kingofamani/CoinSorting/README.md

# 智能自動分幣機（教師研習創客專案）

雷切機構分幣機：TT 馬達帶轉盤，把 1、5、10、50 元硬幣送上斜坡，依直徑落進 4 個抽屜。
目標是加上感測器自動計算總金額，用七段顯示器顯示。

**開新對話先看：** [`分幣機_交接_2026-10-08.md`](分幣機_交接_2026-10-08.md) 和 [`分幣機_專案完整紀錄v2.txt`](分幣機_專案完整紀錄v2.txt)（第五節最新）。

## 資料夾

| 資料夾 | 是什麼 | 狀態 |
|---|---|---|
| [`01_原始機構/`](01_原始機構/) | 原本的純機構分幣機：雷切原始檔、零件編號圖、組裝完成照片 | 基準，**不可修改** |
| [`02_v1_紅外線版/`](02_v1_紅外線版/) | 第一代：4 路反射式紅外線感測。Nano 版與 ESP32 版程式、接線圖、講師前置測試步驟、v1 紀錄 | **已停用**（反射式紅外線不準） |
| [`03_v2_光耦版/`](03_v2_光耦版/) | 第二代：槽型光耦（遮斷式）。v2 雷切產生器 `laser_v2/`、草稿與試切小樣、設計規格、報告；ESP32 正式程式 `coin_sorter_opto_esp32/`、接線圖 `接線圖/`、組裝教學網頁 `組裝教學/index.html` | **目前主線** |
| [`04_光耦測試原型/`](04_光耦測試原型/) | 一段簡單滑坡＋裝一個光耦的位置，驗證「光耦跨裝在滑坡上是否可行」；附 ESP32 測試程式、接線圖 `接線圖/`、講師組裝教學網頁 `組裝教學/index.html` | 等模組買到、實量後再切 |

## 現在要切哪個檔

- **v2 整台**：`03_v2_光耦版/laser_v2/out/sheet_合板_1～3.svg`、`sheet_壓克力_1.svg`（上機用，不含註記）。
- **v2 試切小樣**：`03_v2_光耦版/laser_v2/out/trial_合板_1.svg`。
- **光耦測試原型**：`04_光耦測試原型/光耦測試原型_雷切.svg`。

雷切設定：黑 0.2 mm 線＝切割；紅 0.2 mm 線＝雕刻（紅色圖層設「線／向量雕刻」，不要用填色／掃描）。
`03_v2_光耦版/` 裡的 `分幣機雷切_光耦版_v2_草稿.svg`、`_試切小樣.svg` 含隱藏註記層，是給人看的，不要直接上機。

## 怎麼重新產生

Python 環境在根目錄的 `.venv`（不在 git 裡；已裝 shapely、numpy、scipy、matplotlib、fonttools、svgpathtools）。

```
cd 03_v2_光耦版
../.venv/Scripts/python.exe -B -m laser_v2.build_v2
```

```
.venv/Scripts/python.exe -B 04_光耦測試原型/make_proto.py
```

- v2：光耦模組、TM1637、擴展板實量後只改 `03_v2_光耦版/laser_v2/params.py`，量什麼、改哪個鍵見 `laser_v2/out/report.md` 第四節。
- 測試原型：模組實量後改 `make_proto.py` 開頭的 `MODULE`，見 `04_光耦測試原型/組裝與測試說明.md` 第 2 節。
- 字型：雕刻文字與預覽圖用微軟正黑體（`C:\Windows\Fonts\msjh.ttc`）。
- 各檔用途、結束碼、自我測試：見 `03_v2_光耦版/laser_v2/INTERFACE.md` 與專案紀錄第五節。

## 硬體（v2）

- 主控：ESP32-WROOM-32＋38P 擴展板（黃色跳帽設 3.3V）；顯示：TM1637 四位數七段。
- 感測：槽型 LM393 光耦模組（槽寬 10 mm）×4：S1 在 1 元滑道內，S5／S10／S50 跨在斜坡間隔條。
- 電源：9V 方形電池供電子部分；1 顆 18650 獨立驅動 TT 馬達。
- 計數公式：N1＝C1、N5＝C5−C10、N10＝C10−C50、N50＝C50。
- 程式：`03_v2_光耦版/coin_sorter_opto_esp32/`（接線、燒錄、研習前檢查見同資料夾 README.md；還沒在實機編譯、執行過）。
- 接線圖：`03_v2_光耦版/接線圖/分幣機_v2光耦版_ESP32_接線圖.png`（.svg 由同資料夾 make_wiring.py 產生）。
