kingofamani/CoinSorting/03_v2_光耦版/laser_v2/design/analysis_round1.md

# 分析：chute
## findings
- 【審查結論摘要】我重新跑了 parts.pkl 的零件座標，也重看了正面照和俯視照。座標對位、整機姿態、硬幣流向、隔板身分、#12/#13 的用途這幾條都驗證成立。需要修正的有 7 處：(1) 使用者對「1 元滑道右牆」那題其實已經回答「空間夠，可以放 S1」，原分析誤當成待量測；(2) U69.2–72.1 那片牆是 TT 馬達盒的右壁，不是電池盒；(3) 原文寫「隔板從 #26 頂 V14.1」不對，#26 頂在 V4，V14.1 是隔板頂；(4) 軌道坡度 20° 是在面板平面內量的，換算成實際對水平約 17.2°；(5) #13 上緣的幾何改用實際頂邊重新描述；(6) S1 用槽型模組伸進 1 元滑道的卡幣風險從「可能」升級為「很可能」，並補上兩個替代方案；(7) 『切割補償會讓開口變小』的方向寫反了。另外新增兩項遺漏：#24 斜槽內有一條多餘的切割線；跨軌光束離前一個開口只有約 3mm，違反紀錄 3-2 自己訂的 ≥10mm 原則。
- 【座標系（後面所有數字都用這套，已驗證）】以 #24 的零件局部座標為主。U＝#24 局部 y（0＝右端轉盤側，246＝左端）；V＝#24 局部 x（0＝面板頂，114＝底，沿傾斜面板量）；W'＝深度（#26 背面＝0，#37 內面≈28.8）。換算方式：#26 局部 (x,y)＝(V−4, U−40)；#37 局部 (x,y)＝(114−V, U)，在 SVG 裡是鏡像；隔板 #5/#6/#7 局部 x＝6+W'、y＝V−14.1。隔板頂在 V14.1；#26 頂在 V4（U≤105.7 處），往左逐漸降到 V14（U≥133）。驗證：#26 圓孔中心 (V≈50,U58) 和 #24 軸孔 Ø20 中心 (V50,U58) 重合；三片隔板的小榫與長榫（V84.5–92.5）逐一對上 #26/#24 的槽；後凸榫（V40.1–56.1）對上 #37 的槽（V40.3–56.2）。
- 【整機姿態（已驗證）】#31/#36（92.9×155.3）是左右端板兼腳架，不是斜坡。上段寬 42，有 2 排×5 個槽，接 #24 與 #37；兩排槽中心距 34.7，等於 #26 的 3mm 加滑道深 28.8。兩個腳勾槽的連線和端板軸線夾 29.9°，代表機身上段往後仰 30°，面板與水平夾 60°。
- 【硬幣流向（已驗證）】轉盤把硬幣送進 #24 的長斜槽。槽寬 30.0（垂直量 30.0），在面板內的坡度 20.0°，因機身後仰，實際對水平約 17.2°。斜槽下緣就是軌道，從 (V37.5,U75.7) 到 (V95.1,U234)。硬幣立在 3mm 厚的斜槽裡、靠著 #26 滾。#26 四個開口的下緣都比軌道高 1.31mm；開口頂端（中段）離軌道 20.4／22.3／26.0–26.1／30.0mm，依序是 1／5／10／50 元，對應硬幣直徑 20／22／26／28，餘量 +0.4／+0.3／0／+2.0（開口兩端是圓角，會再小一點）。開口夠高時，硬幣往後翻過 #26，掉進深約 29mm 的滑道，再直接落進下方抽屜。開口 U 範圍：1 元 114.1–134.6、5 元 140.55–164.15、10 元 170.19–196.64、50 元 203.05–234.0。開口左右邊是沿 V 方向，不是垂直軌道。
- 【滑道間隔條＝#5/#6/#7（已驗證）】三片外形 38×84，實體 29（W'）×84（V14.1→V98.1）。#7 是 1|5 間隔條，在 U135.9–138.8；#6 是 5|10，在 U165.7–168.6；#5 是 10|50，在 U198.4–201.3。三片只差在前緣小榫的位置；前長榫 6×8 三片都一樣，都插在 V84.5–92.5。斜底邊 (6,84)→(35,68) 換算到實際空間幾乎水平（33.1mm 只降 0.6mm），也就是滑道出口平面：貼 #26 處 V98.1，貼 #37 處 V82。
- 【滑道寬（U 方向淨寬，已驗證）】1 元 107.8→135.9＝28.1；5 元 138.8→165.7＝26.9；10 元 168.6→198.4＝29.8；50 元 201.3→236.2＝34.9。上段沒有櫃側板，最寬可到 #36 內面 U243（41.7）。
- 【#13/#21 是抽屜櫃左右側板（已驗證）】#21 就是 #13 轉 180°，兩片完全同形，換算 (x,y)→(84.3−x, 52.2−y) 外形與孔都吻合。#13 的 3 個槽（5.9/9.9/9.9，起點間距 15、20）對到 #12 短邊的榫（6/10/10，間距 15、20）。#12（134×61）是抽屜櫃後板，內淨寬 128 剛好等於 107.8→236.2。#12 的 4 個 4.5×14 槽要從 U239 端往右算，中心在 U≈122.7/152.2/183.4/218.0，正好各在一條滑道的中央（滑道中心 121.9/152.3/183.5/218.8）。#13 的鋸齒邊沿 #26 從 V75 一路到 V114，兩個齒在沿邊 9–13 與 16.5–20.5mm 處，對到 #24/#26 的 4mm 小孔（V84–89、V91.5–95.5）。
- 【1 元滑道右牆（修正）】#13 的頂邊從 (V75,W'0) 幾乎垂直面板往後延伸到 W'≈28.3，整條頂邊都在 V≈75。所以 #13 高出出口平面的部分是梯形：貼 #26 處 V75→98（實際高約 20mm），貼 #37 處 V75→82（約 6mm），面積約 400mm²。原分析寫「三角形 350mm²」偏小；拿面積和 552mm² 比也不是正確的判斷方式，真正的限制是在 #13 的 U 位置（104.9–107.8），模組 PCB 擺在 V≥75 會和 #13 本體重疊。V<75 沒有牆。右邊是 U72.1→104.9 的空腔（寬約 32.8、深 28.8、底部是空的），它的左邊界是 TT 馬達盒右壁：馬達盒在 U43.8–72.1，兩片壁以 3 個 9.75×2.9 的榫插進 #26 的 V47–96，裡面是 #26 的馬達方孔。原文寫「電池/開關盒」是錯的。使用者已回答「空間夠，可以放 S1」，和這個空腔寬度吻合，所以不必再請使用者量空腔；要處理的是「沒有牆可以掛」。俯視照是沿滑道方向往下看，#13 看起來像一面整片的牆，其實只是它橫跨整個 W' 深度，和上面的判斷不矛盾。照片也能從空腔看穿到桌面。
- 【10|50 間隔條（#5）可用空間（已驗證）】50 元開口下緣在 V82.4–93.7，開口中點到出口平面的實際落差只有約 8.7mm。#5 在 50 元下緣以下只剩約 228mm² 的三角形。
- 【懸吊直接計數（模組伸進滑道、N=C）不可靠（結論維持）】(1) U 方向：光束只要落在「保證覆蓋區」內就一定擋得到：1 元 [115.9,127.8]、5 元 [143.7,160.8]、10 元 [172.4,194.6]、50 元 [208.2,229.3]。(2) 10mm 槽寬讓光束只能沿 W 方向橫跨 10mm，可是滑道深 29mm，硬幣落下時的 W' 位置不固定。從下緣自由落體粗估，到出口時 W' 約為 1 元 19、5 元 15、10 元 10、50 元 4，但翻轉時的後衝和反彈會讓它散開。(3) 翻倒的硬幣會掃過下緣後方半徑等於 D 的整個區域，翻平後的硬幣在 W' 方向約佔 0–D，比 10mm 槽寬大，所以叉臂只要在硬幣落下的範圍裡就會被砸到。(4) 下緣以下的空間：10 元約 20mm、50 元約 9mm，放不下 PCB。結論：S50、S10 在幾何上不可行，S5 邊緣，S1 見下面另一條。
- 【建議做法＝懸吊分級跨軌（符合使用者「S50 放 10|50 間隔條」）】模組跨在 #24＋#26 上（兩片共 6mm，槽寬 10mm），光束在軌道上方約 3mm，穿過斜槽與 #26 上的小光孔，沿用紀錄第一節的分級相減。S50 在 10|50 立柱：#26 在 U196.64–203.05（寬 6.41），後臂要從 #5 前下角開缺口。S10 在 5|10 立柱（U164.15–170.19，寬 6.04，對應 #6）；S5 在 1|5 立柱（U134.6–140.55，寬 5.95，對應 #7）。立柱處軌道高度：1|5 為 V60.0（隔板 y45.9）、5|10 為 V70.8（y56.7）、10|50 為 V82.6（y68.5）；#24 在軌道下方的餘肉 38／27／15mm，S50 最緊。#24/#26 在 V84.5–92.4 本來就有三片隔板長榫的孔（U135.9/165.7/198.4）。S50 的模組窗一定會壓到這組孔，所以 #5 必改；S5/S10 會不會壓到，要等模組槽深量出來才知道。跨軌時模組本體會切斷軌道，要照紀錄 3-2 做可拆的「軌道鍵」。
- 【跨軌光束和前一個開口的距離（新增）】立柱只有約 6mm 寬，光束中心離前一個開口的終點只有約 3mm，違反紀錄 3-2 的『≥10mm』原則。前一種幣如果在開口尾端才翻、或滾過頭（例如 1 元的開口長 20.5、硬幣 20，幾乎沒有餘量），可能會擋到光束一下，或者誤入下一格，導致 C 值不單調。程式的 C1≥C5≥C10≥C50 檢查要保留，試切時要特別測這一點。
- 【S1 只能放在 1 元滑道（結論維持，數字修正）】轉盤圍邊的卡榫孔都在以 (V50,U58) 為圓心、半徑 51.5 的圓上，最右點在 U109.5，加上板厚約到 U111–112.5；軌道就在圍邊最右點出圍邊（U≈109.5、V≈49.8）。所以到 1 元開口起點 114.1 只剩約 1.6–4.6mm，放不下前臂；轉盤本身（Ø98）也蓋住 U<107 的軌道前方。S1 只能在 1 元滑道內直接偵測 1 元，公式改成：N1=C1、N5=C5−C10、N10=C10−C50、N50=C50，總枚數＝C1+C5。這要改寫紀錄第一節和程式。
- 【S1 用槽型模組的方式與風險（修正，風險升級）】原方案：新增 v2「S1 掛板」，放在 U101.9–104.9，用榫插進 #26 新槽（局部 y61.9–64.9、x58–66，即 V62–70）和 #37 新槽（局部 y101.9–104.9、x44–52）。換算檢查無誤，也避開 #37 在 y104.5、x<32 的缺口、馬達盒（U≤72.1）和馬達方孔。PCB 貼在掛板 +U 面，兩臂朝 +U 伸進滑道，光束目標 U≈116–120、V≈76。#13 在 V≥75 的部分和 PCB 位在同一個 U 範圍，所以 #13 頂部要削低或開缺口。但 1 元硬幣翻倒時佔 U114.1–134.6，兩臂（含臂尖）至少伸到 U≈119–122，會和硬幣的右側 5–8mm 重疊；硬幣翻平後在 W' 方向約佔 0–20，大於 10mm 槽寬，所以很可能先落在臂上再滑下，造成卡幣或重複計數。原分析說「勉強可行」太樂觀，必須先試切。
- 【S1 的較佳替代方案（新增）】(A) v2 不另做掛板，改把右邊那片 #13 往上加高成真正的「1 元滑道右牆」，在 U104.9–107.8 從 V75 往上延伸到約 V45，在 #26/#37 加新槽固定。這樣同時擋住 1 元硬幣反彈飛進右側空腔（空腔底部是空的，硬幣飛進去會掉到桌上）；模組從這面牆開窗伸臂，PCB 掛在空腔側。卡幣風險和原方案一樣，但結構比較簡單，也只多切一片零件。(B) S1 改用分離式紅外對射，發射和接收各一片，平貼裝在 #26 與 #37 的孔裡，光束沿 W' 橫跨整個 29mm，滑道裡沒有任何凸出物。光束放在 U≈121、V≈80 可以保證遮斷：出口平面在 V98.1−0.56·W' ≥ 82，任何從下緣（V≤58）到出口的路徑都一定會穿過 V=80 的整個深度。這需要買不同的模組；如果買有預焊線、附杜邦頭的款式，講師也不必焊接。
- 【干涉檢查（維持）】#37 在 U105–239 只到 V82，下方是 #12（櫃後板）與抽屜。滑道裡的東西只要不低於出口平面（貼 #26 處 V98.1、貼 #37 處 V82）就不會碰到 #12 或抽屜；抽屜往前抽，出口平面以下不能有凸出物。#37 背後是空的，後臂和排線可以從 #37 開孔往後拉。S1 所在的空腔底部是空的。
- 【雷切檔清理（新增）】#24 的斜槽內有一條多餘的切割線，從 (V59.7,U136.6) 到 (V40.6,U172.1)，把廢料切成兩塊，對成品沒影響，但會多花切割時間。v2 可以刪掉，或保留並在註記說明。
- 【研習實務（維持）】感測器、接線、程式都由講師先做好，建議把「模組＋掛板或改過的隔板＋排線」做成講師預組的子組件，老師只要插進槽就好。模組如果有 M3 孔，就用 M3 尼龍螺絲固定。一場 10 套，總共要預組 40 組感測子組件，要把時間算進講師的前置作業。
- 中間檔在 /tmp/claude-0/-home-user-CoinSorting/e4dcfae7-64f2-510b-91ab-d1c0e7dcce93/scratchpad/wf/slide/：parse.py、poly2.py（產生 parts.pkl）、dump.py（列出各零件局部座標）、geo.py（滑道與落幣計算）、p24/p26/p37/p12/p5/p13a/p31a.png（附 mm 格線的零件圖），以及審查時新增的 rev_top_zoom.png（俯視照放大，用來確認右側空腔可以看穿到桌面）。
## measurements
- #24 前面板: 114.0×246.0；斜槽寬 30.0（垂直量）；軌道在面板內坡度 20.0°，實際對水平約 17.2°；軌道 V=(9.35+0.342U)/0.94，從 U75.7 到 U234；軸孔 Ø20 中心 (V50,U58)；斜槽內有一條多餘切線 (V59.7,U136.6)→(V40.6,U172.1)（方法：重跑 parts.pkl 取外框與孔頂點；平行線距離；sin20·sin60 換算實際坡度）
- #26 內牆與對位: 107.0×203.0；#24 座標＝#26 座標+(4,40)；4 個開口 U 114.1–134.6 / 140.55–164.15 / 170.19–196.64 / 203.05–234.0（方法：圓孔與軸孔重合；隔板三種榫與槽逐一對上）
- #26 開口頂端離軌道（垂直軌道量）: 中段 20.4 / 22.3 / 26.0–26.1 / 30.0 mm；下緣都在軌道上方 1.31mm；兩端圓角處較小（方法：開口各頂點代入軌道法向 (0.940,−0.342)，審查時重算）
- #37 後面板: 114.0×246.0；U105–239 只到 V82（局部 x=32）；隔板凸榫槽 15.9×2.9（V40.3–56.2）在 U135.9/165.7/198.4（方法：局部座標換算 (114−V,U)）
- #5/#6/#7 間隔條: 外形 38×84、實體 29×84（V14.1–98.1）；前長榫 6×8 都在 V84.5–92.5；#7＝1|5 U135.9–138.8、#6＝5|10 U165.7–168.6、#5＝10|50 U198.4–201.3（方法：前緣小榫型樣比對 #26 三排槽）
- 滑道淨寬（U）: 1 元 28.1、5 元 26.9、10 元 29.8、50 元 34.9（上段最寬 41.7）（方法：相鄰隔板／櫃側板面距）
- 滑道深（W'）: 28.8–29.0 mm（方法：隔板實體寬，和 #31 兩排槽中心距 34.7 減 #24、#26 互相核對）
- 機身後仰角: 29.9°≈30°（面板與水平夾 60°）（方法：#31 兩個腳勾槽連線 (31.7,147.9)→(86.3,116.5) 和端板軸線的夾角）
- #13/#21 抽屜櫃側板: 84.3×52.2，兩片同形（轉 180°）；右邊那片在 U104.9–107.8、左邊在 U236.2–239.1；鋸齒邊沿 #26 從 V75 到 V114；頂邊在 V≈75，橫跨 W'0–28.3（方法：沿邊投影齒位，對 #24/#26 的 4mm 孔（V84–89、91.5–95.5））
- #12 抽屜櫃後板: 134.0×61.0；4 個槽中心 U≈122.7/152.2/183.4/218.0（從 U239 端往右算），各在一條滑道中央（方法：兩短邊榫對 #13 槽；槽中心和滑道中心比對）
- #13 高出出口平面的部分: 梯形約 400mm²；貼 #26 處實際高約 20mm，貼 #37 處約 6mm；模組 PCB 擺在 V≥75 會和 #13 重疊（方法：頂邊 V75 和出口平面 V98.1−0.56W' 之間的面積）
- 1 元滑道右側空腔: U72.1→104.9（約 32.8）×W' 0→28.8×V 4→底部（底部是空的）；左邊界是 TT 馬達盒右壁（盒在 U43.8–72.1）；使用者已確認「空間夠放 S1」（方法：#26 馬達盒壁槽（U43.8–46.7、69.2–72.1，V47–96）；俯視照透視比例（盒寬 28.3mm 約 144px，空腔約 163px，約 32mm））
- 開口下緣到出口平面的實際落差（W'=0 處）: 1 元 38.4、5 元 29.5、10 元 19.7、50 元 8.7 mm（方法：(98.1−下緣中點 V)×cos30）
- 自由落體到出口時的 W' 粗估: 1 元 19、5 元 15、10 元 10、50 元 4 mm（沒算翻轉後衝與反彈，只能當參考）（方法：從下緣沿實際垂直方向落到出口平面）
- 光束保證被遮的 U 區間（在滑道內偵測時）: 1 元 115.9–127.8、5 元 143.7–160.8、10 元 172.4–194.6、50 元 208.2–229.3（方法：[滑道左牆−D, 右牆+D]）
- 間隔條立柱寬與該處軌道高度: 1|5：5.95mm、V60.0；5|10：6.04mm、V70.8；10|50：6.41mm、V82.6；#24 軌道下方餘肉 38/27/15mm；光束離前一個開口終點約 3mm（方法：開口端點差加軌道方程式）
- 轉盤圍邊和軌道: 圍邊卡榫孔都在以 (V50,U58) 為圓心、半徑 51.5 的圓上，最右點 U109.5（含板厚約 111–112.5）；軌道在 U≈109.5、V≈49.8 出圍邊；到 1 元開口 114.1 只剩約 1.6–4.6mm（方法：#24 七個菱形卡榫孔中心距；軌道方程式）
## risks
- （修正）S1 用 10mm 槽型模組伸進 1 元滑道時，兩臂和翻倒中的 1 元硬幣右側會重疊 5–8mm，而且硬幣翻平後的寬度大於 10mm 槽寬，很可能卡幣或重複計數。原分析說「勉強可行」已改成「高風險，必須試切」，並建議改用『加高 #13 右牆』或『分離式對射平貼裝』。
- （新增）跨軌光束離前一個開口終點只有約 3mm，不符合紀錄 3-2 的 ≥10mm 原則。在開口尾端才翻、或滾過頭的硬幣可能多計或誤入下一格，造成 C 值不單調，試切時要專門測。
- S50 的模組窗一定會壓到 #5 長榫在 #24/#26 的孔（V84.5–92.4），所以 #5 必改。S50 處 #24 在軌道下方只剩約 15mm，模組的排針不能朝下，否則會撞到 50 元抽屜，#24 底緣的餘肉也會變很細。S5/S10 會不會壓到長榫孔，要等模組槽深量出來才知道。
- （修正）原文說『切割補償讓 10 元開口變小』，方向寫反了：雷射的切縫會讓孔略為變大，只有在套用內縮補償、或硬幣靠板角度改變時，10 元的 0 餘量才會出問題。#26 的 4 個開口在 v2 不要動。
- #13 和 #21 是同一個形狀；如果 S1 要改右邊那片（削頂或加高），v2 要拆成兩個不同零件並雕刻標示，否則老師可能裝反。
- 右側空腔底部是空的：1 元硬幣在 V<75 的高度沒有右牆，反彈時可能飛進空腔、掉到桌上。原機也有這個風險，v2 加高 #13 右牆可以順便解決。
- 模組實際尺寸還不知道：哪一邊是 27.6、光束離 PCB 多高、臂寬與臂厚、槽深、固定孔位置，這些都會讓所有開窗座標偏移數 mm。v2 檔必須在量完實品後才定稿。
- 照片是透視拍攝，空腔寬約 32mm 只是估計（±5mm）；不過使用者已確認空間夠，這不是阻斷問題。
## open_questions
- 請確認「懸吊分級」的意思是 (b) 模組掛在立柱／間隔條處跨軌、分級相減（N50=C50、N10=C10−C50、N5=C5−C10），只有 S1 掛在 1 元滑道內直接計數（N1=C1）？從使用者說的『S50 放 10|50 間隔條』看是 (b)；(a) 每格都在滑道內直接計數，S50/S10 在幾何上不可行。
- S1 要選哪一種：(1) 新增掛板＋削低 #13；(2) 把右邊 #13 加高成真正的 1 元右牆，模組掛在牆上；(3) S1 改買分離式紅外對射（最好是有預焊線、附杜邦頭的款），平貼裝在 #26/#37 上，不會卡幣，而且保證遮斷。
- 使用者說『空間夠可以放 S1』，是指 #26 後方、1 元滑道右側那個空腔（約 32mm 寬，底部是空的）嗎？如果方便，拍一張從背面看的 1 元滑道照片，確認 V<75 真的沒有右牆。
- 請量實購模組：槽寬、槽深、光束離槽底與 PCB 的高度、兩臂沿光束方向的厚度、兩臂沿槽長方向的寬（要小於約 6mm 才塞得進立柱）、PCB 長寬與 M3 孔位、排針方向，以及 27.6/20/17 分別對應哪個方向。
- 遮擋時模組輸出 HIGH 還是 LOW（程式的 BLOCKED_LEVEL）。
- 公式改成 N1=C1、N5=C5−C10、N10=C10−C50、N50=C50、總枚數＝C1+C5，防錯檢查改成 C5≥C10≥C50。這要寫回紀錄第一節和程式嗎？
- #13 與 #21 在 v2 可以拆成兩個不同零件嗎（右邊那片改形並雕刻標示）？
# 分析：ramp
## findings
- 已輸出標註尺寸圖：/tmp/claude-0/-home-user-CoinSorting/e4dcfae7-64f2-510b-91ab-d1c0e7dcce93/scratchpad/wf/ramp/ramp_dimensions.png。這是從前方看的組裝正視圖，附量測表。繪圖腳本是 draw.py，幾何計算在 geom.py、geom2.py，都在同一個資料夾。我重跑過腳本，數字一致。圖上數值都正確，但圖說沒有提到開口上方兩角有圓角，而 S1 的距離是後來在審查時才修正的（見下面 S1 那條）。
- 零件對應：SVG 第 1 頁 #24 是 path id rect2（114×246），斜槽是它的第 1 段子路徑；#26 是 path131（107×203），四個開口是第 4、8、10、13 段子路徑。#24（rect2 第 25～27 段）和 #26（path131 第 20～22 段）都有 3 個 7.9×2.9 的插槽，間距都是 29.75 和 32.75。這組間距前後不對稱，所以用它對位時可以排除前後翻面（鏡像）。算出 #26 疊到 #24 上的位移是 (113.21, 4.52)。驗證：50 元孔底端和斜槽平頭的 y 座標都是 380.16。另外，兩片板上兩根外牆的插槽（3.95×2.9）也對得上，誤差 0～1 mm。【修正】原稿說「#26 外框四邊都比 #24 內縮 3 mm」是錯的。實際上 #26 在組裝座標佔 X 3～206、Y 3～110，#24 佔 X 0～246、Y 0～114：左邊和下邊各內縮 3、上邊內縮 4，右邊短了 40 mm（#26 只有 203 長）。
- #24 和 #26 前後是貼在一起的：落幣隔板和兩根外牆的插舌會同時穿過兩片板，正面照片也看得到斜坡下方露出 4 組插舌。所以硬幣是在 #24 斜槽的 3 mm 板厚裡滾，背後靠著 #26。這點原本列在待確認，現在已大致確認。
- 方向：板材圖上的 x 方向就是組裝後的鉛直方向（只轉 90°，沒有鏡像）。組裝座標的換算是 X＝392.16−y、Y＝116.64−x，以 #24 左下角為原點。硬幣從右上方的轉盤落到斜槽右上端，往左下滾。開口由右到左依序是 1、5、10、50 元，和正面照片一致。
- 斜坡：#24 斜槽的下緣就是軌道，傾角 20.00°。斜槽寬度垂直於斜坡量是 30.00 mm（鉛直方向量 31.92）。直線段軌道長 153.0 mm，從 (170.26, 76.50) 到 (19.24, 21.53)。斜槽整體的水平範圍是 X 12.0～180.1，右上端是圓弧，左下端是平頭。
- 四個開口的形狀：左右兩邊鉛直，上下兩邊和斜坡平行；上方兩角是圓角，半徑約 2～3 mm，下方兩角幾乎是直角。下表格式為「水平寬／沿坡長／垂直於坡的高度／鉛直高」，單位 mm：1 元＝20.50／21.82／19.12／20.34；5 元＝23.60／25.12／20.95／22.30；10 元＝26.45／28.15／24.81／26.40；50 元＝30.96／32.94／28.66／30.49。【修正說明】舊紀錄的「垂直邊長 17.6／20.0／23.7／27.5」是鉛直邊去掉圓角後的直線段長度（實測 17.35／20.1／23.75／27.56），不是從外框推算的；要表示開口的完整高度，請用上面的數字。
- 每個開口的上下緣離軌道多高（垂直於斜坡量）：四個開口的底緣都在軌道上方 1.31～1.33 mm。頂緣（平直段）分別是 1 元 20.43、5 元 22.28、10 元 26.14、50 元 29.98，其中 50 元孔的頂緣大致和斜槽上緣（30.00）一樣高。頂緣扣掉兩端圓角後的平直段，沿坡長度大約是 1 元 15.7 mm。20 mm 硬幣在離軌 17.6 mm 以上的部分寬約 13 mm，放得進這段平直段，所以圓角不影響分級。
- 間隔條寬度（水平寬／沿坡寬，單位 mm）：1|5＝5.95／6.33，5|10＝6.03／6.42，10|50＝6.41／6.82。每條間隔條正後方都有一片 3 mm 落幣隔板，插槽的水平座標分別是：1|5 在 X 107.18～110.08（間隔條在 105.45～111.40），5|10 在 77.43～80.33（間隔條在 75.81～81.84），10|50 在 44.68～47.58（間隔條在 42.95～49.36）。插槽中心和間隔條中心相差不到 0.2 mm。隔板的插舌是從軌道下方（Y 約 21.6～29.5）穿過 #24 和 #26，不會穿過間隔條本身。
- 分級原理（從幾何反推）：每個開口的頂緣只比該幣直徑高一點（1 元 +0.43、5 元 +0.28、10 元 +0.14、50 元 +1.98 mm）。所以硬幣滾到自己的開口時，頂端失去靠背，就以 1.3 mm 高的下緣為支點往後倒進去。比較大的下一枚硬幣會被開口上方的橫條擋住，繼續往下滾，擋住的量是：5 元在 1 元孔 +1.57、10 元在 5 元孔 +3.72、50 元在 10 元孔 +1.86 mm。硬幣靠在 #26 上的傾角大約只有 2°，對接觸高度的影響小於 0.02 mm，可以忽略。
- 每個開口在斜坡上的位置（從斜槽最右端 X＝180.1 起算，水平距離除以 cos20° 換算成沿坡距離，單位 mm）：1 元 51.3～73.1、5 元 79.5～104.6、10 元 111.0～139.2、50 元 146.0～178.9。50 元孔的左邊緣就是斜槽的左端（X＝12.0）。注意斜槽右端是圓弧，這只是近似值。
- S1（1 元滑道右牆）的設計檔推估【已修正】：#24 的 rect2 第 13、15 段和 #26 的 path131 第 19、26 段，是兩個 3.95×2.9 的插槽，換算到組裝座標在 X 138.15～141.10、Y 18.5～30.0。正面照片中 1 元孔右方也看得到這兩個插舌，所以判斷它是 1 元滑道右牆，左邊 X 6.9～9.9 對應的就是 50 元滑道左牆。依此推算：1 元孔右緣在 X 131.9，右牆內面約在 X 138.1，水平距離約 6.2 mm。原稿寫的「右牆在 X 141.1～144.0、距離 9.2 mm」是換算方向弄反了。1 元滑道寬約 28.1 mm（X 110.1～138.15）。右牆外側（X 141 往右）從俯視照估計，到馬達／開關小盒大約還有 14～19 mm 的空間，這是照片透視下的估計，要實量。Ø98 轉盤的軸孔中心在 (188.0, 64.0)，轉盤左緣約在 X 139，剛好在右牆附近，所以右牆正前方上半部會被轉盤蓋住。
## measurements
- 斜坡角度（#24 斜槽下緣）: 20.00°（方法：用 svgpathtools 解析 rect2 第 1 段子路徑，取直線段 (40.14,221.9)→(92.47,365.67) 算 atan，我已重跑確認）
- 斜槽寬度: 垂直於斜坡 30.00 mm、鉛直 31.92 mm；直線段軌道長 153.0 mm（方法：斜槽上下兩緣是平行線，計算兩線之間的距離）
- 1 元孔: 水平寬 20.50、沿坡長 21.82、垂直於坡的高度 19.12、鉛直高 20.34、底緣離軌 1.31、頂緣離軌 20.43（比幣徑多 +0.43）；上方兩角為圓角，半徑約 2.8 mm（方法：#26 開口依插槽對位到 #24 座標後，把每段的端點投影到軌道的法線方向和切線方向）
- 5 元孔: 水平寬 23.60、沿坡長 25.12、垂直於坡的高度 20.95、鉛直高 22.30、底緣離軌 1.33、頂緣離軌 22.28（比幣徑多 +0.28）（方法：同上）
- 10 元孔: 水平寬 26.45、沿坡長 28.15、垂直於坡的高度 24.81、鉛直高 26.40、底緣離軌 1.33、頂緣離軌 26.14（比幣徑多 +0.14）（方法：同上）
- 50 元孔: 水平寬 30.96、沿坡長 32.94、垂直於坡的高度 28.66、鉛直高 30.49、底緣離軌 1.33、頂緣離軌 29.98（比幣徑多 +1.98）（方法：同上）
- 間隔條 1|5: 水平 5.95 mm／沿坡 6.33 mm；背後隔板插槽在 X 107.18～110.08（方法：相鄰兩開口鉛直邊的 X 座標差，除以 cos20° 得沿坡寬；插槽座標取自 rect2 第 27 段）
- 間隔條 5|10: 水平 6.03 mm／沿坡 6.42 mm；背後隔板插槽在 X 77.43～80.33（方法：同上，插槽座標取自 rect2 第 26 段）
- 間隔條 10|50（S50 要放的位置）: 水平 6.41 mm／沿坡 6.82 mm；背後隔板插槽在 X 44.68～47.58（隔板中心和間隔條中心相差小於 0.05 mm）（方法：同上，插槽座標取自 rect2 第 25 段）
- 較大硬幣被上一個孔的橫條擋住的量: 5 元在 1 元孔 +1.57、10 元在 5 元孔 +3.72、50 元在 10 元孔 +1.86 mm（方法：幣徑減去開口頂緣離軌高度）
- 1 元孔右緣到 1 元滑道右牆內面: 約 6.2 mm（水平，X 131.9 → 138.15）；右牆插槽在 X 138.15～141.10、Y 18.5～30.0【已更正原稿的 9.2 mm】（方法：rect2 第 13、15 段和 path131 第 19、26 段兩片板上對得上的 3.95×2.9 插槽，換算成組裝座標；正面照片看得到 1 元孔右方的插舌，判斷是右牆。屬推估，要請使用者實量）
- 右牆外側到馬達／開關小盒的空間: 約 14～19 mm（照片估計）（方法：俯視照用 #24 全長 246 mm 當比例尺（約 5.2 px/mm），有透視誤差）
- #26 與 #24 對位: 位移 (113.21, 4.52) mm；#26 在組裝座標佔 X 3～206、Y 3～110（#24 佔 X 0～246、Y 0～114）（方法：兩片板上 3 個 7.9×2.9 插槽的間距 29.75／32.75 前後不對稱，可排除鏡像；50 元孔底端和斜槽平頭的 y 都是 380.16；外牆插槽也對得上（誤差 ≤1 mm））
## risks
- 【審查修正】原稿有三處錯誤，已改：(1)「#26 外框四邊都比 #24 內縮 3 mm」是錯的，實際只有左邊和下邊各內縮 3 mm，上邊 4 mm，右邊短 40 mm；位移本身靠插槽間距和 380.16 對齊仍可成立。(2) S1 右牆位置算錯，應在 X 138.15～141.10，1 元孔右緣到右牆是約 6.2 mm，不是 9.2 mm。(3) 舊紀錄的鉛直邊長數字是去掉圓角後的直線段長度，原稿說成「從外框推算」也不對。
- 1、5、10 元孔的落入餘量只有 +0.43、+0.28、+0.14 mm。這跟雷切 kerf（約 0.1～0.2 mm，會讓開口變大、軌道邊被吃掉）、合板實際厚度、整機後傾角度都是同一量級。重切 v2 時，開口、軌道和斜槽的位置和大小都不要動，也不要改切割補償。換雷切機或換板材時，10 元孔最容易出問題：10 元掉不下去，就會跟著跑到 50 元格。
- S50 要放的 10|50 間隔條只有 6.41 mm 寬（沿坡 6.82），正後方緊貼著一片 3 mm 落幣隔板（中心對齊）。現成模組本體約 27.6×20 mm，不可能放進間隔條，只能讓光束或槽口對準間隔條附近，模組本體放在斜槽下方或前方。開窗或開槽不能切斷間隔條或隔板插槽（隔板插舌在 Y 21.6～29.5、軌道下方），也不能和隔板本身互相干涉，不然 10/50 分級和落幣通道都會被破壞。
- 如果在 #26 開口附近或軌道上挖感測器窗，會改變頂緣離軌的有效高度，或打斷軌道（#24 斜槽下緣）的連續性，可能讓分級失效。開孔請避開開口的頂緣橫條和軌道下緣。
- S1：1 元孔右緣到右牆內面只有約 6.2 mm。右牆正前方的上半部被 Ø98 轉盤（左緣約 X 139）蓋住，右牆外側到小盒也只有大約 14～19 mm（照片估計）。在右牆上放 S1 空間很緊，要請使用者實量。
- 硬幣直徑用現行流通硬幣的 20、22、26、28 mm 計算，沒有實際量過硬幣。磨損或舊版硬幣差個 0.1～0.2 mm，就可能影響 10 元能不能掉下去。
- 組裝座標是靠插槽對位推算的，前提是 #24 和 #26 前後貼緊、插槽同高（插舌同時穿過兩片板，可以支持這個前提）。如果實機組裝有間隙，或插槽餘隙造成高低差，軌道到開口頂緣的距離會改變。
## open_questions
- 請實量 1 元滑道右牆：1 元孔右緣到右牆內面的水平距離（設計檔推估約 6.2 mm）、右牆的高度和板厚、右牆外側到馬達／開關小盒的距離（照片估計約 14～19 mm），以及轉盤圍邊下方還剩多少淨空。這些用來判斷 S1 放不放得下。
- 買到的 LM393 槽型模組請量：實際槽寬、槽深、光束離槽底多高、本體沿軌道方向的寬度、固定孔的位置和孔徑。這些決定 S50 在 6.41 mm 寬的間隔條（背後還有隔板）旁邊要怎麼固定。
- 實機目前 4 種硬幣分級正不正常？特別是 10 元（餘量只有 0.14 mm），有沒有偶爾掉不下去、跑到 50 元格？
- 整機實際往後傾多少度？硬幣有沒有確實靠在 #26 上滾？（傾角影響很小，但如果硬幣不靠牆，分級原理就不成立。）
- 「懸吊分級」方案裡，S1 和 S50 要偵測的是硬幣在軌道上滾過去，還是落入滑道的過程？這會影響光束應該在軌道附近，還是在滑道內的哪個高度。
# 分析：sheet
## findings
- 結論維持：原始檔第 1、2 頁（合板）都裝不進建議的 255×355。我重新量過：第 1 頁零件實際範圍 x 2.6～291.4、y 3.8～393.7，也就是 288.8×389.9 mm；第 2 頁 x 3.1～294.8、y 2.6～392.2，也就是 291.7×389.6 mm。長、寬兩個方向都超出。（修正一）原本用「外接框面積和大於 90,525」來證明放不下，這個推論不成立，因為零件本來就會互相嵌套。正確的說法是：第 1 頁零件淨面積 77,213 mm²，第 2 頁 74,709 mm²，各占一張 255×355 的 85% 和 83%。不規則零件很難排到這麼滿，所以實務上每頁都需要重排、拆開來放。
- 沒有任何單一零件超過 255×355，不轉向也放得下。最大的幾件：#24 前面板 114.0×246.0；#37 後面板 114.0×246.0（#40、#44 放在它外接框左下的凹處，合起來約 114.2×246）；#26 內牆 107.0×203.0；#27 彎曲條 18.0×186.8；#12 134×61；#13、#21 各 84.3×52.2；#5～#7 各 38×84。（修正二）#31 和 #36 是同一個外形，都是 92.9×155.3、淨面積 7,326 mm²。原本寫的「#31 約 97.6×155.3（內嵌 #32）」把 #32 也算進外接框了。#32 是獨立零件（36×42），它不在 #31 的輪廓裡，只是和 #31 的外接框重疊。#38（38×62）位在 #36 的外接框內，同樣是獨立零件。#31、#36、#32、#38 四件照原樣咬合排列時，整組外框是 149×201.5。
- 原有合板零件（不含 v2 新增）重排到 255×355，要 3 張。我自己重新跑了 MaxRects 矩形排版（可轉 90°）：零件間距 2.5 mm、四周留 5 mm 邊時，三張用量約 98%／95%／36%；間距 2 mm、不留邊時約 97%／90%／25%；#31、#36 分開排時約 97%／93%／43%。都是 3 張。只用 2 張不實際：淨面積合計 151,922 mm²，相當於兩張整板（181,050 mm²）的 84%，若四周留 5 mm 邊更是 90%。
- 壓克力要另外切，不能和合板混排。第 3 頁只有 #62 轉盤（97.9×97.9）和 #63 前蓋半環（107.9×68.2），整組範圍約 220.4×98.0 mm。一張 255×355 壓克力用矩形排法可以排 3 套：#62 直排 3 片，旁邊 #63 直排 3 到 4 片，總寬約 208.5 mm。10 套需要 4 張。如果依外形嵌套（半環和十字轉盤的凹口），可能排得下 4 套，要在 Inkscape 實際排排看。
- v2 新增零件的估算還沒經過驗證，而且可能沿用了舊方案。「軌道鍵」（3-2a）是舊方案的零件：感測器裝在 #24 斜槽、軌道要做成可拆。使用者已改用「懸吊分級」：S50 放在 10 元和 50 元之間的間隔條，S1 放在 1 元滑道右牆。新方案很可能不需要軌道鍵，但需要新的吊架或夾片，數量和外形都還沒設計。「8 片 30×25 夾片＋4 個 25×12 軌道鍵，約 7,500 mm²」只能當成占位用的面積。
- 電子盒的估算（內尺寸約 100×85×40、3 mm 合板 6 片、外接框約 37,400 mm²，上蓋改壓克力時合板約 27,800 mm²）在算術上沒問題，但只是假設。擴展板 53.5×78 平放；9V 電池（48.5×26.5×17.5）必須「側躺」，也就是高 26.5、占地 48.5×17.5，才放得進 40 mm 高。電池如果直立（高 48.5 mm）就超過盒高。此外電池扣會再多出約 10 mm 長度。
- 原有零件加上 v2 新增（感測器夾片、軌道鍵、整個合板電子盒）一起排版，還是 3 張 255×355。我重算的用量是 98%／97%／90%，上蓋改壓克力時是 98%／97%／78%，和原分析的 98／96／92、98／96／80 差不多。第 3 張已經接近滿版。只要零件加大（例如 #24、#26 開窗或加長、吊架增加、電子盒加大），就可能要第 4 張。
- 建議頁數維持：合板 3 張 255×355，另外預留第 4 張當試切小樣和備案；壓克力每 3 套用 1 張（10 套 4 張），或一套一張（10 張）。
- 合板第 1 張（大面板）手排可行：#24 和 #37 直立並排，佔 114＋2.5＋114.3＝230.8 mm 寬、246 mm 高。（修正三）右側剩下的窄條算法：可用寬 245 − 230.8 − 間距 2.5 ≈ 11.7 mm，不是原本寫的 10 mm。這寬度剛好放得下 #9～#11、#15、#19、#25 這 6 片 11×19.8 卡扣，和 #16、#17、#20、#23 這 4 片 7×9 小鍵，但只剩約 0.7 mm 餘裕。下方剩約 245×96.5，可放電子盒上蓋和底板（106×91 兩片並排，寬 214.5）。
- （修正四）原本列的合板第 2 張清單太滿，要調整。清單是：#31／#36／#32／#38 整組 149×201.5、#26 107×203、#12 134×61、#27 18×187、#5～#7 三片 38×84、#33～#35。我跑矩形排版，一張只放得下其中 9 件，用量約 92%，#35（29.1×42）排不進去，差約 1 mm。建議把 #33～#35 移到第 3 張，或改間距 2 mm 後在 Inkscape 手排確認。
- 合板第 3 張（抽屜、小盒、v2 新增）：抽屜零件 #39、#41～#43、#45～#51、#60、#61（62×29.1～38）；#40、#44 如果不放在 #37 旁邊的凹處，也放這張。另外還有小盒 #1～#4、#8；#13、#21（84.3×52.2）；Ø19 軸套圓片 #14、#18、#22、#58、#59；12.5×12.5 卡扣 #52～#57；電子盒前、後、側板；v2 的感測器吊架或夾片；以及從第 2 張移過來的 #33～#35。用量約 90%。
- 壓克力 1 張：#62＋#63。若電子盒上蓋改壓克力（106×91），單套排法放得下，但 3 套一張的排法就放不下上蓋，上蓋要另外排。
- （修正五）註記文字的樣式要改正。「300X400」共 4 個（text173、176、178、180），外層 text 的樣式是 stroke:#ff0000（紅色，等同雕刻色）、fill:none，不是原本寫的 #000000。只有「壓克力」（text4-3）的外層是 stroke:#000000（黑色，等同切割色）。兩者的 tspan 都把樣式改寫成 fill:#008000、stroke:none，所以 Inkscape 顯示為綠色、不切。但如果雷切軟體不認 tspan 的覆寫樣式，可能會把「300X400」雕刻上去、把「壓克力」切下去。v2 新檔應刪除這些註記，或移到不輸出的註記圖層。
- （新增）原始檔有看不見的雜線：path9（第 1 頁約 x 133.6～165.6、y 3.4～41.4）和 path174（第 2 頁約 3×2 mm），樣式都是 stroke:none、fill:none。原分析量第 1 頁 y 起點是 3.8，代表有排除 path9，但沒有點出來。重排前應刪掉這兩條線，以免排版或雷切軟體誤判範圍。
- 原始檔第 4 頁除了「300X400」註記外是空的；第 3 頁只有 #62、#63 兩個壓克力零件和「壓克力」字樣。合板頁共 58 件外輪廓（第 1 頁 27 件、第 2 頁 31 件），加上壓克力 2 件共 60 件，和紀錄寫的「約 60 個零件」一致。零件編號跳過 #28～#30。
## measurements
- 第1頁（合板）實際外接範圍: x 2.6～291.4、y 3.8～393.7 → 288.8×389.9 mm（超出 255×355）（方法：自寫解析：svgpathtools 取樣並套用完整 transform 鏈，依 inkscape:page 的 x 位移（0／336.45／670.53／1003.45）分頁；只取黑色切割線的最外輪廓，排除 text 與 stroke:none 的雜線）
- 第2頁（合板）實際外接範圍: x 3.1～294.8、y 2.6～392.2 → 291.7×389.6 mm（超出 255×355）（方法：同上）
- 第3頁（壓克力）實際外接範圍: x 11.8～232.3、y 22.0～120.0 → 220.4×98.0 mm（方法：同上；#62 path257 97.9×97.9，#63 path2 107.9×68.2）
- 第1頁外接框面積和／淨面積: 27 件；91,930 mm²／77,213 mm²（淨面積為一張 255×355 的 85%）（方法：shapely：用輪廓包含關係找出最外輪廓，計算外接框與輪廓面積）
- 第2頁外接框面積和／淨面積（修正）: 31 件；98,480 mm²（含 #32、#38、#40、#44）／74,709 mm²（83%）（方法：同上；原分析的 91,750 是把重疊零件併掉後的數字）
- 255×355 單張面積: 90,525 mm²；四周留 5 mm 邊時可用 245×345＝84,525 mm²（方法：計算）
- #24 前面板／#37 後面板: 114.0×246.0（淨 24,466）／114.0×246.0（淨 22,034；連同 #40、#44 約 114.2×246）（方法：最外輪廓外接框）
- #26 內牆: 107.0×203.0 mm，淨面積 18,618 mm²（方法：最外輪廓外接框）
- #31、#36 斜坡側板（修正）: 兩片相同，各 92.9×155.3 mm、淨面積 7,326 mm²；#31／#36／#32／#38 咬合整組外框 149×201.5 mm（方法：最外輪廓外接框（path106、path44））
- #32～#35 抽屜面板: 36.0／32.4／29.6／29.1 × 42.0 mm（方法：最外輪廓外接框）
  - （2026-10-12 更正）#32～#35 是抽屜**底板**（前端雕幣值的小牌穿出前板），不是面板；寬度依編號是 #32 36.0、#33 32.4、#34 29.1（1 元）、#35 29.6（5 元）。
- #27 彎曲條、#12 抽屜櫃面板: 18.0×186.8 mm；134.0×61.0 mm（方法：最外輪廓外接框）
- 原有合板零件重排 255×355 所需張數: 3 張（間距 2.5、邊距 5：98%／95%／36%；間距 2、邊距 0：97%／90%／25%）（方法：MaxRects BSSF，可轉 90°，以 #31～#38 咬合整組、#37 含 #40／#44 為單位重跑）
- 原有＋v2（夾片＋軌道鍵＋合板電子盒）: 3 張：98%／97%／90%；上蓋改壓克力時 98%／97%／78%（方法：同上，間距 2.5 mm、邊距 5 mm）
- 第 1 張手排（#24＋#37 並排）的右側窄條: 約 11.7 mm 寬（原寫 10 mm）（方法：245 − (114 + 2.5 + 114.3) − 2.5）
- 第 2 張原清單試排: 只放得下 9 件，用量約 92%；#35 排不進（差約 1 mm）（方法：MaxRects，間距 2.5 mm、可用 245×345）
- 壓克力每張可排套數: 矩形排法 3 套／張（10 套需 4 張）（方法：#62 直排 3 片＋#63 直排，總寬 208.5 ≤ 245）
## risks
- 修正紀錄（1）：「外接框面積和大於單張，所以放不下」的推論刪除，改用實際範圍超出和淨面積比例（85%、83%）說明。
- 修正紀錄（2）：#31 改成 92.9×155.3（和 #36 同形）；#32 不在 #31 的輪廓內，只是外接框重疊。
- 修正紀錄（3）：第 2 頁外接框面積和改成 98,480 mm²，淨面積 74,709 mm²。
- 修正紀錄（4）：第 1 張右側窄條寬度改成約 11.7 mm；第 2 張清單排不滿，#33～#35 改放第 3 張。
- 修正紀錄（5）：「300X400」外層樣式是紅色 #ff0000，不是黑色；只有「壓克力」外層是黑色。
- 修正紀錄（6）：補上原檔有 stroke:none 的雜線 path9、path174。
- 「懸吊分級」改變了感測器安裝方式。原分析的 v2 零件（4 個軌道鍵、8 片夾片）是照舊的 #24 斜槽方案估的，可能多算了軌道鍵，也漏算了吊架。第 3 張只剩約 10% 空間，吊架如果較大就需要第 4 張。
- 排版都是用外接矩形算的，原檔利用凹處嵌套的效果只保留了一部分。第 1、2 張用量 95～98%，手排時邊距或間距可能被壓到小於 5 mm 或 2.5 mm，需要在 Inkscape 實際排排看。
- 電子盒尺寸是假設值：9V 電池必須側躺（高 26.5 mm），盒內高 40 mm 才放得下；擴展板的固定孔、插上杜邦頭後的總高度、開關和 TM1637 的開孔都還沒量，盒子面積可能有 ±30% 誤差。
- 光耦模組的外形只參考同類規格（27.6×20×17 mm、10 mm 槽）；實際的槽寬、孔位、遮擋時輸出高或低，都要等買到後實測。
- 研習 10 套需要合板 30 張 255×355（含試切和備品，建議 32～34 張）、壓克力 4～10 張。每套 NT$500～1000 的預算要另外核算板材和雷切時間。照片看起來材料可能是 MDF，紀錄則寫椴木合板，彎曲條 #27 的彎曲效果會因材料不同而不同。
- 改用 255×355 重排，等於要改掉紀錄 3-5「頁面維持 300×400」的規範，紀錄要同步更新。
- 雷切軟體如果不認 tspan 的覆寫樣式，註記文字可能被誤雕或誤切。v2 要刪除註記，或把文字轉成路徑後放到不輸出的圖層。
## open_questions
- 懸吊分級的吊架或夾片外形和數量要確認：S50 在 10 元和 50 元之間的間隔條上，要改哪一片零件（#5～#7 其中之一，還是要新增）？是否還需要舊方案的軌道鍵？
- S1 能否放在 1 元滑道右牆，要等使用者量出空間；如果改放別處，可能多出支架零件。
- 電子盒要做成完整的六面盒，還是開放式托盤（掛在 #37 後面）？上蓋要不要用壓克力？這會直接影響第 3 張是否放得下。
- 擴展板裝上 ESP32 和杜邦頭後總高多少、固定孔在哪？開關型號和開孔尺寸？TM1637 模組的實際外形和孔位？
- 壓克力要每套一張（共 10 張），還是 3 套共用一張（共 4 張）？研習時零件要怎麼分包？
- 雷切機的 255×355 是否已經扣掉邊界？我估算時四周又各留了 5 mm（可用 245×345）；如果不必再留邊，第 2 張比較好排。
- 研習用的 3 mm 板是椴木合板還是 MDF？會影響彎曲條 #27 和卡榫的公差。
# 分析：bom
## findings
- 【範圍提醒】使用者這一輪只要「v2 雷切檔」。下面的 BOM、估價、電氣對策、程式修改清單和研習流程都只是採購與規劃參考，不在這一輪的交付範圍內；尤其程式修改清單現在不要動手（規則也禁止改 repo）。
- 【結論】每套估價約 NT$770～1,460，常見組合（雜牌 18650、合板 3 片）約 NT$950～1,000，剛好壓在預算上限。紀錄沒有 ESP32、擴展板、TT 馬達、板材的價格，數字都是估計，要等學校報價。要穩穩低於 NT$1,000 有兩個做法：(a) 馬達改用紀錄的 M2：3 顆三號電池，紀錄估每套約 NT$45～60，電池盒最好附開關。這樣省掉 18650、電池盒、開關和共用充電器，每套約省 NT$60～230，也不必讓老師處理鋰電池；代價是轉速略快、電池要換。(b) 板材買大張自己裁成 30×40，但要有裁板工具，對講師不一定實際。
- 【每套 BOM 與估價】標示：[紀錄]＝紀錄內有店家價格；[紀錄估]＝紀錄內原本就標為估計；[估]＝本次估計。
1. ESP32-WROOM-32 38P 開發板（CP2102）[估] 150～250。38P 開發板有寬版和窄版，排針列距不同，要確認能插進 53.5×78 擴展板。
2. ESP32 38P 擴展板（DC 座，53.5×78）[估] 60～100
3. 槽型 LM393 光耦模組 ×4 [紀錄] 台灣物聯 NT$40/個＝160（紀錄寫的是 10 mm 槽寬 H2010；使用者給的商品連結還沒確認是不是同一款、槽寬是不是 10 mm；未寫是否含稅，未稅的話含稅約 168）。10 套建議多買 4～8 個備品。
4. TM1637 四位數顯示器 [紀錄估] 約 65（市價可能 40～70）
5. 9V 鹼性電池 [紀錄估] 30～60
6. 9V 電池扣轉 DC 插頭 [紀錄估] 15～30
7. 母對母杜邦線約 16 條（4 個模組×3＋TM1637×4），再加備用約 20 條。長度看電子盒位置，暫定 20～30 cm [估] 30～50
8. 馬達開關 [紀錄估] 約 15（買附開關的電池盒就可以省掉；原機照片左側的黑色電池盒已附開關）
9. 1 節 18650 電池盒 [紀錄] 台灣物聯 20 未稅，含稅約 21（是否附開關、導線待確認）
10. 18650 電池 ×1：[紀錄] Panasonic NCR18650GA 200 未稅；[紀錄估] 雜牌每顆 60～120
11. TT 減速馬達（一定要買已焊好導線的款）[估] 30～60
12. 3 mm 椴木合板 300×400 ×3 片 [估] 每片 35～60，合計 105～180。原始檔第 1、2 頁零件的排版範圍各約 289×390、292×390，都超過 255×355，所以 v2 必須重新排版。合板零件淨面積約 15.2 萬 mm²，外接矩形合計約 19 萬 mm²；每片 255×355 的可切面積是 90,525 mm²，理論下限 2 片，實際排版要 3 片，加上電子盒等 v2 新增零件可能要 4 片。
13. 3 mm 透明壓克力：只有 #62 Ø98 和 #63 108×68 兩件。在 255×355 內用 2×2 圓盤加 2×2 前蓋排，一片約可排 4 套（範圍約 216×341），10 套要 3 片 [估] 每套 30～60
14. 光耦固定件：懸吊分級改成把模組固定在間隔條或滑道牆上，螺絲數要看實品孔位（紀錄寫孔距 15、孔徑 3，未實測）；擴展板 4 組銅柱 [估] 20～40
15. 馬達免焊接頭（2P 快速接頭或接線端子）[估] 5～15
共用分攤：18650 充電器 [紀錄估] 每台 100～250，約 5～6 套共用 1 台，每套約 20～50；白膠或熱熔膠 [估] 每套 10～20；USB 傳輸線講師自備，不列入。
合計：最低約 770（不含共用）；中間約 980（含共用）；最高約 1,460（全用 Panasonic 18650、合板 4 片、零件取高價）。
- 【電氣：OUT 腳的 5V 風險】這類模組的典型電路：LM393 開集極輸出，上拉約 10 kΩ 到模組自己的 VCC，再並一顆指示 LED。實品電路還沒驗證。VCC 接 5V 排針時，未觸發那一態 OUT 約 5V，超過 ESP32 GPIO 上限（VDD＋0.3 ≈ 3.6V）。電流會經內部保護二極體灌進 3.3V，約 0.1 mA 等級，短期看起來能用，但已超出規格，長期可能壞腳或讀值異常。ESP32 內建上拉約 45 kΩ 到 3.3V，擋不住模組的 5V 上拉，所以 INPUT_PULLUP 解決不了。
- 【免焊對策，依優先順序】
A（先試）：模組 VCC 插擴展板的 V 排針。黃色跳帽規定設 3.3V，OUT 最高只有 3.3V，完全安全，接法也和 TM1637 一致。代價是低於標稱的 3.6V 下限：LM393 本身 2V 就能動作，但紅外 LED 電流大約只剩 5V 時的一半，10 mm 槽寬下光量夠不夠要實測。
B（A 不穩時）：VCC 改接 5V 排針，OUT 和 GPIO 之間加 4 路 BSS138 電平轉換模組，必須買排針已焊好的款，約 NT$20～40，全部用杜邦線接。
C（備案）：迷你麵包板上，每路在 GPIO 對地加 15 kΩ，和模組上拉分壓，理論約 3.0V；指示 LED 也會並聯上拉，實際可能約 3.1～3.2V，一定要先量。程式改成 INPUT。缺點是接點多、容易鬆脫。
D：如果實測 OUT 沒有上拉（純開集極），就可以 5V 供電，再用 INPUT_PULLUP 拉到 3.3V，這樣是安全的。
不建議：只串一顆電阻，或直接接 5V 不處理。
- 【供電與續航，皆為估計】A 方案：ESP32 約 60～80 mA，TM1637 約 20～40 mA，4 個模組約 40～80 mA，合計約 0.15～0.2 A，經線性穩壓後 9V 端電流也差不多。鹼性 9V 約可撐 1.5～2 小時（紀錄估 1～2 小時）。改 5V 供電時每個模組約 33 mA，時間會更短。8 小時研習要規定不測試就拔 DC 插頭，每套備 1 顆 9V。馬達獨立供電、不共地，維持紀錄原設計。
- 【講師前置要測的項目】
1. 量實品尺寸（給 v2 SVG 用）：槽寬、槽深、光束離槽底高度、臂高、本體長、電路板長寬、固定孔距與孔徑、排針方向；另外量 1 元滑道右牆的可用空間，確認 S1 放得下。
2. 不通電時，用三用電表量 OUT 到 VCC 的電阻：約 10 kΩ 表示有上拉，接近無限大表示開集極。
3. 接 3.3V（V 排針）：量未遮、遮擋時 OUT 的電壓和指示燈；用最薄的 5 元（約 1.49 mm）和最小的 1 元慢推過光束，要穩定觸發不閃爍；空槽靜置 10 分鐘不可誤觸發；窗邊陽光和日光燈下各測一次。全部 40 個（含備品）都要測。
4. 9V 供電時量 5V 排針和 V 排針的電壓，確認 V 排針是 3.3V。
5. 改走 5V 方案時：先確認 OUT 的高電位經對策後 ≤3.3V，才能接 GPIO。
6. 確認 BLOCKED_LEVEL（遮擋時 HIGH 或 LOW），以實測為準。
7. 用 tuner 量脈衝寬度和最短間隔，決定 DEBOUNCE。
8. 三用電表串在 9V 上量總電流，推算續航。
9. 每套整機燒機：每種硬幣各 20 枚，再混合 50 枚；要符合 C1≥C5≥C10≥C50，且總金額正確。
10. 杜邦接頭點熱熔膠或貼標籤，排線依 S1/S5/S10/S50 貼色標。
- 【程式現況的 bug，已驗證】esp32/coin_sorter_esp32/coin_sorter_esp32.ino 第 134 行是 `lastPrint = millis();m`，多了一個 m，會編譯失敗。工作區和 HEAD 都一樣；紀錄 v2.txt 第 907 行的版本沒有這個 m。
- 【光耦版程式要改的地方（參考，不在本輪範圍）】紀錄 3-4 寫明另開 esp32/coin_sorter_opto_esp32/。
(1) 第 2～13 行說明改成光耦接線 S1→G27、S5→G26、S10→G25、S50→G33，VCC 接 V 排針。
(2) 第 16 行註解改成 S1～S50。
(3) 第 22 行 BLOCKED_LEVEL 依實測設定。
(4) 第 23 行 DEBOUNCE_MS 50 是從前緣開始計時。兩枚硬幣緊貼著滾時，前緣間隔＝直徑÷速度；1 元在假設速度 0.5 m/s 下是 40 ms，會漏算。建議改成「先連續未遮 3～5 ms 才重新上膛」，或降到紀錄預設的 30 ms，由 tuner 實測決定。
(5) 第 90～94 行 getTotal() 改成 C1＋4×C5＋5×C10＋40×C50，並算出 N1～N50。懸吊分級把 S50 放在 10|50 間隔條、S1 放在 1 元滑道右牆，也就是每個感測器都在自己的孔之前，串接公式仍成立。
(6) 第 97～111 行序列埠改印 C 和 N；違反 C1≥C5≥C10≥C50 時提示錯誤。
(7) showNumber() 每次約 20.7 ms（207 次 bitDelay×100 µs），這段時間輪詢停住。緊貼硬幣之間約 12 ms 的空檔可能被吃掉，兩枚被當成一枚。建議改用 attachInterruptArg（ir_tuner 第 559 行已有寫法），或降低 bitDelay。
(8) 第 115 行：A 方案維持 INPUT_PULLUP；C 方案改成 INPUT。
(9) 第 131～140 行 TEST_MODE：修掉 m，順便印出 C 和 N。
- 【其他檔案（參考）】
• coin_sorter_esp32_test.ino：第 1～15 行說明；第 20～21 行 BLOCKED_LEVEL、DEBOUNCE_MS；約第 129～144 行、第 175～184 行的「主控板 OUT/IN、調可變電阻」等文字改成光耦用語（光耦靈敏度不能調）；第 81 行跳帽提示保留。
• ir_tuner_esp32.ino：第 288、290、437、439、448、451、459、481、525 行等「調可變電阻」的提示，改成檢查安裝、遮光和接線；第 40 行 BLOCKED_LEVEL；第 174 行 liveTotal 改用串接公式；第 409 行的 target 改成依幣別指定，因為一枚硬幣會觸發它上游的所有感測器。
• ir_read_esp32 可以沿用；ir_analog_esp32 光耦模組沒有 AO 類比輸出，不適用。
• 接線圖 svg/png 和講師前置測試步驟.txt 也要同步更新。
- 【8 小時研習流程草案】假設 08:30～17:30、午休 1 小時。講師事前完成：雷切 10 套（合板 3～4 片、壓克力約 1/4 片，雷切機約需 5～13 小時，為估計）；光耦已依懸吊分級固定在間隔條和 1 元滑道右牆上（實際零件依 v2 檔）；ESP32、擴展板、TM1637 已裝進電子盒；程式已燒錄；排線已接好並貼標籤；每套都通過燒機。
08:30 開場：示範，說明懸吊分級和 4 個感測器相減的算法。
09:00 清點零件、撕保護膜、安全須知。
09:20 組裝 1：4 個抽屜（#32～#35、#38～#51、#60、#61）。
10:20 休息。
10:30 組裝 2：主體——#26、#5～#7、斜坡相關零件（#31/#36/#13/#21，用途是推測★）、裝了感測器的間隔條、#12。
12:00 午餐。
13:00 組裝 3：TT 馬達、軸套、#62、#27、#63；電池盒和開關用免焊接頭接上；馬達試轉。
14:00 組裝 4：前面板 #24、電子盒，依色標接排線（預接的部分只檢查不拆）。
14:50 休息。
15:00 測試：顯示 1234 後變 0；逐一遮 S1～S50；每種硬幣各 5 枚；混合驗證；故障排除。
16:00 程式體驗（選做）。
17:00 收尾。
建議留 30 分鐘緩衝。
- 【2026-10-12 更正：上面組裝 2～4 的順序做不到】原機的內牆 #26 自己沒有榫，是靠間隔條、櫃側板、馬達盒底板的榫「穿過 #26 再插進 #24」固定的；圍邊 #27 和轉盤軸套也裝在 #24 上；兩片端板 #31／#36 裝上後整台鎖住，#24 就塞不進去。所以 **#24 要最先放**，不能留到組裝 4。正確順序（平放疊裝）：#24 正面朝下平放 → 疊 #26 → 插間隔條 → 插抽屜櫃（#12＋#13R＋#21 先組成ㄇ形）→ 馬達盒（整盒先組好再插）→ 蓋 #37 → 裝端板 → 立起來裝腳座 → 轉盤、#27、#63 → 試轉 → 感測器、排線、抽屜、S1 卡匣、掛電子盒 → 測試。v2 的 #24 已先裝好 TM1637 並連著電子盒。詳見 `03_v2_光耦版/組裝教學/index.html`（B 段）。
- 【2026-10-12 新版 8 小時研習時間表（照上面的正確順序）】B／C 編號對應組裝教學網頁。各段時間是估計，要等講師試做一台實測後再調。講師事前完成（網頁 A 段）：雷切 10 套；每套 3 組 S5／S10／S50 模組（含線、標籤）與 3 個鎖塊、S1 卡匣、#24 已鎖好 TM1637 並用 30 cm 線連著電子盒、電子盒程式已燒錄、#37 已黏 M3 螺帽；每套另備 1 組模組與鎖塊。
08:30 開場：示範整台運作，說明懸吊分級和 4 個感測器相減的算法。
09:00 清點零件、撕保護膜、小零件分袋、安全須知（B1）。
09:20 組裝 1：4 個抽屜（B2；先依雕刻數字分堆，5 元和 1 元只差 0.4 mm）。組好先放旁邊。
10:20 休息。
10:30 組裝 2：抽屜櫃先組成ㄇ形（B3）→ #24 正面朝下平放、墊軟布、疊 #26（B4；電子盒放在 #24 頂邊外側）→ 插 v2 間隔條（B5）→ 插抽屜櫃（B6）→ 馬達盒整盒組好再插（B7）。
12:00 午餐。機身停在平放狀態不要移動（#5 只有一支小榫插 #26，容易倒）。
13:00 組裝 3：馬達電源接線（B8）→ 顯示器線放進 #37 頂邊 U 形缺口、蓋 #37（B9）→ 端板（B10，那一端移出桌邊）→ 立起來裝 4 個腳座（B11）。
14:00 組裝 4：轉盤軸套（B12）→ 預彎並裝圍邊 #27（B13）→ 前蓋 #63（B14）→ 試轉，不放硬幣（B15）。
14:40 休息。
14:50 組裝 5：S5→S10→S50 感測器（B16）→ 整理排線（B17）→ 放抽屜（B18）→ 插 S1 卡匣（B19）→ 顯示器線、插四條感測器線、掛電子盒、選用防拔鍵（B20～B23）。
15:30 測試：開機前檢查、1234→0、每種硬幣各 5 枚、倒已知金額、故障排除（C1～C6）。講師巡場時用序列埠幫有問題的組檢查（C4）。
16:30 程式體驗（選做）：例如改 BRIGHTNESS 重新燒錄。
17:00 收尾：歸零、關馬達與電源；測試都沒問題的組，在會鬆的地方點白膠（抽屜四角、端板接合處、#26 四角；轉盤組不上膠）。
建議留 30 分鐘緩衝；最可能超時的是組裝 2（平放疊裝第一次做）和組裝 4（#27 預彎）。
## measurements
- 原始檔合板零件淨面積（第1+2頁）: 約 77,190＋74,435 ≈ 151,600 mm²（外接矩形合計約 19 萬 mm²）（方法：svgelements＋shapely 解析黑色切割路徑最外層輪廓，px÷3.7795 換成 mm，依 inkscape:page 的 x 分頁）
- 原始檔各頁排版範圍: 第1頁約 288.8×389.9 mm、第2頁約 291.6×389.7 mm，都超過 255×355；第3頁壓克力只有 2 件（方法：同上，各頁外層輪廓聯集的 bounds）
- 原始檔壓克力零件（第3頁）: #63 108.0×68.2、#62 Ø98.0；在 255×355 內約可排 4 套（約 216×341）（方法：同上加手算排版；靠近第2頁邊界的 2 件 12.5×12.5 依頁面座標屬第 2 頁合板）
- 每片可切面積（255×355）: 90,525 mm²；合板理論下限 2 片、實際排版 3 片，加 v2 新增零件可能 4 片（方法：淨面積 151.6k 與外接矩形 190k 各除以 90,525（1.68 與 2.1））
- 每套估價: 最低約 NT$770、中間約 NT$980、最高約 NT$1,460（方法：BOM 逐項加總（紀錄價＋估計價），已重新加總）
- TM1637 一次 showNumber 耗時: 約 20.7 ms（方法：程式碼計算：7 位元組×27 次加 start/stop 共 18 次，合計 207 次 bitDelay(100 µs)）
- 緊貼兩枚 1 元在光束高 3 mm 處的空檔: 約 5.8 mm（假設 0.5 m/s 時約 11.6 ms）；前緣間隔約 40 ms，小於 DEBOUNCE 50 ms（方法：幾何計算；速度為假設值，待 tuner 實測）
- 10 mm 槽型模組規格: 3.6～5 V、約 33 mA、27.6×20×17 mm（網路同類品）；紀錄寫 H2010 孔距 15、孔徑 3（方法：網路搜尋摘要與紀錄第 936 行，都還沒有實品量測）
- 電子部分總電流（A 方案）: 約 0.15～0.2 A；9V 鹼性約 1.5～2 小時（方法：元件典型值估計，待實測）
## risks
- 【修正】原版最低價 786 是加總誤差，重算約 770；M2 節省額改為 NT$60～230，依紀錄 M2 每套約 45～60。
- 【修正】合板片數原本只用外接矩形推算。已實測原始第 1、2 頁排版範圍約 289～292×390，都超過 255×355，v2 一定要重新排版；淨面積推算的理論下限是 2 片，實際 3 片。
- 【修正】研習流程原寫「光耦預裝在 #24 和軌道鍵」，已改成依懸吊分級固定在間隔條和 1 元滑道右牆；固定件數量要等實品孔位。
- 【修正】杜邦線長度原本依 183 mm 斜槽推 30 cm，改成看電子盒位置，暫定 20～30 cm。
- 【補充】使用者給的商品連結還沒確認是不是紀錄裡的 10 mm 槽寬 H2010（NT$40）；如果是 5 mm 槽寬，v2 開孔方式會不同。
- 【補充】38P ESP32 開發板有寬窄兩種，必須確認能插進 53.5×78 擴展板。
- 【補充】C 方案分壓時，指示 LED 會並聯上拉，OUT 實際可能比 3.0V 高，要先實測。
- 模組接 5V、OUT 直接進 GPIO：約 5V，超過 ESP32 上限約 3.6V。
- 模組接 3.3V 低於標稱 3.6V：光量約減半，可能觸發不穩，40 個都要測。
- DEBOUNCE 以前緣計時，加上 TM1637 更新約 20 ms 會阻塞輪詢，緊貼滾動的硬幣可能漏算；串接相減公式會把一次漏算放大到兩個幣別。
- coin_sorter_esp32.ino 第 134 行多一個 m，目前無法編譯。
- 估價高端超過 NT$1,000，主要品項都還沒有實價。
- 免焊限制：馬達、電池盒、開關必須買已附導線的款。
- 雷切工時估 5～13 小時，前置時間要預留。
- 9V 續航短，研習時要管理通電時間。
- 杜邦線容易鬆脫，要點膠或貼標籤。
- 範圍：BOM 和程式清單只是參考，本輪只交付 v2 雷切檔。
## open_questions
- 使用者連結的模組實際槽寬、槽深、光束高度、孔位？OUT 有沒有上拉？3.3V 下能否穩定觸發？遮擋時是 HIGH 還是 LOW？
- 1 元滑道右牆的實際可用空間（寬、深、高）夠不夠放 S1 模組（約 27.6×20×17 mm 加排針）？
- ESP32 開發板要買哪一款（寬版或窄版）、店家報價，學校是否已有庫存？
- 馬達電源要不要改用 M2（3 顆三號電池）取代 18650？
- 研習時段，以及要不要讓老師自己燒錄程式？
- 電子盒放在哪裡？這會決定杜邦線長度和 v2 新增零件的數量。
- 模組 NT$40 是否含稅？是否有學校報價或量購折扣（含備品約 44～48 個）？
