kingofamani/CoinSorting/03_v2_光耦版/laser_v2/out/report.md

# 分幣機 v2 雷切草稿：產生報告

由 `python -m laser_v2.build_v2` 產生（完整流程）。模組實量後改 `laser_v2/params.py` 重跑即可更新（量什麼、改哪個鍵、重跑指令見第四節；採購與備品見第三節）。

> **上雷切機用 `laser_v2/out/sheet_*.svg`**（每張板一個檔：`sheet_合板_1.svg`、`sheet_合板_2.svg`、`sheet_合板_3.svg`、`sheet_壓克力_1.svg`；不含註記）。黑＝切割、紅＝雕刻（全部是 0.2 mm 線，和原始檔一樣）：紅色圖層在雷切軟體設「線／向量雕刻（低功率切割）」，**不要用填色／掃描**。多頁草稿 SVG 含隱藏的註記層，是給人看的，不要直接上機。

## 一、輸出檔與上雷切機設定

- **上雷切機**：`laser_v2/out/sheet_<材質>_<n>.svg`，每檔一張 255×355 板（`sheet_合板_1.svg`、`sheet_合板_2.svg`、`sheet_合板_3.svg`、`sheet_壓克力_1.svg`）。只有 3 個圖層「原始零件」「v2 修改」「v2 新增」，沒有註記層。
- 草稿（多頁，Inkscape 1.x 開，給人看）：`分幣機雷切_光耦版_v2_草稿.svg`，4 頁橫向排列、頁距 30 mm；圖層多一個「註記（不切割）」（預設隱藏：零件代號、修改說明、每張板標題），不要直接上機。
- 預覽 PNG：`laser_v2/out/sheet_<材質>_<n>.png`；零件清單 `parts.csv`（含「備品」「備品所在板」欄）。

| 顏色 | 是什麼 | 雷切軟體設定 |
|---|---|---|
| 黑 #000000，0.2 mm 線 | 切割（外框、孔、彎曲條鋸縫） | 切割（cut） |
| 紅 #ff0000，0.2 mm 線 | 雕刻：原始檔的字與圖案、v2 新增的代號字（外框線字）、定位框線、▲ 記號 | **線／向量雕刻（低功率切割，line）**；不要用填色／掃描（fill／scan）：開放的定位框線、▲ 是線，用填色會漏掉或亂填 |
| 綠 #008000 | 註記（只在草稿的隱藏圖層） | 分頁檔沒有；草稿不要上機 |

- 零件內的順序：每個零件先寫雕刻，再寫孔與內部線（含彎曲條鋸縫），外框寫在最後。雷切軟體照檔案順序切時，零件要到最後才和板分開，不會切到一半掉下去；軟體會自己排序的話，開「先切內部（inner first）」。
- 雷切軟體多半照圖層（顏色）順序跑、不照檔案順序：圖層清單裡把紅色（雕刻）排在黑色（切割）前面，黑色圖層再開「先切內部（inner first）」；不然整張先切穿，小零件來不及雕刻就掉了或移位。
- 全部文字都已轉成路徑（外框線字），檔案裡沒有文字元素。
- 小字（em 2～3 的代號字、#37「感測器線」、EB-WL「左牆」等）用 0.2 mm 線雕刻，筆畫間隙比線寬還窄的地方會燒糊：先切試切小樣，調紅色圖層的功率／速度，確認 C1-S10 的「S10」（em 2.1）和 TB-#37 的「感測器線」刻得清楚再切整台。
- 重跑時，`laser_v2/out` 裡**產生器命名**的分頁檔（`sheet_<材質>_<n>.svg`／`.png`）會被覆寫，這次沒有的那幾張會被移除（SVG 還要檔頭有產生器註解才刪）；自己手改的檔請改名（例如加「_手改」）或存到別處。

**組裝提醒**

- 每條感測器排線兩端貼標籤：模組端寫站名（S5／S10／S50／S1），盒端寫要插的欄位（S1→G27、S5→G26、S10→G25、S50→G33）；老師依標籤裝站、插線（#24 正面不刻站名）。採購數量見第三節。
- 認站：沿滑道從轉盤那端（上游）往下游數，第 1 個感測窗（旁邊刻「1」）裝 S5；第 2 個感測窗裝 S10；最下游、開到 #24 下緣的缺口（兩側各有 1 個方孔，只有 S50 的鎖塊塞得進）裝 S50。窗旁刻的數字是開口／抽屜的幣值，不是站名。S5、S10 的窗、模組、鎖塊形狀都一樣，裝反了要到 a-3 第 5 步丟硬幣才會發現（計數對調，程式的 C5≥C10≥C50 檢查會報錯）：把兩站的模組連同鎖塊對調即可。
- 極小零件每套多排一份備品（見第三節「備品已排進切割檔」），切完和正式件分開收。

## 二、張數與利用率

板 255×355 mm，零件離板邊 ≥ 2 mm、零件之間 ≥ 2 mm（真實外形距離）。利用率＝零件淨面積（外框減孔）÷ 板面積（含備品）。

| 板 | 件數 | 其中備品 | 利用率 | 外框面積比 | 排到（x, y） | 排法／備註 |
|---|---:|---:|---:|---:|---|---|
| 合板 第 1 張 | 47 | 8 | 69.4% | 79.7% | 252, 353 | 排序 area、靠齊 left、不放進其他零件的孔；含備品 8 件 |
| 合板 第 2 張 | 26 | 0 | 66.2% | 74.4% | 253, 353 | 排序 area、靠齊 left、不放進其他零件的孔 |
| 合板 第 3 張 | 17 | 0 | 31.9% | 33.2% | 135, 352 | 排序 area、靠齊 left、不放進其他零件的孔 |
| 壓克力 第 1 張 | 2 | 0 | 10.4% | 10.6% | 100, 205 | 排序 area、靠齊 left、不放進其他零件的孔 |

合計：合板 3 張、壓克力 1 張（目標合板 3 張、壓克力 1 張；備品只塞進已經開的板，不另開板）。
彎曲條（開放鋸縫很多的零件，例如 #27）只轉 0／180 度，保持原始檔的木紋方向。

## 三、材料與採購（每套／10 套）

板材張數依這份草稿的排版；五金、電子、耗材由各子系統 build() 的 bom 彙整（依目前 params）。「誰用」：講師預組＝研習前講師做好；老師現場＝研習時老師自己裝。價格不在雷切檔範圍。

**板材（雷切，255×355 可切範圍）**

| 材料 | 每套 | 10 套 | 說明 |
|---|---|---|---|
| 合板 | 3 張 | 30 張 | 厚 3 mm；利用率 第 1 張 69%、第 2 張 66%、第 3 張 32% |
| 壓克力 | 1 張 | 10 張（10 套合排約 4 張，粗估：每套零件 98×203 一塊，一張放 3 塊） | 厚 3 mm；利用率 第 1 張 10% |
| 試切小樣 | — | — | 另計，見 trial_report.md（spec 建議 MDF、合板各切一次） |

**電子、五金、耗材**

| 類別 | 品項 | 每套 | 10 套 | 誰用 | 說明 | 出處 |
|---|---|---|---|---|---|---|
| 電子 | 槽型光耦模組（LM393，10 mm 槽寬） | 3 個 | 30 個 | 講師預組 | S5／S10／S50 各 1；先照 spec d-1 量（Go／No-Go），3.3 V 測試、插 3P 線、排針根部點熱熔膠 | crosstrack a-2 |
| 電子 | 槽型光耦模組（同 S5～S50 型號） | 1 個 | 10 個 | 講師預組 | S1 卡匣用；貼在 S1-B 上 | s1 a-2 |
| 電子 | TM1637 四位數七段顯示器（0.36 吋） | 1 個 | 10 個 | 講師預組 | 暫定 PCB 42×24、固定孔距（全距）38×20，待實量 | ebox a-1 |
| 電子 | ESP32 擴展板（GVS 排針） | 1 塊 | 10 塊 | 講師預組 | 暫定 78×53.5；鎖在 EB-B | ebox a-2 |
| 電子 | ESP32 DevKit 38P 開發板 | 1 塊 | 10 塊 | 講師預組 | 插在擴展板上；燒錄程式 | ebox a-2 |
| 電子 | 9V 電池 | 1 顆 | 10 顆 | 講師預組 | 放進電池帶；換電池見 spec a-4 | ebox a-2 |
| 電子 | 9V 電池扣＋線上開關＋DC 5.5×2.1 插頭（免焊線組） | 1 組 | 10 組 | 講師預組 | 開關照預設是 13.5×9 面板式，卡進 EB-T（型式待決）；線長 ≥160 mm | ebox c-4 |
| 電子 | 4P 母對母杜邦連排線 30 cm | 1 條 | 10 條 | 講師預組 | 顯示器↔擴展板（路徑約 194 mm） | ebox c-4 |
| 電子 | 3P 母對母杜邦線 20 cm（盒端 1×3 G-V-S） | 1 條 | 10 條 | 講師預組 | S1（路徑約 151 mm）；盒端貼標籤「S1→G27」 | ebox c-4、a-2 第 5 步 |
| 電子 | 3P 母對母杜邦線 40 cm（盒端 1×3 G-V-S） | 3 條 | 30 條 | 講師預組 | S5／S10／S50（路徑約 315／331／350 mm；S50 太緊改 50 cm）；盒端貼標籤「S5→G26」「S10→G25」「S50→G33」 | ebox c-4、a-2 第 5 步 |
| 五金 | M3×10 尼龍螺絲 | 2 支 | 20 支 | 老師現場 | 卡匣背蓋鎖 #37（手擰） | s1 (c)、a-3 |
| 五金 | M3 螺帽 | 2 顆 | 20 顆 | 講師預組 | 熱熔膠預黏在 #37 空腔側兩個 Ø3.4 孔上 | s1 a-2 第 8 步 |
| 五金 | M2×8 尼龍螺絲＋M2 尼龍螺帽 | 4 組 | 40 組 | 講師預組 | TM1637 鎖 #24（螺絲頭在正面） | ebox c-4 |
| 五金 | M3×12 尼龍螺絲 | 4 支 | 40 支 | 講師預組 | 擴展板鎖 EB-B | ebox c-4 |
| 五金 | M3 尼龍螺帽 | 12 顆 | 120 顆 | 講師預組 | 每孔 3 顆：2 顆墊高 4.8＋EB-B 前面 1 顆 | ebox c-4 |
| 耗材 | PI 膠帶或電工膠帶（厚 ≤0.15） | 少量 | 少量 | 講師預組 | 包 PCB 翼的零件面，讓落下的硬幣碰到平滑面；不可用 0.5 mm PET 片（會吃掉 0.3 的零件餘隙） | crosstrack a-2 第 4 步 |
| 耗材 | 排線標籤貼紙 S5／S10／S50（模組端） | 3 張 | 30 張 | 講師預組 | 每條感測器排線靠模組端貼一張（寫 S5、S10、S50）；老師依排線標籤把模組裝到對應的站（#24 正面不刻站名；認站方法見六、crosstrack「老師組裝」）。盒端標籤（例如 S5→G26）另列在電子盒 | 使用者 2026-10-08 決定 4 |
| 耗材 | 雙面泡棉膠 1 mm 厚 | 3 cm² | 30 cm² | 講師預組 | 模組 PCB 貼 S1-B（s_pcb 墊高，調光束 U） | s1 (c) |
| 耗材 | 瞬間膠 | 少量 | 少量 | 講師預組 | 3 片 S1-H 導流帽疊齊後黏到前臂頂面（spec R1：用瞬間膠，掉了會卡幣） | s1 a-2、R1 |
| 耗材 | S1 排線標籤（模組端） | 1 張 | 10 張 | 講師預組 | 貼在 S1 模組排線靠模組端（寫 S1）；老師依排線標籤裝卡匣、接線不會和 S5～S50 弄混。盒端標籤（S1→G27）另列在電子盒 | 使用者 2026-10-08 決定 4 |
| 耗材 | 感測器線盒端標籤（S1→G27、S5→G26、S10→G25、S50→G33） | 4 張 | 40 張 | 講師預組 | 每條感測器線的盒端 1×3 杜邦頭旁貼一張（寫要插的欄位）；模組端另貼站名標籤（S5／S10／S50、S1，見上）。老師在盒內插線時照盒端標籤對欄位 | ebox a-2 第 5 步 |
| 耗材 | 緞帶 5×80 mm | 1 條 | 10 條 | 講師預組 | 墊在電池下當拉環 | ebox c-4 |
| 耗材 | 白膠、熱熔膠 | 少量 | 少量 | 講師預組 | 盒體、鎖塊、卡匣用白膠；杜邦頭、線、開關、螺帽用熱熔膠 | ebox c-4 |

槽型光耦模組合計每套 4 個、10 套 40 個（另見下表備用）。

**備品已排進切割檔（使用者 2026-10-08：外包兩邊都 <10 mm 的極小零件，每套多切一整份；不增加張數）**

| 代號 | 名稱 | 每套正式 | 每套備品（排進切割檔） | 備品所在板 |
|---|---|---:|---:|---|
| EB-K | 電子盒防拔鍵（選用） | 2 | 2 | 合板1×2 |
| PIN-S50 | S50 插銷（黏在 C1 雕刻方塊上） | 2 | 2 | 合板1×2 |
| S1-H | S1 導流帽（三角片 ×3，疊黏在前臂頂面；不雕刻） | 3 | 3 | 合板1×3 |
| S1-P | S1 帽通道填塊（黏在背蓋前面；雕刻面朝背蓋） | 1 | 1 | 合板1 |

備品和正式件形狀完全相同，在 SVG 裡的群組標 `data-spare="1"`、代號標籤寫「（備品）」；切完和正式件分開收，講師預組時掉了或壞了直接換。

**其他備品（spec 建議；不在切割檔，要不要另外準備請使用者決定）**

| 品項 | 每套 | 10 套 | 說明 | 出處 |
|---|---|---|---|---|
| 光耦模組（備用） | 1 個 | 10 個 | spec a-2 第 6 步「另備 1 組模組與鎖塊」 | crosstrack a-2 |
| 鎖塊組（P1＋C1：S5／S10／S50 各 1） | 1 組 | 10 組 | spec (c)「另建議每套多附 1 組」；目前切割檔沒有排，要的話把同一份切割檔的新零件多切一份（插銷 PIN 的備品 ×2 已排進切割檔，見「備品已排進切割檔」） | crosstrack (c) |
| #24、#26（v2，開窗後較弱） | — | 各 2 片 | spec R4：每 10 套多切 2 片；發料時 #24 平放、拿取時避免扳 | crosstrack R4 |
| S1 卡匣（S1-B、S1-C、S1-F、S1-P、S1-H×3）＋模組 | — | 2 個（建議） | 待決（s1 spec (i) 8）：每場幾個備品卡匣，建議 10 套配 2 個；整個卡匣目前切割檔沒有排（極小零件 S1-H×3、S1-P×1 的備品已排進切割檔，見「備品已排進切割檔」） | s1 a-2、(i) 8 |

**切割注意：極小零件**

- v2 新零件裡外包兩邊都小於 10 mm 的：PIN-S50 3.0×3.0（9 mm²，×2＋備品 2）、S1-H 7.0×4.5（16 mm²，×3＋備品 3）、S1-P 9.9×4.4（44 mm²，×1＋備品 1）、EB-K 6.5×8.3（48 mm²，×2＋備品 2）。原始檔最小的切割件是 #20、#23、#16、#17 7×9（52 mm²），以前也沒加連接橋；一般雷切蜂巢台格子 6～10 mm。
- PIN-S50、S1-H 小於 20 mm²，切完幾乎一定會掉進蜂巢或集塵盤（3 mm 厚的零件卡在自己的切口裡最多只翹約 3°，不會撞噴嘴，主要是會掉、會丟）。
- 切合板第 1 張（極小零件和備品都在這張）前，在板底貼一層紙膠帶，或墊一張犧牲板；切完先清點這幾種的數量（正式件＋備品），再檢查蜂巢底下與集塵盤。
- 這些都是講師預組時才用（插銷黏 C1、導流帽黏前臂、填塊黏背蓋、防拔鍵選用），掉了可以撿回或重切，不影響老師現場組裝。每套已經多排一整份備品進切割檔（見上面「備品已排進切割檔」），掉了一片直接用備品；不建議自己加微連接：插銷是 3.0 方塊要壓進 2.9 孔，連接點留下的凸點會影響配合。要不要做小件框或微連接，請依雷切機台面（蜂巢台或刀條台、格子大小）決定。
- 試切小樣也有同樣的小件（PIN、S1-H、S1-P、EB-K，也一樣多排一份備品），處理方式相同。

## 四、實量後改哪裡、怎麼重跑

全部只改 `laser_v2/params.py`（各字典的鍵都已列在檔裡，註解寫了意義），不必改各子系統檔。

| 量什麼 | 改 params.py 的哪裡 | 單位與注意 | 會變的切割 | 重切哪一塊試切小樣 |
|---|---|---|---|---|
| 合板實際厚度（游標卡尺量幾處取平均） | `T_PLY`（目前 3） | mm；所有榫槽、掛勾槽、支架槽跟著變 | 全部新切割 | TA、TB 全部 |
| 槽型光耦模組（crosstrack spec d-1、s1 spec d-4 的 Go／No-Go 清單） | `MODULE`：slot_w、slot_d、beam_sb、arm_t、arm_w、arm_top、pcb_L、pcb_W、pcb_t、body_e、wing、comp_h、back_h、hdr_up、hdr_len、pcb_ovf、aperture | mm；wing 填 'up'／'down'／'center'（排針朝自己、兩臂朝上時 PCB 長邊在右＝'up'）；comp_h（翼上最高零件）>2.3 時窄段定位壁會太矮（crosstrack 檢查會不過） | #24／#26 窗與光孔、隔板缺口、P1／C1、#13R 牆槽、#37 卡匣窗、S1 卡匣 | TA-#24、TA-#26、TA-#5、TA-#6、P1／C1、TB 全部 |
| TM1637 顯示器 | `TM1637`：pcb_w、pcb_h、pcb_t、hole_d、body_w、body_h、body_H、body_dx、body_dy、back_h、hole_dx、hole_dy、use_screws、hdr_mode、dup_len、dup_gap、wire_bend | mm；**hole_dx／hole_dy 是半距**（孔中心離 PCB 中心）：量到孔距 38×20 要填 19、10；沒有固定孔就 use_screws=False（#24 不切 M2 孔，改熱熔膠）；只改 pcb_w／pcb_h 不改孔距時，ebox 檢查「M2 孔在 TM1637 PCB 上」會不過 | #24 顯示窗與 M2 孔、#26 L 形缺口、#5 前上角 | TA-#24、TA-#26、TA-#5 |
| ESP32 擴展板＋開發板 | `ESP32_BOARD`：L、W、t、standoff、hole_inset、hole_d、hdr_h、dev_len、dev_w、usb_inset、usb_V_off、btn_dv、dc_V_off | mm；4 個 M3 孔離板邊要相等（hole_inset）；USB／DC 在 +U 端（右牆那側）是寫死的，實品相反要先問 | EB-B 孔、EB-WR 服務窗、盒底 | 電子盒 EB-* |
| 9V 電池 | `BATTERY_9V`：L、W、T | mm；口袋取 max(實測, 標準 48.5×26.5×17.5)，實品較小不縮 | 電子盒電池帶 | 電子盒 EB-* |
| S1 模組前臂（靠 #26 那臂）PCB 背面焊腳的**位置**與高度（S1 卡匣用的那個模組；組裝座標 V、W'） | 高度：`MODULE['back_h']`（目前 2.0）；**位置不是 params**，量完先回報 | mm；PCB 用 1 mm 泡棉膠墊高，所以凸出 >1.0 mm 的焊點只能落在 S1-B 讓位孔內（V≤74.7）或 W'>29，否則會頂到 S1-B 下料條或 #13R 牆、把 PCB 頂高（光束跟著偏），要改 S1-B 讓位孔／牆槽（mods_s1，改前先問）；見 laser_v2/驗證筆記/S1規格核對_2026-10-07.md 觀察 1、整機組裝核對_2026-10-07.txt | S1-B 讓位孔、S1-F、#37 卡匣窗焊點段 | TB-#37、S1-*（TB 全部） |

重跑（先進到 03_v2_光耦版 資料夾）：`../.venv/Scripts/python.exe -B -m laser_v2.build_v2`（約 95 秒；草稿、分頁 SVG、本報告、試切小樣一起更新；只要草稿加 `--no-trial`）。改完先看「六、各子系統」的警告與「七、跨子系統檢查」，全部通過再切；先切試切小樣照 trial_report.md 驗收，再切整台。

**本次使用的參數（laser_v2/params.py，產生這份檔案時的值）**

| 鍵 | 值 |
|---|---|
| `MODULE` | slot_w=10、slot_d=9、beam_sb=5、arm_t=7、arm_w=6.4、arm_top=12、pcb_L=27.6、pcb_W=20、pcb_t=1.6、body_e=0.5、wing='up'、comp_h=2、back_h=2、hdr_up=14、hdr_len=8、pcb_ovf=0、aperture=1 |
| `TM1637` | pcb_w=42、pcb_h=24、pcb_t=1.6、hole_d=2.2、body_w=30、body_h=14、body_H=7.2、body_dx=0、body_dy=0、back_h=2.6、hole_dx=19、hole_dy=10、use_screws=True、hdr_mode='RA'、dup_len=14、dup_gap=1、wire_bend=5.5 |
| `ESP32_BOARD` | L=78、W=53.5、t=1.6、standoff=4.8、hole_inset=3、hole_d=3.4、hdr_h=8.5、dev_len=55、dev_w=28、usb_inset=2、usb_V_off=26.75、btn_dv=8.5、dc_V_off=6.5 |
| `BATTERY_9V` | L=48.5、W=26.5、T=17.5 |
| `BEAM_H` | 2.5 |
| `LOGO_PLAN` | 'L2' |
| `S1_WALL_TOP_V` | 30 |
| `T_PLY` | 3 |
| `C_TAB` | 0.1 |
| `C_SENSOR` | 0.4 |
| `C_HOOK` | 0.2 |

## 五、零件

共 80 種、84 件：原始零件 52 件、v2 修改 8 件、v2 新增 24 件；另備品 8 件（第三節）。

| 代號 | 名稱 | 圖層 | 數量（＋備品） | 尺寸 | tags |
|---|---|---|---:|---|---|
| #5 | 10\|50 間隔條 | v2 修改 | 1 | 35.0×78.5 | S50 隔板缺口（擋面＋導角＋深段），直通斜底邊；#5 雕刻「S50 v2」；TM1637 背面零件讓位（前上角，連帶刪上小榫） |
| #6 | 5\|10 間隔條 | v2 修改 | 1 | 35.0×84.0 | S10 隔板缺口（擋面＋導角＋深段）；#6 v2 上方小榫（取代長榫，插 #26 新槽）；#6 雕刻「S10 v2」 |
| #7 | 1\|5 間隔條 | v2 修改 | 1 | 38.0×84.0 | S5 隔板缺口（擋面＋導角＋深段）；#7 雕刻「S5 v2」 |
| #13R | 抽屜櫃側板（右，1 元滑道右牆位置） | v2 修改 | 1 | 123.2×69.9 | S1 #13R 加高成 1 元滑道右牆（W'0～29 × V30～76.2）＋前榫 F1（插 #26；W'-2.6～0 × V50.5～56）、前榫 F2（插 #26；W'-2.6～0 × V68～74.5）、後榫 B1（插 #37；W'29～32 × V36～48）；S1 #13R 牆槽（開向 #37，S1-B 由背面插入；W'11.8～30 × V57.5～76.9）；S1 #13R 角落讓位（修 #37 開口 R2 內角干涉；W'29～32.2 × V77～84）；S1 #13R 雕刻「13R 右」（上面，朝空腔）；S1 #13R 雕刻「S1 卡匣」（上面，朝空腔） |
| #21 | 抽屜櫃側板（左） | v2 修改 | 1 | 84.3×52.2 | S1 #21 雕刻「21 左」（防裝反；上面，朝 50 元滑道） |
| #24 | 前面板 | v2 修改 | 1 | 114.0×246.0 | S5 階梯窗；S10 階梯窗；S50 開底缺口（階梯形）；S50 插銷孔（上游）；S50 插銷孔（下游）；感測器排線孔（右下）；刪孔：#6 長榫已刪；刪孔：#5 長榫已刪（S50 缺口直通下緣）；雕刻「5」搬移 ΔU+0 ΔV-52.5；雕刻「1」搬移 ΔU+0 ΔV+19；TM1637 顯示窗（LED 塊每邊 +0.3）；TM1637 M2 固定孔 1；TM1637 M2 固定孔 2；TM1637 M2 固定孔 3；TM1637 M2 固定孔 4；Logo 移位（L2）：菱形孔；Logo 移位（L2）：雕刻 |
| #26 | 內牆（分幣開口） | v2 修改 | 1 | 107.0×203.0 | 修正 #26 右側第 1 個齒孔（原始檔偏 ΔV+1.000、ΔU+0.134；frames.fix_26_tooth_hole）；S5 階梯窗；S5 光孔（平行四邊形）；S10 階梯窗；S10 光孔（平行四邊形）；S50 開底缺口（階梯形）；S50 光孔（平行四邊形）；#6 新小榫槽；感測器排線孔（右下）；刪孔：#7 中段小榫已刪（落在 S5 窗與隔板缺口內）；刪孔：#6 長榫已刪；刪孔：#5 長榫已刪（S50 缺口直通下緣）；S1 #26 槽 F1（#13R 前榫 F1；U104.725～108.025 × V50.35～56.15）；S1 #26 槽 F2（#13R 前榫 F2；U104.725～108.025 × V67.85～74.65）；S1 #26 槽 C（S1-C 前榫；U101.725～105.025 × V58.85～65.15）；TM1637 頂邊 L 形缺口（PCB、M2 螺帽、彎針、杜邦頭、上升線） |
| #37 | 後面板 | v2 修改 | 1 | 114.0×246.0 | S1 #37 卡匣窗（U101.575～122.875 × V54.2～78.8，371.5 mm²）；S1 #37 槽 B1（#13R 後榫；U104.725～108.025 × V35.85～48.15）；S1 #37 M3 孔 Ø3.4（中心 U96.575 V56.2；空腔側預黏螺帽）；S1 #37 M3 孔 Ø3.4（中心 U96.575 V73.5；空腔側預黏螺帽）；S1 #37 雕刻「S1 卡匣」（外面，背蓋上緣之上）；電子盒掛勾槽 1（左牆上層）；電子盒掛勾槽 2（左牆下層）；電子盒掛勾槽 3（右牆上層）；電子盒掛勾槽 4（右牆下層）；顯示器線頂邊 U 形缺口；感測器線孔（S5/S10/S50 線由右側空腔穿到背面）；電子盒掛勾槽旁箭頭（左牆；盒子推到底後往下滑，選用雕刻）；電子盒掛勾槽旁箭頭（右牆；盒子推到底後往下滑，選用雕刻）；感測器線孔標示（選用雕刻；從機身背面看是正的） |
| C1-S5 | S5 蓋板 C1（雕刻面＝貼 #24 的背面） | v2 新增 | 1 | 26.8×12.9 |  |
| C1-S10 | S10 蓋板 C1（雕刻面＝貼 #24 的背面） | v2 新增 | 1 | 26.8×12.9 |  |
| C1-S50 | S50 蓋板 C1（雕刻面＝貼 #24 的背面） | v2 新增 | 1 | 34.8×23.7 |  |
| EB-B | 電子盒主板底板 | v2 新增 | 1 | 94.0×55.5 |  |
| EB-E | 電子盒電池端擋 | v2 新增 | 1 | 35.8×16.8 |  |
| EB-F | 電子盒電池架 | v2 新增 | 1 | 64.2×32.8 |  |
| EB-K | 電子盒防拔鍵（選用） | v2 新增 | 2＋2 | 6.5×8.3 |  |
| EB-S | 電子盒電池後擋 | v2 新增 | 1 | 67.2×13.8 |  |
| EB-T | 電子盒頂板（電源開關） | v2 新增 | 1 | 94.0×20.0 |  |
| EB-WL | 電子盒左牆（兩層掛勾、排線口） | v2 新增 | 1 | 45.0×72.2 |  |
| EB-WR | 電子盒右牆（兩層掛勾、服務窗、DC 線口） | v2 新增 | 1 | 45.0×72.2 |  |
| P1-S5 | S5 鎖塊 P1（黏在 C1 雕刻外框內，頂住凸塊在上緣、對齊 C1 下緣 ▲ 記號那一端） | v2 新增 | 1 | 20.6×12.2 |  |
| P1-S10 | S10 鎖塊 P1（黏在 C1 雕刻外框內，頂住凸塊在上緣、對齊 C1 下緣 ▲ 記號那一端） | v2 新增 | 1 | 20.6×12.2 |  |
| P1-S50 | S50 鎖塊 P1（黏在 C1 雕刻外框內，頂住凸塊在上緣） | v2 新增 | 1 | 20.6×15.0 |  |
| PIN-S50 | S50 插銷（黏在 C1 雕刻方塊上） | v2 新增 | 2＋2 | 3.0×3.0 |  |
| S1-B | S1 座塊（嵌 #13R 牆槽；雕刻面朝 S1-C，和 #13R 同板） | v2 新增 | 1 | 22.7×19.0 |  |
| S1-C | S1 座板（空腔側貼牆；雕刻面朝牆／S1-B，紅框是 S1-B 黏貼位置） | v2 新增 | 1 | 37.0×24.0 |  |
| S1-F | S1 背蓋（貼 #37 外面，2 支 M3 尼龍螺絲；雕刻面朝外） | v2 新增 | 1 | 35.3×27.3 |  |
| S1-H | S1 導流帽（三角片 ×3，疊黏在前臂頂面；不雕刻） | v2 新增 | 3＋3 | 7.0×4.5 |  |
| S1-P | S1 帽通道填塊（黏在背蓋前面；雕刻面朝背蓋） | v2 新增 | 1＋1 | 9.9×4.4 |  |

## 六、各子系統

### S5／S10／S50 滑升式感測座（mods_crosstrack）

edits 28 項、新零件 7 種。

**說明**

- S5／S10／S50 滑升式感測座（spec：laser_v2/design/crosstrack_final/spec.md）。光束高 h=2.5（params.BEAM_H），翼方向 wing='up'；#24 保留條 2.3／肩部 3.2，上滑行程 9.8。
- 模組尺寸是 params.MODULE 的暫定值；拿到實品先照 spec d-1 量（槽寬、槽深、光束離槽底、臂寬厚、臂頂離 PCB、PCB 長寬厚、本體位置與左右手性、排針位置方向、零件高、焊點高、固定耳），改 params.py 再重跑。
- Go/No-Go：排針＋杜邦頭要在 PCB 沿光束方向離前緣 11.5 mm 以內（才在 #24 前面）；S50 的排針不可朝下；光耦本體不可有固定耳（有就要量並加寬窄段）。
- 老師組裝（spec a-3）：換 v2 的 #7／#6／#5 → 依排線標籤把模組裝到對應的站（排線上貼 S5／S10／S50 標籤；#24 正面不刻站名，使用者 2026-10-08 決定。認站：沿滑道從轉盤那端（上游）往下游數，第 1 個感測窗（旁邊刻「1」）裝 S5；第 2 個感測窗裝 S10；最下游、開到 #24 下緣的缺口（兩側各有 1 個方孔，只有 S50 的鎖塊塞得進）裝 S50。窗旁刻的數字是開口／抽屜的幣值，不是站名。S5、S10 的窗、模組、鎖塊形狀都一樣，裝反了要到 a-3 第 5 步丟硬幣才會發現（計數對調，程式的 C5≥C10≥C50 檢查會報錯）：把兩站的模組連同鎖塊對調即可）→ 每站模組兩臂朝上、排針朝自己，對準窗下半部水平推入 → 往上推約 10 mm，一手頂住 → 塞鎖塊：C1 拿在手上、P1 那面朝機身，先把 P1 背面貼住 #24 正面（窗的下方），沿 #24 正面往上推到 P1 頂住凸塊碰到 PCB 下面（S50 同時讓兩支插銷對準 #24 的方孔），再往後推 3 mm，讓 P1 進窗、C1 貼平 #24 → 放手，靠重力定位。不要從模組前方把鎖塊直接水平伸進去：P1 頂住凸塊在光耦正下方，水平推入時會撞到前臂底下的光耦焊腳（n 方向重疊 1.8，模組頂到最高也一樣）。spec a-3 第 3.3 步「從前方塞進窗的下半部」照此更正。拆換（spec a-4）：先把鎖塊往前拉 3 mm 讓 P1 出窗（S50 連插銷一起），再往下拿開，模組自己落回低位。
- 新零件的區域座標：x＝沿軌往下游、y＝往下（垂直軌道）。從雕刻面看＝從 #24 往前看，所以 C1 的雕刻面（P1 外框、插銷方塊、站名）是貼 #24 的背面；P1 照外框黏在 C1 上，頂住凸塊在上緣。S5／S10 的 P1 外框左右對稱（P1 翻面也套得進），所以 C1 下緣另刻一個 ▲，對齊頂住凸塊的位置（站名在另一端）：黏 P1 時凸塊要在 ▲ 那一端，翻面黏的話凸塊會跑到 PCB 翼和焊點底下。S50 的外框兩側不等長，不會黏反。P1 和 C1 齊平的邊（S5/S10 的上緣、S50 的上下緣）不刻線，只刻其餘邊（雕刻離切割邊 ≥0.3）。
- 講師預組：C1-S50 的 2 支插銷黏在 C1 雕刻方塊上（先插進試切小樣的 #24 孔再壓 C1，最準）；建議每套多切 1 組 P1／C1（另備）。講師接感測器線時，在每條排線靠模組端貼站名標籤（S5／S10／S50）；盒端另貼插座標籤（例如 S5→G26，見電子盒 a-2 第 5 步）。
- 極小零件：插銷 PIN（3×3）每套多切 2 個備品，排在同一份切割檔（parts.csv「備品」欄；使用者 2026-10-08 決定 3），掉進蜂巢台或弄丟時用。
- C1 站名：S5 em 2.1（直排）、字墨離切割 1.03、S10 em 2.1（直排）、字墨離切割 1.02、S50 em 3、字墨離切割 1.42（要求 ≥1；離 P1 框、▲、插銷方塊 ≥0.4）。所有 v2 雕刻（框線、▲、字）都是紅色 0.2 mm 線。
- #24 雕刻「1」「5」被窗／蓋板蓋到，用 move_engrave 移開：「5」 ΔU+0 ΔV-52.5（新位置 U150.15～158.77×V21.31～31.06）；「1」 ΔU+0 ΔV+19（新位置 U123.83～130.58×V82.81～92.56），新位置離所有切割 ≥1.5。這是用「原始切割＋本模組的切割」算的，整合時要用最終切割（含電子盒的顯示窗、M2 孔、Logo 新位置）重算。
- #5：本模組刪長榫並開缺口（直通斜底邊）；電子盒還會再減前上角（電子盒規格 b-3：W'≤2.0、V≤30.31，連上小榫一起刪），合併後只剩第二小榫＋後榫。「S50 v2」雕字中心在 W'16.0、V21.5（字高 3.0），避開 W'≤4、V≤33 那一角。
- #26：本模組改窗 ×3、光孔 ×3、#6 新小榫槽、排線孔、刪 3 個孔；S1（#13R 新槽）與電子盒（L 形缺口）也會改 #26，另外 fix_26_tooth_hole() 修齒孔（compose 套用，本模組不做；該孔離本模組新切割約 15）。
- 窄段定位壁：光束沿軌靠光耦本體貼窄段下游壁定位（spec a-1、b-1），本體貼得到的壁高＝n_sb−n_shoulder＝0.7（檢查要求 ≥0.4；名目模組時等於 comp_h ≤2.3，與 spec d-1 Go／No-Go 相同）。spec d-2 的「comp_h ≤2.9 時仍可行」指肩部降到和保留條同高，但那時這面壁已經消失（目前參數下 comp_h ≥2.7、slot_d ≥9.7 或 arm_top ≤11.3 就會），本體改靠 PCB 邊定位，光束沿 s 可偏 ±0.4；實量值落在這個範圍要先問。
- #6：長榫一律刪除，補一支上方小榫（W'−3～0×V31～38，平面矩形），插 #26 新槽（U165.68～168.58×V31.05～37.95）。
- #37：本模組不改。三條感測器線走右下排線孔（#24/#26 U91.5～101.5×V103.5～108）→ 右側空腔 → #37 感測器線孔（由電子盒開；需在 U72.1～104.9 內 ≥10×5，電子盒規格是 U88～100×V40～46；S1 背蓋與 B1 槽不可和它重疊）。
- S5 的 PCB 翼伸進上游滑道：U118.3～135.88、V57.41～69.07、W'0.0～9.6（給 S1：導流件、模組、光束不可進入）
- S10 的 PCB 翼伸進上游滑道：U147.89～165.63、V68.19～79.9、W'0.0～9.6
- S50 的 PCB 翼伸進上游滑道：U180.56～198.38、V80.08～91.83、W'0.0～9.6
- 修改範圍 #24（組裝座標）：S5 階梯窗 U114.4～139.5×V57.0～79.2；S10 階梯窗 U144.0～169.1×V67.8～90.0；S50 開底缺口（階梯形） U175.5～201.7×V79.7～98.0；S50 插銷孔（上游） U174.0～177.8×V84.9～88.6；S50 插銷孔（下游） U202.0～205.7×V89.4～93.2；感測器排線孔（右下） U91.5～101.5×V103.5～108.0；刪孔：#6 長榫已刪 U165.7～168.6×V84.5～92.4；刪孔：#5 長榫已刪（S50 缺口直通下緣） U198.4～201.3×V84.5～92.4；雕刻「5」搬移 ΔU+0 ΔV-52.5 →U150.2～158.8×V21.3～31.1；雕刻「1」搬移 ΔU+0 ΔV+19 →U123.8～130.6×V82.8～92.6
- 修改範圍 #26（組裝座標）：S5 階梯窗 U114.4～139.5×V57.0～79.2；S5 光孔（平行四邊形） U136.7～138.5×V55.1～59.6；S10 階梯窗 U144.0～169.1×V67.8～90.0；S10 光孔（平行四邊形） U166.3～168.1×V65.9～70.4；S50 開底缺口（階梯形） U175.5～201.7×V79.7～98.0；S50 光孔（平行四邊形） U198.9～200.7×V77.8～82.3；#6 新小榫槽 U165.7～168.6×V31.1～38.0；感測器排線孔（右下） U91.5～101.5×V103.5～108.0；刪孔：#7 中段小榫已刪（落在 S5 窗與隔板缺口內） U135.9～138.8×V64.5～74.4；刪孔：#6 長榫已刪 U165.7～168.6×V84.5～92.4；刪孔：#5 長榫已刪（S50 缺口直通下緣） U198.4～201.3×V84.5～92.4
- 修改範圍 #7（組裝座標）：S5 隔板缺口（擋面＋導角＋深段） W'-3.0～10.0×V51.5～74.5；#7 雕刻「S5 v2」 中心 W'16.0 V21.5
- 修改範圍 #6（組裝座標）：S10 隔板缺口（擋面＋導角＋深段） W'-6.0～10.0×V62.3～92.4；#6 v2 上方小榫（取代長榫，插 #26 新槽） W'-3.0～0.5×V31.0～38.0；#6 雕刻「S10 v2」 中心 W'16.0 V21.5
- 修改範圍 #5（組裝座標）：S50 隔板缺口（擋面＋導角＋深段），直通斜底邊 W'-6.0～10.1×V74.2～98.0；#5 雕刻「S50 v2」 中心 W'16.0 V21.5
- 低位（安裝時）會伸到出口平面以下的站：S50（-8.69；計算上伸進 10 元抽屜區）。spec a-3 的說明是「裝／拆 S50 前先抽出 10、50 元抽屜」（保守，兩格都抽）。
- 未移植的檢查（需要模擬或外部資料）：硬幣翻倒＋落下掃掠（tip_fall_sweep）、相貼兩枚在光束高的空隙與光孔處弦長、前臂到硬幣前面（硬幣厚是估計）、排線長度估計、實品偏差敏感度（sens.py）。數字見 spec (e)、d-2。
- 待決：光耦模組全部尺寸（照 params.MODULE 暫定值）
- 待決：模組左右手性／翼方向（照預設 wing='up'；若是 'down'，S50 會低於出口平面，要量抽屜側牆到滑道出口間隙或換鏡像模組）
- 待決：試切卡幣時是否改用分離式紅外線對射（照預設：槽型模組）
- 待決：排線走法（照預設：右下排線孔→右側空腔→#37 感測器線孔）
- 待決：刪除 #5、#6 長榫與 #7 中段小榫、#6 補上方小榫（照預設：刪除並補）
- 待決：裝／拆 S50 前先抽出 10、50 元抽屜（照預設：寫進老師組裝說明）
- 待決：#5 合併後只剩 2 支榫（照預設：接受，試切 T5 確認不晃）

**檢查**：109/109 通過。

<details><summary>全部 109 項檢查</summary>

| 項目 | 結果 | 值 | 期望 | 說明 |
|---|---|---|---|---|
| S5 光束離上游開口終點（U） | OK | 2.98 | &gt;0 |  |
| S5 光束離下游開口起點（U） | OK | 2.98 | &gt;0 |  |
| S5 窗到最近分幣開口 | OK | 3.62 | ≥2.0 | 開口零改動 |
| S5 窗到斜槽（軌道） | OK | 2.3 | ≥2.0 | 軌道零改動 |
| S5 光孔到上游／下游開口 | OK | [2.08, 2.08] | ≥2.0 |  |
| S5 光孔到窗 | OK | 3 | ≥2.0 |  |
| S5 #24 保留條厚（光耦段／肩部） | OK | [2.3, 3.2] | ≥2.0 | 估 31～60 N（spec d-4） |
| S5 #26 窗頂到開口唇（光耦段／肩部） | OK | [3.62, 4.52] | ≥2.0 |  |
| S5 窗底到 #24 下緣 | OK | 18.76 | ≥2.0（否則改開底） |  |
| S5 窗到其他保留孔（#24／#26） | OK | [5.61, 5.61] | ≥2.0 |  |
| S5 C1 到轉盤圍邊 | OK | 3.09 | ≥1.0 |  |
| S5 前臂內面到 #24 前面（靜止／推到最前） | OK | [3.2, 3.7] | &gt;0 |  |
| S5 後臂內面到 #26 背面（靜止／推到最前） | OK | [0.8, 0.3] | ≥0 |  |
| S5 模組最深 W' 到 #37 內面 | OK | 19.4 | &gt;0 |  |
| S5 低位臂頂到保留條底（推入時） | OK | 1 | &gt;0 |  |
| S5 窄段下游壁（光束定位面）本體貼得到的高度 | OK | 0.7 | ≥0.4 | ＝槽底 n_sb − 肩部 n_shoulder（comp_h、slot_d、arm_top 決定）。不足時本體貼不到窄段壁，改靠 PCB 邊定位，光束沿 s 可偏 ±0.4，#26 光孔餘量（扣光窗半寬 0.5）從 0.46 降到 0.06；補救：確認實量值、改用矮零件的模組，或重新設計窗（寬段只在高零件那側開到肩部，要問使用者） |
| S5 鎖塊塞法（P1 貼 #24 正面往上抬、再往後推 3）：縫寬 − P1 厚／C1 頂到焊點底 | OK | [0.2, 0.3] | ≥0.1 | 縫＝前臂內面到 #24 前面 3.2（模組被導角帶前時更寬） |
| S5 從前方直接水平推入時，P1 凸塊和前臂底下焊腳在 n 的重疊（資訊） | OK | 1.8 | 資訊（&gt;0＝會撞，不可這樣塞） | 已把組裝說明改成「貼 #24 正面往上抬、再往後推」；焊點高 back_h ≤ g_strip 時才能直接推 |
| S5 後臂伸出立柱陰影 mm²（上游／下游，資訊） | OK | [0.29, 3.05] | 資訊 | spec d-5、R3：下游幣翻倒時可能擦到後臂頂角 |
| S5 翼侵入落幣區 mm³（資訊） | OK | {1元: 916, 5元: 0} | 資訊 | R1：試切 T3 驗收（每格 100 枚 0 卡幣） |
| S5 最終位置離滑道出口平面 | OK | 23.19 | ≥0 |  |
| S5 低位（安裝時）離出口平面（資訊） | OK | 13.98 | 資訊 |  |
| S5 #24 前方零件最大 V | OK | 83.08 | ≤97.5 |  |
| S5 模組最右 U 到 #13（S1 牆） | OK | 10.42 | &gt;0 |  |
| S5 排針＋杜邦頭在 #24 前方 | OK | True | True | 排針＋杜邦頭要在 PCB 前緣 11.5 mm 以內（Go/No-Go） |
| S5 排針到轉盤圍邊 | OK | 7.72 | &gt;0 |  |
| S5 #7 v2 切後件數 | OK | 1 | 1 |  |
| S5 #7 擋面接觸長（V） | OK | [51.5, 60.71] | &gt;2 |  |
| S5 P1 在窗內（兩側繪製間隙） | OK | True | True |  |
| S10 光束離上游開口終點（U） | OK | 3.02 | &gt;0 |  |
| S10 光束離下游開口起點（U） | OK | 3.02 | &gt;0 |  |
| S10 窗到最近分幣開口 | OK | 3.63 | ≥2.0 | 開口零改動 |
| S10 窗到斜槽（軌道） | OK | 2.3 | ≥2.0 | 軌道零改動 |
| S10 光孔到上游／下游開口 | OK | [2.12, 2.12] | ≥2.0 |  |
| S10 光孔到窗 | OK | 3 | ≥2.0 |  |
| S10 #24 保留條厚（光耦段／肩部） | OK | [2.3, 3.2] | ≥2.0 | 估 31～60 N（spec d-4） |
| S10 #26 窗頂到開口唇（光耦段／肩部） | OK | [3.63, 4.53] | ≥2.0 |  |
| S10 窗底到 #24 下緣 | OK | 7.99 | ≥2.0（否則改開底） |  |
| S10 窗到其他保留孔（#24／#26） | OK | [5.44, 5.44] | ≥2.0 |  |
| S10 C1 到轉盤圍邊 | OK | 34.59 | ≥1.0 |  |
| S10 前臂內面到 #24 前面（靜止／推到最前） | OK | [3.2, 3.7] | &gt;0 |  |
| S10 後臂內面到 #26 背面（靜止／推到最前） | OK | [0.8, 0.3] | ≥0 |  |
| S10 模組最深 W' 到 #37 內面 | OK | 19.4 | &gt;0 |  |
| S10 低位臂頂到保留條底（推入時） | OK | 1 | &gt;0 |  |
| S10 窄段下游壁（光束定位面）本體貼得到的高度 | OK | 0.7 | ≥0.4 | ＝槽底 n_sb − 肩部 n_shoulder（comp_h、slot_d、arm_top 決定）。不足時本體貼不到窄段壁，改靠 PCB 邊定位，光束沿 s 可偏 ±0.4，#26 光孔餘量（扣光窗半寬 0.5）從 0.46 降到 0.06；補救：確認實量值、改用矮零件的模組，或重新設計窗（寬段只在高零件那側開到肩部，要問使用者） |
| S10 鎖塊塞法（P1 貼 #24 正面往上抬、再往後推 3）：縫寬 − P1 厚／C1 頂到焊點底 | OK | [0.2, 0.3] | ≥0.1 | 縫＝前臂內面到 #24 前面 3.2（模組被導角帶前時更寬） |
| S10 從前方直接水平推入時，P1 凸塊和前臂底下焊腳在 n 的重疊（資訊） | OK | 1.8 | 資訊（&gt;0＝會撞，不可這樣塞） | 已把組裝說明改成「貼 #24 正面往上抬、再往後推」；焊點高 back_h ≤ g_strip 時才能直接推 |
| S10 後臂伸出立柱陰影 mm²（上游／下游，資訊） | OK | [0.24, 2.87] | 資訊 | spec d-5、R3：下游幣翻倒時可能擦到後臂頂角 |
| S10 翼侵入落幣區 mm³（資訊） | OK | {5元: 912, 10元: 0} | 資訊 | R1：試切 T3 驗收（每格 100 枚 0 卡幣） |
| S10 最終位置離滑道出口平面 | OK | 12.42 | ≥0 |  |
| S10 低位（安裝時）離出口平面（資訊） | OK | 3.21 | 資訊 |  |
| S10 #24 前方零件最大 V | OK | 93.86 | ≤97.5 |  |
| S10 模組最右 U 到 #13（S1 牆） | OK | 40.02 | &gt;0 |  |
| S10 排針＋杜邦頭在 #24 前方 | OK | True | True | 排針＋杜邦頭要在 PCB 前緣 11.5 mm 以內（Go/No-Go） |
| S10 排針到轉盤圍邊 | OK | 38.81 | &gt;0 |  |
| S10 #6 v2 切後件數 | OK | 1 | 1 |  |
| S10 #6 擋面接觸長（V） | OK | [62.3, 71.54] | &gt;2 |  |
| S10 P1 在窗內（兩側繪製間隙） | OK | True | True |  |
| S50 光束離上游開口終點（U） | OK | 3.2 | &gt;0 |  |
| S50 光束離下游開口起點（U） | OK | 3.2 | &gt;0 |  |
| S50 窗到最近分幣開口 | OK | 3.64 | ≥2.0 | 開口零改動 |
| S50 窗到斜槽（軌道） | OK | 2.3 | ≥2.0 | 軌道零改動 |
| S50 光孔到上游／下游開口 | OK | [2.3, 2.3] | ≥2.0 |  |
| S50 光孔到窗 | OK | 3 | ≥2.0 |  |
| S50 #24 保留條厚（光耦段／肩部） | OK | [2.3, 3.2] | ≥2.0 | 估 31～60 N（spec d-4） |
| S50 #26 窗頂到開口唇（光耦段／肩部） | OK | [3.63, 4.53] | ≥2.0 |  |
| S50 窗破出 #24 下緣 → 開底缺口 | OK | 開底 | 不留楔形碎片 | #24、#26 新外形＝外形.difference(窗) |
| S50 窗到其他保留孔（#24／#26） | OK | [34.43, 34.4] | ≥2.0 |  |
| S50 C1 到轉盤圍邊 | OK | 65.36 | ≥1.0 |  |
| S50 前臂內面到 #24 前面（靜止／推到最前） | OK | [3.2, 3.7] | &gt;0 |  |
| S50 後臂內面到 #26 背面（靜止／推到最前） | OK | [0.8, 0.3] | ≥0 |  |
| S50 模組最深 W' 到 #37 內面 | OK | 19.4 | &gt;0 |  |
| S50 低位臂頂到保留條底（推入時） | OK | 1 | &gt;0 |  |
| S50 窄段下游壁（光束定位面）本體貼得到的高度 | OK | 0.7 | ≥0.4 | ＝槽底 n_sb − 肩部 n_shoulder（comp_h、slot_d、arm_top 決定）。不足時本體貼不到窄段壁，改靠 PCB 邊定位，光束沿 s 可偏 ±0.4，#26 光孔餘量（扣光窗半寬 0.5）從 0.46 降到 0.06；補救：確認實量值、改用矮零件的模組，或重新設計窗（寬段只在高零件那側開到肩部，要問使用者） |
| S50 鎖塊塞法（P1 貼 #24 正面往上抬、再往後推 3）：縫寬 − P1 厚／C1 頂到焊點底 | OK | [0.2, 0.3] | ≥0.1 | 縫＝前臂內面到 #24 前面 3.2（模組被導角帶前時更寬） |
| S50 從前方直接水平推入時，P1 凸塊和前臂底下焊腳在 n 的重疊（資訊） | OK | 1.8 | 資訊（&gt;0＝會撞，不可這樣塞） | 已把組裝說明改成「貼 #24 正面往上抬、再往後推」；焊點高 back_h ≤ g_strip 時才能直接推 |
| S50 後臂伸出立柱陰影 mm²（上游／下游，資訊） | OK | [0.06, 2.14] | 資訊 | spec d-5、R3：下游幣翻倒時可能擦到後臂頂角 |
| S50 翼侵入落幣區 mm³（資訊） | OK | {10元: 895, 50元: 0} | 資訊 | R1：試切 T3 驗收（每格 100 枚 0 卡幣） |
| S50 最終位置離滑道出口平面 | OK | 0.52 | ≥0 |  |
| S50 低位（安裝時）離出口平面（資訊） | OK | -8.69 | 資訊 | &lt;0：安裝／拆換前要先抽出 10 元抽屜 |
| S50 #24 前方零件最大 V | OK | 97.5 | ≤97.5 |  |
| S50 模組最右 U 到 #13（S1 牆） | OK | 72.69 | &gt;0 |  |
| S50 排針＋杜邦頭在 #24 前方 | OK | True | True | 排針＋杜邦頭要在 PCB 前緣 11.5 mm 以內（Go/No-Go） |
| S50 排針到轉盤圍邊 | OK | 73.35 | &gt;0 |  |
| S50 #5 v2 切後件數 | OK | 1 | 1 |  |
| S50 #5 擋面接觸長（V） | OK | [74.22, 83.47] | &gt;2 |  |
| S50 P1 在窗內（兩側繪製間隙） | OK | True | True |  |
| S50 插銷孔（上游）到斜槽／外緣／窗 | OK | [10.55, 9.41, 2.05] | ≥2.0 |  |
| S50 插銷孔（下游）到斜槽／外緣／窗 | OK | [5.3, 4.83, 2.05] | ≥2.0 |  |
| S50 開底站兩側插銷孔都找到 | OK | True | True |  |
| #6 新小榫槽：到開口／其他孔、在 #26 內縮 2 內 | OK | [7.71, 4.1, True] | ≥2.0、True |  |
| 排線孔：到孔（#24／#26）、到外緣（#24／#26）、到 #13 | OK | [8.72, 8.72, 3.19, 3, 3.38] | ≥2.0、&gt;0 |  |
| 被刪榫對應的原始孔都找到（delete_cut） | OK | 5/5 | 全部 |  |
| 雕刻「5」搬移後離切割、孔、其他雕刻 | OK | 1.52 | ≥1.5 | 只用原始切割＋本模組的切割算；整合時要用最終切割（含電子盒的顯示窗、Logo 新位置）重算 |
| 雕刻「1」搬移後離切割、孔、其他雕刻 | OK | 1.52 | ≥1.5 | 只用原始切割＋本模組的切割算；整合時要用最終切割（含電子盒的顯示窗、Logo 新位置）重算 |
| #24 套用本模組修改後件數 | OK | 1 | 1 | 只含本模組；compose 會再合其他子系統 |
| #26 套用本模組修改後件數 | OK | 1 | 1 | 只含本模組；compose 會再合其他子系統 |
| #5 套用本模組修改後件數 | OK | 1 | 1 | 只含本模組；compose 會再合其他子系統 |
| #6 套用本模組修改後件數 | OK | 1 | 1 | 只含本模組；compose 會再合其他子系統 |
| #7 套用本模組修改後件數 | OK | 1 | 1 | 只含本模組；compose 會再合其他子系統 |
| #24 新切割之間最小距（S50 窗↔S50 插銷孔下游） | OK | 2.05 | ≥2.0 |  |
| #26 新切割之間最小距（S10 窗↔S10 光孔） | OK | 3 | ≥2.0 |  |
| 新零件 P1-S5：外形 1 塊、雕刻在零件內、字離切割 ≥1、離雕刻線 ≥0.4 | OK | {valid: True, bad: 0} | valid、0 | 沒有字 |
| 新零件 C1-S5：外形 1 塊、雕刻在零件內、字離切割 ≥1、離雕刻線 ≥0.4 | OK | {valid: True, bad: 0} | valid、0 | 「S5」em 2.1、離切割 1.03、離雕刻 0.43 |
| 新零件 P1-S10：外形 1 塊、雕刻在零件內、字離切割 ≥1、離雕刻線 ≥0.4 | OK | {valid: True, bad: 0} | valid、0 | 沒有字 |
| 新零件 C1-S10：外形 1 塊、雕刻在零件內、字離切割 ≥1、離雕刻線 ≥0.4 | OK | {valid: True, bad: 0} | valid、0 | 「S10」em 2.1、離切割 1.02、離雕刻 0.42 |
| 新零件 P1-S50：外形 1 塊、雕刻在零件內、字離切割 ≥1、離雕刻線 ≥0.4 | OK | {valid: True, bad: 0} | valid、0 | 沒有字 |
| 新零件 C1-S50：外形 1 塊、雕刻在零件內、字離切割 ≥1、離雕刻線 ≥0.4 | OK | {valid: True, bad: 0} | valid、0 | 「S50」em 3、離切割 1.42、離雕刻 0.82 |
| 新零件 PIN-S50：外形 1 塊、雕刻在零件內、字離切割 ≥1、離雕刻線 ≥0.4 | OK | {valid: True, bad: 0} | valid、0 | 沒有字 |

</details>

### S1 卡匣，方案 A（mods_s1）

edits 14 項、新零件 5 種、改代號 {#13: #13R}、同板群組 {#13R: S1-wall}。

**說明**

- S1 卡匣（方案 A）：#13 換成 #13R（加高成 1 元滑道右牆、開牆槽），卡匣從 #37 背面插入；光束 U118.475、V74、W'19.3→29.3。
- #13R 牆頂 V30（params.S1_WALL_TOP_V）；後榫 B1 V36～48。
- 套件裡只有 #13R（雕「13R 右」、上半截高出一大塊）和 #21（雕「21 左」），沒有 #13。#13R 若誤裝到左邊，#26／#37 沒有新槽插不進去；#21 若誤裝到右邊，沒有牆槽、卡匣插不進去。
- 講師預組（每套 1 個卡匣，建議每 10 套另做 2 個備品）：S1-B 白膠黏到 S1-C 的紅框內（後榫並排）→ 後榫插進 S1-F 的槽、上膠 → S1-P 黏在 S1-F 前面（塞進背蓋缺口內角）→ 3 片 S1-H 疊齊後黏到前臂頂面（4.5 直角邊齊前臂外面，坡往槽方向下降，不可伸進槽）→ S1-B 滑道側貼 1.0 mm 雙面泡棉膠、把模組由下往上套進去（PCB 上緣齊 S1-B 上緣、前緣齊 S1-B 前緣），驗位：後臂內面到背蓋前面 2.7±0.2 → #37 空腔側兩個 Ø3.4 孔預黏 M3 螺帽。
- 老師組裝：#13R 照原 #13 位置裝（另 2 支前榫插 #26 新槽、後榫 B1 插 #37 新槽）→ 蓋 #37 → S5～S50 照 crosstrack 從前面裝（依排線標籤把模組裝到對應的站：沿滑道從轉盤那端往下游，第 1 個感測窗 S5、第 2 個 S10、最下游開底缺口 S50；見 crosstrack「老師組裝」）→ 最後從背面把卡匣（排線貼「S1」標籤）水平推進牆槽、背蓋貼平 #37，鎖 2 支 M3×10 尼龍螺絲（手擰）。
- 沒插卡匣時不可送幣：牆槽和 #37 窗是開的，硬幣會掉進空腔或從背面掉出去。換模組：卸 2 支螺絲、卡匣往後拉出，約 1 分鐘。
- 每套另購：1.0 mm 雙面泡棉膠約 3 cm²、M3×10 尼龍螺絲 2 支、M3 螺帽 2 顆。
- 雕刻面：S1-B 朝 S1-C（−U）、S1-C 朝牆（+U，紅框＝S1-B 黏貼位置）、S1-F 朝外（「S1 ↑」朝上）、S1-P 朝背蓋；S1-H 不雕刻。所有雕刻（框線、字）都是紅色 0.2 mm 線；代號字 em 2.5～3、字墨離切割線 ≥1.0（使用者 2026-10-08）：S1-B「S1-B」em 3、S1-C「S1-C 前→」em 2.5、S1-F「S1-F」em 3、S1-P「S1-P」em 3。
- 極小零件 S1-H（3 片）、S1-P 每套多切一整份備品（S1-H×3、S1-P×1），排在同一份切割檔（parts.csv「備品」欄；使用者 2026-10-08 決定 3），掉進蜂巢台或弄丟時用。
- 電子盒 S1 禁區：U91.1～130.5 × V50.2～78.5 × W'32.0～54.9。
- #37 感測器線孔（U88～100 × V40～46）不和 S1 背蓋、B1 槽、M3 孔重疊（見 checks）。
- 模組尺寸（params.MODULE）：PCB 27.6×20×1.6、臂 7×6.4、臂高 12、槽 10×9、光束離槽底 5、背面焊點 2（暫定，待實量）。

**檢查**：67/67 通過。

<details><summary>全部 67 項檢查</summary>

| 項目 | 結果 | 值 | 期望 | 說明 |
|---|---|---|---|---|
| 光束 U 離保證覆蓋區左界 U115.876（扣光窗半寬） | OK | 2.099 | ≥1.0 | 光束 U118.475，未扣光窗 +2.60 |
| 硬幣繞軌道方向任意翻轉時（U 寬 ≥18.79）光束重疊 | OK | 1.392 | &gt;0 |  |
| 後臂內面在 #37 內面之後 | OK | 0.3 | ≥0 | 光束 V74，W'19.3→29.3 |
| S1 最前實體 W' 到 S5 最終位置＋安裝掃掠（W'≤10.0，翼 up/down/center 同） | OK | 2.3 | ≥1.5 | S5 掃掠深度取自 crosstrack_final spec |
| 越過硬幣直落線 U114.104 的凸出（只有前臂＋導流帽） | OK | 8.371 | 記錄 | 體積 507 mm³ |
| 臂尖／帽左面到 #7 | OK | 13.401 | 記錄（&lt;20 靠帽頂坡導走） | 帽頂坡 62.7° |
| PCB 元件頂、本體頂都在死區（&lt; 1 元開口右緣） | OK | 112.475／113.475 | &lt;114.104 | 牆滑道面到開口右緣 6.229 |
| 1 元以唇為軸往後翻 0～180°，第一次碰到 S1 的角度 | OK | 翻到 180° 都不碰 | &gt;90° |  |
| #13R 單一外形（W',V） | OK | Polygon，面積 4059.4（原 #13 3025.4） | Polygon |  |
| #13R 頁座標套用 edits 後：單一外形、#12 槽 3 個保留 | OK | Polygon，孔 3 個 | Polygon、3 孔 |  |
| 牆槽前料條（連接上段與下段） | OK | 11.8 | ≥8 | 長 19.40 |
| 加高上段（V30～57.5）面積 | OK | 847.8 | 有前、後各 1 榫 |  |
| 前榫 F1 槽口上緣 V50.35 在軌道 V49.25 以下 | OK | 1.099 | &gt;0（#26 槽被 #24 擋住） |  |
| 前榫 F2 槽口上緣 V67.85 在軌道 V49.25 以下 | OK | 18.599 | &gt;0（#26 槽被 #24 擋住） |  |
| 前榫長 vs #26 最薄 2.7 | OK | 2.6 | &lt;2.7 |  |
| #13R 與 #37 板厚區（V≤82.84）重疊（後榫除外） | OK | 0 | 0 | 原 #13 1.190 mm² |
| #26 槽 F1 離外框／既有孔／#24 孔 | OK | 39.17／6.09／1.03 | 外框 ≥2、既有孔 ≥2.5、#24 孔 &gt;0 | 離 #26 雕刻 3.55 |
| #26 槽 F2 離外框／既有孔／#24 孔 | OK | 23.35／9.37／0.04 | 外框 ≥2、既有孔 ≥2.5、#24 孔 &gt;0 | 離 #26 雕刻 21.05 |
| #26 槽 C 離外框／既有孔／#24 孔 | OK | 32.85／12.64／0.81 | 外框 ≥2、既有孔 ≥2.5、#24 孔 &gt;0 | 離 #26 雕刻 12.05 |
| #26 新槽彼此之間的料 | OK | 2.7 | ≥2.5 |  |
| #37 窗在 #37 內（不切斷外框） | OK | 371.5 mm² | 窗 ⊂ #37 |  |
| 窗到 #37 外框最小料（下方開口 R2 圓角處） | OK | 3.448 | ≥3.0 |  |
| 窗到 #37 既有孔 | OK | 16.277 | ≥3 |  |
| #37 後榫槽 B1 離窗／外框 | OK | 6.05／31.85 | ≥3 |  |
| #37 螺絲孔 1（U96.575 V56.2）離窗 | OK | 3.3 | ≥2.5 | 離外框 25.82 |
| #37 螺絲孔 2（U96.575 V73.5）離窗 | OK | 3.3 | ≥2.5 | 離外框 10.75 |
| 卡匣插好後窗在滑道側剩的縫 | OK | 77.7 mm² | 帽通道由 S1-P 填住 | 其中元件帶通道 34.6 mm²（在死區） |
| S1-B 座塊：單一外形、最細料 | OK | 2 | 1 塊、≥2 | 22.70×19.00 |
| S1-B 本體落在牆槽內 | OK | True | True |  |
| S1-C 比牆槽上／下多（壓在牆空腔側） | OK | 3.00／1.60 | 都 ≥1.5 |  |
| S1-F 背蓋：單一外形、最細料 | OK | 3.3 | 1 塊、≥3 | 35.30×27.30 |
| 背蓋下緣 V78 到 #13R 在 #37 後方的櫃頂邊 | OK | 1.933 | ≥1.0 |  |
| 背蓋上緣到 B1 榫尾（榫可能凸出 #37 外面 0～0.3） | OK | 2.55 | ≥1.0 |  |
| S1-H 導流帽片數 3（疊 U113.475～122.475）vs 槽深 9 | OK | 3 | ≈ 槽深/3 | 每片 15.8 mm²，頂坡 62.7° |
| S1-P 下緣到後臂頂／左緣到元件頂 | OK | 0.40／0.40 | 都 ≥0.3 |  |
| 模組在滑道內最低點到出口平面 | OK | 4.3 | ≥2 | PCB 下緣 V77.70，出口平面 V82.00 |
| #12（櫃後板）到 PCB 後端／排針／背蓋 | OK | 3.21／9.87／2.91 | ≥1.5 |  |
| TT 馬達盒右壁 U72.07 到 S1-C／螺絲孔 | OK | 29.81／22.81 | ≥10 |  |
| 右側空腔剩餘寬（馬達盒～S1-C） | OK | 29.805 | ≥25（S5～S50 排線經空腔） |  |
| crosstrack 右下排線孔到 S1-C | OK | 25.003 | &gt;0 |  |
| S1 最前點（前榫尖，在 #26 板內） | OK | -2.6 | W'&gt;-3 |  |
| #37 背面 S1 禁區右界（電子盒在 U≥134） | OK | 130.5 | ≤133.5 | U(91.1, 130.5)×V(50.2, 78.5)×W'(32.0, 54.9) |
| #37 感測器線孔（ebox，U88～100×V40～46）到 S1 背蓋／B1 槽／M3 孔／卡匣窗 | OK | 4.70／4.72／8.50／8.35 | 背蓋 ≥1（不擋線）、孔與孔 ≥2.5 |  |
| 加高牆頂 V（1 元開口右端頂緣 V31.4） | OK | 30 | ≤31.5 |  |
| 每套新增合板淨面積 | OK | 2732 | &lt;5% 張 | #13R 增加 1034、S1-B 190、S1-C 731、S1-F 687、S1-H ×3 47、S1-P 44（3.0% 張） |
| #13 雕刻「13R 右」離切割線 | OK | 8.244 | ≥1 | em 4、字寬 12.2 mm |
| #13 雕刻「S1 卡匣」離切割線 | OK | 9.101 | ≥1 | em 3、字寬 10.2 mm |
| #21 雕刻「21 左」離切割線 | OK | 3.244 | ≥1 | em 4、字寬 9.6 mm |
| #37 雕刻「S1 卡匣」離切割線 | OK | 2.26 | ≥1 | em 4、字寬 13.6 mm；離感測器線孔 10.28 |
| S1-B 雕刻「S1-B」離切割線 | OK | 1.007 | ≥1 | em 3、字寬 6.6 mm |
| S1-B 有雕代號 | OK | [S1-B] | 有 | 代號字 em 2.5～3；放不下完整代號時只刻單字母 |
| S1-C 雕刻「S1-C 前→」離切割線 | OK | 1.005 | ≥1 | em 2.5、字寬 11.3 mm；離 S1-B 黏貼框 0.41 |
| S1-C 有雕代號 | OK | [S1-C 前→] | 有 | 代號字 em 2.5～3；放不下完整代號時只刻單字母 |
| S1-F 雕刻「S1 ↑」離切割線 | OK | 2.457 | ≥1 | em 4、字寬 9.6 mm；離別的字 16.18 |
| S1-F 雕刻「S1-F」離切割線 | OK | 2.002 | ≥1 | em 3、字寬 6.3 mm；離別的字 16.18 |
| S1-F 有雕代號 | OK | [S1 ↑, S1-F] | 有 | 代號字 em 2.5～3；放不下完整代號時只刻單字母 |
| S1-P 雕刻「S1-P」離切割線 | OK | 1.021 | ≥1 | em 3、字寬 6.6 mm |
| S1-P 有雕代號 | OK | [S1-P] | 有 | 代號字 em 2.5～3；放不下完整代號時只刻單字母 |
| 光束餘量 ≥1.0（扣光窗半寬） | OK | 2.10 | 成立 |  |
| 前臂／帽前面離 S5 掃掠 ≥1.0（W'≥11） | OK | W'12.30 | 成立 |  |
| #37 窗下料條 ≥3.0（PCB 下緣＋0.4 ≤ V79） | OK | PCB 下緣 V77.70 | 成立 |  |
| 背蓋上緣不壓 B1 榫尾 | OK | 背蓋上緣 V50.70，B1 榫尾 V48.15 | 成立 |  |
| 臂尖到 #7 ≥12 | OK | 13.40 | 成立 |  |
| 槽底（本體頂）在死區（U &lt; 開口右緣 114.104） | OK | U113.475 | 成立 |  |
| Go/No-Go：槽寬 ≥8 | OK | 10 | 成立 |  |
| Go/No-Go：光耦本體靠 PCB 長邊（body_e ≤1.3） | OK | 0.5 | 成立 |  |
| Go/No-Go：元件高 ≤3.0（導流帽從槽底起） | OK | 2 | 成立 |  |

</details>

### 電子盒＋TM1637 正面窗（ebox）

edits 26 項、新零件 8 種。

**說明**

- ebox（spec：design/ebox_final/spec.md）：TM1637 裝在 #24 正面左上（PCB 右緣 U193.5、上緣 V5.50，LED 窗 U199.20～229.80 × V10.20～24.80）；電子盒掛在 #37 背面 U146.0～240.0、V4.0～76.25、W'32.25～70.0。
- Logo：方案 L2（ΔU-13.5、ΔV17.0；params.LOGO_PLAN='L2'），9 個菱形孔用 translate_cut、雕刻 path1-5-9 用 move_engrave，原位置自動補回實料。
- #5：本模組只減前上角（W'0～2.00 × V14～30.31）；crosstrack 也改 #5，合併後只剩第二小榫＋後榫，試切 T5 要確認不晃（晃 &gt;0.5 mm 就在 #5 與 #37 內面點白膠）。
- #37 感測器線孔 U88～100 × V40～46 由本模組開（crosstrack spec b-7：位置由電子盒決定）；mods_crosstrack 不應再開同一孔（重複開時 compose 取聯集，結果相同）。
- S1 禁區（mods_s1 keepout）：U91.10～130.50 × V50.20～78.50 × W'32.0～54.9（背蓋 S1-F＋模組後端／排針，每邊 +0.5，排針後方 +15 給杜邦頭與手指）。左牆下限、#37 開孔距離都已用它重查。本次資料來源：mods_s1.build() 實際結果。
- crosstrack 相關（#24 感測窗、「5」「1」新位置、#5/#6 v2 外形、#26 新槽）的檢查與 Logo 避讓，本次資料來源：mods_crosstrack.build() 實際結果。
- EB-WL：兩層掛勾穿 #37 掛勾槽 1、2；前緣排線口讓感測器線進盒；區域 a＝W−25.000、b＝V−4.000；板厚 U 146.000～149.000；雕刻面（上面）朝 −U（U 小側）。
- EB-WR：USB／DC 從服務窗插；掛勾穿 #37 掛勾槽 3、4；區域 a＝W−25.000、b＝V−4.000；板厚 U 237.000～240.000；雕刻面（上面）朝 −U（U 小側）。
- EB-B：擴展板用 4 支 M3×12 尼龍螺絲＋墊高螺帽鎖在這片；區域 a＝U−146.000、b＝V−20.750；板厚 W 35.000～38.000；雕刻面（上面）朝後（+W'，從機身背面看得到）。
- EB-T：開關卡進 9×13.5 孔；區域 a＝U−146.000、b＝W−50.000；板厚 V 4.000～7.000；雕刻面（上面）朝上（−V）。
- EB-S：區域 a＝U−172.750、b＝V−7.000；板厚 W 59.100～62.100；雕刻面（上面）朝後（+W'，從機身背面看得到）。
- EB-F：9V 電池橫躺在上面；區域 a＝U−172.750、b＝W−32.250；板厚 V 17.750～20.750；雕刻面（上面）朝上（−V）。
- EB-E：區域 a＝W−32.250、b＝V−4.000；板厚 U 172.750～175.750；雕刻面（上面）朝 −U（U 小側）。
- EB-K：兩片同形，WL、WR 各一；盒子掛好後從機身內側把舌頭往後塞進上層掛勾槽上段，盒子就抬不起來。L 形：頭比舌長出來的那端朝上，頭與舌齊平的那邊朝下（靠在勾頂上），放反會撞勾唇；區域 a＝W−25.500、b＝V−5.100；板厚 U 146.000～149.000；雕刻面（上面）朝 −U（U 小側）。
- 新零件雕刻面＝雷切上面（照區域座標不鏡像組裝時的朝向，見上）。WL、WR 外形除開孔外相同，靠雕刻代號分辨。新零件都放同板群組 'ebox'（講師預組時一起拿）。
- #37 雕刻在上面（朝機身背面）：掛勾槽旁往下箭頭、感測器線孔上方「感測器線」（angle=90，從背面看是正的）。
- 講師預組：盒體白膠（EB-E＋EB-F＋EB-S 子件 → WL＋EB-B → 放子件 → WR → EB-T）；TM1637 用 4 支 M2×8 尼龍螺絲鎖 #24（改熱熔膠時把 params.TM1637 的 use_screws 改成 False，#24 不切 M2 孔）；擴展板 4 支 M3×12＋墊高螺帽鎖 EB-B。老師：裝 #24 →線放進 #37 頂邊缺口→插 4 條感測器線（照盒端標籤：S1→G27、S5→G26、S10→G25、S50→G33）→ 掛盒（抬 6.4、推、放）→（選用）從機身內側把 EB-K 舌頭往後塞進上層掛勾槽上段（頭長出來的那端朝上）。
- 極小零件 EB-K（外包兩邊都 &lt;10 mm）每套多切一整份備品（×2），排在同一份切割檔（parts.csv「備品」欄；使用者 2026-10-08 決定 3）。所有雕刻（箭頭、字）都是紅色 0.2 mm 線；代號字墨離切割線 ≥1.0。
- 模組尺寸：TM1637 pcb 42.0×24.0、LED 塊 30.0×14.0、固定孔距（全距）38×20（params.TM1637 的 hole_dx／hole_dy 是半距 19／10）；擴展板 78.0×53.5；9V 48.5×26.5×17.5（標「暫定」者待實量，最需要先量：TM1637 固定孔距（全距）V 向 ≤20.0（hole_dy＝半距 ≤10.0）、PCB 高 ≤25.5、杜邦頭長 ≤15、電池＋電池扣 ≤61）。
- 翻倒穩定（spec e-6）、正面可視性（spec e-7）需要質量模型與眼睛位置模型，本模組不重算。

**檢查**：204/204 通過。

<details><summary>全部 204 項檢查</summary>

| 項目 | 結果 | 值 | 期望 | 說明 |
|---|---|---|---|---|
| 0 機身常數：#24／#37 頂邊 V（U≥140）＝V_TOP 4.0 | OK | 4.001／4.000 | 4.000 |  |
| 0 機身常數：#26 頂邊 V（U≥140）＝14.0 | OK | 14 | 14.00 |  |
| A 顯示器／#24：LED 窗（切穿）U×V | OK | U199.20~229.80 × V10.20~24.80（30.60×14.60） | — |  |
| A 顯示器／#24：窗上緣到 #24 頂邊 V4 料寬 | OK | 6.2 | ≥3 |  |
| A 顯示器／#24：M2 孔到 #24 頂邊 V4 料寬 | OK | 2.3 | ≥2.0 |  |
| A 顯示器／#24：M2 孔 ↔ LED 窗 料寬 | OK | 3.38 | ≥2 |  |
| A 顯示器／#24：M2 孔在 TM1637 PCB 上（孔緣到 PCB 邊，孔用 hole_d） | OK | 0.9 | ≥0.5 | 孔中心＝PCB 中心 ±(hole_dx, hole_dy)＝±(19, 10)（半距；孔距全距 38×20） |
| A 顯示器／#24：PCB 上緣 V5.50（自動）低於 #24 頂邊 V4（從正面看不到 PCB） | OK | 1.5 | ≥0.5 |  |
| A 顯示器／#24：LED 塊凸出 #24 正面 | OK | 4.2 | &gt;0.5（不被窗緣遮） |  |
| A 顯示器／#24：LED 窗在 PCB 範圍內（PCB 能壓住 #24 背面） | OK | 1 | 窗 ⊂ PCB 內縮 1.5 |  |
| A 顯示器／#24：窗／螺絲頭 ↔ 雕刻 「50」 | OK | 15.74 | ≥2.0 |  |
| A 顯示器／#24：窗／螺絲頭 ↔ 雕刻 「10」 | OK | 2.41 | ≥2.0 |  |
| A 顯示器／#24：窗／螺絲頭 ↔ 雕刻 「5」(crosstrack 新位) | OK | 34.97 | ≥2.0 |  |
| A 顯示器／#24：窗／螺絲頭 ↔ 雕刻 「1」(crosstrack 新位) | OK | 84.16 | ≥2.0 |  |
| A 顯示器／#24：窗／螺絲頭 ↔ #24 斜槽 | OK | 18.47 | ≥8 |  |
| A 顯示器／#24：窗／螺絲頭 ↔ crosstrack #24 感測窗 | OK | 51.61 | ≥3 | 來源：mods_crosstrack.build() 實際結果 |
| A 顯示器／#24：窗／螺絲頭 ↔ #24 其他既有孔 | OK | 54.69 | ≥3 |  |
| A 顯示器／#24：原 Logo 與新窗重疊（&gt;0 表示 Logo 必須搬） | OK | 188.92 | — |  |
| A 顯示器／#24：Logo 新位置（L2）ΔU-13.5、ΔV17.0 外包 | OK | U199.17~217.46 × V28.18~45.62 | — |  |
| A 顯示器／#24：Logo L2 ↔ 窗／螺絲頭／雕刻(含 crosstrack 新「5」「1」)／斜槽／感測窗／轉盤區 | OK | 3.38 | ≥3 |  |
| A 顯示器／#24：Logo L2 菱形孔背後是否露出 #26 缺口／顯示器線 | OK | 0 | =0 |  |
| A 顯示器／#24：Logo L2 菱形孔 ↔ #24 其他既有孔 | OK | 41.61 | ≥2 |  |
| A 顯示器／#24：Logo L2 在 #24 外框內縮 3 | OK | 1 | True |  |
| A 顯示器／#24：（另一方案 L1 ΔU-50.5、ΔV7.0）最小距／露出 | OK | 3.50／0.00 | 參考（備案） | 備案也可用 |
| A 顯示器／#24：#24 v2 仍是 1 塊 | OK | 1 | =1 |  |
| A 顯示器／#24：#24 新切割 LED 窗：到外框／到其他孔（含其他新切割、斜槽） | OK | 6.20／3.38 | ≥2.0／≥2.0 |  |
| A 顯示器／#24：#24 新切割 M2 孔1：到外框／到其他孔（含其他新切割、斜槽） | OK | 2.30／3.38 | ≥2.0／≥2.0 |  |
| A 顯示器／#24：#24 新切割 M2 孔2：到外框／到其他孔（含其他新切割、斜槽） | OK | 22.30／3.38 | ≥2.0／≥2.0 |  |
| A 顯示器／#24：#24 新切割 M2 孔3：到外框／到其他孔（含其他新切割、斜槽） | OK | 2.30／3.38 | ≥2.0／≥2.0 |  |
| A 顯示器／#24：#24 新切割 M2 孔4：到外框／到其他孔（含其他新切割、斜槽） | OK | 8.64／3.38 | ≥2.0／≥2.0 |  |
| A 顯示器／#24：#24 新切割 Logo 新孔（9 個）：到外框／到其他孔（含其他新切割、斜槽） | OK | 27.34／6.54 | ≥2.0／≥2.0 |  |
| B #26 缺口：缺口 A（PCB） | OK | U192.69~236.31 × V14~30.31 | — |  |
| B #26 缺口：缺口 B（彎針＋杜邦頭＋上升線） | OK | U172.50~192.70 × V14~23.08 | — |  |
| B #26 缺口：缺口 ↔ 1 元開口 | OK | 41.23 | ≥10 |  |
| B #26 缺口：缺口 ↔ 5 元開口 | OK | 24.53 | ≥10 |  |
| B #26 缺口：缺口 ↔ 10 元開口 | OK | 20.68 | ≥10 |  |
| B #26 缺口：缺口 ↔ 50 元開口 | OK | 21.87 | ≥10 |  |
| B #26 缺口：缺口 ↔ #24 斜槽投影（硬幣靠背區） | OK | 16.66 | ≥8 |  |
| B #26 缺口：缺口吃掉的 #26 原有槽 | OK | U198.4~201.3 V17.0~26.9 | 只能是 #5 上小榫槽 |  |
| B #26 缺口：缺口 ↔ #26 槽 U165.7~168.6 V17.0~26.9 | OK | 3.93 | ≥2.5 |  |
| B #26 缺口：缺口 ↔ #26 槽 U198.4~201.3 V35.0~44.9 | OK | 4.74 | ≥2.5 |  |
| B #26 缺口：缺口 ↔ crosstrack #26 新切割「#6 新小榫槽」 | OK | 8.88 | ≥2.5 | 來源：mods_crosstrack.build() 實際結果 |
| B #26 缺口：缺口 ↔ #26 左緣 U243 | OK | 6.69 | ≥3 |  |
| B #26 缺口：#26 v2 仍是 1 塊 | OK | 1 | =1 |  |
| B #26 缺口：缺口底到 10 元開口頂（#26 保留料高） | OK | 14.63 | ≥10 |  |
| B #26 缺口：缺口底到 50 元開口頂（#26 保留料高） | OK | 21.87 | ≥10 |  |
| C #5（crosstrack v2 ＋ 前上角讓位）：前上角減除 (W',V) | OK | W'0~2.00 × V14~30.31（局部 x≤8.00、y≤16.31） | — |  |
| C #5（crosstrack v2 ＋ 前上角讓位）：#5 v2 合併後件數 | OK | 1 | =1 | crosstrack #5 v2 外形來源：mods_crosstrack.build() 實際結果 |
| C #5（crosstrack v2 ＋ 前上角讓位）：#5 v2 最小料寬（近似） | OK | 6 | ≥2 |  |
| C #5（crosstrack v2 ＋ 前上角讓位）：剩下的定位榫 | OK | 上小榫 V17~27：刪除；第二小榫 V35~45：保留；後榫 V40~56：保留 | 至少前 1＋後 1 | crosstrack 刪長榫；本修改再刪上小榫 → 只剩第二小榫＋後榫（夾在 #26/#37 之間不會掉） |
| D 顯示器零件 ↔ 結構：PCB ↔ #26 v2 | OK | 0.81 | ≥0.49 |  |
| D 顯示器零件 ↔ 結構：PCB ↔ #5 v2 | OK | 1.62 | ≥0.5 |  |
| D 顯示器零件 ↔ 結構：背面零件 ↔ #26 v2 | OK | 1.81 | ≥0.49 |  |
| D 顯示器零件 ↔ 結構：背面零件 ↔ #5 v2 | OK | 0.8 | ≥0.5 |  |
| D 顯示器零件 ↔ 結構：排針座 ↔ #26 v2 | OK | 0.95 | ≥0.49 |  |
| D 顯示器零件 ↔ 結構：排針座 ↔ #5 v2 | OK | 2.54 | ≥0.5 |  |
| D 顯示器零件 ↔ 結構：杜邦頭 ↔ #26 v2 | OK | 0.5 | ≥0.49 |  |
| D 顯示器零件 ↔ 結構：杜邦頭 ↔ #5 v2 | OK | 5.94 | ≥0.5 |  |
| D 顯示器零件 ↔ 結構：杜邦頭 ↔ #6 v2 | OK | 9.87 | ≥0.5 |  |
| D 顯示器零件 ↔ 結構：外露針 ↔ #26 v2 | OK | 5.26 | ≥0.49 |  |
| D 顯示器零件 ↔ 結構：外露針 ↔ #5 v2 | OK | 5.2 | ≥0.5 |  |
| D 顯示器零件 ↔ 結構：線：上升段 ↔ #26 v2 | OK | 0.5 | ≥0.49 |  |
| D 顯示器零件 ↔ 結構：線：上升段 ↔ #6 v2 | OK | 4.37 | ≥0.5 |  |
| D 顯示器零件 ↔ 結構：線：#24 背面水平段 ↔ #26 v2 | OK | 4.5 | ≥0.49 |  |
| D 顯示器零件 ↔ 結構：線：#24 背面水平段 ↔ #6 v2 | OK | 4.71 | ≥0.5 |  |
| D 顯示器零件 ↔ 結構：M2 螺帽1 ↔ #5 v2 | OK | 4.6 | ≥0.5 |  |
| D 顯示器零件 ↔ 結構：M2 螺絲尖1 ↔ #5 v2 | OK | 5.81 | ≥0.5 |  |
| D 顯示器零件 ↔ 結構：M2 螺帽2 ↔ #26 v2 | OK | 0.5 | ≥0.49 |  |
| D 顯示器零件 ↔ 結構：M2 螺帽2 ↔ #5 v2 | OK | 0.76 | ≥0.5 |  |
| D 顯示器零件 ↔ 結構：M2 螺絲尖2 ↔ #26 v2 | OK | 1.82 | ≥0.49 |  |
| D 顯示器零件 ↔ 結構：M2 螺絲尖2 ↔ #5 v2 | OK | 1.88 | ≥0.5 |  |
| D 顯示器零件 ↔ 結構：M2 螺帽3 ↔ #26 v2 | OK | 4.22 | ≥0.49 |  |
| D 顯示器零件 ↔ 結構：M2 螺絲尖3 ↔ #26 v2 | OK | 5.79 | ≥0.49 |  |
| D 顯示器零件 ↔ 結構：M2 螺帽4 ↔ #26 v2 | OK | 0.5 | ≥0.49 |  |
| D 顯示器零件 ↔ 結構：M2 螺絲尖4 ↔ #26 v2 | OK | 1.82 | ≥0.49 |  |
| D 顯示器零件 ↔ 結構：LED 塊 ↔ #24 v2 窗邊 | OK | 0.3 | ≈C_WIN 0.3 |  |
| D 顯示器零件 ↔ 結構：PCB ↔ #24 v2（貼合） | OK | 0 | =0（PCB 正面貼 #24 背面） |  |
| D 顯示器零件 ↔ 結構：若 #26 不開缺口會撞到的部位 | OK | PCB、LED 塊、背面零件、排針座、杜邦頭、外露針、線：上升段、M2 螺帽2、M2 螺帽4 | 證明缺口必要 |  |
| E 硬幣路徑：顯示器／螺絲／顯示器線 ↔ 斜槽滾動區（#24 板厚內） | OK | 17.3 | ≥8.0 | 最近：線：上升段 |
| E 硬幣路徑：顯示器／螺絲／顯示器線 ↔ 1 元開口（#26 板厚內） | OK | 41.88 | ≥8.0 | 最近：線：上升段 |
| E 硬幣路徑：顯示器／螺絲／顯示器線 ↔ 1 元翻倒掃掠（開口×W'0~D） | OK | 39.17 | ≥10.0 | 最近：顯示器 4P（G14/G13/V/G） 第6段 |
| E 硬幣路徑：顯示器／螺絲／顯示器線 ↔ 1 元滑道落下區（保守：V≥開口頂 30.6 整個深度） | OK | 32.8 | ≥10.0 | 最近：顯示器 4P（G14/G13/V/G） 第6段 |
| E 硬幣路徑：顯示器／螺絲／顯示器線 ↔ 5 元開口（#26 板厚內） | OK | 25.2 | ≥8.0 | 最近：線：上升段 |
| E 硬幣路徑：顯示器／螺絲／顯示器線 ↔ 5 元翻倒掃掠（開口×W'0~D） | OK | 25.2 | ≥10.0 | 最近：線：上升段 |
| E 硬幣路徑：顯示器／螺絲／顯示器線 ↔ 5 元滑道落下區（保守：V≥開口頂 38.2 整個深度） | OK | 17.31 | ≥10.0 | 最近：線：上升段 |
| E 硬幣路徑：顯示器／螺絲／顯示器線 ↔ 10 元開口（#26 板厚內） | OK | 21.32 | ≥8.0 | 最近：M2 螺帽2 |
| E 硬幣路徑：顯示器／螺絲／顯示器線 ↔ 10 元翻倒掃掠（開口×W'0~D） | OK | 21.32 | ≥10.0 | 最近：M2 螺帽2 |
| E 硬幣路徑：顯示器／螺絲／顯示器線 ↔ 10 元滑道落下區（保守：V≥開口頂 44.9 整個深度） | OK | 15.13 | ≥10.0 | 最近：M2 螺帽2 |
| E 硬幣路徑：顯示器／螺絲／顯示器線 ↔ 50 元開口（#26 板厚內） | OK | 22.68 | ≥8.0 | 最近：PCB |
| E 硬幣路徑：顯示器／螺絲／顯示器線 ↔ 50 元翻倒掃掠（開口×W'0~D） | OK | 22.72 | ≥10.0 | 最近：PCB |
| E 硬幣路徑：顯示器／螺絲／顯示器線 ↔ 50 元滑道落下區（保守：V≥開口頂 52.2 整個深度） | OK | 22.37 | ≥10.0 | 最近：M2 螺帽4 |
| E 硬幣路徑：WL 勾唇 V13.5~25.5（U146~149）↔ 翻倒弧＋落下（分片） | OK | 20.08 | ≥8 | 5 元翻倒弧＋落下（U145~147） |
| E 硬幣路徑：WL 勾唇 V13.5~25.5 ↔ 保守落下區（開口頂以下整個深度） | OK | 11.34 | 參考 |  |
| E 硬幣路徑：WL 勾唇 V29.0~41.0（U146~149）↔ 翻倒弧＋落下（分片） | OK | 9.31 | ≥8 | 5 元翻倒弧＋落下（U145~147） |
| E 硬幣路徑：WL 勾唇 V29.0~41.0 ↔ 保守落下區（開口頂以下整個深度） | OK | 0 | 參考 |  |
| E 硬幣路徑：WR 勾唇 V13.5~25.5（U237~240）↔ 翻倒弧＋落下（分片） | OK | 38.32 | ≥8 | 50 元翻倒弧＋落下（U223~225） |
| E 硬幣路徑：WR 勾唇 V13.5~25.5 ↔ 保守落下區（開口頂以下整個深度） | OK | 26.68 | 參考 |  |
| E 硬幣路徑：WR 勾唇 V29.0~41.0（U237~240）↔ 翻倒弧＋落下（分片） | OK | 25.23 | ≥8 | 50 元翻倒弧＋落下（U227~229） |
| E 硬幣路徑：WR 勾唇 V29.0~41.0 ↔ 保守落下區（開口頂以下整個深度） | OK | 11.18 | 參考 |  |
| E 硬幣路徑：防拔鍵頭（WL）（U146~149）↔ 翻倒弧＋落下（分片） | OK | 28.58 | ≥8 | 1 元翻倒弧＋落下（U134~136） |
| E 硬幣路徑：防拔鍵頭（WL） ↔ 保守落下區（開口頂以下整個深度） | OK | 19.96 | 參考 |  |
| E 硬幣路徑：防拔鍵頭（WR）（U237~240）↔ 翻倒弧＋落下（分片） | OK | 44.54 | ≥8 | 50 元翻倒弧＋落下（U223~225） |
| E 硬幣路徑：防拔鍵頭（WR） ↔ 保守落下區（開口頂以下整個深度） | OK | 38.78 | 參考 |  |
| E 硬幣路徑：S5 3P（→G26）：右側空腔內上升段 ↔ #26 背後的硬幣區（翻倒／落下） | OK | 10.38 | ≥8 | 空腔 U72.1~104.9 在 1 元滑道右牆外側；路徑前段照 crosstrack 名目 |
| E 硬幣路徑：S5 3P（→G26）：#37 背面段的最小 W'（&gt;32＝在 #37 外面，被 #37 隔開） | OK | 33.2 | &gt;32 |  |
| E 硬幣路徑：S10 3P（→G25）：右側空腔內上升段 ↔ #26 背後的硬幣區（翻倒／落下） | OK | 10.38 | ≥8 | 空腔 U72.1~104.9 在 1 元滑道右牆外側；路徑前段照 crosstrack 名目 |
| E 硬幣路徑：S10 3P（→G25）：#37 背面段的最小 W'（&gt;32＝在 #37 外面，被 #37 隔開） | OK | 33.2 | &gt;32 |  |
| E 硬幣路徑：S50 3P（→G33）：右側空腔內上升段 ↔ #26 背後的硬幣區（翻倒／落下） | OK | 10.38 | ≥8 | 空腔 U72.1~104.9 在 1 元滑道右牆外側；路徑前段照 crosstrack 名目 |
| E 硬幣路徑：S50 3P（→G33）：#37 背面段的最小 W'（&gt;32＝在 #37 外面，被 #37 隔開） | OK | 33.2 | &gt;32 |  |
| E 硬幣路徑：S1 3P（→G27）：全程最小 W'（&gt;32＝在 #37 外面，與所有硬幣區之間隔著 #37） | OK | 34 | &gt;32 |  |
| E 硬幣路徑：電池扣→開關→DC 插頭：全程最小 W'（&gt;32＝在 #37 外面，與所有硬幣區之間隔著 #37） | OK | 40 | &gt;32 |  |
| F #37 修改：掛勾槽 1 U145.80~149.20 V6.90~19.70：到外框／既有孔／其他新切割 | OK | 2.90／21.72／2.70 | ≥2.5／≥2.5／≥2.5 |  |
| F #37 修改：掛勾槽 2 U145.80~149.20 V22.40~35.20：到外框／既有孔／其他新切割 | OK | 18.40／8.63／2.70 | ≥2.5／≥2.5／≥2.5 |  |
| F #37 修改：掛勾槽 3 U236.80~240.20 V6.90~19.70：到外框／既有孔／其他新切割 | OK | 2.80／41.05／2.70 | ≥2.5／≥2.5／≥2.5 |  |
| F #37 修改：掛勾槽 4 U236.80~240.20 V22.40~35.20：到外框／既有孔／其他新切割 | OK | 2.80／35.86／2.70 | ≥2.5／≥2.5／≥2.5 |  |
| F #37 修改：頂邊顯示器線缺口 U164.75~171.25 V4.00~8.50：到外框／既有孔／其他新切割 | OK | 71.75／31.82／15.55 | ≥2.5／≥2.5／≥2.5 |  |
| F #37 修改：感測器線孔 U88.00~100.00 V40.00~46.00：到外框／既有孔／其他新切割 | OK | 36.00／20.89／46.05 | ≥2.5／≥2.5／≥2.5 |  |
| F #37 修改：掛勾槽 1 ↔ S1 在 #37 的開孔（最近） | OK | 41.08 | ≥2.0 | S1 #37 槽 B1（#13R 後榫；U104.725～108.025 × V35.85～48.15）；來源：mods_s1.build() 實際結果 |
| F #37 修改：掛勾槽 2 ↔ S1 在 #37 的開孔（最近） | OK | 37.78 | ≥2.0 | S1 #37 槽 B1（#13R 後榫；U104.725～108.025 × V35.85～48.15）；來源：mods_s1.build() 實際結果 |
| F #37 修改：掛勾槽 3 ↔ S1 在 #37 的開孔（最近） | OK | 122.94 | ≥2.0 | S1 #37 卡匣窗（U101.575～122.875 × V54.2～78.8，371.5 mm²）；來源：mods_s1.build() 實際結果 |
| F #37 修改：掛勾槽 4 ↔ S1 在 #37 的開孔（最近） | OK | 117.99 | ≥2.0 | S1 #37 卡匣窗（U101.575～122.875 × V54.2～78.8，371.5 mm²）；來源：mods_s1.build() 實際結果 |
| F #37 修改：頂邊顯示器線缺口 ↔ S1 在 #37 的開孔（最近） | OK | 62.97 | ≥2.0 | S1 #37 槽 B1（#13R 後榫；U104.725～108.025 × V35.85～48.15）；來源：mods_s1.build() 實際結果 |
| F #37 修改：感測器線孔 ↔ S1 在 #37 的開孔（最近） | OK | 4.72 | ≥2.0 | S1 #37 槽 B1（#13R 後榫；U104.725～108.025 × V35.85～48.15）；來源：mods_s1.build() 實際結果 |
| F #37 修改：感測器線孔 ↔ S1 禁區（背蓋 S1-F／模組後端，U,V 投影） | OK | 4.2 | ≥2.0 |  |
| F #37 修改：新切割 ↔ 原馬達開關（參考位置） | OK | 40.06 | — |  |
| F #37 修改：#37 v2 仍是 1 塊 | OK | 1 | =1 |  |
| F #37 修改：掛勾槽 ↔ 3 片隔板後榫槽（V40.3~56.2）最近 | OK | 8.63 | ≥2.5 |  |
| F #37 修改：選用雕刻 箭頭（左牆） ↔ 切割／S1 雕刻／外框 | OK | 1.40／30.95／4.10 | ≥1／≥1／≥1 |  |
| F #37 修改：選用雕刻 箭頭（右牆） ↔ 切割／S1 雕刻／外框 | OK | 1.40／110.67／4.10 | ≥1／≥1／≥1 |  |
| F #37 修改：選用雕刻 「感測器線」 ↔ 切割／S1 雕刻／外框 | OK | 1.25／11.64／31.45 | ≥1／≥1／≥1 |  |
| G 電子盒 ↔ 機身：盒體（7 片）↔ #12 抽屜櫃後板 | OK | 4.66 | ≥1.0 |  |
| G 電子盒 ↔ 機身：盒體（7 片）↔ #21 左櫃側板 | OK | 3.25 | ≥1.0 |  |
| G 電子盒 ↔ 機身：盒體（7 片）↔ #36 左端板 | OK | 3 | ≥1.0 |  |
| G 電子盒 ↔ 機身：盒體（7 片）↔ #13（右櫃側板原形） | OK | 38.26 | ≥1.0 |  |
| G 電子盒 ↔ 機身：盒體（7 片）↔ S1 禁區（s1wall_final 實際範圍） | OK | 15.5 | ≥1.0 | S1 禁區 U91.10~130.50 × V50.20~78.50 × W'32.00~54.90；來源：mods_s1.build() 實際結果 |
| G 電子盒 ↔ 機身：盒體（7 片）↔ 原馬達開關（含背面本體 20 mm） | OK | 90.25 | ≥1.0 |  |
| G 電子盒 ↔ 機身：盒體（7 片）↔ #37 v2 | OK | 0.15 | ≥0.15 |  |
| G 電子盒 ↔ 機身：左牆 U146.00 ↔ 下限（S1 禁區右界 +1＝U131.50） | OK | 14.5 | ≥0 |  |
| G 電子盒 ↔ 機身：勾唇後面 ↔ #37 內面（W'29） | OK | 0.15 | 0.1~0.3（扣住） |  |
| G 電子盒 ↔ 機身：牆前緣 ↔ #37 外面 | OK | 0.25 | 0.25 |  |
| G 電子盒 ↔ 機身：M3 螺帽1（底板前） ↔ #37 | OK | 0.6 | ≥0.2 |  |
| G 電子盒 ↔ 機身：M3 螺絲尖1 ↔ #37 | OK | 0.4 | ≥0.2 |  |
| G 電子盒 ↔ 機身：M3 螺帽2（底板前） ↔ #37 | OK | 0.6 | ≥0.2 |  |
| G 電子盒 ↔ 機身：M3 螺絲尖2 ↔ #37 | OK | 0.4 | ≥0.2 |  |
| G 電子盒 ↔ 機身：M3 螺帽3（底板前） ↔ #37 | OK | 0.6 | ≥0.2 |  |
| G 電子盒 ↔ 機身：M3 螺絲尖3 ↔ #37 | OK | 0.4 | ≥0.2 |  |
| G 電子盒 ↔ 機身：M3 螺帽4（底板前） ↔ #37 | OK | 0.6 | ≥0.2 |  |
| G 電子盒 ↔ 機身：M3 螺絲尖4 ↔ #37 | OK | 0.4 | ≥0.2 |  |
| G 電子盒 ↔ 機身：底板 EB-B 前面 ↔ 3 支隔板後榫尖（W'32） | OK | 3 | ≥2.5 |  |
| G 電子盒 ↔ 機身：安裝掃掠（抬 6.4 → 往前推 15 → 放下）↔ #37 v2 最小距 | OK | 0.15 | ≥0.15 |  |
| G 電子盒 ↔ 機身：兩層掛勾層距（盒子不能繞 U 軸轉出、不能直接拔） | OK | 15.5 | ≥15 |  |
| G 電子盒 ↔ 機身：兩面掛勾牆間距（U） | OK | 91 | — |  |
| G 電子盒 ↔ 機身：EB-K ↔ 同側牆勾頸／勾唇、#37（盒子名目／下滑 C_HOOK；鍵在槽上段上下兩端；沿 +W' 塞入 8 mm 掃掠）板面交集 | OK | 0 | =0（塞得進） | spec c-3 原本頭到 V15.0，和勾唇重疊 1.5 mm；已改成頭、舌下緣齊在勾頂上 0.1 |
| G 電子盒 ↔ 機身：EB-K 舌頭 V7.20~13.40（高 6.20）放進上層槽上段 V6.90~13.50 的上下餘量（盒子名目／下滑） | OK | 0.40／0.60 | ≥0 |  |
| G 電子盒 ↔ 機身：EB-K 頭頂高出槽頂（頭壓在 #37 內面，鍵不會穿過槽） | OK | 1.8 | ≥1.0 |  |
| H 盒內：9V 電池 ↔ EB-F 電池架 | OK | 0.25 | ≥0.2 |  |
| H 盒內：9V 電池 ↔ EB-S 電池後擋 | OK | 0.3 | ≥0.25 |  |
| H 盒內：9V 電池 ↔ EB-WR 右牆 | OK | 0.25 | ≥0.2 |  |
| H 盒內：9V 電池 ↔ EB-T 頂板 | OK | 0.3 | ≥0.25 |  |
| H 盒內：9V 電池 ↔ EB-E 電池端擋 | OK | 12.5 | ≥5.0 |  |
| H 盒內：電池扣（含線彎） ↔ EB-E 電池端擋 | OK | 0.25 | ≥0.2 |  |
| H 盒內：擴展板 PCB ↔ EB-WR 右牆 | OK | 0.5 | ≥0.4 |  |
| H 盒內：擴展板 PCB ↔ EB-WL 左牆 | OK | 9.5 | ≥5.0 |  |
| H 盒內：擴展板 PCB ↔ EB-F 電池架 | OK | 1 | ≥0.4 |  |
| H 盒內：開關本體 ↔ EB-WL 左牆 | OK | 2 | ≥1.0 |  |
| H 盒內：開關本體 ↔ EB-E 電池端擋 | OK | 10.75 | ≥2.0 |  |
| H 盒內：用到的 GVS 列＋杜邦頭＋彎線（下） ↔ EB-WL 左牆 | OK | 33.5 | ≥2.0 |  |
| H 盒內：用到的 GVS 列＋杜邦頭＋彎線（下） ↔ EB-WR 右牆 | OK | 4.78 | ≥1.0 |  |
| H 盒內：ESP32 開發板＋母座 ↔ EB-F 電池架 | OK | 13.75 | ≥2.0 |  |
| H 盒內：未用排針列（上） ↔ EB-F 電池架 | OK | 3.19 | ≥1.0 |  |
| H 盒內：DC 座 ↔ EB-WR 右牆 | OK | 0.71 | ≥0.4 |  |
| H 盒內：開關本體 ↔ 擴展板 PCB | OK | 8.13 | ≥2.0 |  |
| H 盒內：開關本體 ↔ 未用排針列（上） | OK | 20.71 | ≥1.0 |  |
| H 盒內：開關本體 ↔ ESP32 開發板＋母座 | OK | 22.1 | ≥2.0 |  |
| H 盒內：9V 電池 ↔ 擴展板 PCB | OK | 4.25 | ≥2.0 |  |
| H 盒內：9V 電池 ↔ 開關本體 | OK | 26.25 | ≥2.0 |  |
| H 盒內：電池扣（含線彎） ↔ 開關本體 | OK | 14 | ≥2.0 |  |
| H 盒內：電池帶：電池頂凸出盒頂（捏得到） | OK | 4 | ≥3 |  |
| H 盒內：GVS 杜邦頭＋彎線最後端 W' ↔ 盒後緣 | OK | 3.6 | ≥2 |  |
| H 盒內：電池往上拔出 30 mm 的掃掠 ↔ 盒體（不含下面的電池架） | OK | 0.25 | ≥0.2 |  |
| H 盒內：電池拔出掃掠 ↔ #37 | OK | 0.3 | ≥0.2 |  |
| H 盒內：USB 插頭 ↔ 右牆（穿過服務窗） | OK | 1 | ≥0.5 |  |
| H 盒內：USB 插頭（伸出機身外）↔ #36 端板 | OK | 17.79 | ≥3 |  |
| H 盒內：DC 插頭（直頭 40） ↔ 右牆（穿過服務窗） | OK | 1 | ≥0.5 |  |
| H 盒內：DC 插頭（直頭 40）（伸出機身外）↔ #36 端板 | OK | 10.89 | ≥3 |  |
| H 盒內：EN/BOOT 鍵 1（U230.5,V40.0）手指通道 ↔ 盒體／線 | OK | 1.50／13.05 | &gt;0（盒子背面不加蓋） |  |
| H 盒內：EN/BOOT 鍵 2（U230.5,V57.0）手指通道 ↔ 盒體／線 | OK | 1.50／15.44 | &gt;0（盒子背面不加蓋） |  |
| H 盒內：EB-WL 左牆 件數／最小料寬（近似） | OK | 1／2.7 | =1／≥2 |  |
| H 盒內：EB-WR 右牆 件數／最小料寬（近似） | OK | 1／2.4 | =1／≥2 |  |
| H 盒內：EB-B 主板底板 件數／最小料寬（近似） | OK | 1／2.4 | =1／≥2 |  |
| H 盒內：EB-T 頂板 件數／最小料寬（近似） | OK | 1／2.9 | =1／≥2 |  |
| H 盒內：EB-S 電池後擋 件數／最小料寬（近似） | OK | 1／6.0 | =1／≥2 |  |
| H 盒內：EB-F 電池架 件數／最小料寬（近似） | OK | 1／4.2 | =1／≥2 |  |
| H 盒內：EB-E 電池端擋 件數／最小料寬（近似） | OK | 1／2.9 | =1／≥2 |  |
| H 盒內：EB-K 防拔鍵（選用） 件數／最小料寬（近似） | OK | 1／6.0 | =1／≥2 |  |
| H 盒內：顯示器 4P（G14/G13/V/G） 路徑長 | OK | 193.5 | — |  |
| H 盒內：S5 3P（→G26） 路徑長 | OK | 314.6 | — |  |
| H 盒內：S10 3P（→G25） 路徑長 | OK | 331.09 | — |  |
| H 盒內：S50 3P（→G33） 路徑長 | OK | 349.85 | — |  |
| H 盒內：S1 3P（→G27） 路徑長 | OK | 151.28 | — |  |
| H 盒內：電池扣→開關→DC 插頭 路徑長 | OK | 157.81 | — |  |
| K 用板：電子盒合板 7 片 淨面積／外包＋2.5 間距 | OK | 14031／19092 mm²（一張 255×355 的 15.5%／21.1%） | — |  |
| K 用板：選用防拔鍵 ×2 | OK | 95 mm² | — |  |
| K 用板：顯示器側新增料 | OK | 0（#24/#26/#5/#37 只開孔） | — |  |

</details>

### 合成（compose）

沒有合成警告。

## 七、跨子系統檢查（laser_v2/integrate.py）

共 108 項：通過 103、未通過 0、資訊 5。座標：#24/#26/#37 用組裝座標 (U,V)，間隔條與櫃側板用 (W',V)（frames.py）。

- 電子盒改用 crosstrack、s1 的實際結果重跑（ebox.build(cat, others=…)，即 ebox.recheck）：檢查 204/204 通過、警告 0 則；edits 和名目 json 版相同，草稿用重跑後的結果。
- 兩個子系統在同一零件上的修改區域相交或 < 1.5 mm：沒有。

**A. #37 開孔（S1 ↔ 電子盒 ↔ 感測器線孔）**（18 項）

| 項目 | 結果 | 值 | 期望 | 說明 |
|---|---|---|---|---|
| #37 單一連通 | OK | Polygon | Polygon |  |
| #37 感測器線孔位置 | 資訊 | U88.0～100.0×V40.0～46.0 | U88～100×V40～46（交接定案） |  |
| 感測器線孔 ↔ S1 背蓋 S1-F（貼 #37 外面） | OK | 4.7 | ≥2（不被背蓋蓋住） | 背蓋 U91.6～126.9×V50.7～78.0 |
| 感測器線孔 ↔ S1 禁區（mods_s1 keepout 的 U×V 投影） | OK | 4.2 | &gt;0（不在禁區內） | 禁區 U91.1～130.5×V50.2～78.5×W'32.0～54.9 |
| 感測器線孔 ↔ s1「S1 #37 卡匣窗（U101.575～122.875 × V54.2～78.8，371.5 mm²）」 | OK | 8.35 | ≥2.5（ebox spec） |  |
| 感測器線孔 ↔ s1「S1 #37 槽 B1（#13R 後榫；U104.725～108.025 × V35.85～48.15）」 | OK | 4.725 | ≥2.5（ebox spec） |  |
| 感測器線孔 ↔ s1「S1 #37 M3 孔 Ø3.4（中心 U96.575 V56.2；空腔側預黏螺帽）」 | OK | 8.5 | ≥2.5（ebox spec） |  |
| 感測器線孔 ↔ s1「S1 #37 M3 孔 Ø3.4（中心 U96.575 V73.5；空腔側預黏螺帽）」 | OK | 25.8 | ≥2.5（ebox spec） |  |
| 感測器線孔 ↔ ebox「電子盒掛勾槽 1（左牆上層）」 | OK | 50.097 | ≥2.5（ebox spec） |  |
| 感測器線孔 ↔ ebox「電子盒掛勾槽 2（左牆下層）」 | OK | 46.051 | ≥2.5（ebox spec） |  |
| 感測器線孔 ↔ ebox「電子盒掛勾槽 3（右牆上層）」 | OK | 138.298 | ≥2.5（ebox spec） |  |
| 感測器線孔 ↔ ebox「電子盒掛勾槽 4（右牆下層）」 | OK | 136.884 | ≥2.5（ebox spec） |  |
| 感測器線孔 ↔ ebox「顯示器線頂邊 U 形缺口」 | OK | 72.006 | ≥2.5（ebox spec） |  |
| 感測器線孔 ↔ 最近的原始孔 path509-6[9] | OK | 20.888 | ≥2.5 |  |
| 感測器線孔 ↔ #37 外框 | OK | 36 | ≥2.5 |  |
| #37 上 S1 與電子盒新切割的最近距離（s1「S1 #37 槽 B1（#13R 後榫；U104.725～108.025 × V35.85～48.15）」↔ ebox「感測器線孔（S5/S10/S50 線由右側空腔穿到背面）」） | OK | 4.725 | ≥2 |  |
| #37 所有新切割之間、對原始孔與外框的最細料（ebox「電子盒掛勾槽 1（左牆上層）」↔ ebox「電子盒掛勾槽 2（左牆下層）」） | OK | 2.7 | ≥2 |  |
| 電子盒盒體 ↔ S1 禁區（U×V 投影） | OK | 15.5 | ≥1（ebox 左牆下限＝禁區右界＋1） | 盒 U146.0～240.0×V4.0～76.25 |

**B. 電子盒 S1 禁區改用 mods_s1 實際結果重查**（15 項）

| 項目 | 結果 | 值 | 期望 | 說明 |
|---|---|---|---|---|
| ebox 用的 S1 禁區＝mods_s1 實際 keepout | OK | U91.1～130.5×V50.2～78.5×W'32.0～54.9 | U91.1～130.5×V50.2～78.5×W'32.0～54.9 | 資料來源：mods_s1.build() 實際結果 |
| ebox 檢查：E 硬幣路徑：S1 3P（→G27）：全程最小 W'（&gt;32＝在 #37 外面，與所有硬幣區之間隔著 #37） | OK | 34 | &gt;32 |  |
| ebox 檢查：F #37 修改：掛勾槽 1 ↔ S1 在 #37 的開孔（最近） | OK | 41.08 | ≥2.0 | S1 #37 槽 B1（#13R 後榫；U104.725～108.025 × V35.85～48.15）；來源：mods_s1.build() 實際結果 |
| ebox 檢查：F #37 修改：掛勾槽 2 ↔ S1 在 #37 的開孔（最近） | OK | 37.78 | ≥2.0 | S1 #37 槽 B1（#13R 後榫；U104.725～108.025 × V35.85～48.15）；來源：mods_s1.build() 實際結果 |
| ebox 檢查：F #37 修改：掛勾槽 3 ↔ S1 在 #37 的開孔（最近） | OK | 122.94 | ≥2.0 | S1 #37 卡匣窗（U101.575～122.875 × V54.2～78.8，371.5 mm²）；來源：mods_s1.build() 實際結果 |
| ebox 檢查：F #37 修改：掛勾槽 4 ↔ S1 在 #37 的開孔（最近） | OK | 117.99 | ≥2.0 | S1 #37 卡匣窗（U101.575～122.875 × V54.2～78.8，371.5 mm²）；來源：mods_s1.build() 實際結果 |
| ebox 檢查：F #37 修改：頂邊顯示器線缺口 ↔ S1 在 #37 的開孔（最近） | OK | 62.97 | ≥2.0 | S1 #37 槽 B1（#13R 後榫；U104.725～108.025 × V35.85～48.15）；來源：mods_s1.build() 實際結果 |
| ebox 檢查：F #37 修改：感測器線孔 ↔ S1 在 #37 的開孔（最近） | OK | 4.72 | ≥2.0 | S1 #37 槽 B1（#13R 後榫；U104.725～108.025 × V35.85～48.15）；來源：mods_s1.build() 實際結果 |
| ebox 檢查：F #37 修改：感測器線孔 ↔ S1 禁區（背蓋 S1-F／模組後端，U,V 投影） | OK | 4.2 | ≥2.0 |  |
| ebox 檢查：F #37 修改：選用雕刻 箭頭（左牆） ↔ 切割／S1 雕刻／外框 | OK | 1.40／30.95／4.10 | ≥1／≥1／≥1 |  |
| ebox 檢查：F #37 修改：選用雕刻 箭頭（右牆） ↔ 切割／S1 雕刻／外框 | OK | 1.40／110.67／4.10 | ≥1／≥1／≥1 |  |
| ebox 檢查：F #37 修改：選用雕刻 「感測器線」 ↔ 切割／S1 雕刻／外框 | OK | 1.25／11.64／31.45 | ≥1／≥1／≥1 |  |
| ebox 檢查：G 電子盒 ↔ 機身：盒體（7 片）↔ S1 禁區（s1wall_final 實際範圍） | OK | 15.5 | ≥1.0 | S1 禁區 U91.10~130.50 × V50.20~78.50 × W'32.00~54.90；來源：mods_s1.build() 實際結果 |
| ebox 檢查：G 電子盒 ↔ 機身：左牆 U146.00 ↔ 下限（S1 禁區右界 +1＝U131.50） | OK | 14.5 | ≥0 |  |
| ebox 全部檢查（用實際結果重算） | OK | 204/204 | 全過 |  |

**C. #5（crosstrack ＋ 電子盒）**（7 項）

| 項目 | 結果 | 值 | 期望 | 說明 |
|---|---|---|---|---|
| #5 單一連通 | OK | Polygon | Polygon |  |
| #5 套用的子系統 | OK | crosstrack、ebox | crosstrack、ebox |  |
| #5 前榫（穿 #26，W'−1.5 截面 V 範圍） | OK | V35.00～45.00 | ≥1 支（spec：只剩第二小榫） | 原始：V17.00～27.00；V35.00～45.00；V84.45～92.45 |
| #5 長榫（穿到 #24）已刪 | OK | 0 | 0（S50 開底缺口） |  |
| #5 後榫（插 #37） | OK | V40.00～56.00 | 1 支 |  |
| #5 最小料寬（負緩衝切斷寬度） | OK | 6 | ≥2 | 原始 #5：6.0 |
| #5 crosstrack 缺口 ↔ 電子盒前上角 | OK | 43.914 | ≥2 | crosstrack W'-6.0～10.0×V74.2～98.0；ebox W'-3.0～2.0×V14.0～30.3；剩餘面積 2061／原 2358 mm² |

**D. #26（三個子系統＋齒孔修正）**（8 項）

| 項目 | 結果 | 值 | 期望 | 說明 |
|---|---|---|---|---|
| #26 單一連通 | OK | Polygon | Polygon |  |
| #26 套用的修改來源 | OK | crosstrack、ebox、原始檔修正、s1 | crosstrack、s1、ebox、原始檔修正 |  |
| #26 齒孔 path131[19] ＝ frames.fix_26_tooth_hole() 結果（逐字） | OK | True | True |  |
| #26 1 元開口（path131[4]）↔ 最近的新切割 crosstrack「S5 光孔（平行四邊形）」 | OK | 2.076 | ≥2 |  |
| #26 5 元開口（path131[8]）↔ 最近的新切割 crosstrack「S5 光孔（平行四邊形）」 | OK | 2.076 | ≥2 |  |
| #26 10 元開口（path131[10]）↔ 最近的新切割 crosstrack「S10 光孔（平行四邊形）」 | OK | 2.116 | ≥2 |  |
| #26 50 元開口（path131[13]）↔ 最近的新切割 crosstrack「S50 光孔（平行四邊形）」 | OK | 2.303 | ≥2 |  |
| #26 原始孔 path131[1] 消失 | OK | #5 上小榫槽（V17～27）被電子盒 L 形缺口吃掉；#5 上小榫已由電子盒刪除 | 有對應的榫被刪 |  |

**E. #24 雕刻「1」「5」與 Logo**（10 項）

| 項目 | 結果 | 值 | 期望 | 說明 |
|---|---|---|---|---|
| #24 雕刻「1」外框離最終所有切割（spec b-6 量法） | OK | 4.516 | ≥1.5 | 位置 U123.8～130.6×V82.8～92.6；字墨（含線寬）到切割 5.27；最近處 U131.4 V80.7 |
| #24 雕刻「1」外框離 #24 前方的蓋板 C1（不被蓋住） | OK | 1.516 | ≥1.5 | C1＝mods_crosstrack 實際位置 |
| #24 雕刻「5」外框離最終所有切割（spec b-6 量法） | OK | 1.516 | ≥1.5 | 位置 U150.2～158.8×V21.3～31.1；字墨（含線寬）到切割 2.69；最近處 U149.9 V31.8 |
| #24 雕刻「5」外框離 #24 前方的蓋板 C1（不被蓋住） | OK | 40.907 | ≥1.5 | C1＝mods_crosstrack 實際位置 |
| #24 Logo（雕刻＋9 個菱形孔的凸包）離其他切割 | OK | 3.378 | ≥3（ebox 規則 4） | 位置 U199.2～217.5×V28.2～45.6；最近處 U209.9 V26.5 |
| #24 Logo 菱形孔離其他孔／外框 | OK | 6.537 | ≥2 |  |
| #24 Logo 9 個菱形孔只平移（曲線不變） | OK | 9 個、moved 9 | 9 |  |
| #24 雕刻 Logo↔「10」（凸包） | OK | 3.377 | ≥3（不重疊） |  |
| #24 雕刻 Logo↔「50」（凸包） | OK | 3.517 | ≥3（不重疊） |  |
| #24 其他雕刻配對都 ≥10 mm | OK | 8 組 | ≥10 |  |

**F. 兩個子系統在同一零件上的修改區域（< 1.5 mm 列出）**（4 項）

| 項目 | 結果 | 值 | 期望 | 說明 |
|---|---|---|---|---|
| #24：crosstrack／ebox 修改區域最近距離 | 資訊 | 35.56 | ≥1.5 | crosstrack「雕刻「5」搬移 ΔU+0 ΔV-52.5」↔ ebox「TM1637 M2 固定孔 2」；&lt; 1.5 的共 0 組 |
| #26：crosstrack／ebox／原始檔修正／s1 修改區域最近距離 | 資訊 | 6.41 | ≥1.5 | crosstrack「S5 階梯窗」↔ s1「S1 #26 槽 F2（#13R 前榫 F2；U104.725～108.025 × V67.85～74.65）」；&lt; 1.5 的共 0 組 |
| #37：ebox／s1 修改區域最近距離 | 資訊 | 4.72 | ≥1.5 | s1「S1 #37 槽 B1（#13R 後榫；U104.725～108.025 × V35.85～48.15）」↔ ebox「感測器線孔（S5/S10/S50 線由右側空腔穿到背面）」；&lt; 1.5 的共 0 組 |
| #5：crosstrack／ebox 修改區域最近距離 | 資訊 | 9.59 | ≥1.5 | crosstrack「#5 雕刻「S50 v2」」↔ ebox「TM1637 背面零件讓位（前上角，連帶刪上小榫）」；&lt; 1.5 的共 0 組 |

**G. 原始子路徑逐字保留**（9 項）

| 項目 | 結果 | 值 | 期望 | 說明 |
|---|---|---|---|---|
| 沒被修改的原始零件：cut_d／engrave 和原始檔逐字相同 | OK | 52/52 | 全部 |  |
| #5 沒被碰到的子路徑逐字相同 | OK | 切割 保留 0／改 1；雕刻 保留 0／移 0 | 沒有不明的改變 | 重生或刪除（都有 edit 碰到）：rect370[0]←crosstrack／ebox |
| #6 沒被碰到的子路徑逐字相同 | OK | 切割 保留 0／改 1；雕刻 保留 0／移 0 | 沒有不明的改變 | 重生或刪除（都有 edit 碰到）：path529[0]←crosstrack |
| #7 沒被碰到的子路徑逐字相同 | OK | 切割 保留 0／改 1；雕刻 保留 0／移 0 | 沒有不明的改變 | 重生或刪除（都有 edit 碰到）：path414[0]←crosstrack |
| #13R 沒被碰到的子路徑逐字相同 | OK | 切割 保留 3／改 1；雕刻 保留 0／移 0 | 沒有不明的改變 | 重生或刪除（都有 edit 碰到）：path256[0]←s1 |
| #21 沒被碰到的子路徑逐字相同 | OK | 切割 保留 4／改 0；雕刻 保留 0／移 0 | 沒有不明的改變 |  |
| #24 沒被碰到的子路徑逐字相同 | OK | 切割 保留 23／改 12；雕刻 保留 2／移 3 | 沒有不明的改變 | 重生或刪除（都有 edit 碰到）：rect2[0]←crosstrack、rect2[25]←crosstrack、rect2[26]←crosstrack |
| #26 沒被碰到的子路徑逐字相同 | OK | 切割 保留 24／改 6；雕刻 保留 1／移 0 | 沒有不明的改變 | 重生或刪除（都有 edit 碰到）：path131[0]←crosstrack／ebox、path131[1]←ebox、path131[14]←crosstrack、path131[20]←crosstrack、path131[21]←crosstrack |
| #37 沒被碰到的子路徑逐字相同 | OK | 切割 保留 11／改 1；雕刻 保留 0／移 0 | 沒有不明的改變 | 重生或刪除（都有 edit 碰到）：path509-6[0]←ebox |

**H. 分幣開口與軌道逐點比對**（5 項）

| 項目 | 結果 | 值 | 期望 | 說明 |
|---|---|---|---|---|
| #26 1 元開口（path131[4]）和原始檔逐點相同 | OK | 逐字相同（偏差 0） | ≤0.001 mm |  |
| #26 5 元開口（path131[8]）和原始檔逐點相同 | OK | 逐字相同（偏差 0） | ≤0.001 mm |  |
| #26 10 元開口（path131[10]）和原始檔逐點相同 | OK | 逐字相同（偏差 0） | ≤0.001 mm |  |
| #26 50 元開口（path131[13]）和原始檔逐點相同 | OK | 逐字相同（偏差 0） | ≤0.001 mm |  |
| #24 #24 斜槽（軌道）（rect2[1]）和原始檔逐點相同 | OK | 逐字相同（偏差 0） | ≤0.001 mm |  |

**K. 榫槽配對（間隔條、櫃側板穿過 #24／#26／#37）**（10 項）

| 項目 | 結果 | 值 | 期望 | 說明 |
|---|---|---|---|---|
| #5 穿板截面都在孔／缺口裡（2 段） | OK | 0.325 | 干涉 ≤ 原始 0.325（或 ≤0.35）＋0.05 | #26 V35.0～45.0（干涉 0.10）；#37 V40.0～56.0（干涉 0.32） |
| #5 欄位內的新槽都有榫 | OK | 無空槽 | 無空槽 |  |
| #6 穿板截面都在孔／缺口裡（3 段） | OK | 0.325 | 干涉 ≤ 原始 0.325（或 ≤0.35）＋0.05 | #26 V17.0～27.0（干涉 0.10）；#26 V31.0～38.0（干涉 0.10）；#37 V40.0～56.0（干涉 0.32） |
| #6 欄位內的新槽都有榫 | OK | 無空槽 | 無空槽 |  |
| #7 穿板截面都在孔／缺口裡（4 段） | OK | 0.268 | 干涉 ≤ 原始 0.268（或 ≤0.35）＋0.05 | #24 V84.4～92.5（干涉 0.10）；#26 V17.0～24.0（干涉 0.10）；#26 V84.4～92.5（干涉 0.10）；#37 V40.0～56.0（干涉 0.27） |
| #7 欄位內的新槽都有榫 | OK | 無空槽 | 無空槽 |  |
| #13R 穿板截面都在孔／缺口裡（10 段） | OK | 0.105 | 干涉 ≤ 原始 1.048（或 ≤0.35）＋0.05 | #24 V84.0～88.0（干涉 0.10）；#24 V91.5～95.5（干涉 0.11）；#24 V105.0～110.0（干涉 0.04）；#26 V50.5～56.0；#26 V68.0～74.5；#26 V84.0～88.0（干涉 0.10）；#26 V91.5～95.5（干涉 0.10）；#26 V98.0～114.0；#37 V36.0～48.0；#37 V84.0～146.0 |
| #13R 欄位內的新槽都有榫 | OK | 無空槽 | 無空槽 |  |
| #21 穿板截面都在孔／缺口裡（7 段） | OK | 0.307 | 干涉 ≤ 原始 0.304（或 ≤0.35）＋0.05 | #24 V84.0～88.0（干涉 0.10）；#24 V91.5～95.5（干涉 0.10）；#24 V105.0～110.0（干涉 0.04）；#26 V84.0～88.0（干涉 0.10）；#26 V91.5～95.5（干涉 0.10）；#26 V98.0～114.0；#37 V82.5～146.0（干涉 0.31） |
| #21 欄位內的新槽都有榫 | OK | 無空槽 | 無空槽 |  |

**W. 新切割造成的細料**（14 項）

| 項目 | 結果 | 值 | 期望 | 說明 |
|---|---|---|---|---|
| #13R 新／重生切割環到其他環 ≥2（比原始檔近的才算） | OK | OK | ≥2 |  |
| #13R edit 附近沒有新的 &lt;2 mm 細料（opening 法） | OK | OK | 無 |  |
| #24 新／重生切割環到其他環 ≥2（比原始檔近的才算） | OK | OK | ≥2 |  |
| #24 edit 附近沒有新的 &lt;2 mm 細料（opening 法） | OK | OK | 無 |  |
| #26 新／重生切割環到其他環 ≥2（比原始檔近的才算） | OK | OK | ≥2 |  |
| #26 edit 附近沒有新的 &lt;2 mm 細料（opening 法） | OK | OK | 無 |  |
| #37 新／重生切割環到其他環 ≥2（比原始檔近的才算） | OK | OK | ≥2 |  |
| #37 edit 附近沒有新的 &lt;2 mm 細料（opening 法） | OK | OK | 無 | ；另有 1 個 &lt;3 mm² 的單邊小凸齒（不影響強度）：U104.9～106.7×V77.0～78.1 |
| #5 新／重生切割環到其他環 ≥2（比原始檔近的才算） | OK | OK | ≥2 |  |
| #5 edit 附近沒有新的 &lt;2 mm 細料（opening 法） | OK | OK | 無 |  |
| #6 新／重生切割環到其他環 ≥2（比原始檔近的才算） | OK | OK | ≥2 |  |
| #6 edit 附近沒有新的 &lt;2 mm 細料（opening 法） | OK | OK | 無 |  |
| #7 新／重生切割環到其他環 ≥2（比原始檔近的才算） | OK | OK | ≥2 |  |
| #7 edit 附近沒有新的 &lt;2 mm 細料（opening 法） | OK | OK | 無 |  |

**S. S1 ↔ S5 實際間隙**（1 項）

| 項目 | 結果 | 值 | 期望 | 說明 |
|---|---|---|---|---|
| S1 最前實體 W' 到 S5 實際最深 W'（最終位置與低位） | OK | 2.7 | ≥1.5 | S1 最前 W'12.30；S5 最深 W'9.60（mods_crosstrack 實際；mods_s1 用規格常數 10.0） |

**L. 排版**（7 項）

| 項目 | 結果 | 值 | 期望 | 說明 |
|---|---|---|---|---|
| 同板群組 S1-wall（#13R、S1-B）排在同一張 | OK | 合板 第 2 張 | 1 張 |  |
| 同板群組 ebox（EB-WL、EB-WR、EB-B、EB-T、EB-S、EB-F、EB-E、EB-K）排在同一張 | OK | 合板 第 1 張 | 1 張 |  |
| S1-B 與 #13R 同一張 | OK | 合板 第 2 張 | 同一張 |  |
| 合板張數（交接估 3～4 張） | OK | 3 | 3～4 |  |
| 壓克力張數 | OK | 1 | ≥1（另排） |  |
| 每個零件都有排 | OK | 全部 | 全部 |  |
| 備品都排進現有的板（不增加張數） | OK | 8/8 件 | 全部 | PIN-S50×2、S1-H×3、S1-P×1、EB-K×2 |

## 八、待決事項（這份草稿照預設值產生）

- 待決：S1 前臂黏 3 片導流帽 S1-H、PCB 用 1 mm 泡棉膠墊高（照預設：要用，S1-H 已排進板；泡棉膠另購）
- 待決：模組固定方式（照預設：M3 尼龍螺絲＋講師預黏螺帽）
- 待決：#13R 右牆牆頂高度 V30 或 V38（照預設：V30，params.S1_WALL_TOP_V）
- 待決：裝／拆 S50 前要先抽出 10、50 元抽屜（照預設：寫進老師組裝說明）
- 待決：#5 間隔條只剩 2 支榫（照預設：接受，試切時確認）
- 待決：電源開關要買哪一款免焊線組（不影響雷切檔）
- 待決：試切若硬幣卡在模組 PCB 翼上，是否把 S5/S10/S50 改成分離式紅外線對射（照預設：維持槽型光耦）
- [crosstrack] 待決：光耦模組全部尺寸（照 params.MODULE 暫定值）
- [crosstrack] 待決：模組左右手性／翼方向（照預設 wing='up'；若是 'down'，S50 會低於出口平面，要量抽屜側牆到滑道出口間隙或換鏡像模組）
- [crosstrack] 待決：試切卡幣時是否改用分離式紅外線對射（照預設：槽型模組）
- [crosstrack] 待決：排線走法（照預設：右下排線孔→右側空腔→#37 感測器線孔）
- [crosstrack] 待決：刪除 #5、#6 長榫與 #7 中段小榫、#6 補上方小榫（照預設：刪除並補）
- [crosstrack] 待決：裝／拆 S50 前先抽出 10、50 元抽屜（照預設：寫進老師組裝說明）
- [crosstrack] 待決：#5 合併後只剩 2 支榫（照預設：接受，試切 T5 確認不晃）
- [s1] 待決：S1 導流帽 S1-H 和 1.0 mm 雙面泡棉膠（照預設：做 3 片帽，泡棉膠墊高 s_pcb=1）
- [s1] 待決：卡匣固定方式（照預設：M3 尼龍螺絲＋講師預黏螺帽，#37／背蓋孔 Ø3.4；若改 M2.6 自攻，#37 孔改 2.2）
- [s1] 待決：#13R 牆頂 V30 或 V38（照預設 V30＝params.S1_WALL_TOP_V；V38 可跑，wall_top 檢查會不合格並出警告）
- [s1] 待決：左側 #21 的 37-cutout-corners 要不要一起修（照預設：不修，#21 只加雕刻）
- [s1] 待決：備品卡匣數（照預設：每套 1 個，不含備品；建議每 10 套另做 2 個）
- [s1] 待決：comp_band_free（照預設 False：背蓋切元件帶，不切 S1-K）
- [s1] 待實量：槽型光耦模組全部尺寸、本體與排針位置、元件高、背面焊點高 back_h、擋住時輸出準位
- [ebox] 待決：Logo 位置（照預設 L2；本次實際用 L2）
- [ebox] 待決：TM1637 實量（照暫定 PCB 42.0×24.0、LED 塊 30.0×14.0、孔距（全距）38.0×20.0＝params.TM1637 的 hole_dx=19.0、hole_dy=10.0（半距））
- [ebox] 待決：TM1637 用 M2 螺絲或熱熔膠（照預設 M2 尼龍螺絲，#24 切 4 個 M2 孔）
- [ebox] 待決：擴展板與開發板實量、USB/DC 在哪一端（照暫定 78.0×53.5、開發板置中、USB/DC 在 +U）
- [ebox] 待決：電源免焊線組型式（照預設面板式開關，孔 9×13.5）
- [ebox] 待決：電池凸出盒頂（照預設 4 mm）
- [ebox] 待決：#5 只剩 2 支榫（照預設接受，試切 T5 確認）
- [ebox] 待決：感測器線盒端 1×3 G-V-S、線長 40 cm（照預設）
- [ebox] 待決：防拔鍵 EB-K（照預設輸出 2 片）

## 九、QA（雷切檔衛生檢查，laser_v2/qa.py）

草稿 SVG：14/14 項通過。

| 項目 | 結果 | 說明 |
|---|---|---|
| XML 解析 | OK | 928 個圖形元素 |
| 頁面 | OK | 4 頁，每頁 255×355 |
| 圖層名稱 | OK | 4 個圖層名稱與順序正確，註記層隱藏 |
| 沒有 &lt;text&gt; | OK | 沒有任何文字元素 |
| 顏色 | OK | 只有切割 #000000（0.2 mm）、雕刻 #ff0000、註記 #008000 |
| 雕刻樣式 | OK | 64 個雕刻元素都是 fill:none;stroke:#ff0000;stroke-width:0.2（0.2 mm 紅線，和原始檔一樣） |
| 零件代號 | OK | 92 件（原始零件 52、v2 修改 8、v2 新增 32），其中備品 8 件，每件都有代號與註記；備品 8/8 件 |
| 外框閉合 | OK | 92 個零件外框都封閉、不自交；孔 277 個都在外框內；開放線（鋸縫等）279 條都在外框內 |
| 零件內切割順序 | OK | 92 個零件都是雕刻、孔、內部線在前，外框最後 |
| 雕刻在零件內 | OK | 273 條雕刻線都在所屬零件的材料上（外框內、不在孔裡） |
| 雕刻不壓切割線 | OK | 雕刻線沒有和切割線重合 |
| 無重疊重複切割線 | OK | 648 條切割線，沒有重切或兩條疊在一起 |
| 零件不超出板 | OK | 每個零件都在頁內、離頁邊 ≥ 2.0 mm |
| 零件間距 | OK | 任兩零件距離 ≥ 2.0 mm（最近 2.46 mm） |

分頁 SVG（上雷切機用；用分頁檔規則檢查：只有 3 個圖層、沒有註記層、沒有綠色）：
- `sheet_合板_1.svg`：14/14 項通過
- `sheet_合板_2.svg`：14/14 項通過
- `sheet_合板_3.svg`：14/14 項通過
- `sheet_壓克力_1.svg`：14/14 項通過

## 十、其他

- #26 右側第 1 個齒孔修正（params.FIX_26_TOOTH_HOLE）：已套用。
- 原始檔清理（catalog.removed_items()）共 11 項：不可見雜線 path9；不可見雜線 path174；註記文字 text4-3；註記文字 text173；註記文字 text176；註記文字 text178；註記文字 text180；來回毛刺 rect2[4]；退化子路徑 rect2[6]；#24 斜槽多餘切割線 rect2[18]；退化子路徑 path2[1]。
