kingofamani/CoinSorting/03_v2_光耦版/laser_v2/out/trial_report.md

# 分幣機 v2 試切小樣：說明與檢查

由 `python -m laser_v2.trial`（或 `python -m laser_v2.build_v2` 最後一步）產生。小樣直接從 v2 最終零件（含 crosstrack、S1、電子盒全部修改與 #26 齒孔修正）裁出來，模組實量後改 `laser_v2/params.py` 重跑，小樣會跟著更新。

> **上雷切機用 `laser_v2/out/trial_合板_1.svg`**（不含註記）。黑＝切割、紅＝雕刻（全部是 0.2 mm 線，和原始檔一樣）：紅色圖層在雷切軟體設「線／向量雕刻（低功率切割）」，**不要用填色／掃描**。03_v2_光耦版 資料夾的試切 SVG 含隱藏註記層，是給人看的，不要直接上機。

## 一、檔案與上雷切機設定

- **上雷切機**：`laser_v2/out/trial_合板_1.svg`：每張板一個檔，只有「原始零件」「v2 修改」「v2 新增」3 個圖層，沒有註記層。
- 試切 SVG（給人看）：`分幣機雷切_光耦版_v2_試切小樣.svg`（1 頁，255×355；圖層同 v2 草稿：裁出來的局部在「v2 修改」，v2 新零件與試切輔助件在「v2 新增」；多一個隱藏的「註記（不切割）」層），不要直接上機。
- 預覽圖：`laser_v2/out/trial_合板_1.png`
- 顏色：黑 0.2 mm 線＝切割；紅 0.2 mm 線＝雕刻（代號 TA-#24 等、定位框線、▲），雷切軟體設「線／向量雕刻（低功率切割）」，不要用填色／掃描；綠＝註記（只在試切 SVG 的隱藏圖層）。
- 零件內的順序：每個零件先寫雕刻，再寫孔與內部線，外框最後；雷切軟體照檔案順序切時零件不會先掉，軟體會自己排序的話開「先切內部（inner first）」。
- 雷切軟體多半照圖層（顏色）順序跑、不照檔案順序：圖層清單裡把紅色（雕刻）排在黑色（切割）前面，黑色圖層再開「先切內部（inner first）」；不然整張先切穿，小零件來不及雕刻就掉了或移位。
- 小字（em 2～3 的代號字、#37「感測器線」、EB-WL「左牆」等）用 0.2 mm 線雕刻，筆畫間隙比線寬還窄的地方會燒糊：先切試切小樣，調紅色圖層的功率／速度，確認 C1-S10 的「S10」（em 2.1）和 TB-#37 的「感測器線」刻得清楚再切整台（兩個都在這張小樣上）。刻不清楚時先調功率／速度；調了還是糊，回報是哪幾個字（放大字或改成較簡單的字，要先決定再改）。
- 重跑時，`laser_v2/out` 裡產生器命名的 `trial_<材質>_<n>.svg`／`.png` 會被覆寫，這次沒有的會被移除（SVG 還要檔頭有產生器註解才刪）；自己手改的檔請改名（例如加「_手改」）或存到別處。

## 二、用板

- 合板 第 1 張：42 件（含備品 8 件），利用率 48.5%（外框 57.1%），排到 x≤253、y≤278（板邊留 2 mm，用 255×281 的板也切得下）。

共 28 種、34 件（另備品 8 件）。spec 建議 MDF 和合板各切一次（保留條 2.3 會不會燒斷），每種板材各切 1 份。

**備品已排進切割檔**（和正式檔同一規則：外包兩邊都 <10 mm 的極小零件每套多一整份，不加張數）：PIN-S50×2、EB-K×2、S1-H×3、S1-P×1。切完和正式件分開收，掉進蜂巢的直接用備品。

## 三、每一片

代號雕在零件上：TA／TB 是小樣的組別（不是 spec 的 T 編號）。裁切範圍用組裝座標（frames.py：U 往左、V 沿面板往下、W' 往後）。v2 新零件和正式件完全相同，試切過了可以留著用。

### TA 組：機身左段（S10／S50 感測座＋TM1637 顯示器＋電子盒）

| 片 | 是什麼（裁切範圍） | 要測什麼 | 對應 spec | 過關標準 | 不過關時改哪裡 |
|---|---|---|---|---|---|
| TA-#24 | #24 前面板左段（S10／S50 感測窗、顯示窗、Logo）；實際 U142.0～246.0 × V4.0～98.0 | 切縫；S10 保留條 2.3／肩部 3.2、S50 保留條有沒有燒斷或翹；S50 插銷孔；模組裝拆；TM1637 裝窗；之後當講師黏插銷的治具 | crosstrack T1、T2、T7、T8；ebox T1 | 保留條完整、直尺貼上縫 ≤0.2；插銷 3×3 壓得進 2.9 孔、不鬆；模組「低位推入→上滑→塞鎖塊→放手」順（塞鎖塊＝P1 背面貼 #24 正面、在窗下方往上抬到凸塊碰 PCB 下面，再往後推 3 mm；用這個手法驗收），量 C1 頂到前臂底下焊點的實際餘隙（名目 0.3～0.5）；拔鎖塊（先往前拉 3 mm 再往下）後模組自己落回低位；LED 塊塞得進不晃、凸出約 4 mm、4 支 M2 鎖得上、螺絲頭不壓「10」；手指按 S10 保留條中央不斷 | 保留條斷／翹：先 MDF、合板各切一次比較；仍斷→降 params.BEAM_H（定案 2.5，改前要問使用者）或 mods_crosstrack.DESIGN["g_strip"]。模組卡住→實量後改 params.MODULE（spec d-2 表：槽底頂保留條看 slot_d／arm_top／pcb_t，本體進不了窄段看 arm_w，PCB 碰窗看 pcb_W／body_e，零件頂到肩部看 comp_h）。塞鎖塊時 P1 凸塊撞到前臂底下的焊腳→是塞法不對（不可從模組前方直接水平推入，要照上面先抬再推），不是改參數；P1 推到位後焊點仍壓到 P1 其餘頂面→看 params.MODULE 的 back_h（P1 讓位深度跟著變）。顯示器→params.TM1637（hole_dx／hole_dy 是半距：孔中心離 PCB 中心，實量孔距要除以 2） |
| TA-#26 | #26 內牆左段（10／50 元開口、S10／S50 窗與光孔、L 形缺口）；實際 U142.0～243.0 × V14.0～98.0 | 光孔兩側肉（S10 2.12、S50 2.30）、窗到開口唇 3.6／4.5 完整；L 形缺口放 TM1637 PCB、M2 螺帽、彎針、杜邦頭、上升線；放硬幣預演落幣（5 元落在 S10 翼上方、10 元落在 S50 翼上方） | crosstrack T1、T2、T3 預演（R1、R3）；ebox T2 | 光孔兩側沒有燒斷；顯示器的 PCB、杜邦頭、線放進缺口不被夾；硬幣滾過與落下不卡在翼或後臂上 | 光孔肉斷→mods_crosstrack.DESIGN["lh_u"]、["delta_u"]；硬幣被後臂頂住→DESIGN["delta_u"] 改 −0.5（spec d-5）；卡在翼上→spec 備案（改分離式對射，待使用者決定）；缺口太緊→ebox.C_NOTCH、params.TM1637 |
| TA-#37 | #37 後面板左上段（掛勾槽、顯示器線缺口、#5／#6 後榫槽）；實際 U141.0～246.0 × V4.0～78.0 | 電子盒兩層掛勾「抬、推、放」；顯示器線頂邊缺口；撐住 #5／#6 後榫 | ebox T3（T7 線路預演） | 抬 6.4、推、放順手，滑到底不晃；裝 EB-K（從機身內側塞，頭長出來的那端朝上）後抬不起來；勾唇到 #37 內面間隙約 0.15（塞得進 0.1 塞規、塞不進 0.3） | params.C_HOOK（掛勾槽單邊餘隙 0.2）、params.T_PLY（實際板厚）；勾唇位置 ebox.HOOK |
| TA-#5 | #5 v2 間隔條（10\|50）整片（只多雕代號，試切過可以裝到整台） | S50 缺口擋面（W'7.8）＋2 mm 導角；前上角讓 TM1637 背面零件；只剩 2 支榫會不會晃 | crosstrack T2；ebox T2、T5（只剩 2 支榫） | 模組後臂外面貼得到擋面、上滑時導角把模組往前帶；TM1637 背面零件不碰 #5；用手指推隔板頂晃動 ≤0.5 mm | 擋面→params.MODULE（arm_t、slot_w、pcb_L，spec d-2）；碰背面零件→ebox.C_DIV 或 params.TM1637；晃→講師預組時點白膠（spec ebox g-1 第 2 點） |
| TA-#6 | #6 v2 間隔條（5\|10）整片（只多雕代號，試切過可以裝到整台） | S10 缺口擋面＋導角；#6 v2 新上方小榫插 #26 新槽 | crosstrack T2 | 新小榫插得進 TA-#26 的新槽（2.9×6.9）；模組後臂貼擋面 | 同 TA-#5；槽太緊→mods_crosstrack.DESIGN["slot_shrink"] |
| P1-S10 | S10 鎖塊 P1（黏在 C1 雕刻外框內，頂住凸塊在上緣、對齊 C1 下緣 ▲ 記號那一端） | S10 鎖塊（黏在 C1 雕刻外框內，頂住凸塊對齊 C1 下緣的 ▲） | crosstrack T2 | P1 貼 #24 正面往上抬、再往後推 3 mm 塞得進 #24 窗，凸塊頂住 PCB 下面；放手後模組不掉 | P1 頂面磨低（槽底頂到保留條時，spec d-2）；改 params.MODULE 後重產生 |
| C1-S10 | S10 蓋板 C1（雕刻面＝貼 #24 的背面） | S10 蓋板 | crosstrack T2、T7 | 蓋板貼 #24 正面；裝一站 ≤2 分鐘、拆換 ≤1 分鐘 | 同 P1-S10 |
| P1-S50 | S50 鎖塊 P1（黏在 C1 雕刻外框內，頂住凸塊在上緣） | S50 鎖塊 | crosstrack T2 | 同 P1-S10 | 同 P1-S10 |
| C1-S50 | S50 蓋板 C1（雕刻面＝貼 #24 的背面） | S50 蓋板（兩側插銷） | crosstrack T1、T2 | 插銷插得進 TA-#24 兩個方孔，鎖塊不轉 | 同 P1-S10 |
| PIN-S50 | S50 插銷（黏在 C1 雕刻方塊上）（×2） | S50 插銷 ×2 | crosstrack T1（a-2 第 5 步：先插進 TA-#24 孔再壓 C1 上去黏） | 壓得進 2.9 孔、不鬆 | mods_crosstrack.DESIGN["slot_shrink"]（孔每邊少 0.05）、DESIGN["pin"] |
| EB-* | EB-WL、EB-WR、EB-B、EB-T、EB-S、EB-F、EB-E、EB-K×2 | 電子盒 7 片＋防拔鍵 ×2（盒體全組，裝實品擴展板、電池、線組） | ebox T3、T4 | 電池往上拿出、放回各 10 次（每次 ≤20 秒）；USB、DC 從服務窗插拔順；EN／BOOT 按得到；GVS 杜邦頭插上後線收得進 W'70；掛上 TA-#37 不晃 | params.ESP32_BOARD（孔位、USB／DC 位置的鍵都列在裡面）、params.BATTERY_9V、params.C_TAB、params.T_PLY；盒子尺寸 ebox.BOX |
| TA-ST | 試切支架（夾 #24＋#26 下緣、托 TA-#37 下緣；面板照實機後仰 30°）（×2） | 試切支架 ×2（新設計，實機沒有）：TA 組照實機角度站著，滾硬幣用 | — | #24＋#26 下緣卡進前槽、TA-#37 下緣卡進後槽，整組站得穩（掛上電子盒也不會往後倒） | 只是治具，不影響 v2 |
| TA-PIN | 試切定位銷（穿 TA-#24、TA-#26 左下 #21 齒孔）（×2） | 定位銷 ×2（新設計，實機沒有）：穿過 TA-#24、TA-#26 左下兩個 #21 齒孔，讓兩片的窗對齊 | — | 兩片疊好後 S10／S50 窗邊對齊（錯位 ≤0.2） | 只是治具 |

### TB 組：S1 卡匣

| 片 | 是什麼（裁切範圍） | 要測什麼 | 對應 spec | 過關標準 | 不過關時改哪裡 |
|---|---|---|---|---|---|
| TB-#13R | #13R 上段（加高牆、牆槽、前榫 F1／F2、後榫 B1）；實際 W'-2.6～32.0 × V30.0～83.5 | 牆槽讓 S1-B 滑進去；前榫 F1、F2 插 #26，後榫 B1 插 #37；前榫 2.6 不穿出 #26 前面 | s1 T1 | S1-B 在牆槽內滑順、不晃；F1／F2／B1 插得進 | mods_s1.DES["c_tab"]（S1 木榫單邊餘隙 0.15）；板厚 &lt;2.7 時前榫改 2.4（mods_s1.DES，spec R7） |
| TB-#26 | #26 局部（S1 槽 F1、F2、C）；實際 U92.0～112.0 × V48.0～80.0 | 槽 F1、F2（#13R 前榫）、槽 C（S1-C 尖榫） | s1 T1 | S1-C 尖榫自己找到槽 C | mods_s1.DES["c_tab"] |
| TB-#37 | #37 局部（S1 卡匣窗、槽 B1、M3 孔）；實際 U85.5～127.0 × V32.0～86.0 | 卡匣窗、槽 B1、M3 孔；裝實品模組量光束 | s1 T1、T2、T3（靜態）、T7（插卡匣時間） | 背蓋貼平時後臂內面比 #37 內面低 0～0.5；光束中心 ≥U118.0（Ø1 鑽頭尾端從 U112 推到 U125）；1 元貼 #37 由上往下推過，靠左、靠右燈都會亮；插卡匣＋鎖 2 支螺絲 ≤1 分鐘 | 後臂位置→params.T_PLY、mods_s1.DES["wb_recess"]；光束 &lt;118→mods_s1.DES["s_pcb"]（泡棉加厚，最多 1.6）或實量後改 params.MODULE（arm_top、slot_d、beam_sb、pcb_t）；窗太緊→params.C_SENSOR |
| S1-* | S1-B、S1-C、S1-H×3、S1-F、S1-P | 卡匣：S1-B 座塊、S1-C 座板、S1-F 背蓋、S1-P 填塊、S1-H 導流帽 ×3；量 S1 模組前臂（靠 #26 那臂）PCB 背面焊腳的位置與高度 | s1 T1、T2、T7（T8 耐久要整台） | S1-B 黏 S1-C 後插進牆槽順；背蓋 2 支 M3 尼龍螺絲鎖上後整面貼 #37；後臂內面→背蓋前面 2.7±0.2；前臂背面凸出 &gt;1.0 mm 的焊點都落在 S1-B 讓位孔內（V≤74.7）或 W'&gt;29，PCB 貼上泡棉後沒有被焊點頂高 | 同 TB-#37；導流帽鬆→改瞬間膠（spec R1）；焊點落在讓位孔外→回報（S1-B 讓位孔／#13R 牆槽要改，mods_s1；焊點高度是 params.MODULE 的 back_h，見 report.md 第四節） |

## 四、怎麼組、怎麼測

組裝提醒：感測器排線貼 S10／S50（TA 組）、S1（TB 組）標籤，依標籤裝站（#24 正面不刻站名）。

**TA 組（機身左段）**
1. TA-#24 疊在 TA-#26 前面（雕刻面朝前），左下兩個 #21 齒孔插 TA-PIN（前露 1、後露 3）。
2. TA-#6、TA-#5（雕刻面朝右，也就是 U 小、轉盤那一側）的前小榫插 TA-#26（#6 兩支、#5 一支），後榫插 TA-#37（雕刻面朝後）。
3. 兩片 TA-ST 立在桌上，間距照 U142 與 U241（各在電子盒外側）：#24＋#26 下緣放進前槽（寬 6.2），TA-#37 下緣放進後槽（寬 3.2）。面板就是實機的後仰 30°，軌道（斜槽下緣）對桌面約 17°。
4. 感測座：照 crosstrack a-3 裝 S10、S50（先黏 P1 到 C1，S10 的凸塊對齊 C1 下緣的 ▲；S50 插銷先插 TA-#24 孔再黏 C1）。塞鎖塊用新塞法：P1 背面貼 TA-#24 正面、從窗下方往上抬到凸塊碰 PCB 下面，再往後推 3 mm（不可從模組前方直接水平推入，凸塊會撞前臂底下的焊腳；見 report.md crosstrack 說明）。
5. 滾硬幣：硬幣從斜槽右端（U146 以左）放進去靠著 TA-#26 往下滾。10 元經過 S10 光束後掉進 10 元開口；50 元經過 S10、S50 兩道光束後掉進 50 元開口（兩個開口都完整）。5 元放在右端會直接掉進 5 元開口（右緣被裁掉約 1.4 mm）、落在 S10 翼上方；10 元落進 10 元開口時在 S50 翼上方，可以看翼會不會卡幣（R1）。
6. TM1637 從 TA-#24 背面裝窗，PCB 進 TA-#26 的 L 形缺口；電子盒照 ebox a-2 組好，掛上 TA-#37（抬、推、放）。支架尾巴延伸到 W'65，掛上電子盒也不會往後倒。

**TB 組（S1 卡匣）**
1. TB-#13R 前榫 F1、F2 插 TB-#26，後榫 B1 插 TB-#37（雕刻面朝空腔、朝 U 小的一側）。
2. 卡匣照 s1 a-2 預組（S1-B 黏 S1-C、後榫插 S1-F、S1-P 黏背蓋前面、導流帽黏前臂、模組貼 1 mm 泡棉膠），從 TB-#37 背面推進牆槽，鎖 2 支 M3。
3. 量後臂內面位置、光束 U（s1 T2）、手推 1 元（s1 T3）。

**這份小樣做不到、要切整台才能測的項目**

- crosstrack T3（每格 100 枚落幣錄影）、T4（計數）、T5（分級和原機比）、T6（抽屜）：要整台 v2。
- s1 T4（200 枚落幣）、T5（混合）、T6（邊界、日光燈）、T8（500 枚耐久）：要整台。
- ebox T5（整台翻倒力）、T6（跑硬幣看 WL 勾唇）、T7（四條感測器線實際走線）、T8（教室可視）：要整台。
- s1 T0、crosstrack d-1：拿到模組先實量（Go／No-Go），改 params.MODULE 後重跑 build_v2，再切小樣。

## 五、和 spec 建議範圍不同的地方

- crosstrack g-2 T1 建議 #24、#26 切 U165～215 × V40～98：S10 窗在 U144～169，U165 會把窗切開；斜槽也會把那塊切成上下兩半。改成從 U142 起（S10 窗右下角外留 ≥2 mm，在 U140.5～146 自動找），往左包到 #24 左端，和 ebox 要的 #24 左上（顯示窗）合成一片：TA-#24 U142.0～246.0 × V4.0～98.0、TA-#26 U142.0～243.0 × V14.0～98.0。
- TA-#24 右端 U142～146 把斜槽補成 4 mm 連接條（試切專用）：不補的話，斜槽下方那條（S10 窗那段）只靠 S50 開底缺口上的 2.3 mm 保留條懸臂掛著，搬動就可能斷，也測不出實機「保留條兩端固定」的強度。硬幣從連接條左邊放進斜槽。
- TA-#24 左下腳（V98 以下）切掉，讓 #24、#26 下緣齊平，支架才夾得住。
- ebox g-2 建議 #37 切 U140～246 × V0～45：#5、#6 的後榫槽在 V40～56，所以往下切到 TA-#37 U141.0～246.0 × V4.0～78.0，讓隔板把 #26、#37 撐在一起，電子盒前緣（到 V76.25）也整片靠得到 #37；右緣避開 #7 後榫槽（U135.9～138.8），下緣避開 #37 左端榫（V79.95 起）。
- s1 g-2 建議 #26、#37 切 U90～130 × V30～85：#26 往左會切過 1 元開口與 S5 窗、留下細條，所以只切槽附近（TB-#26 U92.0～112.0 × V48.0～80.0）；#37 改成 TB-#37 U85.5～127.0 × V32.0～86.0（卡匣窗下緣 V78.8 到 #37 底邊 V82 只有 3.2 mm，切在 V82 以上會留細條；左邊包住感測器線孔）。
- s1 建議的「#13R 上段」：TB-#13R W'-2.6～32.0 × V30.0～83.5，往下留到牆槽下方 6.6 mm，#37 板厚內的後上角讓開，不含齒。
- 新增試切輔助件：TA-ST×2（支架）、TA-PIN×2（定位銷）。

## 六、檢查結果

本模組檢查 45 項：通過 43、未通過 0、資訊 2。

| 片 | 項目 | 結果 | 值 | 期望 | 說明 |
|---|---|---|---|---|---|
| TA-#24 | 單一連通 | OK | 1 | 1 |  |
| TA-#24 | 外形＝最終零件∩裁切範圍＋連接條 | OK | 0.005 | &lt;0.01 mm² |  |
| TA-#24 | 裁切邊不新增細料 | OK | 裁切邊附近新增料最窄約 2.51 mm | ≥2 mm |  |
| TA-#24 | 範圍內的孔／窗逐字保留 | OK | 19 個 | 全部 |  |
| TA-#24 | 必要特徵完整 | OK | 20/20 | 全部 | S10 階梯窗、S50 開底缺口、S50 插銷孔、TM1637 顯示窗、TM1637 M2、rect2[12]、rect2[14]、path4[0]、path5[0]、path8[0]、path10[0]、path11[0]、path12[0]、path15[0]、path16[0]、path17[0]、path1-5-9、text1-6-4、text2-1-3、text11-4-1 |
| TA-#24 | 合成警告 | 資訊 | 1 |  | union「試切連接條（補斜槽右端，實機沒有）」〈試切小樣〉 蓋到原始孔 rect2[1]（159.58 mm² 被填實） |
| TA-#26 | 單一連通 | OK | 1 | 1 |  |
| TA-#26 | 外形＝最終零件∩裁切範圍 | OK | 0.007 | &lt;0.01 mm² |  |
| TA-#26 | 裁切邊不新增細料 | OK | 裁切邊附近新增料最窄約 6 mm | ≥2 mm |  |
| TA-#26 | 範圍內的孔／窗逐字保留 | OK | 10 個 | 全部 |  |
| TA-#26 | 必要特徵完整 | OK | 12/12 | 全部 | S10 階梯窗、S10 光孔、S50 開底缺口、S50 光孔、#6 新小榫槽、L 形缺口、path131[2]、path131[5]、path131[10]、path131[13]、path131[18]、path131[25] |
| TA-#37 | 單一連通 | OK | 1 | 1 |  |
| TA-#37 | 外形＝最終零件∩裁切範圍 | OK | 0.003 | &lt;0.01 mm² |  |
| TA-#37 | 裁切邊不新增細料 | OK | 裁切邊附近新增料最窄約 4.78 mm | ≥2 mm |  |
| TA-#37 | 範圍內的孔／窗逐字保留 | OK | 6 個 | 全部 |  |
| TA-#37 | 必要特徵完整 | OK | 4/4 | 全部 | 掛勾槽、頂邊 U 形缺口、path509-6[6]、path509-6[7] |
| TB-#13R | 單一連通 | OK | 1 | 1 |  |
| TB-#13R | 外形＝最終零件∩裁切範圍 | OK | 0.006 | &lt;0.01 mm² |  |
| TB-#13R | 裁切邊不新增細料 | OK | 裁切邊附近新增料最窄約 6 mm | ≥2 mm |  |
| TB-#13R | 範圍內的孔／窗逐字保留 | OK | 0 個 | 全部 |  |
| TB-#13R | 必要特徵完整 | OK | 1/1 | 全部 | 牆槽 |
| TB-#26 | 單一連通 | OK | 1 | 1 |  |
| TB-#26 | 外形＝最終零件∩裁切範圍 | OK | 0.001 | &lt;0.01 mm² |  |
| TB-#26 | 裁切邊不新增細料 | OK | 裁切邊附近新增料最窄約 2.33 mm | ≥2 mm |  |
| TB-#26 | 範圍內的孔／窗逐字保留 | OK | 3 個 | 全部 |  |
| TB-#26 | 必要特徵完整 | OK | 3/3 | 全部 | 槽 F1、槽 F2、槽 C |
| TB-#37 | 單一連通 | OK | 1 | 1 |  |
| TB-#37 | 外形＝最終零件∩裁切範圍 | OK | 0.004 | &lt;0.01 mm² |  |
| TB-#37 | 裁切邊不新增細料 | OK | 裁切邊附近新增料最窄約 2.47 mm | ≥2 mm |  |
| TB-#37 | 範圍內的孔／窗逐字保留 | OK | 5 個 | 全部 |  |
| TB-#37 | 必要特徵完整 | OK | 4/4 | 全部 | 卡匣窗、槽 B1、M3 孔、感測器線孔 |
| TA-#24 | 斜槽軌道（下緣）逐點相同 | OK | 0.0002 mm（256 點） | ≤0.001 | U146.0～234，硬幣可以滾過 S10、S50 兩站 |
| TA-ST | 支架底邊水平（面板後仰 30°） | OK | 底邊在 (W',V) 的斜率角 150.00° | ±30°（V＋tan30°·W'＝常數） |  |
| TA-ST | 右支架 U142～145 離電子盒掛勾槽（牆） | OK | 0.8 | ≥0.5 | 電子盒牆在掛勾槽內，支架在盒子外側 |
| TA-ST | 右支架離感測座（模組上下滑的範圍、蓋板） | OK | 3.74 | ≥0.5 | 最近：S10 模組（同一段 W' 內比 (U,V) 距離） |
| TA-ST | 左支架 U241～244 離電子盒掛勾槽（牆） | OK | 0.8 | ≥0.5 | 電子盒牆在掛勾槽內，支架在盒子外側 |
| TA-ST | 左支架離感測座（模組上下滑的範圍、蓋板） | OK | 36.19 | ≥0.5 | 最近：S50 蓋板 C1（同一段 W' 內比 (U,V) 距離） |
| TA-ST | TA 組站在支架上：不掛電子盒 | OK | 重心 Z-19.5，離支架底邊兩端（Z-61.0～24.5）最少 41.5 mm | ≥5 mm | 粗估：總重約 56 g（椴木合板最不利）；Z＝−0.5V＋0.866W'，往後為正 |
| TA-ST | TA 組站在支架上：掛上電子盒（含電池、擴展板） | OK | 重心 Z10.9，離支架底邊兩端（Z-61.0～24.5）最少 13.6 mm | ≥5 mm | 粗估：總重約 160 g（椴木合板最不利）；Z＝−0.5V＋0.866W'，往後為正 |
| TA-ST | 支架前槽／後槽 | 資訊 | #24＋#26 下緣 V98.00、TA-#37 下緣 V78 |  | 槽寬 6.2／3.2（params.T_PLY、C_TAB）、深 5 |
| TA-PIN | 定位銷對 #21 齒孔 | OK | 銷寬 3.85（板厚 3） | 孔 2.90×3.95 |  |
|  | 張數 | OK | 1 張 | 目標 1 張、最多 2 張 |  |
|  | 備品都排進現有的板（不加張數） | OK | 8/8 件 | 全部 | PIN-S50×2、EB-K×2、S1-H×3、S1-P×1 |
|  | 同板群組 S1-wall | OK | 第 1 張 | 同一張 | TB-#13R、S1-B |
|  | 同板群組 ebox | OK | 第 1 張 | 同一張 | EB-WL、EB-WR、EB-B、EB-T、EB-S、EB-F、EB-E、EB-K |

**qa.check（雷切檔衛生）**：試切 SVG 14/14 項通過。

| 項目 | 結果 | 說明 |
|---|---|---|
| XML 解析 | OK | 245 個圖形元素 |
| 頁面 | OK | 1 頁，每頁 255×355 |
| 圖層名稱 | OK | 4 個圖層名稱與順序正確，註記層隱藏 |
| 沒有 &lt;text&gt; | OK | 沒有任何文字元素 |
| 顏色 | OK | 只有切割 #000000（0.2 mm）、雕刻 #ff0000、註記 #008000 |
| 雕刻樣式 | OK | 43 個雕刻元素都是 fill:none;stroke:#ff0000;stroke-width:0.2（0.2 mm 紅線，和原始檔一樣） |
| 零件代號 | OK | 42 件（原始零件 0、v2 修改 8、v2 新增 34），其中備品 8 件，每件都有代號與註記；備品 8/8 件 |
| 外框閉合 | OK | 42 個零件外框都封閉、不自交；孔 62 個都在外框內；開放線（鋸縫等）0 條都在外框內 |
| 零件內切割順序 | OK | 42 個零件都是雕刻、孔、內部線在前，外框最後 |
| 雕刻在零件內 | OK | 287 條雕刻線都在所屬零件的材料上（外框內、不在孔裡） |
| 雕刻不壓切割線 | OK | 雕刻線沒有和切割線重合 |
| 無重疊重複切割線 | OK | 104 條切割線，沒有重切或兩條疊在一起 |
| 零件不超出板 | OK | 每個零件都在頁內、離頁邊 ≥ 2.0 mm |
| 零件間距 | OK | 任兩零件距離 ≥ 2.0 mm（最近 2.53 mm） |

上雷切機用的分頁檔（分頁檔規則：只有 3 個圖層、沒有註記層、沒有綠色）：
- `trial_合板_1.svg`：14/14 項通過

## 七、待決（照預設產生）

- 待決：試切板材（照預設：spec 建議 MDF 與合板各切一次，比較保留條 2.3）。
- 待決：模組、TM1637、擴展板都還沒實量（照預設：params.py 暫定值；實量後重跑再切）。
- 待決：支架、定位銷、TA-#24 連接條是試切專用設計（照預設：放進小樣，實機不用）。

## 八、本次使用的參數（laser_v2/params.py，產生這份小樣時的值）

| 鍵 | 值 |
|---|---|
| `MODULE` | slot_w=10、slot_d=9、beam_sb=5、arm_t=7、arm_w=6.4、arm_top=12、pcb_L=27.6、pcb_W=20、pcb_t=1.6、body_e=0.5、wing='up'、comp_h=2、back_h=2、hdr_up=14、hdr_len=8、pcb_ovf=0、aperture=1 |
| `TM1637` | pcb_w=42、pcb_h=24、pcb_t=1.6、hole_d=2.2、body_w=30、body_h=14、body_H=7.2、body_dx=0、body_dy=0、back_h=2.6、hole_dx=19、hole_dy=10、use_screws=True、hdr_mode='RA'、dup_len=14、dup_gap=1、wire_bend=5.5 |
| `ESP32_BOARD` | L=78、W=53.5、t=1.6、standoff=4.8、hole_inset=3、hole_d=3.4、hdr_h=8.5、dev_len=55、dev_w=28、usb_inset=2、usb_V_off=26.75、btn_dv=8.5、dc_V_off=6.5 |
| `BATTERY_9V` | L=48.5、W=26.5、T=17.5 |
| `BEAM_H` | 2.5 |
| `LOGO_PLAN` | 'L2' |
| `S1_WALL_TOP_V` | 30 |
| `T_PLY` | 3 |
| `C_TAB` | 0.1 |
| `C_SENSOR` | 0.4 |
| `C_HOOK` | 0.2 |

產生耗時 18.9 s。
