kingofamani/CoinSorting/03_v2_光耦版/laser_v2/design/crosstrack_final/spec.md

> **勘誤（2026-10-08）**：這個區塊是事後加的，下面內文保留原樣。產生器實作在 `laser_v2/mods_crosstrack.py`，和內文不同時，以 `laser_v2/out/report.md` 為準。文中的 `scratchpad/v2work/crosstrack_final/` 是舊位置，現在在 `laser_v2/design/crosstrack_final/`。
>
> 1. **鎖塊塞法（a-3 第 3.3 步、a-4）**：第 3.3 步「從前方塞進窗的下半部」不可行。P1 的頂住凸塊在光耦正下方，水平推入會撞到前臂底下的焊腳（n 方向重疊 1.8，模組頂到最高也一樣）。
>    - 正確塞法：C1 拿在手上、P1 那面朝機身。先把 P1 背面貼住 #24 正面（窗的下方），沿 #24 正面往上推，推到凸塊碰到 PCB 下面（S50 同時讓兩支插銷對準方孔）。再往後推 3 mm，讓 P1 進窗、C1 貼平 #24。
>    - a-4 拆換：先把鎖塊往前拉 3 mm，讓 P1 出窗（S50 連插銷一起），再往下拿開，模組會自己落回低位。
>    - 產生器另加檢查 `lock_insert_path`：縫寬減 P1 厚、C1 頂到焊點底，都要 ≥0.1（目前 0.2、0.3）。
> 2. **C1 加 ▲ 方向記號（a-2 第 5 步、(c)）**：
>    - S5／S10 的 P1 外框左右對稱，翻面也套得進。所以 C1 雕刻面下緣另刻一個 ▲，對齊頂住凸塊的位置，站名刻在另一端。黏 P1 時，凸塊要在 ▲ 那一端。
>    - S50 的外框不對稱，不加 ▲。
>    - 站名字墨離 C1 切割邊 ≥1.0：S5、S10 是 em 2.1 直排，S50 是 em 3。
> 3. **新增檢查 `body_locate_wall`（a-1、b-1、d-1、d-2）**：檢查光耦本體貼得到窄段下游壁（光束定位面）的高度，也就是槽底 n_sb 減肩部 n_shoulder，要 ≥0.4（目前 0.7）。
>    - d-2 表 comp_h 那列寫「comp_h ≤2.9 時仍可行」，這不對。只要 comp_h ≥2.7、slot_d ≥9.7 或 arm_top ≤11.3，這面壁就會消失。這時本體改靠 PCB 邊定位，光束沿 s 可能偏 ±0.4。
>    - 名目模組時，這條檢查等於 comp_h ≤2.3，和 d-1 的 Go／No-Go 相同。
> 4. **焊點高（本規格叫 bump_h）**：`params.MODULE['back_h']` 是 2.0（使用者 2026-10-08 決定，和 S1 規格一致），不是本規格名目的 1.5。所以下列數字跟著變：
>    - S5／S10 窗底深 0.5；
>    - P1（S5、S10）由 20.6×11.7 變成 20.6×12.2；
>    - S50 最終位置離出口平面由 0.99 變成 0.52，低位由 −8.22 變成 −8.69；
>    - #24 雕刻「1」的搬移量由 ΔV+18.5 變成 +19。
> 5. **站名不刻在 #24 正面**（使用者 2026-10-08 決定）：a-2 第 3 步的色標改成排線標籤，模組端寫站名，盒端寫插座（例如 S5→G26）。
>    - 老師認站：從轉盤那端往下游數，第 1 個感測窗是 S5、第 2 個是 S10，開到 #24 下緣的缺口是 S50。
> 6. **雕刻樣式與備品**：
>    - 所有 v2 雕刻（框線、▲、字）都是紅色 0.2 mm 線，和原始檔一樣。
>    - 插銷 PIN-S50 每套另排 2 個備品進切割檔。

# S5／S10／S50 跨軌安裝：最終合併規格（裁判版，可直接寫產生器）

> 位置：`scratchpad/v2work/crosstrack_final/`。本文所有數字都由同資料夾腳本重算（shapely；組裝座標以 `python3 -B` 唯讀匯入 repo 的 `laser_v2.frames`／`catalog`）。改 `params.py` 後執行 `./run_all.sh`，數字、JSON、圖會一起更新。
> repo 與原始 SVG 都沒有改動。單位一律 mm。
> 圖：`fig_front.png`（正視）、`fig_section.png`（S50 剖面＋三片隔板 v2）、`fig_parts.png`（新零件）。產生器輸入：`geometry_final.json`（翼朝上游，名目）、`geometry_final_wing_down.json`、`geometry_final_wing_center.json`。

---

## 0. 裁判結論

### 0.1 評分

| 設計 | 分數 | 理由（數字為本資料夾重算） |
|---|---|---|
| d1 前插＋可拆軌道鍵 | **5.0** | 優點：S50 窗下留 6.29、模組不用膠、拆換快、處理了雕刻與排線孔。缺點：**違反定案 6**：每站把 28.81 mm 軌道換成可拆鍵（三站 6 個接縫；S5 的鍵蓋住 1 元開口下方 U116.7～134.6，S50 的鍵在 10 元開口下方，而 10 元餘量只有 0.14）；#26 臂槽吃掉相鄰開口下角（重算 S5 2.53＋2.49、S10 2.34＋2.34、S50 1.69＋1.69 mm²，寬 1.04～1.27）。鍵頂高度受模組「槽底＋PCB 厚」影響，只容許 +0.4。小鍵易遺失。PCB 長邊朝上游是任意選定，沒有討論模組左右手性。 |
| d2 保留橋（槽型）→ 改分離式對射 | **4.0** | 最大貢獻：指出 PCB 寬 20 一定在 #26 後方形成「翼」、伸進相鄰開口的落幣區，所有跨軌槽型方案都避不掉（本規格重算：翼朝下游時伸入下游開口 10.1～10.3 mm、441～486 mm³，與 d2 的 10.4～10.7 相符）。但結論「NO-GO、硬幣一定卡住」只是推論，沒有考慮硬幣重心落在翼後緣之外；建議版 D2-R 要把 S5/S10/S50 改買分離式對射頭，**違反定案 1**，而且零件規格、價格、3.3 V 動作都未查證，收光頭換件要拆 #37。保留為「試切不過時」的備案。 |
| d3 滑升式感測座 | **7.0** | 唯一同時做到「軌道一刀不切、開口零改動、模組不上膠、不拆機就能換」的方案，組裝動作少，敏感度分析清楚。錯誤與缺漏（已重算確認）：① 窗把 #24 正面雕刻「1」「5」整個切掉（重疊 65.0／73.4 mm²，規格沒提）；② 保留條整段 1.8 mm、跨 20.6（估 19 N 就斷）；③ 光孔到上游開口只剩 0.84～0.90；④ S50 窗底在 U182～193 留下 0～3.3 mm 的楔形碎片，P1 還靠它撐；⑤ 隔板局部 y＝V−14.1，laser_v2 驗證值是 V−14.0（差 0.1）；⑥ 窗底沒算 PCB 背面焊點；⑦ 假設光耦置中於 PCB，沒處理左右手性與 S50 出口平面；⑧ 排線翻機頂，長且外露。 |

### 0.2 選定：以 d3 為骨架合併

最終方案＝**d3 滑升式感測座**，加上以下改良：

| 來源 | 合併進來的東西 |
|---|---|
| d1 | 光束高 h＝2.5（三位設計者都認為 3.0 太薄）；#24 窗與 #26 窗做「階梯形」（翼上方較高的肩部）；雕刻改位；排線走右下排線孔→右側空腔；PCB 背面焊點讓位；試切樣板的概念 |
| d2 | 「緊落幣區侵入量」當驗收指標；翼的落點分析；試切不過時的備案（分離式對射） |
| 本輪新增 | 窗窄段單邊只留 0.15，用光耦本體定位光束（不靠 PCB 邊）；光孔改平行四邊形且置中，兩側肉 2.08～2.30（d3 是 0.84）；S50 改成整段開底、不留碎片，C1 兩側各一支插銷；隔板擋面加 2 mm 導角；#6 長榫一律刪除並補一支上方小榫；明列 v2 不再切的原始孔；PCB 翼朝向（模組左右手性）規則與 S50 出口平面閘門；S50 安裝時要先抽出抽屜 |

一句話：每個間隔條下方，#24 與 #26 開同一個階梯窗，軌道下保留 2.3 mm（光耦段）／3.2 mm（翼段）的料。模組在窗的低位水平推入，往上滑 9.8，讓保留條進入槽裡；最後從前方塞入鎖塊（P1＋蓋板 C1）頂住。軌道與四個分幣開口零改動。

---

## 1. 座標與換算（產生器必讀）

| 符號 | 定義 |
|---|---|
| U | 沿機身長邊，0＝右端（轉盤側），246＝左端；從正面看 U 往左增加 |
| V | 沿傾斜面板往下，0＝面板頂，114＝#24 底（U108～236 段 #24、#26 下緣在 V98） |
| W' | 深度，#26 背面＝0，往後為正；#24 在 −6～−3，#26 在 −3～0，#37 內面 29.0（laser_v2 擬合值） |
| 軌道 | #24 斜槽下緣擬合：**V＝0.364032·U＋9.9262**（20.0031°，殘差 0.0013） |
| 單位向量 (U,V) | T＝(0.939674, 0.342072)（沿軌往下游）；N＝(0.342072, −0.939674)（垂直軌道往上） |
| 站座標 (s,n,W') | 原點 O＝光束正下方的軌道點；s 沿 T、n 沿 N；**光束在 (0, h)**。(U,V)＝O＋s·T＋n·N |
| 重力（站座標） | (s,n,W') 分量＝(+0.296, −0.814, +0.500) g：模組會被拉向下游、往下、往後 |
| #24 局部 | (x,y)＝(V,U)；頁座標＝局部＋(2.637, 146.158) |
| #26 局部 | (x,y)＝(V−4, U−40)；頁座標＝局部＋(119.853, 190.677) |
| 隔板 #7/#6/#5 局部 | (x,y)＝(W'+6, V−14.0)（laser_v2 的 DIV_V_OFF＝14.0）；頁座標用 `frames.asm_to_page(pid, Uc, V, W')` |
| #37 局部 | (x,y)＝(114−V, U)（SVG 鏡像） |

`geometry_final.json` 每個多邊形都附三種座標：`UV`（組裝）、`local`（零件 bbox 原點）、`page`（原始檔該頁座標，由 `laser_v2.frames.asm_to_page` 算出）。產生器建議直接用 `page`，或用 `frames` 自行換算。

### 1.1 三站位置（光束置中於立柱，δ＝0）

| 站 | 立柱（間隔條）U | 隔板 | 光束 (U,V) | 原點 O (U,V) | 光束離上游開口終點／下游開口起點（U） |
|---|---|---|---|---|---|
| S5 | 134.604～140.556（5.952） | #7 U135.876～138.876 | (137.580, 57.349) | (136.725, 59.698) | 2.98／2.98 |
| S10 | 164.160～170.193（6.033） | #6 U165.626～168.626 | (167.177, 68.123) | (166.321, 70.473) | 3.02／3.02 |
| S50 | 196.643～203.049（6.406） | #5 U198.376～201.376 | (199.846, 80.016) | (198.991, 82.365) | 3.20／3.20 |

四個開口下緣離軌 1.318／1.332／1.334／1.334（1／5／10／50 元），全部不動。

---

## 2. 參數表（`params.py`）與推導量

### 2.1 模組（暫定，實量後改）

| 參數 | 暫定 | 意義 |
|---|---|---|
| slot_w | 10.0 | 槽寬（兩臂內面距，沿光束＝W'） |
| slot_d | 9.0 | 臂頂到槽底 |
| beam_sb | 5.0 | 光束離槽底 |
| arm_t／arm_w | 7.0／6.4 | 單臂沿光束厚／沿 s 寬（也是本體寬） |
| arm_top | 12.0 | 臂頂離 PCB 上面 |
| pcb_L／pcb_W／pcb_t | 27.6／20.0／1.6 | PCB 沿光束長／沿 s 寬／厚 |
| pcb_e | 0.5 | 光耦本體側邊到 PCB 短邊（本體靠 PCB 一邊） |
| wing | 'up' | PCB 長邊（翼）朝上游。'down'＝朝下游，'center'＝本體置中。**由實品的左右手性決定，見 §d-3** |
| comp_h／bump_h | 2.0／1.5 | PCB 上面零件最高／背面焊點凸出 |
| 排針 | PCB 前端、翼的遠端，直立朝上；含杜邦頭佔光束方向 8.0、往上 14.0 | 位置是假設，見 Go/No-Go |

### 2.2 設計參數

| 參數 | 值 | 意義 |
|---|---|---|
| h | **2.5** | 光束中心離軌（使用者原值「約 3」，待確認，見 §d-4） |
| delta_u | 0／0／0 | 光束 U 相對立柱中心的偏移（試切後可調，見 §d-5） |
| c | 0.4 | PCB 寬段開窗、隔板缺口單邊餘隙 |
| c_body | 0.15 | 窗窄段（光耦本體）單邊餘隙；重力 +s 讓本體貼窄段下游壁，光束因此落在 s＝0 |
| g_strip | 0.2 | 保留條底到光耦槽底 |
| c_slide | 1.0 | 低位時臂頂到保留條底 |
| c_back／c_stop | 0.3／0.5 | 後臂內面到 #26 背面（推到最前）／擋面再讓 0.5 |
| c_v | 0.3 | 零件頂、焊點底的上下餘隙 |
| c_ntop | 1.0 | 隔板缺口在臂頂上方的餘隙 |
| lh_u × lh_n | 1.8 × 3.6 | #26 光孔：U 寬 1.8（沿 s 1.92），垂直軌道 3.6（光束 ±1.8） |
| fit | 0.1 | 新零件與窗、孔的繪製單邊間隙 |
| cap_m | 3.0 | 蓋板 C1 超出窗的邊寬（S50 兩側 7.0，放插銷） |
| v_drawer | 97.5 | #24 前方任何東西的 V 上限 |
| min_web | 2.0 | 新切割留下的料小於此值就併入開口 |

### 2.3 推導量（站座標，h＝2.5）

| 量 | 公式 | 值 |
|---|---|---|
| 槽底 n_sb | h − beam_sb | −2.5 |
| 臂頂 | n_sb＋slot_d | +6.5 |
| PCB 上／下面 | n_sb−(arm_top−slot_d)／−pcb_t | −5.5／−7.1 |
| 零件頂／焊點底 | −5.5＋comp_h／−7.1−bump_h | −3.5／−8.6 |
| **保留條底（窄段頂）** | n_sb＋g_strip | **−2.3** → #24 保留條 2.3 |
| **肩部（寬段頂）** | 零件頂＋c_v | **−3.2** → #24 肩部 3.2 |
| 上滑行程 slide | 臂頂−(保留條底−c_slide) | **9.8** |
| 窗底 | 焊點底−slide−c | **−18.8** |
| 擋面 W_stop | c_back＋c_stop＋arm_t | W' 7.8 |
| 後臂／前臂（靜止） | — | W' 0.8～7.8／−16.2～−9.2 |
| PCB（靜止） | 前臂外面−1.8～後臂外面＋1.8 | W' −18.0～9.6 |
| 隔板深缺口後壁 | PCB 後端＋c | W' 10.0 |
| PCB 在 s 的範圍（wing＝up） | −(pcb_W−arm_w/2−pcb_e)～arm_w/2＋pcb_e | −16.3～+3.7 |

---

## (a) 概念與安裝步驟

### a-1 概念

- 模組兩臂朝上（沿 n），光束沿 W' 穿過：前臂（#24 前方）→ 硬幣通道（#24 斜槽）→ #26 立柱上的光孔 → 後臂（#26 後方）。
- 槽底在軌道下 2.5。#24 在軌道下保留 2.3 mm（光耦本體正上方那 6.7 寬）／3.2 mm（PCB 翼上方的肩部），**軌道與斜槽一刀不切**。#26 同位置保留 3.62／4.52（到開口唇）。
- 模組沒辦法直接從前面套進去（後臂會撞保留條），所以窗往下多開 9.8：先在低位水平推入，再上滑。
- 定位全靠形狀與重力：
  - 上下：P1 頂住 PCB 下面，保留條在槽裡擋住往上（間隙 0.2）。
  - 前後：重力 0.5 g 把後臂外面壓在隔板缺口的擋面（W' 7.8）；往前最多動 0.5，就被 #26 背面擋住。
  - 沿軌：重力 0.296 g 讓光耦本體貼在窗窄段的下游壁，光束正好在立柱中心（窄段單邊只留 0.15）。
- 不用螺絲、模組不上膠，不拆機身就能換。
- 計數公式不變：N50＝C50、N10＝C10−C50、N5＝C5−C10、N1＝C1；防錯 C5≥C10≥C50。

### a-2 講師預組（研習前；每套 3 組，約 5 分鐘／套）

1. **先量模組**（§d-1 的 Go/No-Go 清單）。第一次拿到的那批要先量，改 `params.py` 重跑，再切 v2。
2. **測模組**：接 3.3 V（V 排針），用最薄的 5 元慢推過槽，燈號要穩定；記下遮擋時是 HIGH 還是 LOW。
3. **接線**：3P 母母杜邦線（建議 30～40 cm，視電子盒位置）插在模組排針上，排針根部點熱熔膠，兩端貼色標 S5／S10／S50。
4. **包翼**：PCB 翼上的零件面包一層電工膠帶或 PI 膠帶（厚 ≤0.15，不可用 0.5 PET 片，會吃掉 0.3 的零件餘隙），讓落下的硬幣碰到的是平滑面。
5. **做鎖塊**（每套 3 個）：
   - C1 背面（切割時朝上的那面）雕有 P1 外框、插銷方塊和站名。照外框把 P1 用白膠黏上，P1 的「頂住凸塊」要在上緣。
   - S50 另把 2 支 3×3 插銷黏在 C1 雕刻的方塊上。建議先把插銷插進試切小樣（§g T1）的 #24 孔，再把 C1 壓上去黏，位置最準。
6. 交給老師的散件：3 組「模組＋線」、3 個鎖塊（另備 1 組模組與鎖塊）。

### a-3 老師組裝（機身照原流程組好之後；每站約 1 分鐘）

1. 換用 v2 的 #7／#6／#5（隔板）。#6 v2 多一支上方小榫，插 #26 的新槽；#5、#6 已經沒有長榫，#24、#26 對應的長榫孔也沒有切，屬正常。
2. **裝 S50 前先把 10 元、50 元抽屜抽出來**（S50 在低位時會伸到出口平面下約 8 mm）。
3. 每站（S5→S10→S50）：
   1. 模組兩臂朝上、排針朝自己，對準窗的**下半部**，水平往機身裡推，後臂先過。推到 PCB 後端碰到隔板缺口為止（前臂內面離 #24 前面約 3.2～3.7）。
   2. 把模組**往上推約 10 mm**，推到推不動（光耦槽底碰到保留條）。後臂頂上方的隔板有 2 mm 導角，推的時候會自動把模組往前帶 0.2。
   3. 一手頂住模組，一手把鎖塊從前方塞進窗的下半部（P1 進 #24 的窗、C1 貼 #24 正面）。S50 同時把 2 支插銷插進 #24 的兩個方孔。
   4. 放手。模組被重力壓回擋面與窄段下游壁，自動定位。
4. 排線：杜邦線沿 #24 正面往下，在 V≈95（各站 C1 下方或前方）往右集中，穿過右下排線孔（U91.5～101.5、V103.5～108）進入右側空腔，再穿 #37 的孔（位置由電子盒規格定）。用 2～3 點熱熔膠或背膠線扣固定。
5. 推回抽屜。每種硬幣各丟 5 枚確認分級與計數。

### a-4 拆換一站（約 1 分鐘）

拔出鎖塊（往前拉；S50 連插銷一起拉）→ 模組自己落回低位 → 水平往前抽出 → 換新 → 照 a-3 第 3 步裝回。S50 拆換時同樣先抽出 10、50 元抽屜。

---

## (b) 原始零件修改

### b-0 產生器流程

1. 用 `laser_v2.catalog.load_catalog()` 取零件；`fix_26_tooth_hole()`（KNOWN_DEFECTS apply＝True，「順便修 bug」那一項）照常套用，和本規格的修改不衝突（該孔在 U105、V84～88，離本規格最近的新切割約 15，#26 同排另一孔離排線孔 8.72）。
2. 每站依 §2.3 的公式在站座標建立窗、光孔、插銷孔，用 §1 換到 UV，再換到零件頁座標。或直接讀 `geometry_final.json` 的 `page`。
3. 依 b-1～b-4 做布林運算；刪除 b-5 列的原始孔；搬雕刻（b-6）。
4. 輸出前跑 `validity.py` 的同類檢查：每片仍是 1 塊、開口與斜槽距新切割 ≥2.0、新切割之間 ≥2.0。

### b-1 窗（#24、#26 同形）

站座標定義（兩個矩形的聯集）：

| 部分 | s 範圍 | n 範圍 | 用途 |
|---|---|---|---|
| 窄段（本體） | [−arm_w/2−2·c_body, arm_w/2]＝**[−3.5, +3.2]** | [窗底, 保留條底]＝**[−18.8, −2.3]** | 光耦本體、後臂通過；下游壁是光束定位面 |
| 寬段（PCB） | [−(pcb_up＋c), pcb_dn＋c]＝**[−16.7, +4.1]**（wing＝up） | [窗底, 肩部]＝**[−18.8, −3.2]** | PCB、零件、焊點通過 |
| S50 加開 | 寬段沿 −n 延伸到外框外 | — | 窗底低於 #24／#26 下緣 V98（軌下只剩 14.40），改成開底缺口，產生器用「外形.difference(窗)」，不留楔形碎片 |

依暫定值算出的頂點（逆時針；#24 局部 x＝V、y＝U；#26 局部 x＝V−4、y＝U−40）：

| 站 | #24 局部 (x,y) | #26 局部 (x,y) |
|---|---|---|
| S5（新增封閉孔） | (78.767,134.146) (64.108,139.483) (63.800,138.637) (62.954,138.945) (60.662,132.649) (61.508,132.341) (56.993,119.938) (71.652,114.601) | (74.767,94.146) (60.108,99.483) (59.800,98.637) (58.954,98.945) (56.662,92.649) (57.508,92.341) (52.993,79.938) (67.652,74.601) |
| S10（新增封閉孔） | (89.541,163.743) (74.882,169.080) (74.574,168.234) (73.729,168.542) (71.437,162.246) (72.282,161.938) (67.767,149.534) (82.426,144.198) | (85.541,123.743) (70.882,129.080) (70.574,128.234) (69.729,128.542) (67.437,122.246) (68.282,121.938) (63.767,109.534) (78.426,104.198) |
| S50（外形相減） | (85.621,201.211) (83.329,194.915) (84.175,194.607) (79.660,182.204) (103.0,173.707) (103.0,195.842) (86.775,201.749) (86.467,200.903) | (81.621,161.211) (79.329,154.915) (80.175,154.607) (75.660,142.204) (99.0,133.707) (99.0,155.843) (82.775,161.749) (82.467,160.903) |

（S50 的 x＝103 那兩點在外框外，只是相減用。）

### b-2 #26 光孔（3 個）

- 形狀：平行四邊形。上下緣平行軌道，在 n＝h±lh_n/2＝**0.7～4.3**；左右邊沿 V（和開口邊平行），U＝光束 U ± lh_u/2（±0.9）。
- 這樣兩側的肉一樣厚，而且不隨高度變：S5 2.08、S10 2.12、S50 2.30（d3 是 0.84～0.90）。

| 站 | UV 頂點 | #26 局部 (x,y) |
|---|---|---|
| S5 | (136.680,58.937) (138.480,59.592) (138.480,55.761) (136.680,55.106) | (54.937,96.680) (55.592,98.480) (51.761,98.480) (51.106,96.680) |
| S10 | (166.277,69.711) (168.077,70.367) (168.077,66.536) (166.277,65.880) | (65.711,126.277) (66.367,128.077) (62.536,128.077) (61.880,126.277) |
| S50 | (198.946,81.604) (200.746,82.259) (200.746,78.428) (198.946,77.773) | (77.604,158.946) (78.259,160.746) (74.428,160.746) (73.773,158.946) |

### b-3 隔板 #7／#6／#5 → v2（缺口＋擋面）

**缺口算法**（`model.py`）：

1. 取模組在 W'>0 的實體，在「最終位置」到「低位」之間的上滑掃掠範圍：
   - 臂＋本體：s ±3.2，n 從 PCB 上面−slide 到臂頂。
   - PCB＋零件＋焊點：PCB 的 s 範圍，n 從焊點底−slide 到零件頂。
2. 和隔板板厚帶（U 範圍）相交，得到 V 範圍。
3. 缺口由兩部分組成：
   - 擋面段：深到 W' 7.8（擋面），V 從臂頂往上再讓 c_ntop＝1.0。
   - 深段：深到 W' 10.0，V 為 PCB 掃掠範圍 ±0.4。
4. 擋面下端加 45° 導角 2 mm（W' 7.8→10.0）。
5. 缺口從 W'＝−6.5 開始，所以落在範圍內的前榫一起切掉；剩不到 4 mm 的榫整支刪除。
6. 缺口底到隔板斜底邊不足 2.0 時，直通底邊。

| 隔板 | 缺口（(W',V)：擋面段／導角／深段） | 局部 (x＝W'+6, y＝V−14) 新外形的缺口段頂點 | 榫的處理 |
|---|---|---|---|
| #7 v2（S5） | W'7.8：V51.50～60.71；導角到 (10.0, 62.71)；W'10.0：到 V73.25 | (6,37.496) (13.8,37.496) (13.8,46.714) (16.0,48.714) (16.0,59.246) (6,59.246) | 中段小榫（V64.45～74.45）**刪除**；上小榫 V17～24、長榫 V84.45～92.45 **保留** |
| #6 v2（S10） | W'7.8：V62.30～71.54；導角到 73.54；W'10.0：到 V83.60 | (6,48.302) (13.8,48.302) (13.8,57.544) (16.0,59.544) (16.0,69.6) (6,69.6) | 長榫（V84.45～92.45）**刪除**（翼朝上游時 S10 窗離長榫孔只剩 0.09，翼朝下游時直接切到，所以一律刪）；**新增上方小榫** x3～6、y17～24（V31～38），插 #26 新槽（b-4） |
| #5 v2（S50） | W'7.8：V74.22～83.47；導角到 85.47；W'10.0：一路通到斜底邊（前下角去掉，新底邊從 (W'10.0, V92.48) 接回原斜底邊） | (6,60.224) (13.8,60.224) (13.8,69.466) (16.0,71.466) (16.0,78.484)→原斜底邊 | 長榫**刪除**；上小榫 V17～27、V35～45 與後榫保留 |

- 三片切完都仍是 1 塊（`validity.py`）。完整新外形（含原圓角）在 `geometry_final.json → stations.*.divider.new_outline`（WV／local／page）。
- 三片要雕刻「S5 v2」「S10 v2」「S50 v2」（文字轉路徑），放在 v2 修改層。
- #37 上三個隔板後榫槽不動。KNOWN_DEFECTS 的 'divider-rear-tenon'（可選修正）照產生器原決定處理即可。

### b-4 #26 其他新增

| 項目 | UV | #26 局部 | 檢查 |
|---|---|---|---|
| #6 新小榫槽 | U165.676～168.576 × V31.05～37.95 | x 27.05～33.95，y 125.676～128.576 | 2.9×6.9（照原檔 3 mm 榫槽畫 2.9、長度少 0.1 的慣例）；離開口 7.71、離既有槽 4.10 |
| 排線孔 10×4.5 | U91.5～101.5 × V103.5～108.0 | x 99.5～104.0，y 51.5～61.5 | 離 #26 外緣 3.00、其他孔 8.72、#13 3.38 |

### b-5 #24 其他新增與 v2 不再切的原始孔

| 項目 | UV | #24 局部 | 說明 |
|---|---|---|---|
| S50 插銷孔（上游） | 中心約 (175.9, 86.7)；頂點 (174.046,87.598) (176.771,88.590) (177.763,85.865) (175.038,84.873) | 頂點 x/y 對調 | 2.9×2.9，邊平行 s/n；離窗 2.05、離斜槽 10.55、離外緣 9.41 |
| S50 插銷孔（下游） | 中心約 (203.8, 91.3)；頂點 (201.965,92.174) (204.690,93.166) (205.682,90.441) (202.957,89.449) | 同上 | 離窗 2.05、離斜槽 5.30、離外緣 4.83 |
| 排線孔 10×4.5 | U91.5～101.5 × V103.5～108.0 | x 103.5～108.0，y 91.5～101.5 | 圓角 R1 可選；離外緣 3.19、其他孔 8.72、轉盤圍邊 8.62 |

**v2 不再切的原始孔**（刪掉該子路徑，不是改形）：

| 零件 | 孔 | 理由 |
|---|---|---|
| #24、#26 | U198.42～201.33 × V84.50～92.40 | #5 長榫已刪（S50 開底缺口） |
| #24、#26 | U165.67～168.58 × V84.50～92.40 | #6 長榫已刪 |
| #26 | U135.93～138.83 × V64.50～74.40 | #7 中段小榫已刪（大部分落在 S5 窗內，剩下的不要切） |

### b-6 #24 雕刻搬移（`export.py` 自動搜尋最小平移，新位置離所有切割 ≥1.5）

| 雕刻 | 原位置 UV | 搬移 | 新位置 UV | 說明 |
|---|---|---|---|---|
| 「1」（text16-7-2） | U123.83～130.58，V63.81～73.56 | ΔV＋18.5 | V82.31～92.06 | 原位置整個落在 S5 窗內，移到 S5 蓋板下方 |
| 「5」（text11-4-1） | U150.15～158.77，V73.81～83.56 | ΔV−52.5 | V21.31～31.06 | S10 窗下方沒有空間，移到斜槽上方，和「10」「50」同一排 |

頁座標的平移量＝(Δx, Δy)＝(ΔV, ΔU)（#24 局部 x＝V、y＝U）。翼朝下游或置中時，搬移量相同（已重算）。

### b-7 #37

本規格不改 #37。三條感測器線經右側空腔（U72.1～104.9）到 #37，#37 上的穿線孔位置由電子盒規格決定（建議在 U80～100、V60～95 範圍內開一個 ≥10×5 的孔）。

---

## (c) v2 新增零件（3 mm 合板；每套 8 件，另建議每套多附 1 組）

局部座標：原點＝零件左下角；x 沿 s（往下游）、y 沿 n（往上）。這是「從 #24 那面看」的視角，所以**照圖直接切時，朝上的雕刻面就是貼 #24 的背面**。

| 零件 | 數量 | 外形（局部，逆時針） | 尺寸／配合 |
|---|---|---|---|
| **P1 鎖塊**（S5、S10 同形） | 2 | (0,0) (20.6,0) (20.6,9.9) (19.7,9.9) (19.7,11.7) (13.2,11.7) (13.2,9.9) (0,9.9) | 20.6×11.7，放在 #24 窗內（W' −6～−3），兩側各 0.1 繪製間隙。底邊坐在窗底。頂面只有 x 13.2～19.7（6.5 寬，在光耦正下方）頂住 PCB 下面；其餘低 1.8，讓焊點 |
| **P1 鎖塊**（S50） | 1 | (0,0) (20.6,7.499) (20.6,13.249) (19.7,13.249) (19.7,15.049) (13.2,15.049) (13.2,13.249) (0,13.249) | 20.6×15.05；底邊是 V97.5 截線（不伸出 #24 下緣） |
| **C1 蓋板**（S5、S10 同形） | 2 | 矩形 26.8×12.9 | 在 #24 前方（W' −9～−6）。上緣在 n −8.9（比焊點低 0.3）。P1 黏在 (3.1, 3.0)。雕刻面（背面）刻 P1 外框與站名 |
| **C1 蓋板**（S50） | 1 | (0,0) (34.8,12.668) (34.8,23.734) (28.0,23.734) (28.0,15.834) (6.8,15.834) (6.8,23.734) (0,23.734) | 34.8×23.7；兩側耳在 PCB 範圍外往上長到軌下 1.0；底邊是 V97.5 截線。P1 黏在 (7.1, 2.585)；插銷黏在 (2.0, 11.234) 與 (29.8, 16.484)（方塊左下角） |
| **插銷**（S50） | 2 | 3.0×3.0 方塊 | 長 3.0（＝#24 板厚，剛好頂到 #26 前面）。#24 孔畫 2.9×2.9 |

- 面積：P1 215.6×2＋207.4，C1 345.7×2＋438.0，插銷 9×2，每套約 1,790 mm²，可放進第 3 張的零碎空間。
- 為什麼要兩層（P1＋C1）：P1 單獨一片會被推進 #26 的窗裡掉到後面；C1 是擋邊兼把手。
- 為什麼 S50 要插銷：S50 是開底缺口，P1 下面沒有東西撐。插銷在窗的兩側各一支，鎖塊不會轉。
- 鎖塊不靠摩擦：重力 0.5 g 把 C1 壓向 #24，加上模組壓在 P1 上。整台往前倒放時鎖塊可能滑出，模組會落回低位，但不會壞。若要更牢，在 C1 一角和 #24 之間點一點熱熔膠（拆時剝掉）。

---

## (d) 參數與敏感度

### d-1 Go／No-Go（拿到實品第一件事）

| 項目 | 條件 | 不符合時 |
|---|---|---|
| 槽寬 | ≥7.5（10 mm 槽有 2.5 餘裕） | 5 mm 槽寬模組不能用 |
| 排針＋杜邦頭 | 必須在 PCB 沿光束方向離「前緣」11.5 以內（才會在 #24 前面）；朝上或朝前都可以 | 在 PCB 中段 → 杜邦頭會在 #24/#26 板內或滑道內：No-Go（除非把排針彎 90°） |
| 排針朝下 | S5、S10 可以；**S50 不可以**（會低於 #24 下緣、擋到抽屜） | S50 換一個排針朝上的模組 |
| 左右手性（翼的方向） | 排針朝自己、兩臂朝上時，PCB 長邊在**右邊（往上游）**＝wing 'up'，三站都過 | 長邊在左（'down'）：S5、S10 可用（翼在下游，反而好）；**S50 翼會低於滑道出口平面 3.3**，伸進抽屜區 → 見 d-3 |
| PCB 上的高零件 | 翼上零件 ≤2.3（例如沒有可變電阻） | 有 >2.3 的零件（可變電阻約 5～7）：要量它的 W' 位置。在 #24/#26 板厚範圍（W' −6～0）或 #26 後方的，都要重算；可能 No-Go |
| 光耦本體是否有固定耳 | 本體沿 s 只有 6.4 寬 | 有耳就要量並加入參數，窄段要加寬 |

### d-2 v2 已依名目切好、實品尺寸偏差多少會失效（`sens.py`，一次只動一個）

| 模組尺寸 | 名目 | 容許 −／＋ | 先失效的項目 | 補救 |
|---|---|---|---|---|
| beam_sb（光束離槽底） | 5.0 | −1.2／+1.2 | 光束（收發窗高約 1.2）跑出光孔 n 0.7～4.3 | 改 P1 高度 |
| slot_d（臂頂到槽底，arm_top 不變） | 9.0 | −0.2／+1.2 | −：槽底頂到保留條，P1 塞不進；+：光束太低 | −：把 P1 頂面磨低（光束跟著降，仍在孔內） |
| arm_top（臂頂離 PCB） | 12.0 | −1.2／**+0.2** | +：槽底頂到保留條 | 磨低 P1 頂面同樣的量 |
| pcb_t | 1.6 | −1.2／**+0.2** | 同上 | 同上 |
| arm_w（本體寬） | 6.4 | −0.9／**+0.3** | +：本體進不了窄段；−：光束沿 s 偏出光孔 | 重切窄段（改 c_body） |
| arm_t | 7.0 | −0.4／+0.8 | −：PCB 後端頂到深缺口；+：後臂內面碰 #26 背面 | 改擋面深度 |
| slot_w | 10.0 | −0.8／不限 | PCB 後端頂到深缺口 | 改深缺口 |
| pcb_L | 27.6 | 不限／+0.8 | PCB 後端頂到深缺口 | 同上 |
| pcb_W | 20.0 | 不限／+0.7 | PCB 翼端碰窗 | 重切窗 |
| pcb_e（本體離 PCB 短邊） | 0.5 | −0.45／+0.4 | PCB 短邊碰窗 | 重切窗 |
| comp_h | 2.0 | 不限／**+0.3** | 零件頂到 #24/#26 肩部 | 肩部可降到和保留條同高（comp_h ≤2.9 時仍可行） |
| bump_h | 1.5 | 不限／**+0.3** | 焊點碰 P1 讓位或窗底 | 改 P1 讓位深度 |

**結論**：最敏感的是「槽底離 PCB 下面」（arm_top−slot_d＋pcb_t，名目 4.6），只容許 +0.2；但超過時只要把 P1 頂面磨低，不必重切。真正要重切的是 arm_w +0.3、comp_h +0.3。**v2 檔必須在實量後定稿**，上表是給「同一批模組個體差」與量測誤差用的。

### d-3 翼的方向（模組左右手性）——三種情形都算過

| 指標 | wing＝up（名目） | wing＝down | wing＝center |
|---|---|---|---|
| 上游開口落幣區侵入（d2 緊模型） | 814～834 mm³，伸入 15.9～16.1 | 203～223，4.1～4.3 | 509～529，10.0～10.2 |
| 下游開口落幣區侵入 | 0 | 441～486，10.1～10.3 | 167～180，4.1～4.4 |
| S10 窗底到 #24 下緣 | 8.46 | 4.15 | 6.30 |
| S10 低位離出口平面 | +3.68 | −0.63（要先抽 10 元抽屜） | +1.52 |
| **S50 最終位置離出口平面（含焊點區）** | **+0.99** | **−3.32（失效）** | **−1.16（失效；PCB 本身 +0.34）** |
| 雕刻搬移 | 「1」↓18.5、「5」↑52.5 | 同左 | 同左 |

- 上游開口的硬幣翻倒時，會在開口裡**往下游漂**，正好撞上游的翼。下游的翼則在硬幣「剛離開立柱、開始翻」的位置。整體來說 'down' 對 S5、S10 比較好，但 S50 在 50 元出口平面上方只有 8.7 mm，'down' 放不下。
- 拿到實品若是 'down'：先請使用者量「抽屜側牆頂到滑道出口」的實際間隙（照片看約 1～3 mm）。不夠時，S50 換一個鏡像佈線（'up'）的模組，或接受 S50 改用分離式對射（備案）。

### d-4 光束高度 h 的比較（使用者原值「約 3」）

| h | #24 保留條／肩部 | S10 窗底殘料 | S50 離出口平面 | 相貼 5–5／10–10／50–50 空隙（光束高） | 光孔下緣離軌 |
|---|---|---|---|---|---|
| 2.0 | 2.8／3.7 | 7.93 | 0.46 | 9.35／12.14／13.58 | 0.2（太貼軌道） |
| **2.5（採用）** | **2.3／3.2** | **8.46** | **0.99** | **8.04／10.67／12.03** | **0.7** |
| 3.0 | 1.8／2.7 | 8.99 | 1.52 | 6.90／9.39／10.68 | 1.2 |

保留條強度（MDF 破壞模數約 30 MPa、兩端固定、中央集中載重、整跨 20.6 的保守估計）：h＝3.0 約 19 N（＝d3），h＝2.5 約 31 N；肩部 3.2 那段約 60 N。

### d-5 光束沿軌偏移 δ（試切後可調）

| δ（U） | S5 下游幣掃到後臂頂角深度 | 光孔肉（上游／下游） | 光束離上游開口終點 |
|---|---|---|---|
| **0（採用）** | 2.38（S10 2.53、S50 2.60） | 2.08／2.08 | 2.98 |
| −0.5 | 1.89 | 1.58／2.58 | 2.48 |
| −1.0 | 1.36 | 1.08／3.08 | 1.98 |

- 掃到深度是最慢的情形：硬幣剛離開立柱就開始翻、完全沒有往下游的速度。翻到約 75° 時，硬幣面擦過後臂頂的下游角。
- 估計硬幣從開始翻到 75° 約 90 ms。以 0.1～0.3 m/s 的滾速，這段時間會往下游走 9～27 mm，實際上通常碰不到。
- 採用 δ＝0 的理由：光孔兩側肉最厚，光束離上游開口最遠（約 3，比 d1 的 2.4、d3 的 2.3 遠），可以降低前一種硬幣滾過頭造成的多計。若試切 T3 看到下游幣翻倒時被後臂頂住或猶豫，改 δ＝−0.5 重切。

---

## (e) 干涉檢查（`checks.py` → `checks_out_up.txt`；翼朝上游、h＝2.5）

| 對象 | 檢查 | S5 | S10 | S50 | 判定 |
|---|---|---|---|---|---|
| 軌道 | 新切割到軌道（斜槽下緣）最小距 | 2.3 | 2.3 | 2.3 | ✓ 軌道零改動，沒有接縫 |
| 分幣開口 | 窗到最近開口 | 3.62 | 3.63 | 3.64 | ✓ 開口零改動 |
| | 光孔到上游／下游開口 | 2.08／2.08 | 2.12／2.12 | 2.30／2.30 | ✓ |
| | 光孔到窗 | 3.0 | 3.0 | 3.0 | ✓ |
| #24／#26 結構 | #24 保留條（光耦段／肩部） | 2.3／3.2 | 同 | 同 | 估 31～60 N |
| | #26 到開口唇（光耦段／肩部） | 3.62／4.52 | 3.63／4.53 | 3.63／4.53 | ✓ |
| | 窗底到 #24 下緣 | 19.23 | 8.46 | 開底 | S50 為開底缺口，無碎片 |
| | 窗到其他保留孔 | 6.00 | 5.76 | 34.4 | ✓ |
| | 合成後是否 1 塊 | #24、#26 都是 1 塊（三種翼向都是） | | | ✓ |
| 硬幣（立著滾） | 前臂內面到 #24 前面（靜止／推到最前） | 3.2／3.7 | 同 | 同 | ✓ |
| | 前臂內面到硬幣前面 | ≥4.3（50 元） | 同 | 同 | ✓ |
| 翻倒掃掠 | 後臂伸出立柱陰影（唇以上，mm²；最大寬） | 上游 0.29（0.44）／下游 3.05（1.40） | 0.24（0.39）／2.87（1.36） | 0.06（0.20）／2.14（1.17） | 見 d-5、R3 |
| | 下游幣掃到後臂頂角（最慢情形） | 5 元 2.38 | 10 元 2.53 | 50 元 2.60 | R3 |
| | 上游幣落下漂移碰後臂側面 | 1 元 1.70 | 5 元 1.14 | 10 元 0.32 | 側面像隔板一樣，屬一般碰撞 |
| 落下掃掠（翼） | 翼伸入上游滑道 U／V／W' | U118.47～135.88、V57.41～68.54、W'0～9.6 | U148.06～165.63、V68.19～79.37 | U180.73～198.38、V80.08～91.29 | **R1** |
| | 翼頂（零件頂）低於開口唇 | 4.82 | 4.83 | 4.83 | |
| | d2 緊落幣區侵入 | 1 元 834 mm³ | 5 元 830 | 10 元 814 | **R1** |
| 出口平面／抽屜 | 最終位置離出口平面 | 23.66 | 12.88 | **0.99** | ✓（S50 最緊） |
| | 低位（安裝時）離出口平面 | 14.45 | 3.68 | **−8.22** | 裝 S50 時先抽出 10、50 元抽屜 |
| | #24 前方零件最大 V／比 #24 前下角高（世界鉛直） | 82.61／13.33 | 93.39／4.00 | 97.5／0.43 | ✓（抽屜面板頂在 #24 下緣之下） |
| 隔板 | 切後件數／擋面接觸長（V） | 1／51.5～60.7 | 1／62.3～71.5 | 1／74.2～83.5 | ✓ |
| #13（右櫃側板，S1 牆） | 模組最右 U 到 #13 | 10.59 | 40.2 | 72.9 | ✓ |
| #37 | 模組最深 W' 9.6，離 #37 內面 | 19.4 | 19.4 | 19.4 | ✓ |
| 轉盤 #27／#63（R54.5） | C1／排針到圍邊 | 3.09／7.72 | 34.6／38.8 | 65.4／73.4 | ✓ |
| 馬達盒（U≤72.1） | 模組最右 U 到馬達盒 | 46.4 | 76.0 | 108.6 | ✓ |
| 計數 | 光孔下緣（n0.7）處弦長 | 5 元 7.72、10 元 8.42、50 元 8.74 | | | 光孔沿 s 寬 1.92，一定完全遮住 |
| | 相貼兩枚在光束高的空隙 | 5–5 8.04、5–10 9.27、5–50 9.85 | 10–10 10.67、10–50 11.33 | 50–50 12.03 | 0.3～0.5 m/s 約 16～40 ms |
| 排線孔 | 在 #24、#26 實料內（離外緣 3.19／3.00）、離其他孔 8.72、離轉盤圍邊 8.62、離 #13 3.38 | | | | ✓ |
| 排線路徑 | 排針（W' −18～−10）→ #24 正面 V≈95 → 排線孔 → 右側空腔 → #37 | 粗估 17 cm | 19 cm | 21 cm | 不經過斜槽、開口、滑道。粗估到 #37 背面附近；電子盒 d1 依盒位估 25～31 cm，建議用 30～40 cm 線 |

**給 S1（方案 A）設計的協調數字**：翼朝上游時，S5 的翼在 1 元滑道 U118.47～135.88、V57.41～68.54、W' 0～9.6。S1 的導流件、模組臂、光束都不可進入這個範圍；1 元硬幣可能先被翼撥一下才往下落。翼朝下游時，1 元滑道只剩 U130.3～135.9 的小角。

**給電子盒設計的協調數字**：三條線從右下排線孔（U91.5～101.5、V103.5～108）進入右側空腔，需要 #37 在 U72.1～104.9 範圍內有一個 ≥10×5 的穿線孔。

---

## (f) Python 檢查與示意圖

| 檔案 | 作用 |
|---|---|
| `params.py` | 參數與推導量（可用環境變數 `CT_OVR='{"wing":"down"}'` 覆寫） |
| `geom.py` | 唯讀匯入 `laser_v2`：#24/#26/#37 外形與孔、軌道擬合、開口、立柱、隔板 (W',V) 外形、出口平面、雕刻框 |
| `model.py` | 各站窗、光孔、模組實體（最終／低位）、隔板缺口與榫、P1/C1、S50 插銷、#6 新榫槽、排線孔、不再切的孔 |
| `checks.py` | (e) 全部數字；含硬幣翻倒＋落下掃掠（以唇為軸 0～180°，>90° 後沿重力落下並往下游漂）、d2 緊落幣區侵入體積（W' 每 0.25 切片） → `checks.json`、`checks_out_{up,down,center}.txt` |
| `validity.py` | 合成 v2 #24/#26/隔板：有效、1 塊、開口與斜槽距新切割 → `validity.json` |
| `sens.py` | (d-2) 容許量、(d-4) h 比較 → `sens.json` |
| `delta_sweep.py` | (d-5) 光束偏移取捨 → `delta_sweep.json` |
| `review.py` | 重算 d1／d3 的關鍵數字 → `review.json` |
| `export.py` | 產生器輸入 `geometry_final*.json`（UV／局部／頁座標、雕刻搬移、刪孔清單） |
| `fig.py` | `fig_front.png`、`fig_section.png`、`fig_parts.png` |
| `run_all.sh` | 依序全部重跑（`python3 -B`，不寫 .pyc 進 repo） |

---

## (g) 風險與試切

### g-1 風險（依嚴重度）

- **R1（高）PCB 翼在落幣區。** 只要用 PCB 寬 20 的槽型模組跨軌，就一定有一片翼伸進相鄰滑道（d2 的發現，本輪確認）。翼朝上游時，上游幣會落在翼上（侵入 814～834 mm³）。
  - 不會停在翼上的理由：翼面對水平傾 35.5°，μ 要 ≥0.71 才停得住；而且硬幣翻過唇時，重心在 W' ≥10，已經在翼後緣（9.6）之後。
  - 但可能被彈一下、改變落點，或勾到零件。
  - 對策：翼包膠帶（a-2）；試切 T3 每格 100 枚驗收：0 卡幣、計數正確。
  - **不過時的備案**：S5/S10/S50 改用分離式對射（d2 的 D2-R），要使用者同意改買零件。
- **R2（高，Go/No-Go）模組實際尺寸、排針位置、左右手性未知。** 見 d-1、d-3。S50 對左右手性最敏感。
- **R3（中）下游幣翻倒時擦到後臂頂角**（最慢情形深 2.4～2.6）。動態上應該碰不到。若試切看到硬幣被頂住或猶豫，改 δ＝−0.5 重切（代價見 d-5）。
- **R4（中）#24／#26 變弱。** 三個窗加上 S50 開底缺口；#5、#6 長榫與 #7 中段小榫刪除後，#24 下段只靠 #7 長榫、#13/#21 齒與端板固定。保留條 2.3（估 31 N）、肩部 3.2（估 60 N）。
  - 發料時 #24 平放、拿取時避免扳。
  - 備料每 10 套多切 2 片 #24、#26。
- **R5（中）光束離上游開口終點約 3.0**（d1/d3 是 2.3～2.7）。滾過頭的前一種硬幣可能擋一下光束而多計。程式保留 C5≥C10≥C50 檢查。
- **R6（中，跨領域）計數時序。** 相貼兩枚 5 元的亮區在光束高 8.04（扣收發窗後約 6～7），0.3～0.5 m/s 時約 12～27 ms。最壞情形（光束偏到光孔頂 n4.3、整個光孔寬 1.92 都算進去）只剩 2.64 mm，約 5～9 ms。程式要用中斷計數，「連續未遮約 3～5 ms 才重新上膛」；紀錄 3-4 的「前緣起算 30 ms 防重複」可能把兩枚算成一枚。這不在雷切範圍，請轉給寫程式的人。
- **R7（低中）鎖塊只靠重力。** 整台往前倒放時可能滑出（模組落回低位，不會壞）。可點一點熱熔膠。
- **R8（低）S50 安裝與拆換要先抽出 10、50 元抽屜。**
- **R9（低）雕刻「5」改到斜槽上方。** 外觀和原機不同，請使用者確認。
- **R10（低）排線在 #24 正面。** 要固定；拆 S50 鎖塊時要先撥開線。
- **R11（低）環境光。** 收光端在後臂，只看 1.92×3.6 的光孔，前方有前臂擋住；窗邊仍要實測。
- **R12（低）切縫與板厚。** 原檔沒有做切縫補償，本規格也不做。切縫 0.15 時，光束約低 0.15、保留條約薄 0.15、槽底間隙約 0.5，都在餘量內。板厚 3.2 時前臂間隙仍有 2.7。

### g-2 試切項目（先切小樣，再切整台）

- **T1 小樣（S50＋S10）**：
  - 切 #24、#26 的 U165～215、V40～98 片段，#6 v2、#5 v2，各站 P1/C1，S50 插銷。
  - 量實際切縫；確認保留條 2.3 有沒有燒斷或翹曲（MDF 和合板各一次）；確認光孔兩側的肉完整。
  - 這片 #24 片段之後當講師黏插銷的治具。
- **T2 裝拆**：
  - 實品模組做「低位推入 → 上滑 → 塞鎖塊 → 放手」。
  - 量：槽底到保留條實際間隙（目標 0～0.4）；用 0.5 mm 鑽尾慢慢遮，找光束實際離軌高度（目標 2.5±1）。
  - 拔鎖塊後模組要自己落回低位。
- **T3 落幣與翻倒（R1、R3）**：整台 v2，1／5／10 元各 100 枚由轉盤正常送幣，手機慢動作錄 #26 後方。記錄：卡幣、停在翼上、被後臂頂住、彈回軌道的次數。驗收：全部 0。
- **T4 計數**：
  - 每種幣 50 枚，再混合 200 枚，C 值要符合公式，且 C5≥C10≥C50。
  - 每站 20 對緊貼硬幣，確認分得開；同時用 tuner 量最短亮區，決定上膛時間。
- **T5 分級不變**：和原機比較每種幣 100 枚，特別看 10 元（餘量 0.14）。
- **T6 抽屜**：S50 裝好後，10、50 元抽屜要抽得出、推得回。
- **T7 時間**：不熟悉的人裝一站目標 ≤2 分鐘，拆換 ≤1 分鐘；講師預組每套 ≤5 分鐘。
- **T8 強度**：#24 裝窗後平放、手指按保留條中央；整台往前傾 45°、左右搖 10 次，模組與鎖塊不脫出。

---

## 附錄 A：三份設計的重算與錯誤清單（`review.json`）

| 設計 | 宣稱 | 重算 | 判定 |
|---|---|---|---|
| d1 | 鍵座取代軌道 28.8／站 | 28.81／站 | 正確，但違反「軌道不可改」 |
| d1 | #26 臂槽吃開口 S5 5.0、S10 4.7、S50 3.4 mm² | S5 2.53＋2.49、S10 2.34＋2.34、S50 1.69＋1.69（合計一致） | 數字正確，但違反「開口不可改」 |
| d1 | S50 窗下剩肉 6.29 | 6.29 | 正確 |
| d1 | 窗切到「1」「5」 | 確認 | 已處理（下移） |
| d2 | PCB 帶伸進相鄰落幣區 10.4～10.7（尾巴往下游） | 本規格 wing＝down：10.06～10.29 | 量級正確；「一定卡住」未證明 |
| d3 | 保留條 1.8 | 1.81 | 正確，但太薄 |
| d3 | 光孔到開口 0.85～0.90 | 0.84／0.90／0.90 | 正確，但太薄 |
| d3 | 窗與雕刻 | 「1」重疊 65.0 mm²、「5」73.4 mm²（整個字在窗內） | **遺漏：字會被切掉** |
| d3 | S50 窗破出下緣、P1 靠下緣截掉 | 窗底在 U182～193 留下 0～3.3（U184 處 3.31、U190 處 1.13）的楔形碎片 | **缺陷：碎片易斷** |
| d3 | 隔板局部 y＝V−14.1 | laser_v2 驗證為 V−14.0 | 差 0.1 |
| d3 | S10 窗吃到 #6 長榫孔 | 重疊 11.7 mm² | 正確，d3 已刪長榫 |

## 附錄 B：仍待使用者決定或實量

1. **光束高 h＝2.5**（三位設計者都建議，保留條 2.3 對 1.8）是否可以？仍在「約 3」範圍。
2. **模組實量**（拿到後第一件事）：
   - 槽寬、槽深、光束離槽底、臂寬／厚、臂頂離 PCB、PCB 長寬厚。
   - 本體在 PCB 上的位置（靠邊或置中）、**左右手性**（排針朝自己、兩臂朝上時長邊在左或右）。
   - 排針位置（離 PCB 前緣多遠）與方向（直立朝上／朝下／平行朝外）。
   - PCB 上最高零件高度（有沒有可變電阻）與位置；背面焊點高度；本體有沒有固定耳。
   - 遮擋時 OUT 為 HIGH 或 LOW；3.3 V 能否穩定觸發。
3. 若實品是翼朝下游（'down'）：請量**抽屜側牆頂到滑道出口的間隙**，決定 S50 可否照用，或 S50 換鏡像模組。
4. 若試切 T3 有卡幣：是否同意 S5/S10/S50 改用**分離式紅外對射**（d2 的 D2-R；要另買、要查 3.3 V 與免焊款）？
5. 排線走法：採「右下排線孔→右側空腔→#37」（本規格），或 d3 的「翻過機頂、不開孔」？#37 穿線孔位置請電子盒規格一起定。
6. 雕刻「5」移到斜槽上方、「1」下移 18.5，外觀可接受嗎？
7. 刪除 #5、#6 長榫與 #7 中段小榫，#6 補一支上方小榫（#26 多一個 2.9×6.9 槽），可以嗎？
8. 「裝／拆 S50 時先抽出 10、50 元抽屜」寫進老師組裝說明，可以嗎？
