kingofamani/CoinSorting/03_v2_光耦版/laser_v2/design/s1wall_final/spec.md

> **勘誤（2026-10-08）**：這個區塊是事後加的，下面內文保留原樣。產生器實作在 `laser_v2/mods_s1.py`，和內文不同時，以 `laser_v2/out/report.md` 為準。文中的 `scratchpad/v2work/s1wall_final/` 是舊位置，現在在 `laser_v2/design/s1wall_final/`。
>
> 1. **back_h**：`params.MODULE['back_h']` 已改成 2.0（使用者 2026-10-08 決定），和本規格 MOD 的名目一致。
>    - 產生器的 S1 幾何和 `geometry_s1_final.json` 比，最大差 0.0087（json 只取 3 位小數）。
>    - 67/67 項檢查通過。
> 2. **#37 雕刻「S1 卡匣」（b-5）**：字從 B1 槽右緣＋2.0（U110.025）、V46.5 開始往右排，字高 4、字寬 13.6，中心約在 U116.8。
>    - 規格寫的是以 (U115, V46.5) 置中。照規格放，字左緣離 B1 槽不到 0.5，所以改了位置。
>    - 實際位置離切割線 2.26。
> 3. **S1-C「S1-C 前→」（(c) 表）**：字高 2.5，字墨中心在局部 (28.6, 8.5)，約 W'6.4、V63.0。
>    - 規格是 (27.0, 15.5)，也就是 V70。字墨要離切割邊 ≥1.0、離 S1-B 黏貼框 ≥0.4，所以黏貼框（x22.7）和 S1-C 前緣（x34.4）之間只剩約 10.3 可用，放不下字寬 11.3 的字。字的右端要伸進前榫那段（V59～65），所以移到前榫的高度。
>    - 實際離切割邊 1.005。
> 4. **代號字（(c)、實作第 6 步「零件名用雕刻」）**：使用者 2026-10-08 規定代號字 em 2.5～3，字墨離切割線 ≥1.0、離黏貼框和別的字 ≥0.4。完整代號放不下時，才只刻單字母（B、P）。
>    - 目前輸出都放得下完整代號：
>      - S1-B「S1-B」em 3，刻在後榫上，局部中心約 (18.6, 3.0)；原本是 em 2。
>      - S1-P「S1-P」em 3，置中；原本是 em 2。
>      - S1-F「S1-F」em 3，在兩個螺絲孔之間；原本是 em 2.5。
>      - S1-C 見第 3 點。
>    - S1-H 不雕。
> 5. **#37 感測器線孔（(e) 表「crosstrack 排線孔」那列）**：實際在 U88～100 × V40～46，由電子盒開，是交接 2026-10-02 定案的位置，不是該列建議的 U78～88、V85～98。
>    - 離背蓋 4.7、B1 槽 4.7、M3 孔 8.5、卡匣窗 8.35，都通過。
> 6. **雕刻樣式與備品**：
>    - 所有雕刻（框線、字）都是紅色 0.2 mm 線，和原始檔一樣。
>    - S1-H 每套另排 3 片、S1-P 另排 1 片備品進切割檔（在合板 1）。

# S1（方案 A：右櫃側板加高成 1 元滑道右牆）最終合併規格（裁判版，可直接寫產生器）

> 位置：`scratchpad/v2work/s1wall_final/`。所有數字由同資料夾的腳本重算：`design.py`（幾何）、`checks.py`（shapely 檢查，44/44 OK）、`export.py`（給產生器的 JSON）、`sim.py`／`sim_random.py`（pybullet 3D 落幣模擬）、`verify_designs.py`（重算兩位設計者的關鍵數字）、`fig.py`（4 張圖）。
> 腳本一律 `python3 -B` 唯讀匯入 repo 的 `laser_v2`（`frames`／`catalog`），repo 與原始 SVG 都沒有改動。單位一律 mm。
> 改模組尺寸：只改 `params.py` 的 `MOD`（或環境變數 `S1F_OVR='{"slot_w":9.6}'`），再依序跑 `design.py → checks.py → export.py → fig.py`。

---

## 0. 裁判結論

### 0.1 評分

| 設計 | 分數 | 理由（數字都是本資料夾重算） |
|---|---|---|
| 設計 1：背插卡匣（PCB 背面齊牆滑道面、後臂嵌 #37、前臂外露） | **6.5** | **優點**：模組可拆換（2 支螺絲、約 1 分鐘）；固定件全在滑道外；#26 新槽都藏在 #24 實料後面（F1 上緣在軌道下 1.1）；前臂在 W'≥12.3，**和 crosstrack_final 的 S5 安裝掃掠（W'≤10.0）相容**；Go/No-Go 清楚；板材少。光束 U117.475、離覆蓋區左界 1.60，我重算一致；#13R 局部座標（牆槽、F1、F2）我用 frames 重算完全一致。**問題**：①前臂外露。設計 1 自己的 2D 模擬只能標「先碰」，算不出碰後會不會卡。我用 3D 剛體模擬重跑，**前臂外露＋S5 翼朝上游時卡住 4.1%（6/145，不墊高）～6.2%（24/386，墊高 1 mm）**；沒有 S5 時（墊高 1 mm）也有 5.5%（8/145）。漏計方面，3D 是 1.4%（2/145），和「滑道內沒有任何模組」的基準（2/145）相同，所以設計 1 的主要問題是卡住，不是漏計。②沒考慮 S5 最終設計的翼與後臂。這兩樣在 1 元滑道 W'0.8～9.6，幾乎每枚 1 元都會先碰到它們。③S1-B 讓位孔後側只剩 **0.5 mm** 料，切下來就會斷。④#26 齒孔用「往上補 1.0（聯集）」修，和 catalog 的 `fix_26_tooth_hole()`（整孔平移，KNOWN_DEFECTS apply=True，產生器已套用）重複而且結果不同。⑤背蓋沒切 PCB 元件帶，元件若在 W'32～35 就會撞。⑥說「.ino 的 m 沒處理」：其實 HEAD（f18f313）已修好，第 134 行現在是 `lastPrint = millis();`。 |
| 設計 2：PCB 埋在兩層整流板、前臂藏進 7 片導流坡（9.7 通道） | **5.0** | **優點**：「把前臂朝上的面藏起來，硬幣全部導進 9.7 通道」的想法最好。我重算通道證明，最大夾角 24.4°、U 寬 ≥18.86、右緣 ≤117.02，正確；在沒有 S5 的 3D 模擬裡是 92/92 全對。牆高到 V6、4 支榫，最牢。**致命問題：和 crosstrack_final 不相容。** S5 的後臂、本體、翼（不論翼朝哪邊）都在 1 元滑道 W'0.8～9.6。導流坡 L1～L7 和 S5 最終位置重疊 **205～572 mm³**（翼 down／up），連安裝掃掠（模組低位推入再上滑，W'≤10.0、V52.5～78.3）是 **847～2417 mm³**。設計 2 只想到「翼」、沒想到後臂，所以不能只靠切缺口解決。把坡的前半段讓出去，「每枚都進通道」的保證就沒了，還會在翼下留出口袋。**其他**：模組膠死在 10 層疊片裡，壞了要拆 #37、#12 整組換；F2 要開元件窗再貼膠帶；每套多 7,400 mm² 板材，可能要第 4 張；講師每組約 15 分鐘加 30 分鐘乾燥。 |

### 0.2 選定：以設計 1 的「背插卡匣」為骨架，合併設計 2 的概念

| 來源 | 合併進來的東西 |
|---|---|
| 設計 1 | 背插卡匣（S1-B 座塊在牆槽內、S1-C 座板在空腔側、S1-F 背蓋鎖在 #37 外面）；#26 槽 F1／F2／C 位置；#37 卡匣窗＋B1 槽＋2 孔；光束沿 W'、後臂嵌 #37（內面退 0.3）；Go/No-Go 清單；排針在 #37 後方、不經滑道與空腔 |
| 設計 2 | 「前臂朝上的面不可外露、要導向通道」，改成 **S1-H 導流帽**：3 片 7×4.5 三角剖面片，黏在前臂頂面，頂坡 62.7°，不伸到 W'<12.3，避開 S5；PCB 墊高（s_pcb）當調光束的旋鈕，名目改成 **1.0 mm 雙面泡棉膠**；後臂退 0.3；牆加高到開口頂以上（V30）＋長後榫 |
| 本輪新增 | 帽通過 #37 後留下的窗用 **S1-P 填塊**補平；背蓋改成「元件帶＋焊點」都讓位；S1-B／S1-C 後榫並排（背蓋只剩一個槽，最細料 3.3）；螺絲改 M3 尼龍（孔離窗 3.3）；S1-B 讓位孔四周料 ≥2.0；順便修 KNOWN_DEFECTS `37-cutout-corners` 右側：#13R 在 #37 板厚內讓到 V84，重疊從 1.19 mm² 變 0；用 3D 模擬驗證 S5 翼 up／down／center 三種 |

**一句話**：右櫃側板改成 #13R，加高到 V30，開一道朝 #37 的牆槽。講師把模組用 1 mm 泡棉膠貼在卡匣上，前臂戴 3 片導流帽。老師整台組好後，從背面把卡匣推進牆槽，鎖 2 支 M3 尼龍螺絲。

### 0.3 關鍵數字（暫定模組 27.6×20×1.6、臂 7×6.4、臂高 12、槽 10×9、光束離槽底 5）

| 項目 | 數值 |
|---|---|
| 光束 | **U118.475、V74.0、W'19.3→29.3**。離保證覆蓋區左界 115.876 有 **+2.60**，扣光窗半寬 0.5 後 +2.10。硬幣繞軌道方向任意翻轉（U 寬 ≥18.79）時仍重疊 1.39 |
| 伸進硬幣直落區（U>114.104）的東西 | 只有前臂＋導流帽：U114.104～122.475（8.37）× W'12.3～19.3 × V66.3～77.2，約 507 mm³。PCB、元件、本體都在死區 U≤113.475 |
| 朝上面坡角 | 導流帽頂坡 62.7°、前臂前面 60°；只有死區裡的本體頂、PCB 上緣是 30° |
| 和 S5 的距離 | S5 不論翼朝哪邊，最終位置＋安裝掃掠都在 W'≤10.0；S1 最前在 W'12.3，**間隙 2.3**，同 W' 段重疊 0 |
| 3D 模擬（各 386 枚） | 最終設計：S5 翼 up／down／center 都是 **385 正確、1 漏、0 卡、0 重複**。基準「滑道內沒有任何模組」也漏 1，是同一種自然漏法。對照「前臂外露」：357 正確、4 漏、1 重複、**24 卡** |
| 遮光時間（模擬） | 最短 13 ms、5% 分位 27 ms、中位 34 ms。3 ms 內的閃爍 0 次 |
| 板材 | 每套多 2,732 mm²（約 255×355 的 3.0%） |

---

## b-0 座標與換算（產生器必讀）

| 符號 | 定義 |
|---|---|
| U | 沿機身長邊，0＝右端（轉盤側），246＝左端；從正面看 U 往左增加 |
| V | 沿傾斜面板往下，0＝面板頂 |
| W' | 深度，#26 背面＝0，往後為正；#24 在 −6～−3，#26 在 −3～0，#37 在 29.0～32.0（`laser_v2.frames.W37_IN`） |
| 重力 | (U,V,W') 分量＝(0, 0.866, 0.5)。坡角＝asin((0.5·dW'+0.866·dV)/長度) |
| 軌道 | V＝0.364032·U＋9.9262（擬合 #24 斜槽下緣） |
| 1 元滑道 | U107.875（#13R 滑道面）～135.876（#7 右面）；1 元開口 U114.104～134.604 |
| 出口平面 | V＝98−16·W'/29（貼 #26 V98、貼 #37 V82），以下是抽屜 |
| #13／#13R 局部 | 原 #13 外框左上角＝0（頁座標 139.550, 90.601）。**x＝0.8660(V−60.058)＋0.5(W'−25.886)；y＝0.5(V−60.058)−0.8660(W'−25.886)**；反算 V＝0.866x＋0.5y＋60.058、W'＝0.5x−0.866y＋25.886。板在 U104.875～107.875，上面（雕刻面）＝U104.875，朝空腔。已用 frames 驗證（W'10,V70 → (0.667, 18.729) 兩法相同） |
| #21 局部 | `frames['#21']`（#13 轉 180°），上面在 U236.125 |
| #26 局部 | (x,y)＝(V−4, U−40) |
| #37 局部 | (x,y)＝(114−V, U)（SVG 裡鏡像，上面朝機身背面） |
| (W',V) 平面新零件（S1-B、S1-H） | 局部 x＝W'−W'min、y＝V−Vmin；U＝U0＋z；上面 z=0 朝 −U（空腔側） |
| S1-C | 雕刻面要朝 +U（貼牆、貼 S1-B），所以局部 **x＝35.0−W'**、y＝V−54.5、U＝104.875−z（合法擺法，det＝−1） |
| (U,V) 平面新零件（S1-F、S1-P） | 局部 x＝U−Umin、y＝V−Vmin（＝從機身背面看）；W'＝W1−z，上面朝 +W'（朝外） |

`geometry_s1_final.json` 每個開口都給 `asm`（組裝）、`local`（零件局部）、`page`（原始檔該頁座標，用 `frames.asm_to_page` 算）。

---

## (a) 概念與安裝步驟

### a-1 概念（圖 1 剖面、圖 2 正視）
- **#13R** 取代右櫃側板 #13。原形保留，往上加高成 1 元滑道右牆（W'0～29 × V30～76.2），同時擋住 1 元反彈飛進右側空腔（空腔底部是空的）。
- 牆上開一道朝 #37 開口的**牆槽** W'11.8～30 × V57.5～76.9，卡匣的 S1-B 從背面滑進去，和牆同平面。
- **模組擺法**：PCB 在 (V,W') 平面、元件面朝滑道（+U）。光耦本體靠 PCB 下長邊（V 大側）。光束沿 W'，前臂在 W'12.3～19.3，後臂在 W'29.3～36.3，整支嵌在 #37 的窗裡（內面比 #37 內面退 0.3）。貼 #37 滑下的 1 元會穿過兩臂之間的槽、遮到光束。
- **S1-H 導流帽**：3 片 3 mm 三角片，疊在前臂頂面（U113.475～122.475），頂坡 62.7° 朝通道。硬幣落在前臂上方時只會滑進通道，不會擱住，也不會卡在「臂尖 ↔ #7」之間（臂尖到 #7 只有 13.4，小於幣徑 20）。
- **S1-F 背蓋**貼 #37 外面，用 2 支 M3 尼龍螺絲固定。**S1-P** 黏在背蓋前面，插好後補平帽通過 #37 留下的窗。
- 排針在 PCB 後端，位於 #37 背面之後。S1 的線不經過滑道或空腔，直接接到電子盒。

### a-2 講師預組（每套 1 個卡匣，另做 2 個備品；每個約 10 分鐘＋白膠乾燥 20 分鐘）
1. **先量模組並測試**：照 §d-3 的 Go/No-Go 清單量。用 3.3 V（V 排針）通電，以 1 元慢慢推過槽，燈號要穩定。改 `params.py` 後重新產生 v2 檔。
2. **S1-B 黏到 S1-C**（白膠）：S1-C 雕刻面上有 S1-B 外框（紅線），照框貼。兩片後榫並排，後端都在 W'35，齊平。
3. **後榫插進 S1-F 的槽**（S1-F 雕「S1 ↑」那面朝外、朝上），用角尺確認垂直後上膠。
4. **S1-P 黏在 S1-F 前面**：塞進背蓋缺口的內角。左緣齊元件帶缺口邊（局部 x21.3），下緣齊下方缺口邊（局部 y19.7）。見圖 3。
5. **導流帽**：3 片 S1-H 先用白膠疊齊（兩條直角邊對齊），乾了再用熱熔膠或瞬間膠黏到前臂頂面：
   - 4.5 高的直角邊齊前臂外面（遠離槽的那面），坡往槽的方向下降；
   - 7.0 邊齊前臂頂面；疊片從臂尖往本體方向排 9 mm；
   - 帽不可伸進槽（W'>19.3）。
6. **貼模組**：S1-B 滑道側的框上貼 1.0 mm 雙面泡棉膠。把模組從背蓋缺口**由下往上**套進去（後臂和 PCB 尾巴會穿過背蓋），讓 PCB 背面壓在泡棉膠上。
   - PCB 上緣齊 S1-B 上緣（V57.7），PCB 前緣齊 S1-B 前緣（W'12.3）。
   - 驗位：用游標卡尺量「後臂內面 → 背蓋前面」＝**2.7±0.2**。
   - PCB 四角各點一點熱熔膠當保險。
7. 插上 S1 杜邦線（色標 S1），接頭點熱熔膠。
8. **#37 預黏螺帽**：每片 #37 在空腔側（內面）兩個 Ø3.4 孔上，用熱熔膠黏 M3 螺帽（研習前就做好，和 #37 一起發給老師）。

### a-3 老師組裝
1. 套件裡只有 **#13R（雕「13R 右」、上半截高出一大塊）** 和 **#21（雕「21 左」）**，沒有 #13。
2. #13R 照原本 #13 的位置與方向裝：3 個齒插 #24／#26，**另外 2 支前榫 F1、F2 插 #26 新槽**。#12 照舊插 #13R 下段的 3 個槽。#21 照原本裝在左邊。
3. 照原流程蓋 #37。#13R 的後榫 B1 會插進 #37 新槽 B1。
4. S5／S10／S50 依 crosstrack_final 從前面裝。S1 卡匣和它們在 W' 上錯開 2.3，順序不拘。
5. **最後插 S1 卡匣**：
   - 臂朝前、「S1 ↑」朝上朝外，對準 #37 的卡匣窗，水平往前推。
   - S1-B 會滑進牆槽，S1-C 的尖頭前榫自己找到 #26 槽 C。
   - 推到背蓋整面貼住 #37。
6. 鎖 2 支 **M3×10 尼龍螺絲**，手擰即可。
7. S1 線接電子盒（G27）。一次丟 1 枚 1 元測試，C1 要加 1。
8. **沒插卡匣時不可送幣**：牆槽和 #37 窗是開的，硬幣會掉進空腔或從背面掉出去。

### a-4 換模組
卸 2 支螺絲，把卡匣往後拉出，換上備品，約 1 分鐘，不必拆機。

---

## (b) 修改的原始零件（v2 修改層；切割黑 0.2、雕刻紅，文字轉路徑）

### b-1 推導量（參數式＝名目值）
```
U_out=104.875  U_in=107.875（牆滑道面）  W37=29.0  W37o=32.0
U_pcb_back = U_in + s_pcb                    = 108.875
U_pcb      = U_pcb_back + pcb_t              = 110.475   # 元件面
U_sb       = U_pcb + (arm_top - slot_d)      = 113.475   # 槽底＝本體頂
U_b        = U_sb + beam_sb                  = 118.475   # 光束
U_tip      = U_pcb + arm_top                 = 122.475
U_comp     = U_pcb + comp_h                  = 112.475
U_solder   = U_pcb_back - back_h             = 106.875
wb = W37 + 0.3 = 29.3     wa = wb - slot_w = 19.3
前臂 W'[wa-arm_t, wa] = [12.3, 19.3]     後臂 W'[wb, wb+arm_t] = [29.3, 36.3]
pw0 = wa - arm_t - pcb_ovf = 12.3        PCB W'[pw0, pw0+pcb_L] = [12.3, 39.9]
臂 V[Vb-arm_w/2, Vb+arm_w/2] = [70.8, 77.2]   pv1 = 77.2 + body_e = 77.7   pv0 = pv1 - pcb_W = 57.7
Vr（帽頂）= 70.8 - cap_h = 66.3
c_tab=0.15（單邊）  c_opt=0.4  c_pcb=0.4  fit=0.1
```

### b-2 #13 → #13R（右櫃側板＋1 元滑道右牆）
**做法**：在 (W',V) 平面算 `(原 #13 ∪ 加高區 ∪ 3 支榫) − 牆槽 − 角落讓位`，再用 b-0 的式子轉回原 #13 局部座標。原 3 個 #12 槽、3 個齒、其他原曲線都不動。結果是單一外形，面積 3025 → 4059 mm²；排版外框（局部）x −38.974～84.274、y −17.725～52.226，即 123.3×70.0。

| 項目 | 參數式 (W'×V) | 名目 (W'×V) | 原 #13 局部 (x,y) 四點 |
|---|---|---|---|
| 加高區（聯集） | [0, W37]×[wall_top, 76.2] | 0～29 × 30～76.2（蓋過原頂邊 V75 與後上圓角） | (−38.974,7.389) (−24.474,−17.725) (15.537,5.375) (1.037,30.489) |
| 前榫 F1（插 #26） | [−tab_len_26, 0]×[50.5, 56.0] | −2.6～0 × 50.5～56.0 | (−22.520,19.891) (−21.220,17.639) (−16.457,20.389) (−17.757,22.641) |
| 前榫 F2（插 #26） | [−2.6, 0]×[68.0, 74.5] | −2.6～0 × 68.0～74.5 | (−7.365,28.641) (−6.065,26.389) (−0.436,29.639) (−1.736,31.891) |
| 後榫 B1（插 #37） | [W37, W37+3.0]×[36, 48] | 29～32 × 36～48 | (−19.278,−14.725) (−17.778,−17.323) (−7.385,−11.323) (−8.885,−8.725) |
| **牆槽**（差集，開向 #37） | [pw0−0.5, W37+1]×[pv0−0.2, pv1−1.0+0.2] | 11.8～30 × 57.5～76.9 | (−9.258,10.920) (−0.158,−4.841) (16.643,4.859) (7.543,20.620) |
| **角落讓位**（差集；修 KNOWN_DEFECTS `37-cutout-corners` 右側） | [W37, W37o+0.2]×[77.0, 84.0] | 29～32.2 × 77～84 | (16.229,5.775) (17.829,3.003) (23.892,6.503) (22.292,9.275) |

- 榫長：前榫 2.6（小於最薄板 2.7，榫尖不露出 #26 前面，也不頂 #24）；後榫 3.0（和 #37 外面齊平）。
- 前榫都在軌道以下：F1 槽口上緣 V50.35，比該處軌道 V49.25 低 1.10，所以 #26 上的槽被 #24 實料擋住，不在硬幣靠的面上。
- 牆槽前方留 **11.8 mm 寬的前料條**（W'0～11.8，長 19.4），把上段（V30～57.5，848 mm²）接回原本體。上段另有 F1、B1 固定。
- 角落讓位：原 #13 在 #37 板厚區（含 R2 圓角，最低 V82.84）重疊 1.19 mm²，改後 0。
- **雕刻**（上面＝空腔側，字高 4／3，文字基線沿 W' 由 #26 往 #37）：
  - 「13R 右」在 (W'15, V40)＝局部 (−22.813, −0.601)；
  - 「S1 卡匣」在 (W'15, V46)＝局部 (−17.617, 2.399)。

### b-3 #21（左櫃側板）
外形不改，只在上面（U236.125，朝 50 元滑道）雕「21 左」，字高 4，位置 (W'12, V80)＝#21 局部 (73.947, 30.229)。防裝反：#13R 比 #21 多一大塊加高。#13R 若誤裝到左邊，#26／#37 沒有新槽，前後榫插不進去；#21 若誤裝到右邊，沒有牆槽，卡匣插不進去。兩種都會當場發現。

### b-4 #26（加 3 個槽；原檔齒孔 bug 交給 catalog 修）

| 槽 | 參數式 (U×V) | 名目 (U×V) | #26 局部 (x,y) | 檢查 |
|---|---|---|---|---|
| F1 | [U_out−c, U_in+c]×[50.5−c, 56.0+c] | 104.725～108.025 × 50.35～56.15 | x46.35～52.15、y64.725～68.025 | 離既有孔 6.09，離 #24 孔 1.03 |
| F2 | 同上 ×[68.0−c, 74.5+c] | 104.725～108.025 × 67.85～74.65 | x63.85～70.65、y64.725～68.025 | 離既有孔 10.38；離 #24 轉盤圍邊菱形孔 0.04（兩者在不同板，圍邊榫不穿出 #24，無干涉） |
| C（S1-C 前榫） | [U_out−3−c, U_out+c]×[59−c, 65+c] | 101.725～105.025 × 58.85～65.15 | x54.85～61.15、y61.725～65.025 | 離既有孔 12.64，離 #24 孔 0.81 |

- 槽與槽之間最少 2.70 mm 料；3 個槽都在 #26 外框 2 mm 以內縮範圍之內。
- **原檔 bug**：#26 右齒孔 1（path131[19]）偏 ΔV+1.000、ΔU+0.134，由 `laser_v2.frames.fix_26_tooth_hole()`（KNOWN_DEFECTS `26-tooth-hole`，apply=True）整孔平移修正。**本規格不另外改這個孔**（設計 1 的聯集法和設計 2 的只移 V 都不要用）。#13R 的齒對的就是修正後的孔。

### b-5 #37（卡匣窗、B1 槽、2 個 M3 孔、雕刻）

**卡匣窗**＝卡匣通過 #37 時各部分 (U,V) 輪廓的聯集（單一多邊形，面積 371.5 mm²）：

| 段 | 參數式 | 名目 |
|---|---|---|
| S1-C | U[U_out−3−0.3, U_out] × V[pv0−3.2−0.3, 78.5+0.3] | 101.575～104.875 × 54.2～78.8 |
| S1-B | U[U_out, U_in] × V[pv0−0.3, pv1−1.0+0.3] | 104.875～107.875 × 57.4～77.0 |
| PCB＋泡棉膠 | U[min(U_in,U_pcb_back)−0.1, U_pcb+c_opt] × V[pv0−c_pcb, pv1+c_pcb] | 107.775～110.875 × 57.3～78.1 |
| PCB 背面焊點（後臂腳在 W'29～36） | U[U_solder−0.2, U_pcb_back] × 同 V | 106.675～108.875 × 57.3～78.1 |
| 元件帶 | U[U_pcb, U_pcb+max(comp_h+c_opt, 3.4)] × 同 V | 110.475～113.875 × 57.3～78.1 |
| 本體＋臂＋導流帽 | U[U_pcb, U_tip+c_opt] × V[Vr−c_opt, Vb+arm_w/2+c_opt] | 110.475～122.875 × 65.9～77.6 |

- 頂點（組裝 U,V 依序）：(101.575,54.2) (101.575,78.8) (104.875,78.8) (104.875,77.0) (106.675,77.0) (106.675,78.1) (113.875,78.1) (113.875,77.6) (122.875,77.6) (122.875,65.9) (113.875,65.9) (113.875,57.3) (106.675,57.3) (106.675,57.4) (104.875,57.4) (104.875,54.2)
- #37 局部 (x＝114−V, y＝U)：(59.8,101.575) (35.2,101.575) (35.2,104.875) (37.0,104.875) (37.0,106.675) (35.9,106.675) (35.9,113.875) (36.4,113.875) (36.4,122.875) (48.1,122.875) (48.1,113.875) (56.7,113.875) (56.7,106.675) (56.6,106.675) (56.6,104.875) (59.8,104.875)
- 窗到 #37 外框最少 **3.45**，在下方開口 R2 圓角處；窗下緣 V78.1 到 #37 底邊 V82 是 3.9。到既有孔 16.28。
- **B1 槽**：U104.725～108.025 × V35.85～48.15。#37 局部 x65.85～78.15、y104.725～108.025。離窗 6.05。
- **M3 孔 Ø3.4** ×2：中心 (U96.575, V56.2)、(U96.575, V73.5)。#37 局部 (57.8, 96.575)、(40.5, 96.575)。離窗 3.3。孔位在 U<104.5，#37 在那裡往下一直到 V114，料足。若改用 M2.6×8 自攻螺絲，孔改 Ø2.2、不黏螺帽。
- **雕刻**「S1 卡匣」（字高 4，外面）在 (U115, V46.5)＝局部 (67.5, 115.0)，在背蓋上緣之上看得到。
- 卡匣插好後，窗在滑道側（U>107.875）剩下的縫：
  - 合計 77.7 mm²，大部分是 0.4 mm 的餘隙條；
  - 其中元件帶通道 2.4×13.5（U110.47～112.88 × V57.3～78.1）在死區，直通背面（見 R6）；
  - 實品元件帶沒有零件時，可改用 S1-K（§c-6）補平，剩 52.5 mm²。

---

## (c) v2 新增零件（3 mm 合板；S1-B 必須和 #13R 排在同一張板，牆面齊平）

| 零件 | 平面／位置 | 外形（局部，逆時針） | 尺寸 | 說明 |
|---|---|---|---|---|
| **S1-B 座塊** | (W',V)，U104.875～107.875（在牆槽內）；x＝W'−12.3、y＝V−57.7 | 外框 (22.7,0)(16.7,0)(0,0)(0,19)(16.7,19)(16.7,6)(22.7,6)；**焊點讓位孔** (2.0,3.0)～(13.7,17.0) | 22.7×19.0，190 mm² | 本體 W'12.3～29 × V57.7～76.7：上緣、前緣和 PCB 齊平，下緣縮 1.0 讓焊腳。後榫 W'29～35 × V57.7～63.7。讓位孔四周料 2.0／3.0／3.0／2.0。在牆槽內 V 向單邊 0.2，前端離槽底 0.5 |
| **S1-C 座板** | (W',V)，U101.875～104.875（空腔側貼牆）；**x＝35−W'**、y＝V−54.5 | (0,9.2)(0,3.2)(6,3.2)(6,0)(34.4,0)(34.4,4.5)(36.4,5.1)(37,5.5)(37,9.5)(36.4,9.9)(34.4,10.5)(34.4,24)(6,24)(6,9.2) | 37.0×24.0，731 mm² | 本體 W'0.6～29 × V54.5～78.5，比牆槽上下各多 3.0／1.6，壓在牆的空腔側。前榫 W'−2.0～0.6 × V59～65，尖端收窄到 4 mm，插 #26 槽 C。後榫和 S1-B 並排在 V57.7～63.7。**雕刻面（朝牆）**：S1-B 黏貼框 (0,3.2)(22.7,3.2)(22.7,22.2)(6,22.2)(6,9.2)(0,9.2)，加文字「S1-C 前→」字高 2.5，在 (27.0,15.5) |
| **S1-H 導流帽** ×3 | (W',V)，U113.475～116.475～119.475～122.475；x＝W'−12.3、y＝V−66.3 | (0,4.5)(0,0)(7,4.5) | 7.0×4.5，每片 15.8 mm² | 直角在前臂外上角。頂坡 (W'12.3,V66.3)→(19.3,70.8)，對水平 62.7°。片數＝round(slot_d/3) |
| **S1-F 背蓋** | (U,V)，W'32～35（貼 #37 外面）；x＝U−91.575、y＝V−50.7（從背面看） | (15.1,19.7)(16.2,19.7)(16.2,13.15)(10.15,13.15)(10.15,6.85)(16.2,6.85)(16.2,6.6)(21.3,6.6)(21.3,19.7)(35.3,19.7)(35.3,0)(0,0)(0,27.3)(15.1,27.3)；**Ø3.4** 中心 (5.0,5.5)、(5.0,22.8) | 35.3×27.3，687 mm² | U91.575～126.875 × V50.7～78.0。切掉的部分：後榫槽（並排兩支合一，6.3×6.3）、PCB＋泡棉膠、元件帶、焊點、後臂以下整塊（不留細條）。最細料 3.3。下緣 V78 到 #13R 在 #37 後方的櫃頂邊 1.93，上緣到 B1 榫尾 2.55。雕「S1 ↑」字高 4，在 (28.4,7.3) |
| **S1-P 填塊** | (U,V)，W'29～32（黏在背蓋前面）；x＝U−112.875、y＝V−66.0 | (0,0)(9.9,0)(9.9,4.4)(0,4.4) | 9.9×4.4，44 mm² | 填帽通道：U[U_comp+c_opt, U_tip+c_opt−fit]×V[Vr−c_opt+fit, 臂頂−c_opt]。下緣 V70.4 到後臂頂留 0.4，右緣到元件頂留 0.4。#37 厚 2.7～3.2 時，凸出或內凹 ±0.3 |
| S1-K 元件帶填塊（條件式） | (U,V)，W'29～32 | U110.675～113.675 × V57.45～65.85 | 3.0×8.4 | 只有實品 PCB 在 W'29～35、本體以上那一帶沒有零件時才用。這時 `comp_band_free=True`：背蓋不切元件帶，S1-K 黏在背蓋前面 |

- 餘隙：木榫對槽單邊 0.15（長、寬都加）；光耦、臂、帽、PCB 通過 #37 窗單邊 0.4；填塊比窗小 0.1。
- 卡匣 W' 定位只靠「背蓋貼 #37 外面」這一個基準。S1-B 前端離槽底 0.5，S1-C 前緣離 #26 背面 0.6，都不接觸。
- 每套買：1.0 mm 雙面泡棉膠約 3 cm²；M3×10 尼龍螺絲 2 支、M3 螺帽 2 顆。

---

## (d) 參數表與敏感度

### d-1 模組（`params.py` 的 `MOD`；暫定值，實量後改）

| 參數 | 名目 | 意義 |
|---|---|---|
| pcb_L／pcb_W／pcb_t | 27.6／20.0／1.6 | PCB 沿光束（W'）／垂直光束（V）／厚（U） |
| arm_t／arm_w／arm_top | 7.0／6.4／12.0 | 臂沿光束厚／臂寬（也當本體寬）／臂頂離 PCB 元件面 |
| slot_w／slot_d／beam_sb | 10／9／5 | 槽寬／槽深／光束離槽底 |
| body_e | 0.5 | 本體側邊到 PCB 長邊（本體必須靠一條長邊） |
| pcb_ovf | 0 | PCB 前端超出前臂外面的量（本體置中時＝1.8） |
| comp_h／back_h | 2.0／2.0 | 元件面最高零件／背面焊點 |
| aperture | 1.0 | 光窗寬（估計） |

### d-2 設計參數（`DES`）

| 參數 | 值 | 說明 |
|---|---|---|
| s_pcb | **1.0** | PCB 背面離牆面的墊高，用 1.0 mm 雙面泡棉膠。可調 0～1.6，用來調光束 U |
| Vb | 74.0 | 光束 V（可用 72.5～74.9） |
| wb | 29.3 | 後臂內面（#37 內面後 0.3） |
| wall_top | 30.0 | 牆頂 V（1 元開口右端頂緣約 V31.4） |
| tabs_front／tabs_back | V50.5～56、68～74.5／V36～48 | #13R 榫 |
| tab_len_26／tab_len_37 | 2.6／3.0 | |
| cap_h／cap_layers | 4.5／3 | 導流帽 |
| c_tab／c_opt／c_pcb／fit | 0.15／0.4／0.4／0.1 | |
| corner_fix／corner_fix_V | True／84.0 | #13R 角落讓位 |
| cover_v1 | 78.0 | 背蓋下緣 |
| screw_hole_37／cover | 3.4／3.4 | M3 尼龍（自攻 M2.6 時 #37 改 2.2） |
| comp_band_free | False | 見 S1-K |

### d-3 哪個模組尺寸變多少會失效（`checks.py` §13：一次只改一個，找出準則開始不成立的值）

準則有 6 條：
1. 光束餘量 ≥1.0（扣光窗半寬後）；
2. 前臂／帽前面 W'≥11.0（離 S5 掃掠 ≥1.0）；
3. #37 窗下料條 ≥3.0；
4. 背蓋不壓 B1 榫尾；
5. 臂尖到 #7 ≥12；
6. 槽底（本體頂）留在死區 U<114.104。

| 尺寸 | 名目 | 可用範圍 | 太小先壞 | 太大先壞 | 超出時怎麼改 |
|---|---|---|---|---|---|
| arm_top | 12.0 | 11.0～12.6 | 光束餘量 | 槽底離開死區 | 調 s_pcb（每 1 mm 抵 1 mm） |
| slot_d | 9.0 | 8.4～10.0 | 槽底離開死區 | 光束餘量 | 同上；帽片數＝round(slot_d/3) |
| beam_sb | 5.0 | ≥4.0 | 光束餘量 | — | s_pcb 加厚（最多 1.6） |
| pcb_t | 1.6 | ≤2.2 | — | 槽底離開死區 | s_pcb 減薄 |
| **slot_w** | 10.0 | ≤11.3 | —（槽寬 9 時模擬仍 144/145、0 卡） | 前臂太靠前、碰 S5 | 槽寬 <8 的模組：前臂伸進硬幣中心帶，要重新模擬 |
| arm_t | 7.0 | ≤8.3 | — | 同上 | — |
| arm_w | 6.4 | ≤8.2 | — | #37 窗下料條 <3 | Vb 往上（小）移 |
| **body_e** | 0.5 | ≤1.3 | — | #37 窗下料條 <3 | 本體在 PCB 中間＝**No-Go**（PCB 會超出 #37 下緣） |
| pcb_W | 20 | ≤21.5 | — | 背蓋壓到 B1 榫尾 | B1 改短（V36～46） |
| s_pcb | 1.0 | 0～1.6 | — | 槽底離開死區 | — |
| Vb | 74.0 | 72.5～74.9 | 背蓋壓 B1 | 窗下料條 | — |

**最快判準**：光束離 PCB 背面 h＝pcb_t＋arm_top−slot_d＋beam_sb，名目 9.6。要滿足 **s_pcb＋h ≥ 9.5**，現在是 10.6，還有 1.1 的餘量；同時 U_sb＝108.875＋pcb_t＋arm_top−slot_d 要 <114.1。實品量到後，s_pcb 取 10.6−h，夾在 0～1.6 之間。

**模擬敏感度**（最終設計＋S5 翼 up，每組 145 枚，`sim_random3.json`）：s_pcb 0.5、cap_h 3.0 或 6.0、Vb 73 或 75、槽寬 9.0、臂高 11.0，結果全部都是 144 正確、1 漏、0 卡。

### d-4 Go/No-Go（拿到實品第一件事）
1. **槽寬 ≥8，名目 10**。
2. **光耦本體必須靠 PCB 長邊（body_e ≤1.3）**。在中間就是 No-Go。
3. **排針位置**：
   - 在 PCB 短端、本體對面那端：Go。裝好後在 W'36.3～39.9，位於 #37 背面以後，直立、彎針、背面都可以。
   - 在長邊、元件面直立：**No-Go**。杜邦頭會橫越滑道。
   - 在長邊、背面直立：S1-B／S1-C 要開排針孔（10×5），#37 窗要加上排針外形，然後重產生。
4. 元件高 ≤3.0（導流帽從 U113.475 起）。W'29～35 那一帶的元件高若 ≤0.4，可以改用 S1-K。
5. 有沒有 Ø3.2 固定孔都可以。本設計用泡棉膠，不靠孔。

---

## (e) 干涉檢查（`checks.py` 共 44 項全 OK；數字取自 `checks_out.txt`）

| 對象 | 檢查 | 數值 | 判定 |
|---|---|---|---|
| 軌道（#24 斜槽下緣） | #26 新槽是否在軌道以下、被 #24 實料蓋住 | F1 上緣在軌道下 1.10；F2 下 18.6；C 在 #24 實料後 | ✓ 軌道零改動 |
| 1 元開口 | 牆滑道面到開口右緣；新槽到開口 | 6.229；≥6.09 | ✓ 開口零改動 |
| 翻倒掃掠 | 1 元以唇為軸往後翻 0～180°，第一次碰 S1 | 翻到 180° 都不碰（先碰 S5 翼，θ≈112°） | ✓ |
| 落下掃掠 | 越過直落線 U114.104 的東西 | 只有前臂＋導流帽，8.37 mm、507 mm³ | 有，但朝上面 ≥60°，見模擬 |
| 卡幣 | 3D 模擬卡住率 | 最終設計 0/386（×3 種翼向）；無帽 24/386 | ✓ |
| 重複計數 | 3 ms 內閃爍 | 0；遮光 13～104 ms | ✓（程式用中斷） |
| 光束覆蓋 | 光束離覆蓋區左界 | +2.60（扣光窗 +2.10）；繞軌道翻轉時重疊 1.39 | ✓ |
| S5（翼 up／down／center） | 最終位置＋安裝掃掠 W'≤10.0，S1 在 W'≥12.3 | 間隙 2.3，同 W' 段重疊 0 | ✓ 安裝順序不拘 |
| #7（1\|5 間隔條） | 帽左面到 #7 | 13.4 | 小於幣徑；靠帽頂坡處理 |
| #13R | 單一外形；前料條；上段；角落讓位 | ✓；11.8；848 mm²；重疊 1.19→0 | ✓ |
| #26 | 槽離外框／既有孔／槽間料 | ≥23.35／≥6.09／2.70 | ✓ |
| #37 | 窗到外框／既有孔；B1 離窗；M3 孔離窗 | 3.45／16.28；6.05；3.3 | ✓ |
| 出口平面、抽屜 | 模組在滑道內最低點 | PCB 下緣 V77.7，出口平面 V82.0，差 4.3 | ✓ 出口平面以下沒有新增物 |
| #12（櫃後板） | 到 PCB 後端／排針／背蓋 | 3.21／9.87／2.91 | ✓ |
| #13R 在 #37 後方的櫃頂邊 | 到背蓋下緣 | 1.93 | ✓ |
| TT 馬達盒（U43.8～72.1） | 到 S1-C／螺絲孔 | 29.81／22.81 | ✓ |
| 右側空腔 | 剩下寬度 | 29.81（原 32.8）；空腔內只多 S1-C 和 2 顆螺帽 | ✓ S5～S50 排線仍可走 |
| 轉盤 #62、前蓋 #63、圍邊 #27 | S1 最前點 | W'−2.6（榫尖，在 #26 板內） | ✓ |
| #24 轉盤圍邊榫孔 | 到 #26 新槽 | 0.81／0.04（不同板，圍邊榫不穿出 #24） | ✓ |
| 排線 | S1 排針在 #37 外 W'36.3～39.9 | 不經滑道、空腔 | ✓ |
| crosstrack 排線孔 | U91.5～101.5、V103.5～108 到 S1-C | 25.0 | ✓；#37 穿線孔請放 U78～88、V85～98（避開背蓋） |
| 電子盒 | #37 背面 S1 禁區 | **U91.1～130.5 × V50.2～78.5 × W'32～55**（含背蓋、排針、杜邦頭、拔插手指空間 15） | 電子盒 d1 的側板 SA（U130～133、V≤53）離背蓋 3.1，和排針區（V63.9～71.5）在 V 上不重疊；d2（U≥134）不碰 |
| 牆高 | 模擬中硬幣中心最高 V45.9；牆頂 V30 | 能量上界見 checks §10 | ✓ 擋住反彈飛進空腔 |
| 板材 | 每套新增 | 2,732 mm²（3.0% 張） | 第 3 張約剩 10%，要和 crosstrack、電子盒一起排 |

---

## (f) Python 檢查與圖

| 檔案 | 作用 |
|---|---|
| `base.py` | 唯讀匯入 laser_v2；軌道擬合、開口、#13 局部換算；S5（crosstrack_final）模組實體與安裝掃掠，翼 up／down／center 都算 |
| `params.py` | 參數與推導量 |
| `design.py` | #13R、#26 槽、#37 窗／槽／孔、S1-B／C／H／F／P／K 全部 shapely 幾何 |
| `checks.py` → `checks.json`、`checks_out.txt` | §e 全部數字、§d-3 失效門檻 |
| `export.py` → `geometry_s1_final.json` | 給產生器：組裝、局部、頁座標；#13R 的布林運算元件；雕刻位置 |
| `sim.py`、`sim_random.py` → `sim_final.json`、`sim_random*.json`、`sim_summary.txt`、`sim_extra.txt` | pybullet 3D：1 元從軌道滾進開口、翻倒、落下、穿過光束、出口平面。逐步檢查光束段是否被硬幣遮住（數脈衝），並記錄碰到哪些零件、是否卡住 |
| `verify_designs.py` → `verify_designs.txt` | 重算設計 1、設計 2 的關鍵數字：S1-B 0.5 mm 料、導流坡和 S5 的重疊、通道證明 |
| `fig.py` | `fig1_section.png`：光束處剖面＋40 條模擬軌跡＋S5 掃掠；`fig2_front.png`：正視；`fig3_parts.png`：零件局部座標；`fig4_sim.png`：模擬結果 |

**模擬模型的限制**：
- 硬幣是均勻圓柱（Ø20、厚 1.5～1.85 隨機、3.8 g）。開口上角圓角、#24／#26 的 S5 窗口袋、窗邊 0.4 縫、#37 後臂 0.3 凹都沒有建模。
- 每組 400 枚裡有 14 枚在開口處停住，各變體都一樣，屬模型假象，已排除。
- 初速 0.12～0.55 m/s、摩擦 0.2～0.5、恢復係數 0.15～0.6 都是假設。
- 所以模擬結果只能拿來比較方案、判斷方向，不是良率預測。

---

## (g) 風險與試切

### g-1 風險
- **R1 前臂與帽仍在落幣區（中）**：
  - 模擬中 S5 在時，約 55% 的硬幣碰到帽、82% 碰到前臂、96% 碰到槽底側面，碰了之後都會滑進通道（0 卡）。
  - 帽是 3 片小件、用膠黏在模組上；掉了就會回到「前臂外露」的情況（模擬卡住 6%）。
  - 對策：用瞬間膠；試切 T4 看帽有沒有鬆；多切備品。
- **R2 光束餘量（中）**：泡棉膠 1.0 時，光束離覆蓋區左界 +2.6。泡棉若被壓到 0.8，就剩 +2.4。實品 h 若比名目少 1 mm 以上，要再加厚泡棉（最多 1.6）。
- **R3 模組尺寸未知（Go/No-Go）**：本體位置、排針位置、元件高是最大變數，見 §d-4。
- **R4 #37 開大窗（中）**：
  - 371.5 mm²，最細料 3.45（圓角處）。
  - 沒插卡匣不可送幣。
  - 元件帶通道 2.4×13.5 在死區直通背面：硬幣過不去，但可能漏一點環境光。接收端朝前、在 #37 窗裡，影響小；T6 要在窗邊測。
- **R5 S5 耦合（中）**：
  - S5 的翼、後臂、本體在 1 元滑道 W'0.8～9.6。模擬中幾乎每枚 1 元都先碰它們，再落到 S1。
  - crosstrack 的 #26 窗在翼下方可能留一個 3 mm 的口袋，本模型沒有建，要和 S5 一起試切。
  - 若 S5 改分離式對射（crosstrack 備案），S1 沒有 S5 擋在前面，模擬漏計會升到約 5%（8/145）。
- **R6 泡棉膠潛變、熱熔膠脫落（低）**：每場研習前量一次「後臂內面 → 背蓋前面」，要 2.7±0.2。
- **R7 板厚 2.7～3.2**：
  - 帽疊 8.1～9.6；
  - S1-P 凸出或內凹 ±0.3（在 #37 內面，0.3 的台階可接受）；
  - 後臂內凹 0～0.5；
  - 前榫 2.6 對 2.7 的 #26 只差 0.1，若量到板厚 <2.7，前榫改 2.4。
- **R8 程式（不在本輪範圍）**：遮光最短約 13 ms。要用中斷，並設定「連續未遮 ≥5 ms 才重新上膛」；計數公式 N1＝C1。

### g-2 試切項目
1. **T0 實量**：
   - 量模組（§d-1 每個尺寸，加上本體位置、排針位置、元件分布、焊點高）；
   - 確認擋住時輸出 HIGH 還是 LOW，以及接 3.3 V 能不能穩定觸發；
   - 改 `params.py` → 重跑 → 44 項檢查全 OK 才切。
2. **T1 配合小樣**：
   - 切 #13R 上段（含牆槽、F1、B1）、S1-B、S1-C、S1-F、S1-P、3 片 S1-H，再加 #26、#37 的局部（U90～130、V30～85）；
   - 量 kerf、確認 S1-B 在牆槽內滑順、S1-C 尖榫能自己找到槽 C；
   - 背蓋貼平時，後臂內面比 #37 內面低 0～0.5。
3. **T2 光束位置**：用 Ø1 鑽頭尾端當遮片，沿 U 從 112 推到 125，記下 LED 變化的 U。光束中心要 ≥118.0。
4. **T3 靜態**：手拿 1 元貼 #37，分別靠 #7（最左）和靠牆（最右），由上往下推過，兩種位置燈都要亮；再把硬幣斜 20° 試一次。
5. **T4 整台落幣**：
   - 轉盤正常送 1 元 200 枚，C1 要等於 200，卡幣 0；
   - 拍慢動作影片，看帽頂、帽和 #7 之間、槽底有沒有停留；
   - 用 tuner 記錄脈衝寬（模擬 13～104 ms）。
6. **T5 混合**：四種各 50 枚，加混合 200 枚。N1 要正確，C5≥C10≥C50。
7. **T6 邊界**：
   - 兩枚 1 元連續快送；
   - 整台前後左右各傾斜 3°；
   - 在窗邊與日光燈下重做 T4（重點是元件帶通道會不會漏光）。
8. **T7 老師操作**：讓沒看過的人插卡匣、鎖 2 支螺絲，要在 1 分鐘內；拆換也要在 1 分鐘內。
9. **T8 耐久**：連續 500 枚，之後檢查帽與泡棉膠有沒有鬆動。

---

## (h) 給產生器的實作提示
1. `catalog.load_catalog()` 取 #13、#21、#26、#37。#26 先套 `fix_26_tooth_hole()`（KNOWN_DEFECTS apply=True）。
2. **#13 → #13R**：
   - 做法：`(原外形 ∪ raise_rect ∪ tabs_front ∪ tabs_back) − wall_slot − corner_notch`；
   - 頂點在 `geometry_s1_final.json → #13R.ops_local13`（原 #13 局部），完整外形在 `outline_local13`；
   - 原 3 個 #12 槽保留；
   - 新零件原點改成新外框左上角，平移 (+38.974, +17.725)；
   - 雕刻「13R 右」「S1 卡匣」；放「v2 修改」層。
3. **#21**：只加雕刻「21 左」。
4. **#26**：加 F1、F2、C 三個矩形孔（`#26.slots[*].local`）。
5. **#37**：加卡匣窗（`#37.window.local`）、B1 槽、2 個 Ø3.4 孔、雕刻「S1 卡匣」。
6. **新零件**：
   - S1-B、S1-C、S1-H×3、S1-F、S1-P 照 `new_parts[*].local` 切，放「v2 新增」層，零件名用雕刻；S1-H 太小，不雕；
   - S1-C 的雕刻面是鏡像局部（已處理），雕 S1-B 黏貼框；
   - S1-B 要和 #13R 排在同一張板上。
7. **輸出前檢查**：
   - 每條切割路徑閉合、不自交；
   - #13R 是單一外形；
   - 新孔離既有孔 ≥2.5；
   - 最細料 ≥2.0；
   - 重跑 `checks.py`。

---

## (i) 仍待使用者決定或實量
1. **模組實品**：
   - 槽寬（10？）、臂頂離 PCB、槽深、光束離槽底、臂厚、臂寬；
   - 本體在 PCB 的哪裡（是否靠長邊）、排針在哪一邊、朝哪個方向；
   - 元件面零件分布與高度、背面焊點高度、有沒有固定孔；
   - 擋住時輸出 HIGH 還是 LOW、3.3 V 能不能穩定觸發。
2. 同不同意在模組前臂上**黏 3 片小導流帽**？同不同意**用 1 mm 雙面泡棉膠**貼 PCB？泡棉膠需要另外買。
3. 固定方式選哪一種：
   - **M3 尼龍螺絲＋講師預黏螺帽**（名目）；
   - 或 M2.6 自攻木螺絲（不用螺帽，但拆裝多次會鬆）。
4. S5 模組實品的左右手性（翼朝上游或下游）。S1 三種翼向都算過、都可以用，但會影響試切重點。
5. 牆頂用 V30（本規格）還是設計 1 的 V38（少 230 mm² 板材，反彈防護略少）？
6. #37 上 S5～S50 的穿線孔位置（建議 U78～88、V85～98），要和電子盒規格一起定。電子盒必須避開 S1 禁區 U91～131 × V50～79 × W'32～55。
7. 要不要一併修左側 #21 的 `37-cutout-corners`？做法是同形讓位，加上 #37 左開口邊外移 0.4；本規格只修了右側。
8. 每場要做幾個備品卡匣？建議 10 套配 2 個。
