kingofamani/CoinSorting/分幣機_交接_2026-10-08.md

# 分幣機 v2 雷切檔：交接（2026-10-08）

開新對話時，請把這份檔案和 `分幣機_專案完整紀錄v2.txt`（先看第五節）一起交給 Claude。
分支：`main`（`main-wj17sg` 已在 2026-10-08 合併進 main，2026-10-12 刪除）。使用者偏好：繁體中文。本檔取代 `03_v2_光耦版/分幣機_交接_2026-10-02.md`。

> **2026-10-12 資料夾整理**：各版本分到 `01_原始機構/`、`02_v1_紅外線版/`、`03_v2_光耦版/`、`04_光耦測試原型/`，總覽見根目錄 `README.md`。
> 本檔中的 `laser_v2/…`、v2 草稿與試切小樣都在 **`03_v2_光耦版/`** 底下；原始雷切檔在 `01_原始機構/`。

## 一、目前進度

- **v2 雷切檔產生器完成**（`laser_v2/`），輸出已定稿：合板 3 張＋壓克力 1 張；試切小樣合板 1 張。
- 使用者 10-08 的 5 項決定都已落實（見第四節）。
- **驗證**：
  - build 結束碼 0，重跑一次 SVG、PNG、parts.csv 逐位元相同。
  - 子系統檢查全過、警告 0：crosstrack 109、s1 67、ebox 204。
  - 跨子系統 108 項：通過 103、未通過 0、資訊 5。
  - QA：草稿和 4 個分頁 SVG 各 14/14；試切檢查 45 項 0 未通過。
- **文件**：專案紀錄 v2 新增第五節；三份 `design/*/spec.md` 開頭加了勘誤（2026-10-08）。
- **還沒做**：試切、實量、光耦版 ESP32 程式、研習講義。

## 二、怎麼跑

先進到 `03_v2_光耦版` 資料夾（`.venv` 在上一層 repo 根目錄）：

```
cd 03_v2_光耦版
../.venv/Scripts/python.exe -B -m laser_v2.build_v2
```

- 約 1.5 分鐘。草稿、分頁 SVG、report、試切小樣一起更新；只要草稿就加 `--no-trial`。
- 結束碼：0＝全過；1＝QA 未過或流程出錯；2＝子系統／跨子系統／試切檢查未過；3＝`params.py` 填錯（印中文說明，不產生檔案）。
- 實量後只改 `laser_v2/params.py`，量什麼、改哪個鍵見 `laser_v2/out/report.md` 第四節。
- 自我測試：`-m laser_v2.textpath`、`-m laser_v2.compose`、`-m laser_v2.mods_crosstrack`、`-m laser_v2.mods_s1 --selftest`、`-m laser_v2.ebox --selftest`。
- 各檔用途見專案紀錄第五節；子系統介面見 `laser_v2/INTERFACE.md`。

## 三、輸出在哪（路徑都相對於 `03_v2_光耦版/`）

| 檔案 | 用途 |
|---|---|
| `laser_v2/out/sheet_合板_1.svg`～`sheet_合板_3.svg`、`sheet_壓克力_1.svg` | **上雷切機**（只有 3 個圖層，沒有註記層） |
| `laser_v2/out/trial_合板_1.svg` | **試切小樣上機檔** |
| `分幣機雷切_光耦版_v2_草稿.svg`、`分幣機雷切_光耦版_v2_試切小樣.svg` | 給人看（含隱藏註記層），不要直接上機 |
| `laser_v2/out/report.md` | 上機設定、材料採購、實量改哪裡、各子系統說明、待決 |
| `laser_v2/out/trial_report.md` | 試切每片要測什麼、過關標準、不過關改哪裡 |
| `laser_v2/out/parts.csv`、`*.png` | 零件清單（含「備品」「備品所在板」）、預覽圖 |

- 張數：合板 1 有 47 件（含備品 8），利用率 69.4%；合板 2 有 26 件，66.2%；合板 3 有 17 件，31.9%；壓克力 1 有 2 件，10.4%。
- 試切：合板 1 張，42 件（34＋備品 8），利用率 48.5%。
- 雷切軟體：黑 0.2 線＝切割；紅 0.2 線＝雕刻，紅色圖層設「線／向量雕刻」，不要用填色／掃描。圖層順序紅色在前，黑色開「先切內部」。

## 四、已定案

**2026-10-02**：
- TM1637 裝在正面 #24 左上；Logo 用方案 L2。
- 光束高 2.5 mm（`params.BEAM_H`）。
- 修正 #26 齒孔（`FIX_26_TOOTH_HOLE=True`）。

**2026-10-08（使用者）**：
1. `params.MODULE['back_h']`＝2.0，和 S1 規格名目一致。crosstrack 規格名目是 1.5，所以 P1 高 11.7→12.2，S50 最終位置離出口平面 0.99→0.52。
2. 雕刻和原始檔一樣用紅色 0.2 mm 線，v2 的字也是外框線字；定位框線、▲ 維持線。
3. 極小零件每套多排一整份備品，不加張數：PIN-S50 2、S1-H 3、S1-P 1、EB-K 2，全部在合板 1。
4. #24 正面不刻 S5／S10／S50，改在排線上貼標籤。
   - 模組端貼站名；盒端貼插座：S1→G27、S5→G26、S10→G25、S50→G33。
   - 認站：從轉盤那端往下游數，第 1 窗 S5、第 2 窗 S10，開到 #24 下緣的缺口是 S50。
5. 文件更新（這一輪已做）。

**實作中確定的更正**：
- **鎖塊塞法**：P1 背面貼住 #24 正面（窗的下方），往上推到凸塊碰 PCB 下面，再往後推 3 mm。不可從前方水平塞，會撞前臂焊腳。拆的時候先往前拉 3 mm，再往下拿開。
- **EB-K 改 L 形** 6.5×8.3：頭比舌長出來的那端朝上，從機身內側塞進上層掛勾槽上段。

## 五、仍待決（草稿照預設值；細節見 report.md 第八節）

- **S1**：
  - 導流帽＋1 mm 泡棉膠（預設要用）；
  - 卡匣用 M3 尼龍螺絲＋預黏螺帽；
  - #13R 牆頂 V30 或 V38（預設 V30）。
- **S5～S50**：
  - 模組左右手性（預設 `wing='up'`）；
  - 刪長榫、#6 補小榫；
  - 裝／拆 S50 前先抽出 10、50 元抽屜；
  - #5 只剩 2 支榫。
- **試切備案**：硬幣卡在 PCB 翼上時，是否改分離式紅外線對射。
- **電子盒**：
  - TM1637 用 M2 螺絲或熱熔膠；
  - USB／DC 在哪一端；
  - 免焊開關線組型式；
  - 感測器線 40 cm、盒端 1×3 G-V-S。
- **切割檔以外的備品**：S1 卡匣整組（建議 10 套 2 個）、光耦模組、鎖塊組、#24／#26 備片（report.md 第三節）。

## 六、待實量（改 `params.py` 後重跑）

- 合板實際厚度 `T_PLY`。
- 槽型光耦模組全部尺寸（`MODULE`）、左右手性；擋住時 OUT 是 HIGH 還是 LOW；接 3.3 V 能否穩定觸發。
- S1 模組前臂 PCB 背面焊腳的**位置**與高度。位置不是參數，量完先回報。
- TM1637（`params.TM1637`）：`hole_dx`／`hole_dy` 填**半距**，例如孔距 38×20 填 19、10。
- ESP32 擴展板＋開發板（孔位、USB／DC 端）、9V 電池。

## 七、下一步

1. **光耦簡易測試原型（2026-10-08 使用者確認規劃並完成，已 commit）**：
   - 在 `04_光耦測試原型/`，和 v2 完全分開（不 import laser_v2、不改 `02_v1_紅外線版` 的舊程式）。
   - 一段滑坡（後仰 30°、軌道斜 20°）＋一個感測窗＋墊片 9 片（調光束高度）；3 mm 合板一張 190×278 mm，只用白膠。
   - 產生器 `make_proto.py`（模組尺寸是暫定值，使用者當時手上沒有模組）；測試程式 `opto_test_esp32/`（尚未實際編譯過）。
   - 使用者收到模組後先照 `組裝與測試說明.md` 第 2 節實量；超出門檻就把數字給 Claude 改 `make_proto.py` 的 MODULE 重產，再切。
   - 測完回報的數字（實量值、最佳墊片／光束高、遮光時間、建議 DEBOUNCE）要回填 v2 的 `params.py`。
2. 切試切小樣（MDF、合板各一次），照 `trial_report.md` 驗收。
3. 模組買到後實量，改 `params.py` 重跑，全部檢查通過再切整台。
4. 光耦版 ESP32 程式（2026-10-12 已寫，`03_v2_光耦版/coin_sorter_opto_esp32/`，**還沒在實機編譯、執行過**）：
   - 公式 N1=C1、N5=C5−C10、N10=C10−C50、N50=C50；C5≥C10≥C50 不成立時顯示器冒號亮；
   - 中斷計數，「亮區重新上膛」防重複（`REARM_US` 預設 3000 µs，用測試原型的丟幣報告校正）；擋住不到 0.3 ms 當雜訊；
   - 開機 1.5 秒自動判定擋住電位（槽裡要清空）；BOOT 鍵歸零。
   - 下一步：實機編譯燒錄，照該資料夾 README「研習前檢查」驗收。
5. 研習講義與組裝說明。

## 八、其他提醒

- **只能動授權資料夾** `C:\ClaudeProject\分幣機` 和它的子資料夾。上一層、隔壁資料夾連列目錄都不行。
- 字型只讀 `C:\Windows\Fonts\msjh.ttc`（微軟正黑體）。
- Python 用 repo 根目錄的 `.venv`（根目錄執行 `.venv/Scripts/python.exe -B`；在 `03_v2_光耦版` 裡是 `../.venv/...`）。不要 pip install、不要下載。Bash 先 `export PYTHONIOENCODING=utf-8`。
- `01_原始機構/分幣機雷切原始檔.svg` 不可修改。`laser_v2/design/` 的規格只在開頭加勘誤，模型與 json 不改。
- 重跑會覆寫 `laser_v2/out` 裡產生器命名的檔。手改的檔要改名或另存。
- 光耦接 V 排針（3.3V），不要接 5V。
- 這個環境擋掉了 taiwaniot.com.tw，無法查商品頁。
