kingofamani/CoinSorting/分幣機_交接_2026-10-02.md

> 已由 分幣機_交接_2026-10-08.md 取代。

# 分幣機 v2 雷切檔：交接（2026-10-02）

開新對話時，請把這份檔案和 `分幣機_專案完整紀錄v2.txt`（先看第四節）一起交給 Claude。
分支：`main-wj17sg`。使用者偏好：繁體中文。

## 一、目前進度

已完成，並推到 `main-wj17sg`：
- **bug 修正**：`esp32/coin_sorter_esp32/coin_sorter_esp32.ino` 多餘的 `m` 已刪。7 支 .ino 都檢查過能編譯。
- **專案紀錄**：新公式、S1 方案 A、電子盒、255×355 頁面、實測幾何都寫進去了（第一節、3-4、3-5、3-8、第四節）。
- **`laser_v2/` 產生器基礎**：
  - `catalog.py`：原始檔拆成 60 個編號零件，保留曲線，做了清理。
  - `frames.py`：組裝座標 (U,V,W') 和零件頁座標互換，有 82 項驗證。
  - `params.py`：共用參數，模組尺寸是暫定值。
  - `INTERFACE.md`：子系統介面。
- **三份已審定的設計規格**：放在 `laser_v2/design/`，含 spec.md、模型程式、geometry json、示意圖。
  - `crosstrack_final/`：S5/S10/S50「滑升式感測座」。#24/#26 在立柱下方開階梯窗，模組推入後上滑，再用鎖塊 P1 和蓋板 C1 固定；軌道和開口零改動；光束離軌道 2.5 mm。
  - `s1wall_final/`：S1 卡匣（方案 A）。#13 改成加高的 #13R 右牆，卡匣從 #37 背面插入；前臂黏 3 片導流帽 S1-H，用 1 mm 泡棉膠墊高。
  - `ebox_final/`：電子盒是掛在 #37 背面的兩層掛勾盒；TM1637 改裝在正面 #24 左上方的窗，Logo 用方案 L2 移位。
  - `analysis_round1.md`：第一輪的量測與分析。

**還沒做**：把三份規格寫成產生器、排版、輸出 v2 草稿 SVG，以及試切小樣檔。

## 二、下一步（依序）

1. 實作 `laser_v2/mods_crosstrack.py`、`mods_s1.py`、`ebox.py`：照 `INTERFACE.md`，從 `design/*/model.py`、`design.py` 移植，模組尺寸讀 `params.MODULE`。
2. 實作 `compose.py`（合併修改、保留原始曲線）、`textpath.py`（文字轉路徑，字型 wqy-zenhei）、`layout.py`（排進 255×355；合板預估 3～4 張，壓克力另排）、`export.py`、`build_v2.py`。
3. 跨子系統要注意：
   - #37 的感測器線孔用 U88～100×V40～46，不可和 S1 背蓋、B1 槽重疊。
   - 電子盒的 S1 禁區改用 s1wall_final 的實際範圍。
   - #5 要同時套用 crosstrack 和 ebox 兩組修改。
   - #26 要同時套用三個子系統的修改，再加上齒孔修正。
4. 輸出：
   - `分幣機雷切_光耦版_v2_草稿.svg`（多頁）；
   - `laser_v2/out/`：分頁 SVG、預覽 PNG、parts.csv、report.md；
   - `分幣機雷切_光耦版_v2_試切小樣.svg`。
5. 驗證：
   - 分幣開口和軌道要和原檔逐點相同；
   - 榫槽配對要對齊；
   - 雷切檔衛生：閉合、不重疊、≤255×355、沒有 `<text>`；
   - 研習實用性。

## 三、使用者已定案（2026-10-02）

- **下一步**：改天開新對話，用工作流程（多 agent）做第二節。
- **TM1637**：依建議改裝在正面 #24 左上方；Logo 依方案 L2 移位，雕刻「1」「5」也照規格移位。電子盒仍掛 #37 背面。
- **光束高度**：2.5 mm（params.BEAM_H，已是預設值）。
- **#26 齒孔**：修正（params.FIX_26_TOOTH_HOLE=True，用 frames.fix_26_tooth_hole()）。

## 三之一、仍待使用者決定

1. **其他細節**：
   - S1 導流帽和泡棉膠；
   - 用 M3 尼龍螺絲加預黏螺帽；
   - 牆頂高度 V30 或 V38；
   - 裝 S50 前要先抽出 10、50 元抽屜；
   - #5 只剩 2 支榫；
   - 電源開關要買哪一款免焊線組。
2. **試切備案**：如果試切時硬幣卡在模組 PCB 翼上，同不同意把 S5/S10/S50 改成分離式紅外線對射？
（各項細節見 `design/*/spec.md` 最後的待決問題。）

## 四、待使用者實量（模組買到後，改 `params.py` 重跑）

- **槽型光耦模組**：
  - 槽寬（確認是否 10 mm）、槽深、光束離槽底、臂寬與臂厚、臂頂離 PCB；
  - PCB 長寬厚，光耦本體在 PCB 上的位置（靠邊或置中，也就是左右手性）；
  - 排針位置與方向、背面焊點高度、固定孔；
  - 擋住時 OUT 是 HIGH 還是 LOW；接 3.3V 能否穩定觸發。
- **TM1637**：PCB 尺寸、LED 塊位置、固定孔、排針型式。
- **ESP32 擴展板＋開發板**：固定孔、DC 座和 USB 在哪一端、開發板是否置中。

## 五、其他提醒

- 光耦接 V 排針（3.3V），不要接 5V。
- 之後改程式時：
  - 公式：N1=C1、N5=C5−C10、N10=C10−C50、N50=C50；
  - 用中斷計數，因為 TM1637 更新一次約 21 ms，期間不讀感測器；
  - 槽型模組擋住時多半輸出 HIGH，BLOCKED_LEVEL 要實測。
- 這個環境擋掉了 taiwaniot.com.tw，無法查商品頁。
