kingofamani/CoinSorting/04_光耦測試原型/組裝與測試說明.md

# 光耦簡易測試原型：組裝與測試說明

一段直滑坡加一個槽型光耦模組。雷切、組裝好以後自己裝上模組測試，用來驗證「槽型光耦跨裝在滑坡上」行不行得通。

- 這份說明的數字都出自 `make_proto.py`，是用**暫定的模組尺寸**算的。模組實量後會重跑，窗、光孔、墊片都會改，到時請 Claude 一起更新這份說明。
- 方向的說法：站在滑坡正面（有放幣線的那一面）看，硬幣從左上往右下滾。**右＝下游（出口）**，**前＝靠你這邊**，**後＝背牆後面**。

| 檔案 | 用途 |
|---|---|
| `光耦測試原型_雷切.svg` | 上雷切機用 |
| `示意圖.png` | ① 滑坡正視、② 感測處剖面、③ 側視 |
| `預覽.png` | 整張板的排版；藍色代號只畫在預覽圖上，SVG 裡沒有 |
| `零件表.csv` | 零件清單（含要自備的電子零件） |
| `make_proto.py` | 產生器，參數都在檔案開頭 |
| `opto_test_esp32/` | ESP32 測試程式和 README |
| `接線圖/` | ESP32 接線圖 PNG／SVG（`make_wiring.py` 產生） |
| `組裝教學/index.html` | 講師用的組裝步驟網頁（內容同這份說明；圖由 `make_figures.py` 產生） |

---

## 準備清單

**材料**
- 3 mm 合板一張，至少 191×279 mm（A4 就夠）。
- 白膠、牙籤、濕布、砂紙（磨榫頭用）、幾本書（壓平用）、保鮮膜。

**工具**
- 游標卡尺（沒有的話用鋼尺）、直尺、筆。
- 名片 10 張左右：量光束高、墊對位塞、補墊片的高度都會用到。
- 厚紙板一小塊、紙膠帶。
- 一個 100 g 以上的重物（或用紙膠帶），用來把底板固定在桌上，防止整台往後翻。
- 接硬幣的淺盤或碗。

**電子**（零件表也有列）
- 槽型光耦模組（見 2-1），建議買 2～3 個。
- ESP32 開發板＋擴展板（G27 那一排有 S／V／G，黃色跳帽可以設 3.3V）。
- 母母杜邦線 3 條。要接顯示器的話再 4 條。
- 能傳資料的 USB 線（不是只能充電的那種）。
- 電腦：Arduino IDE，已經裝好 ESP32 開發板支援（core 2.0.x 或 3.x 都可以）。
- TM1637 四位數顯示器（可不接）。

**硬幣**
- 5 元、10 元、50 元各至少 2 枚：兩枚相貼的測試要用 2 枚。
- 1 元幾枚：試滾和選做的加嚴測試用。
- T3 每一輪要放 20 枚：可以準備 20 枚，也可以只用幾枚，每放一枚就從盤子撿回來重放。

---

## 1. 這個原型要驗證什麼

**要驗證的：**
- 槽型光耦能不能跨在「擋幣板 D＋背牆 B」兩片 3 mm 板上（兩片疊起來 6 mm），裝得上、拆得下；光束從軌道上方約 2.5 mm 穿過。
- 滑坡的傾斜和正式機相同：後仰 30°，軌道在背牆上斜 20°（對水平約 17.2°）。從 S5、S10、S50 三條放幣線放手，硬幣經過感測處的速度就和正式機三站相同。
  - 前提：光束對準的是離窗右邊 3.7 mm 的那個光孔（模組本體靠 PCB 右邊，見 2-2 第 10 項）。照實量值重新產生後，放幣線會自動以實際用的那個光孔重算。
- 在這個速度下要確認：
  - 各站會經過的硬幣，每一枚都數到，不多數也不漏數：**S5 是 5、10、50 元；S10 是 10、50 元；S50 是 50 元**。1 元在正式機先落進 1 元孔，由 S1 計數，不會經過這三站。
  - 兩枚貼在一起滾過時，分得出是兩枚。每站測該站最難分的那種：S5 的 5 元、S10 的 10 元、S50 的 50 元。
  - 最薄的 5 元慢慢推過也會觸發。
- 硬幣不卡住、不跳出軌道，也不會擦到模組的前臂。
- 窗上方的軌道條只有 2.3 mm（兩片疊起來 6 mm 厚），要確認強度夠。
- 量出實品的數字，回填 v2：模組尺寸、最佳光束高度（用哪一片墊片）、遮光時間、計數程式的建議值（DEBOUNCE 和重新上膛時間）。

**不在這裡驗證**（這些在 v2 試切小樣測，上機檔是 `laser_v2/out/trial_合板_1.svg`，說明在 `laser_v2/out/trial_report.md`）：
- 分幣開口，也就是硬幣在哪裡掉下去。
- PCB 和模組會不會被落下的硬幣打到。
- 正式的滑升式感測座和鎖塊（P1＋C1）。原型用墊片撐住模組，只是測試用的做法。
- 轉盤送幣、整機振動、三站同時計數、外殼。

---

## 2. 先買模組；收到後，切之前先量

### 2-1 買什麼
- 買「**槽寬 10 mm**」的槽型（對射式）光耦模組：LM393 比較器、有 DO 數位輸出、標示 3.3～5 V 可用。
- **不要買槽寬 5 mm 的**（常見的「測速模組」多半是 5 mm），兩臂跨不過 6 mm 的兩片板。
- 商品頁有尺寸圖的話，挑光窗離槽底 ≥ 5 mm 的（原因見下表第 3 項）。
- 建議買 2～3 個：一個裝上去、一個備用，也可以比較個體差異。

### 2-2 收到後先量
工具：游標卡尺；沒有的話用鋼尺。先把模組擺成「**安裝方向**」：
- 槽口朝上，槽口左右走向（硬幣會從左往右穿過槽）。
- 排針那一端朝後，也就是遠離你的那一邊。
- 這時靠你的是「前臂」，遠的是「後臂」；PCB 的右邊就是下游。

「可直接切」的範圍，是假設**其他項目都接近預設值**。有兩項以上偏離時，看 2-3。

| # | 量什麼 | 怎麼量 | 這份檔的預設 | 在這範圍可直接切 |
|---|---|---|---|---|
| 1 | 槽寬 | 卡尺內測爪量兩臂內面之間 | 10.0 | ≥ 6.5（小於 6.5 的模組不能用，見表下） |
| 2 | 槽深 | 卡尺深度桿，從臂頂量到槽底 | 9.0 | 6.0～10.7 |
| 3 | 光束離槽底 | 量臂內面小方窗（光窗）的中心離槽底多高，方法見表下 | 5.0 | 4.8～8.3（見＊） |
| 4 | 臂頂離 PCB | 深度桿，從臂頂量到 PCB 上表面 | 12.0 | 10.3～14.9 |
| 5 | 背面焊點高 | 模組焊點朝下平放在桌上，深度桿從 PCB 上表面量到桌面，再減掉 PCB 厚 | 2.0 | 0.3～4.9 |
| 6 | PCB 厚 | 卡尺夾住 PCB 邊緣 | 1.6 | 常見的 0.8～2.0 都可以 |
| 7 | PCB 沿軌道方向的寬（左右） | 卡尺 | 20.0 | ≤ 24.0 |
| 8 | PCB 沿光束方向的長（前後） | 卡尺 | 27.6 | 不限，記下來就好 |
| 9 | 排針：在哪一端、朝哪個方向、插上杜邦頭後多高 | 照安裝方向擺好看 | 在後端、直立、14 | 在後端、朝上或水平伸出去都可以。在左右兩側（擺不成「排針朝後、槽口左右走向」），或排針朝下穿到 PCB 背面 → 見表下 |
| 10 | 本體中心離 PCB 右邊（o） | 照安裝方向從前面看，量 PCB 右邊到兩臂左右方向的中心 | 3.7 | 3.3～4.1（見＊＊） |
| 11 | 槽口下方有沒有更高的零件 | 鋼尺立著放進槽裡，左右橫跨整片 PCB；尺的下緣要碰得到槽底，不能被別的零件頂住 | 沒有 | 碰得到槽底就可以 |
| 12 | 合板厚 | 卡尺量要切的那張板 | 3.0 | 2.8～3.1 |

**超出範圍時：**
- 第 1 項槽寬小於 6.5：**這個模組不能用**，請重買槽寬 10 mm 的。兩片板疊起來就有 6 mm，改參數也救不了。
- 第 9 項排針朝下穿到 PCB 背面，或排針在左右兩側：要改安裝方式（或把排針改焊到另一面、換模組），先把照片給 Claude 看。
- 其他項目：把數字給 Claude 重新產生就能解決。

**第 3 項怎麼量：**
- 方法 A：用深度桿從臂頂分別量到光窗上緣和下緣，兩個數取平均得到 d。光束離槽底＝槽深 − d。
- 方法 B（比較準）：先照第 5 節接好線、跑起程式，ESP32 插 USB 就有電。拿一張名片從槽口慢慢往下插，模組上的指示燈（或測試程式的 `v`）一變就停。對著臂頂在名片上畫一條線，量這條線到名片下緣的距離 d。光束離槽底＝槽深 − d。

兩隻臂的光窗都要看；高度不一樣的話兩個都記下來。

**＊**光束最高只能到「光束離槽底 − 2.3」，因為窗上方有 2.3 mm 的軌道條擋著。
- 量到 4.3～4.8：原型照樣能切、能測，但光束到不了 v2 定案的 2.5 mm，v2 也得跟著改，所以要先告訴 Claude。
- 量到低於 4.3：一定要先給 Claude 重新產生。

**＊＊第 10 項（o）為什麼只有 3.3～4.1 可以直接切：**
- 背牆上開了 3 個光孔，中心離窗的右邊 3.7、10.0、16.3 mm。o 落在 3.3～4.1、9.6～10.4、15.9～16.7 都對得到其中一個孔，感測器照樣能用。
- 但雕刻的放幣線是以 3.7 那個孔算的。光束在另外兩個孔時，放幣線離光束會少 6.3 或 12.6 mm，硬幣經過時慢 3～19%（S5 最多），測到的遮光時間和建議值都會偏。
- 所以 o 不在 3.3～4.1 時，先把 o 給 Claude 重新產生，再切。重新產生後，窗、光孔、放幣線會以實際的本體位置一起重算。
- **已經切好了才發現**：照樣可以測，只是放手點要改成從雕刻線再往左（上游）量：
  - 光束在中間孔（10.0）：往左 6.3 mm。
  - 光束在左孔（16.3）：往左 12.6 mm。
  - 用鋼尺從雕刻線往左量，硬幣中心對準量到的位置。
  - S50 往左量會超出軌道起點，就從軌道最左端放（硬幣中心離左端約 1 mm、站得穩）。中間孔時速度差不到 1%；左孔時約慢 4%，紀錄表要註明。

**順便記下來**（重新產生時會用到，沒有門檻）：
- 臂厚（前後方向）、本體寬（左右方向）、光窗大小、PCB 上最高的零件。
- 型號或商品連結。
- 正面、側面、背面的照片，拍照時旁邊放一把尺。

### 2-3 兩項以上偏離時
下面四條**全部成立**，而且表中第 1、7、9、10、11、12 項都在範圍內，就可以直接切：
1. 模組總高＝背面焊點＋PCB 厚＋臂頂離 PCB **≤ 18.6**（預設 15.6）。這樣模組在低位才推得進窗（窗高 19.1）。
2. 槽底高＝（臂頂離 PCB − 槽深）＋PCB 厚＋背面焊點 **≤ 9.6**（預設 6.6）。這樣最低的那片墊片（9.5）才塞得進去。
3. 光束離槽底 **≥ 4.8**（預設 5.0）。這樣光束才能到 2.5。
4. 光束離模組最低點＝槽底高＋光束離槽底，要在 **9.9～14.9** 之間（預設 11.6）。這樣 9 片墊片裡至少有一片能讓光束落在 2.0～3.0。

**最穩的做法：**量完把整張表的數字都給 Claude。Claude 會改 `make_proto.py` 開頭的 `MODULE` 重跑（必要時也改窗、墊片範圍、光孔位置），光孔、墊片和放幣線就會對準實品，然後再切。上面這些門檻，是給「急著先切」時判斷用的。

---

## 3. 雷切

- **上機檔**：`光耦測試原型_雷切.svg`。
  - 單頁 190.1×278.1 mm，共 15 片零件，用 3 mm 合板。
  - 板子至少要 191×279 mm，A4 大小（210×297）就夠。
- 匯入雷切軟體後，確認尺寸還是 190.1×278.1 mm。不要縮放；有些軟體會用錯 dpi，尺寸就跑掉了。
- **黑色 0.2 線＝切割**，要切穿。
- **紅色 0.2 線＝雕刻**：紅色圖層設成「線／向量雕刻（低功率切割）」，淺淺刻一條、不要切穿。不要用填色或掃描雕刻。
- 順序：先雕刻再切割；切割時先切孔（窗、光孔、榫槽），最後切外框。檔案已經照這個順序排好；如果雷切軟體會自己重排，就打開「先切內部（inner first）」。
- 切完檢查：
  - 15 片都在：A 底板、B 背牆、C 支撐 ×2、D 擋幣板、E1～E9 墊片、F 對位塞。
    - 墊片上雕「代號＋高度」，例如「E7  12.5」＝E7、撐高 12.5 mm。E1～E9 依序是 9.5～13.5。
  - B 和 D 窗挖下來的兩塊也留著，可以代替 F。
  - B 上 3 個小光孔（1.8 mm 寬）都有切穿：對著燈看得到光。
  - B、D 窗頂那條 2.3 mm 的軌道條沒有燒斷、沒有翹起來。
  - 用濕布擦掉切邊的黑灰，特別是 D 的上緣，那裡就是軌道。

---

## 4. 組裝（只用白膠、不用螺絲；對照 `示意圖.png` ① 和 ③）

- **先不上膠，全部試插一次。** 榫太緊就用砂紙磨榫頭，不要硬敲。
- 零件的方向：
  - B、D：雕「（正面）」的那一面朝前。
  - A：雕字的那一面朝上，「↓ 前側」箭頭朝向滑坡正面。
  - C：兩面都可以。

**4-1 把擋幣板 D 黏到背牆 B（對位）**
1. 做一疊墊紙：5 張名片（或 1～2 層厚紙板），疊起來約 1.5 mm 厚，剪成約 22×16 mm，要比窗小。
   - **不要用硬幣墊**：四種硬幣都比窗的短邊（19.1 mm）大，會把 B 墊高，F 就凸不出來。
2. F 的四邊包一層保鮮膜，免得被白膠黏住。
3. B 正面朝上平放在桌上。把墊紙放進 B 的窗裡（直接放在桌面上），再把 F 放進 B 的窗、坐在墊紙上。
   - 這樣 F 下半卡在 B 的窗裡，上半凸出 B 正面約 1.5 mm。
4. 在 D 的背面薄薄塗一層白膠：窗邊和上緣（軌道）各留約 2 mm 不塗；窗頂那條軌道條只用牙籤點一點點。
5. D 正面朝上，把 D 的窗套進凸出來的 F。
   - D 的下緣對齊 B 上雕的「↑ 擋幣板 D 下緣對齊這條線」，兩端對齊雕刻的短線。
   - 這兩條雕刻線也是備用的對位方法：F 不見了，照這兩條線對齊也可以。
6. 壓平（上面壓幾本書）。擠出來的膠馬上用濕布擦掉，特別是 D 上緣和 B 正面的夾角（硬幣就在這裡滾）和窗口。
7. 大約 30 分鐘後拿起來，拿掉墊紙，從背面把 F 頂出來。
   - 頂不動時不要硬敲（軌道條只有 2.3 mm），先用牙籤沿窗邊清掉膠再推。
   - 窗挖下來的那塊也可以代替 F 用，一樣先包保鮮膜。

**4-2 裝支撐 C**

8. 把兩片 C 斜邊上的 2 個榫，插進 B 背面兩端的支撐槽，上膠。C 下緣的 2 個榫要朝下。

**4-3 插進底板 A**

9. B 和 C 連在一起，**垂直往下**插進 A，上膠：
   - B 下緣的 2 個榫，插進 A 前面的 2 個斜插槽（比較寬的那兩個）。
   - C 下緣的榫，插進 A 後面的 4 個槽。
10. 放在平桌上，確認整台不晃，然後靜置。裝模組、丟硬幣之前最好放一晚。
    - B 斜 30°，所以 B 下緣是**背面那一角**碰到 A；正面那一角離 A 約 1.5 mm 是正常的，不是沒插到底，不要硬壓。

**4-4 試滾（先不裝模組）**

11. 整台放在水平的桌面上，**先把底板固定好**：
    - 背牆往後仰，軌道上段的硬幣、之後裝上的模組和線，都在支撐的後方。底板已經往後加長，但手指從前面往後推一下，還是可能把整台推翻。
    - 底板後半部（支撐後面那一段）用紙膠帶貼在桌上，或壓一個 100 g 以上的東西。
    - 出口（右端）外側放一個淺盤或碗接硬幣。出口離桌面 60 mm，盤子或碗的口要低於約 5 cm。
    - 想用一般紙杯的話，把整台墊高約 4 cm：墊的東西要比底板大，底板也要用膠帶固定在墊的東西上。
12. 直尺立在軌道上看窗那一段：
    - 拿一張影印紙（約 0.1 mm）試著塞進直尺下面，窗那一段要塞不進去（軌道沒有往下凹）。
    - 也不能有膠瘤。
13. 四種硬幣各從 S5 線、S50 線放 5 次。
    - 放法：硬幣立在軌道上、靠著背牆，中心對準雕刻線，指尖輕輕扶著硬幣頂端再放手，不要推。
    - 每次都要滾到出口掉下去：中途不停、不從前面掉下來、經過窗那一段沒有明顯跳動。
    - 有問題先處理（多半是膠瘤或切邊毛邊），處理好再裝模組。

---

## 5. 接線與測試程式（裝模組之前先做）

第 6 節裝模組、量光束高時就要看指示燈和 `v`，所以先把線接好、程式跑起來。完整說明在 `opto_test_esp32/README.md`，重點如下。

**5-1 接線**
- 光耦 OUT（有的寫 DO）→ 擴展板 G27 那一排的 S。
- VCC → 同一排的 V；GND → 同一排的 G。
- AO 不接。
- **黃色跳帽一定要設在 3.3V，不可以接 5V。**
- 顯示器 TM1637 可以不接；要接的話 CLK→G14、DIO→G13、VCC→V、GND→G。
- **杜邦線先插在模組的排針上，再裝模組。** 裝好以後排針在背牆後面、背牆的下方，事後才插容易把模組推歪。

**5-2 上傳程式、確認判定**
1. 用 Arduino IDE 開 `opto_test_esp32/opto_test_esp32.ino`。
2. 開發板選「ESP32 Dev Module」，按上傳。
   - 下方訊息出現 `Connecting……` 時，**按住板子的 BOOT 鍵**，開始寫入（出現百分比）後再放開。
   - 沒按會出現 `Failed to connect` 或 `Timed out`：再上傳一次，這次按住 BOOT 就好。
3. 序列埠設 115200。
4. 開好序列埠視窗後按 EN 重開。開機約 1 秒會自動判定擋住時的電位，**這段時間槽裡不能有東西**（模組還沒裝，就讓它懸空、槽裡空著）。
5. 確認判定沒有反：用紙片在槽裡擋住光束約 1 秒，再拿開。
   - 正確：擋住的當下印「▼ 擋住（#1 開始）」，拿開後才印「#1 遮光 約 1000 ms」。
   - 反了：拿開時才印「▼ 擋住」，或擋住的當下就印出「#1 遮光…」。輸入 `h` 或 `l` 改過來，或清空槽後輸入 `a` 重新判定。
6. 輸入 `v`，用手指在槽裡擋 10 次（就是 T2 的做法）：擋住要顯示「■ 擋住」，拿開要顯示「· 沒擋」，模組上的指示燈也跟著變。再輸入 `v` 關掉。

**5-3 常用指令**（打完按 Enter）
- `v`：開／關即時電位顯示。
- `k5`／`k10`／`k50`（`k1` 選做時用）：設定幣別，用來估算速度。
- `b2.7`：設定光束高，填第 6 節量到的值。
- `c20`：開始丟 20 枚；丟完輸入 `e` 印出報告。
- `p`：逐筆印出脈衝，看有沒有抖動。
- `g3`、`d0`：「即時計數」的設定。
  - `g3`：光束連續亮 3 ms 以上，下一次擋住才算新的一枚（亮區重新上膛）。
  - `d0`：從擋住開始算，幾 ms 內再擋住都算同一枚（前緣 DEBOUNCE），0＝不用。
  - 即時計數就是顯示器、`#N` 那幾行、報告「★ 結論」第一行用的規則。報告裡的兩種方法會另外把所有候選值都試算一遍，不受 `g`、`d` 影響。
  - **每次 `e` 印完報告，程式會自動把即時計數改成報告建議的亮區值**（印出「本工具的即時計數已改用…」）。所以第 7 節每一輪 `c` 之前，都先輸入 `g3` 和 `d0`，讓每一輪的即時計數用同一個設定。
- `h`、`l`、`a`：擋住時的電位判斷反了的時候用。
- `r`：歸零。`?`：說明。
- 出現「⚠ 光束已經連續擋住 3 秒」：槽裡有東西卡住，或判定反了。輸入 `v` 看，槽空著卻顯示「■ 擋住」就是判定反了。用名片量光束高、手指擋著超過 3 秒時也會出現這行，那是正常的，不用理它。
- 這支程式還沒有實際編譯過。如果編譯時出現 `section of 'onEdge' conflicts with previous declaration`，把 `onEdge` 前面的 `IRAM_ATTR` 刪掉就好。

---

## 6. 裝模組與選墊片（對照 `示意圖.png` ②）

開始前確認：
- 第 5 節的線已經接好、程式在跑，杜邦線已經插在模組上。
- 底板已經固定在桌上（4-4 第 11 步）。從前面塞墊片的力，會把整台往後推。

模組的方向：
- PCB 和背牆垂直，PCB 的邊和窗邊平行。
- 排針那一端留在背牆後面，兩臂朝窗頂（軌道條）。

下面說的「推入」，是**垂直背牆**往前推，不是沿著桌面水平推。

**6-1 低位推入**
1. 從背面把模組放到窗的「低位」：PCB 背面（焊點那面）靠在窗底，兩臂朝上。
2. 垂直背牆往前推，讓前臂整個穿過兩片板的窗，到擋幣板的前面。以暫定尺寸來說，這時臂頂在軌道條下方約 3.5 mm，不會碰到。
   - 注意：低位時重力有往背後的分量，模組會自己往後滑出來，手要一直扶著。

**6-2 抬起來**

3. 從背面捏住後臂（或排針根部）往上提，把模組往窗頂抬（行程約 12.5 mm），讓軌道條（兩片疊起來 6 mm）進到兩臂中間，一直抬到槽底頂住軌道條。
   - 手指不要放在 PCB 下面：等一下墊片的後端會從背牆後面伸出來，剛好在 PCB 下方。
4. 把模組往右（下游）推，讓 PCB 的右邊貼住窗的右邊。
   - 這時光束會落在 3 個光孔的其中一個。3 個光孔的中心離窗的右邊分別是 3.7、10.0、16.3 mm，對應光耦本體靠 PCB 右邊、在中間、靠左邊三種情況。開 3 個孔，是因為買到之前不知道本體在 PCB 的哪一邊。
   - 雕刻的放幣線是配合 3.7 那個孔的。光束在另外兩個孔時，放幣點要改，見 2-2 的＊＊。

**6-3 塞墊片：找出「塞得進去的最高那片」**

5. 捏著後臂的手繼續把模組往上提住，另一手從前面塞墊片：
   - 墊片雕字的那一面朝右（出口那一邊），字要是正的，字下面有底線。這時擋耳在左下，也就是擋耳在前面、往下垂。
   - 把墊片的長條從擋幣板的窗塞進去，放在 PCB 下面、光耦本體正下方，一直推到擋耳靠住擋幣板正面。
6. 從最高的 E9（13.5）開始試；塞不進去，就換低 0.5 mm 的下一片，直到塞得進去為止。
   - 塞得進去的最高那片，就是模組剛好頂住軌道條的那片。以暫定尺寸來說是 E7（12.5）。
   - **塞不進去時不要硬敲，也不要用槽去撬軌道條**：軌道條只有 2.3 mm，會被頂裂。
   - E9（13.5）塞進去以後，模組還頂不到軌道條：表示模組比暫定矮。先在 E9 上面疊名片（一張約 0.3 mm），疊到剛好頂住，再照下面量光束高；最好把實量值給 Claude 重新產生（墊片範圍會跟著改）。
7. 撐住 PCB 的另一端：
   - 墊片只有 3 mm 寬。只撐本體下方的話，模組的重心多半在墊片外面（暫定尺寸的 PCB 從本體往左伸了約 16 mm），左端會往下垂，模組就歪了。歪 5° 光束沿軌道就偏約 1 mm，而光孔半寬只有 0.9 mm。
   - 在 PCB 另一端（暫定尺寸是左端，離 PCB 左邊約 2～3 mm）再塞一片墊片：挑「塞進去不會把 PCB 頂起來」的最高那片，再塞名片補到剛好貼住 PCB 背面。不要把這一端頂高。
   - 本體在 PCB 中間的模組，PCB 左右兩端都要各撐一片。
8. 慢慢放手：模組會坐在墊片上，前臂內面靠著擋幣板正面。這是正常的，因為重力有往後推的分量。
9. 量水平：PCB 前端露在擋幣板前面。用卡尺的深度桿（或鋼尺），從擋幣板窗的下緣量到 PCB 底面，左、右兩端各量一次，**相差要 ≤ 0.5 mm**。
   - 差太多，就在**垂下去**的那一端下面多塞名片，再量一次。

**光束高度**
- 用塞得進去的最高那片時，光束高大約是「光束離槽底 − 2.3」。之後每換低一片，光束就低 0.5 mm。
  - 以暫定尺寸來說：12.5→2.7、12.0→2.2、11.5→1.7、11.0→1.2、10.5→0.7。
  - 9.5 和 10.0 兩片，在暫定尺寸下光束低於可用的高度（9.5 時光束在軌道面下 0.3；10.0 時光束中心在軌道上方 0.2，但光窗下半會被擋幣板上緣擋到）。13.0 和 13.5 塞不進去。這幾片是留給模組比暫定大或小的時候用的。
- **直接量**（建議每換一片就量一次）：
  1. 拿一張名片貼著背牆正面，在光孔的位置從上往下插進硬幣通道（擋幣板上緣、背牆前面那 3 mm 寬的地方）。
  2. 指示燈（或 `v`）一變就停住，沿著背牆上緣在名片上畫一條線。
  3. 把名片插到底、碰到軌道，再沿背牆上緣畫一條線。
  4. 兩條線之間的距離就是光束高。把量到的值輸入測試程式，例如 `b2.7`。

**6-4 裝好後檢查**
- 從上往下看硬幣通道：前臂內面不可以伸進背牆正面前方那 3 mm（擋幣板上緣上方）的範圍。前臂內面應該貼齊擋幣板正面。
- 從背面看：後臂和背牆背面之間有空隙（約 4 mm），排針在背牆後面（約 4.8 mm），都沒有碰到板子。
- 模組沒有歪：第 9 步量的左右兩端相差 ≤ 0.5 mm。
- 光束有對到光孔：開 `v`，硬幣通道空著時要顯示「· 沒擋」；名片從上方插進光孔前面的通道，要顯示「■ 擋住」（和 T2 一樣）。
  - 從正前方看不到後臂的光窗是正常的：前臂本體正好擋在光孔前面。
- 四種硬幣都用手慢慢推過感測處，尤其是最厚的 50 元：不能擦到前臂，也不能被頂起來。

**常見狀況**
- **光束沒對到光孔**（指示燈或 `v` 一直顯示「擋住」）：
  - 先查模組有沒有歪（第 9 步，左右相差 ≤ 0.5）。模組歪了，光束會往上游（左）偏；這時再把模組往左推只會更偏。
  - 沒有歪，原因多半是本體的位置和暫定的不一樣。可以在 PCB 右邊和窗右邊之間塞紙板，把模組往左推，對準其中一個光孔。紙板厚度＝光孔的數字（3.7、10.0 或 16.3）− o。例如 o＝2.5，就塞 1.2 mm，對準 3.7 那個孔。
  - 對準的不是 3.7 那個孔時，放幣點要改，見 2-2 的＊＊。
  - 怎麼塞都對不到，就把 o 給 Claude 重新產生。
  - 如果是光束太高或太低，就換墊片。
- **50 元擦到前臂**（50 元和前臂之間本來就只有 0.6 mm）：
  - 在擋幣板正面、窗正上方的軌道條前面，貼約 2 mm 厚的紙板（兩層厚紙板），讓前臂改靠在紙板上。
  - 代價是抬模組時，前後只剩約 2 mm 可以動。
- **模組被線拉歪**：線不要往背後拉緊。讓線往下走，用膠帶固定在底板 A 上，留一點鬆度。
- **整台會晃或往後翻**：底板沒有固定，見 4-4 第 11 步。

---

## 7. 測試步驟與過關標準

- 先用「光束最接近 2.5」的那片墊片做 T1～T6（以暫定尺寸來說是 E7 12.5，光束 2.7），最後再做 T7 比較不同墊片。
- **底板要一直固定在桌上**（4-4 第 11 步）。T4 兩枚 50 元放在軌道上段時尤其重要。
- 每一輪的順序：先輸入 `g3`、`d0`（固定即時計數的設定），再 `k幣別` → `c枚數` → 放幣 → `e`。
- 每一輪輸入 `e` 後印出的報告，整段複製存成文字檔，例如 `測試紀錄/50元_S50_墊片12.5.txt`，最後一起給 Claude。
- **單枚的放法**：照 4-4 的放法，硬幣中心對準雕刻線；等前一枚掉進盤子，再放下一枚。
- **兩枚相貼的放法**：兩枚立在軌道上互相貼緊，讓**兩枚之間的接觸點**對準雕刻線，同時放手。
  - S50 的 50 元放不下：上游那枚會超出軌道起點。這時把上游那枚放在軌道最左端（中心離左端約 1 mm、站得穩），下游那枚貼在它右邊。接觸點離光束約 97 mm，比 S50 慢約 4%，紀錄表備註寫「S50 相貼從左端放」。
- 光束不在離窗右邊 3.7 的那個光孔時，單枚和相貼的放手點都照 2-2 的＊＊往左移。
- 名詞：
  - 「卡幣」：硬幣停在軌道上，沒有滾到出口。
  - 「跳出」：硬幣在出口之前就離開軌道（從前面掉下去或彈出去）。

| 項目 | 怎麼做 | 過關標準 |
|---|---|---|
| T1 閒置穩定 | 看開機判定；再開 `v` 看 1 分鐘，感測處保持空的（在室內燈下） | 開機沒有「訊號不穩」警告；1 分鐘內 0/1 都沒變，計數 0 |
| T2 擋住會變 | 開著 `v`，用名片從上方插進感測處的硬幣通道擋住光束再拿開，做 10 次。模組還沒裝上時，可以直接用手指在槽裡擋 | 每次擋住都顯示「■ 擋住」，拿開顯示「· 沒擋」；計數剛好 +10 |
| T3 單枚計數 | 只測正式機會經過的組合，共 6 輪：S5 線放 5、10、50 元；S10 線放 10、50 元；S50 線放 50 元。每輪：`g3` `d0` → `k幣別` → `c20` → 一枚一枚放 20 枚 → `e` | 每輪報告「★ 結論」的即時計數都是 20 枚 ✔；卡幣 0、跳出 0；沒聽到硬幣擦到前臂的聲音 |
| T4 兩枚相貼 | 每站測該站最難分的幣，共 3 輪：5 元 S5、10 元 S10、50 元 S50。每輪 5 對（放法見上）：`g3` `d0` → `k幣別` → `c10` → 放 5 對 → `e` | 每輪計數都是 10（每對都算成 2 枚）；報告寫「分得出來」 |
| T5 最薄 5 元慢推 | 輸入 `k5`、打開 `p`，用指尖扶著 5 元沿軌道慢慢推過光束（大約 2 秒推過去），做 10 次 | 每次都觸發，而且剛好 +1，共 10。如果 `p` 顯示某一次有好幾個脈衝，要記下來 |
| T6 軌道條 | 全部測完後，從前面和後面看兩片軌道條；直尺立在軌道上，拿一張影印紙（約 0.1 mm）試著塞進窗那一段的直尺下面 | 沒裂、沒翹、兩片沒分開；影印紙塞不進去（軌道沒有往下凹） |
| T7 換墊片比較 | 從塞得進去的最高那片開始，每次換低一片，共試 3～4 片。每片都做：50 元 S50 線 × 20 枚（`c20`）、50 元相貼 5 對（`c10`，放法同 T4）、5 元慢推 5 次。每換一片：重新撐好 PCB 另一端、量水平（6-3 第 7、9 步），重量光束高，再用 `b` 改設定。用 50 元 S50，是因為它是正式機會遇到的情況裡，兩枚之間亮區最短的；時間夠可以加做 10 元 S10（第二難分）。1 元 S50 是選做的加嚴測試（1 元在正式機不經過這三站），過不了也不算原型失敗 | 每片的結果都記下來。「最佳光束高」＝全部過關、抖動最少，而且相貼那一輪報告裡「方法二 精確範圍」最寬的那片。**精確範圍、亮區最短、兩種方法的建議值都看相貼那一輪（`c10`）的報告**；抖動枚數看單枚那一輪（`c20`） |

### 紀錄表

**基本資料**

| 項目 | 填寫 |
|---|---|
| 日期 | |
| 模組型號／來源 | |
| 合板實際厚度 | |
| 擋住時輸出（開機判定 HIGH／LOW） | |
| 光束對準哪個光孔（離窗右邊 3.7／10.0／16.3） | |
| T1～T6 用的墊片／量到的光束高 | |
| 每輪 `c` 之前輸入的即時計數設定（例如 `g3`／`d0`） | |

**T1、T2、T5、T6**

| 項目 | 結果 | 過關？ | 備註 |
|---|---|---|---|
| T1 閒置穩定 | | | |
| T2 擋住會變（應 +10） | | | |
| T5 5 元慢推（應 10 次各 +1） | | | |
| T6 軌道條 | | | |

**T3 單枚計數**（每格放 20 枚）

| 線 | 幣 | 計數 /20 | 卡幣 | 跳出 | 遮光 ms 最短／中位／最長 | 速度中位 m/s | 抖動枚數 | 備註 |
|---|---|---|---|---|---|---|---|---|
| S5 | 5 元 | | | | | | | |
| S5 | 10 元 | | | | | | | |
| S5 | 50 元 | | | | | | | |
| S10 | 10 元 | | | | | | | |
| S10 | 50 元 | | | | | | | |
| S50 | 50 元 | | | | | | | |

**T4 兩枚相貼**（每格 5 對）

| 站 | 幣 | 計數 /10 | 兩枚之間亮區最短 ms | 開始到開始最短 ms | 備註 |
|---|---|---|---|---|---|
| S5 | 5 元 | | | | |
| S10 | 10 元 | | | | |
| S50 | 50 元 | | | | S50 相貼從左端放 |

**T7 換墊片比較**（「相貼輪」＝50 元相貼那一輪 `c10` 的報告；「單枚輪」＝50 元 × 20 那一輪 `c20` 的報告）

| 墊片 | 光束高（量） | 50 元 S50 /20 | 50 元相貼 /10 | 亮區最短 ms（相貼輪） | 5 元慢推 /5 | 抖動枚數（單枚輪） | 方法二 精確範圍 ms（相貼輪） | 方法二 建議 ms（相貼輪） | 方法一 建議 ms（相貼輪） |
|---|---|---|---|---|---|---|---|---|---|
| | | | | | | | | | |
| | | | | | | | | | |
| | | | | | | | | | |
| | | | | | | | | | |

---

## 8. 測完要回報給 Claude 的東西

- **模組實量值**：2-2 表格的每一項，加上「順便記下來」的項目、型號或商品連結、照片。
- **合板的實際厚度。**
- **光束對準哪個光孔**（離窗右邊 3.7、10.0 或 16.3），有沒有塞紙板把模組往左推、塞多厚。
- **墊片**：塞得進去的最高那片、最後選用的那片、PCB 另一端用了哪片加幾張名片，以及每一片量到的光束高。
- **測試報告**：每一輪的報告文字檔，裡面有遮光時間範圍、速度、兩枚之間亮區最短、抖動、兩種方法的建議值。至少也要給填好的紀錄表。
- **建議的計數設定**：報告「★ 結論」那幾行，也就是方法二的重新上膛 ms、方法一的前緣 DEBOUNCE ms。
- **遇到的問題**：
  - 卡幣、跳出：哪種幣、哪條線、在哪個位置。
  - 有沒有擦到前臂。
  - 軌道條有沒有裂開或變形。
  - 裝模組時卡在哪一步。
  - 附上照片或短影片。

這些數字會回填到 v2：模組尺寸填進 `laser_v2/params.py` 的 `MODULE`，光束高填進 `BEAM_H`，另外也會用來設定正式程式的計數。改 v2 之前，Claude 會先跟你確認。
