kingofamani/CoinSorting/03_v2_光耦版/laser_v2/驗證筆記/S1規格核對_2026-10-07.md

# verify-spec-s1：s1wall_final/spec.md 逐項核對草稿 SVG（2026-10-07）

> 2026-10-12 整理資料夾時從 `laser_v2/_work/verify-spec-s1/notes.md` 保留下來（report.md「實量後改哪裡」有引用）。
> 文中提到的檢查腳本都在 `_work`，已經刪除；這份只保留結論。結論是 back_h＝1.5 時的數字，之後已改成 2.0。

方法：直接用 regex＋svgpathtools 解析 `分幣機雷切_光耦版_v2_草稿.svg` 的零件群組（不讀產生器報告、不呼叫 mods_s1）。
原始/修改零件（#13R、#21、#26、#37、#24）用「沒被改的孔」對 catalog 原始頁座標做 Procrustes（殘差 <1e-12，無鏡像）求排版矩陣，
再用 frames 換組裝座標；新零件用 D4（4 旋轉×鏡像）對規格局部外形求擺法，反算局部座標，再用規格 b-0 的局部→組裝式子放回組裝座標。
文字方向用 fontTools 讀 msjh.ttc 自己畫參考輪廓，逐輪廓形心做相似變換（比較鏡像/不鏡像殘差）。

腳本（都在本資料夾，唯讀）：
- `svgparse.py`：解析與對位工具
- `check13.py`：#13R（b-2）
- `check2637.py`：#21、#26、#37（b-3～b-5）
- `checknew.py`：S1-B/C/H/F/P/K 外形、孔、雕刻、qty、所在板（c）
- `checktext.py`：所有 S1 雕刻文字的鏡像、基線/字頭方向、字高、中心
- `checkfit.py`：卡匣互配、#37 窗/#26 槽/牆槽/S1-F 槽餘隙、#13R 與 #37 板厚帶干涉、細料

執行：`cd C:/ClaudeProject/分幣機 && .venv/Scripts/python.exe -B laser_v2/_work/verify-spec-s1/<腳本>`

## 量測結果（容許 0.05）

### #13R（b-2）
- 輸出外形 vs「原 #13 ∪ 加高 0～29×30～76.2 ∪ F1/F2/B1 − 牆槽 11.8～30×57.5～76.9 − 角落讓位 29～32.2×77～84」（自己布林）：對稱差 0.049 mm²（弧線取樣）、Hausdorff 0.004。
- 各特徵角點都是輸出頂點（≤0.004）；牆槽內無料；讓位區內無料（0.0002 mm²）。
- 面積 4059.39（規格 4059.4）；局部 bbox x−38.974～84.274、y−17.726～52.226（規格一致）。單一外形；3 個 #12 槽 Hausdorff ≤0.0001。
- 上段（V30～57.5）面積 797.5＋F1 14.3＋B1 36 = 847.8（規格 848）；前料條 11.8。
- #13R ∩ #37 實料（W'29～32）體積 0.0013 mm³（≈0），讓位修好。
- 雕刻「13R 右」字高 4.000，advance 中心 (W'15.000, V40.008)；「S1 卡匣」字高 3.000，(15.000, 46.002)。基線 +W'、字頭 −V、不鏡像。
- 小觀察：原 #13 後緣在 W'28.993（不是 29.0），讓位左緣 W'29.0，在 V83.40～84.0 留 0.007 的台階（0.004 mm²），可忽略。
- 我的取樣器在 #13R 外框起點出現 1e-12 的重複點，shapely 判 invalid；去掉重複點後 Valid（不是檔案問題）。

### #21（b-3）
- 外形與原始一致（對稱差 0.047 mm²，弧線取樣）。「21 左」字高 4.000，advance 中心 (W'12.000, V79.957)，基線 +W'、字頭 −V、不鏡像，全在實料內。

### #26（b-4）
- F1 U104.725～108.025×V50.35～56.15、F2 ×V67.85～74.65、C U101.725～105.025×V58.85～65.15：邊界誤差 ≤0.0001，都是矩形。
- 槽間料 F1↔C、F2↔C 2.700；離外框 ≥23.35；F1 上緣在軌道下 1.099。
- 離 #24 孔：F1 1.033、F2 0.041（菱形孔，不重疊）、C 0.807（規格 1.03／0.04／0.81）。
- 離 #26 其他孔：F1 6.086（1 元開口）、F2 6.576、C 11.223（後兩者是 crosstrack 新加的 S5 階梯窗；規格 10.38／12.64 是沒有 S5 窗時的值，仍 ≥2.5）。
- 齒孔 path131[19] 已修正到 U104.899～107.849 × V84.025～87.975。

### #37（b-5）
- 窗頂點與規格完全一致，只有 106.675 → 107.175（back_h=1.5）；面積 370.92（名目 371.5，差 0.60 mm² 全在 back_h 段）；對 back_h 修正後外形 Hausdorff 0。
- 窗到外框 3.4475（R2 處）；B1 U104.725～108.025×V35.85～48.15（誤差 0）；B1 離窗 6.05。
- M3 孔 Ø3.400（外接寬）中心 (96.575,56.2)、(96.575,73.5)，誤差 0；離窗 3.300。
- 離非 S1 孔最近 8.35（電子盒感測器線孔 U88～100×V40～46；規格 16.28 是沒有電子盒孔時的值）。
- 雕刻「S1 卡匣」字高 4.000、外面、基線 +U（從背面看左→右）、字頭 −V、不鏡像；advance 中心 (U116.83, V46.50)，規格 (U115, V46.5)，偏 +1.83（產生器用 B1 槽右緣＋2.0 起排；若照規格置中，字左緣離 B1 槽只剩約 0.43）。字底 V48.25 在背蓋上緣 V50.7 之上。

### 新零件（c）
| 零件 | 板 | 份數 | 擺法 | 對規格局部對稱差 | 面積 | 備註 |
|---|---|---|---|---|---|---|
| S1-B | 合板2（同 #13R） | 1 | rot270 | 0 | 189.50 | 讓位孔 (2,3)～(13.7,17)；「S1-B」字高 2 在後榫中心 (19.70,3.02) |
| S1-C | 合板1 | 1 | rot90 | 0 | 731.04 | 黏貼框只雕 (6,3.2)→(22.7,3.2)→(22.7,22.2)→(6,22.2)（其餘段和外框重合，正確）；「S1-C 前→」字高 2.5，advance 中心 (28.55,15.52)，規格 (27.0,15.5) |
| S1-H | 合板1 | 3 | rot0/270/90 | 0 | 15.75 | 不雕 |
| S1-F | 合板3 | 1 | rot90 | 0.069（Ø3.4 圓的多邊形段數不同） | 690.98 | 對名目差 3.8 mm² 全在 x15.1～15.6×y19.7～27.3（back_h）；孔 (5.0,5.5)、(5.0,22.8) Ø3.400；「S1 ↑」字高 4，advance 中心 (28.30,7.53)，規格 (28.4,7.3)；「S1-F」字高 2.5 |
| S1-P | 合板1 | 1 | rot0 | 0 | 43.56 | 「S1-P」字高 2 |
| S1-K | — | 0 | — | — | — | comp_band_free=False，正確 |
- 全部無鏡像；所有文字不鏡像、基線 +局部 x、字頭 −局部 y（S1-C 的 → 指向 −W'＝前；S1-F 的 ↑ 指向 −V＝上）。
- 圖層：#13R/#21/#26/#37 在「v2 修改」，S1-* 在「v2 新增」；切割黑 0.2、雕刻紅。所有 S1 相關切割路徑閉合、不自交。
- 試切小樣裡的 S1-B/C/H/F/P 與規格局部完全相同（無鏡像），TB-#13R 與草稿 #13R 的 W'−2.6～32×V30～83.5 截取面積 1284.979 vs 1284.980。

### 配合（checkfit.py）
- S1-B 在牆槽：V 上 0.200、下 0.200（槽底 V76.9 vs 76.7）、前端 0.500；和 #13R 實料重疊 0。
- 後榫（S1-B＋S1-C 並排 U101.875～107.875×V57.7～63.7，W'29～35）→ S1-F 槽：U 小側 0.150、V 兩側 0.150；U 大側併入 PCB 缺口；和 S1-F 實料重疊 0。榫尾齊 S1-F 外面 W'35。
- 通過 #37 窗：S1-B 0.300；S1-C U 小側／上／下 0.300，U 大側 0（與牆面 U104.875 共面，規格就是這樣設計）；PCB＋泡棉、元件帶、本體＋臂、導流帽 0.400；焊點（back_h 1.5）0.200；S1-P 0.100（下緣到後臂頂 0.4、左緣到元件頂 0.4）。
- 前榫：#13R F1／F2 → #26 0.150（長 2.6）；S1-C 尖榫 → 槽 C：U 0.150，V 在 #26 板內 0.33（尖榫收窄），伸入 #26 2.0，尖端寬 4.0；S1-C 前緣 W'0.6；B1 → #37 0.150，長 3.0。
- S1-F 孔對 #37 M3 孔：中心差 0、Ø3.4；S1-F 上緣到 B1 槽尾 2.55；下緣 V78.0 到 #13R 在 #37 後方的櫃頂邊 V79.933 → 1.933。
- 插好後窗在滑道側剩的縫 77.74 mm²（規格 77.7，不計泡棉）。
- 細料（開運算 2.0）：S1-F、S1-B、S1-C、#26／#37 S1 附近都沒有 <2.0 的料；#13R 只有兩處 0.05 mm² 在原檔底部（W'37,V150；W'65,V134），不是 S1 改的。
- S1-F 最細料實際是 2.8（下孔 V73.5 Ø3.4 到下緣 V78），規格寫 3.3（指孔到左緣）；規格與輸出一致，≥2.0。

## 觀察（列為 finding 的）
1. 前臂焊腳讓位（規格層級，視實品）：S1-B 讓位孔只到 V74.7；前臂投影 W'12.3～19.3×V70.8～77.2 共 44.8 mm²，其中 S1-B 實料 21.8、讓位孔 19.5、#13R 牆 2.1。
   PCB 背面焊點凸出 back_h − s_pcb＝0.5（params）／1.0（規格名目）進牆面。規格說「S1-B 下緣縮 1.0 讓焊腳」，但牆槽底在 V76.9，
   V76.7～77.7 這條帶（W'12.3～29）有 13.36/16.7 mm² 是 #13R 牆實料，只剩 0.2 是空的。典型槽型光耦每臂 2 腳、跨臂寬 2.54 間距（約 V72.7、V75.3），
   V75.3 那腳的焊點會壓到 S1-B 下料條；PCB 局部被頂高 0.5～1.0 → 槽底 U113.475 可能變成 113.975～114.475（準則 6：<114.104）。
2. S1-C 通過 #37 窗時 +U 側 0 餘隙（V54.5～57.4、V77.0～78.5 兩段，和牆面共面）；#13R 相對 #37 只靠 B1 槽 ±0.15 定位，往 +U 偏時 S1-C 會頂 #37 窗角。
3. 兩處雕刻位置和規格不同：#37「S1 卡匣」中心 U116.83（規格 U115，+1.83）；S1-C「S1-C 前→」中心 x28.55（規格 27.0，+1.55）。
   都是產生器刻意避讓（規格位置會讓 #37 字左緣離 B1 槽 0.43、S1-C 字壓到 S1-B 黏貼框 x22.7），功能不受影響，建議回寫規格。
