kingofamani/CoinSorting/01_原始機構/分幣機雷切原始檔_零件編號圖.png

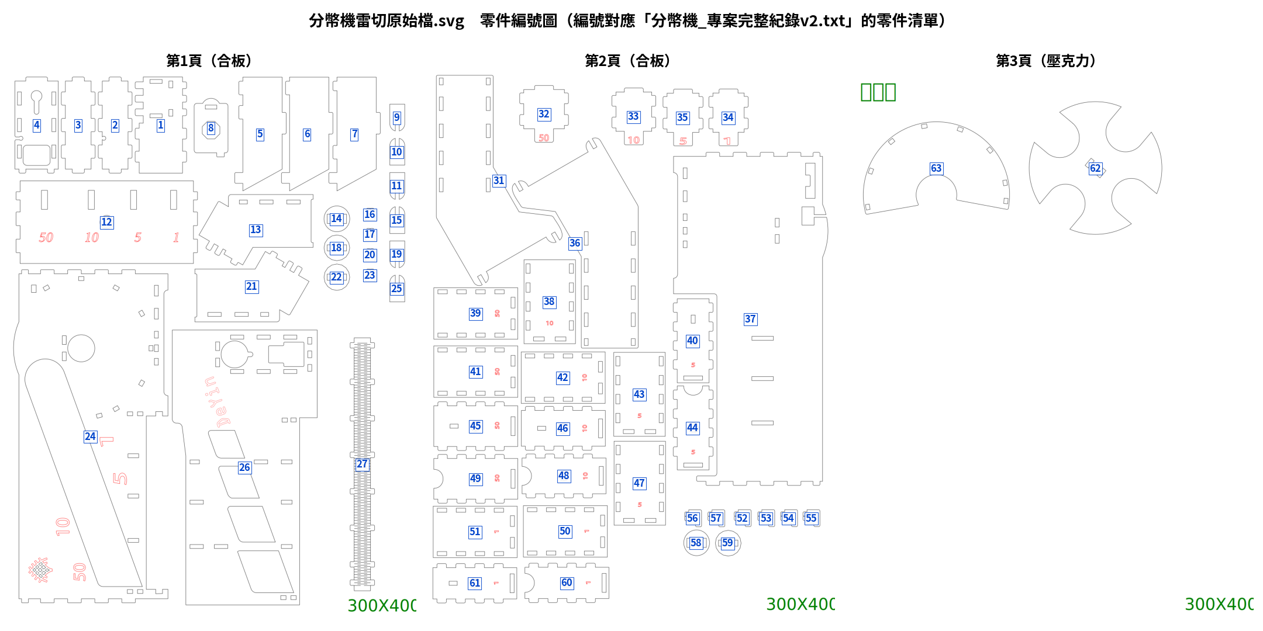
01_原始機構/分幣機雷切原始檔_零件編號圖.png
