kingofamani/CoinSorting/01_原始機構/組裝完成圖/IMG_20260921_151443.jpg

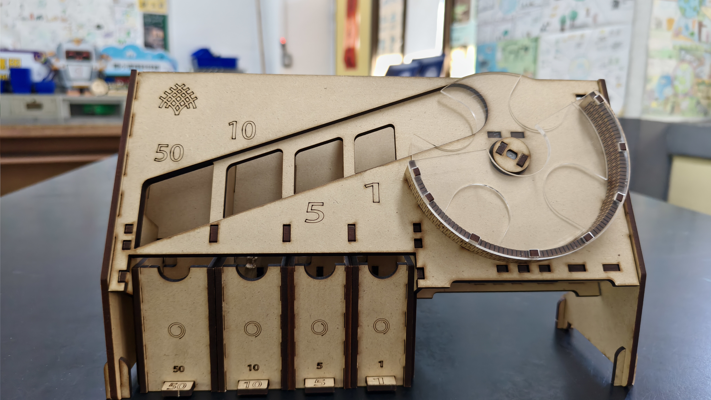
01_原始機構/組裝完成圖/IMG_20260921_151443.jpg
