kingofamani/CoinSorting/02_v1_紅外線版/ESP32版/分幣機_ESP32_接線圖.png

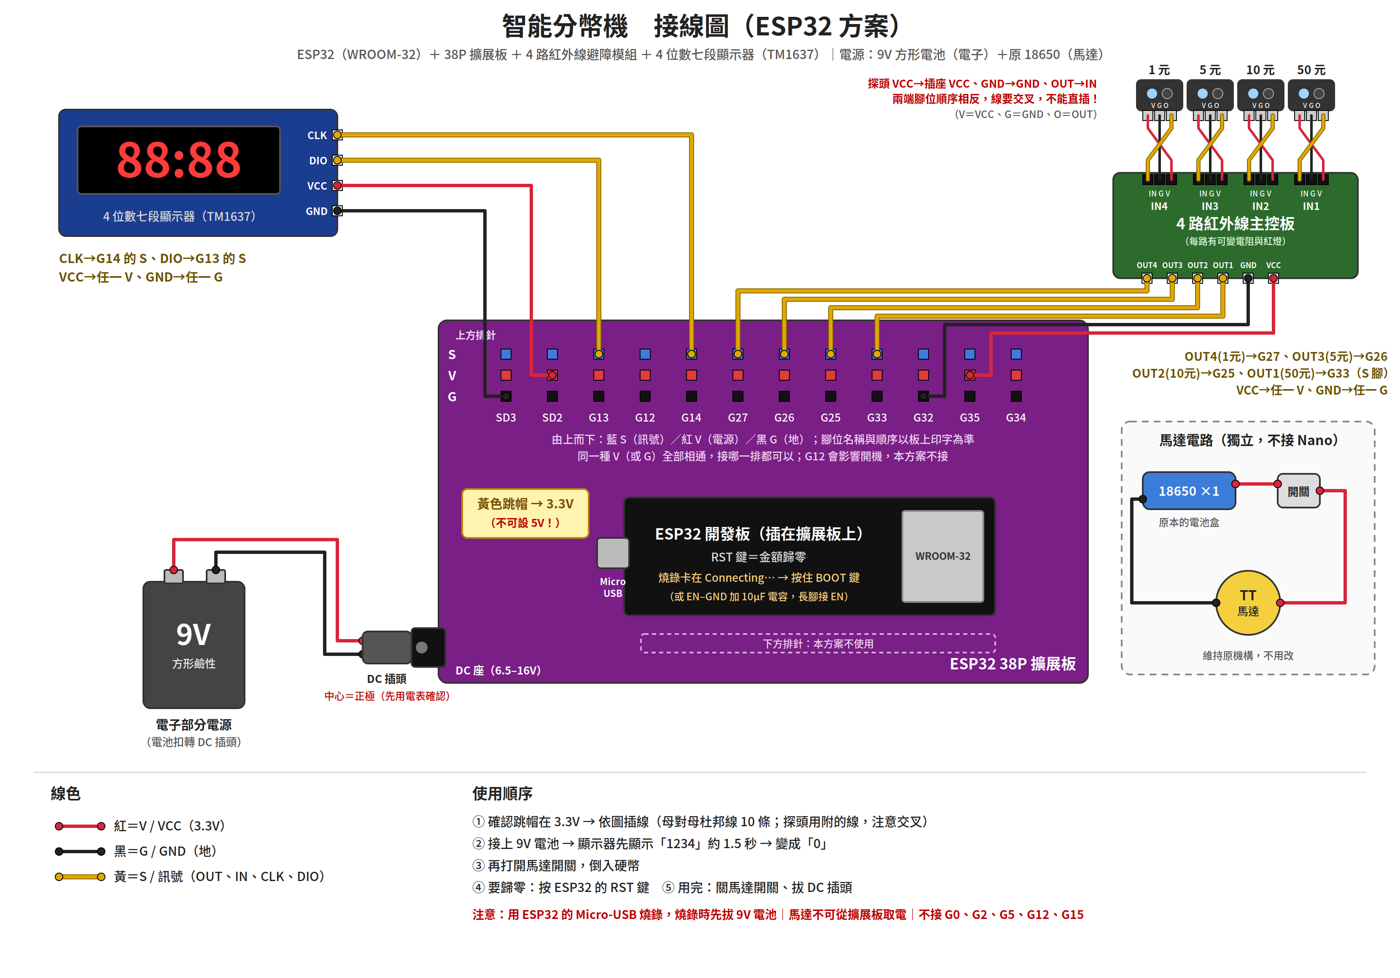
02_v1_紅外線版/ESP32版/分幣機_ESP32_接線圖.png
