kingofamani/CoinSorting/02_v1_紅外線版/Nano版/分幣機_接線圖.png

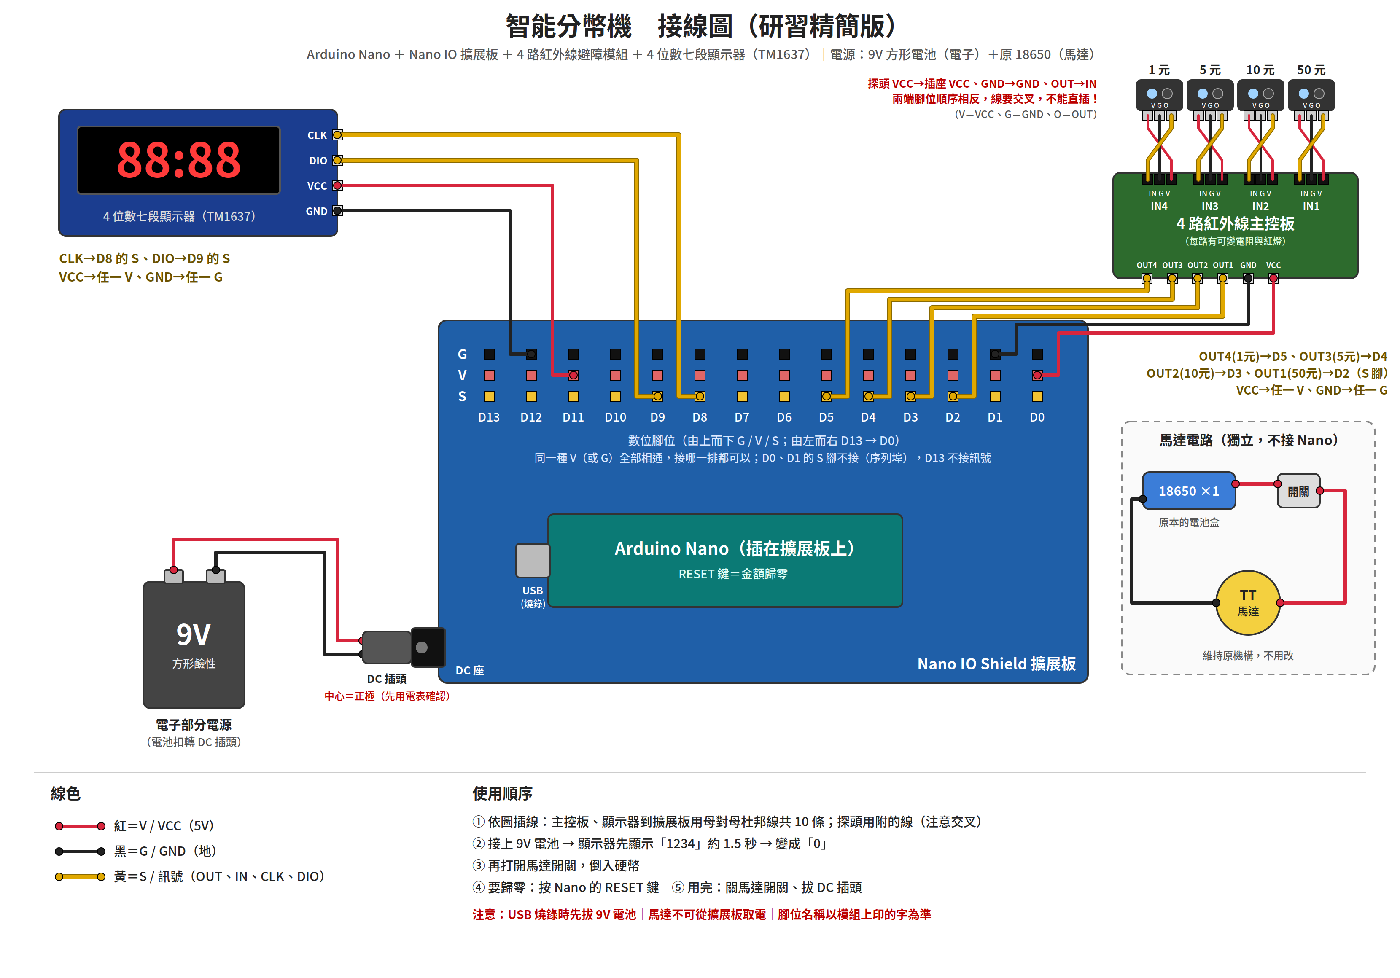
02_v1_紅外線版/Nano版/分幣機_接線圖.png
