kingofamani/CoinSorting/03_v2_光耦版/laser_v2/design/crosstrack_final/fig_section.png

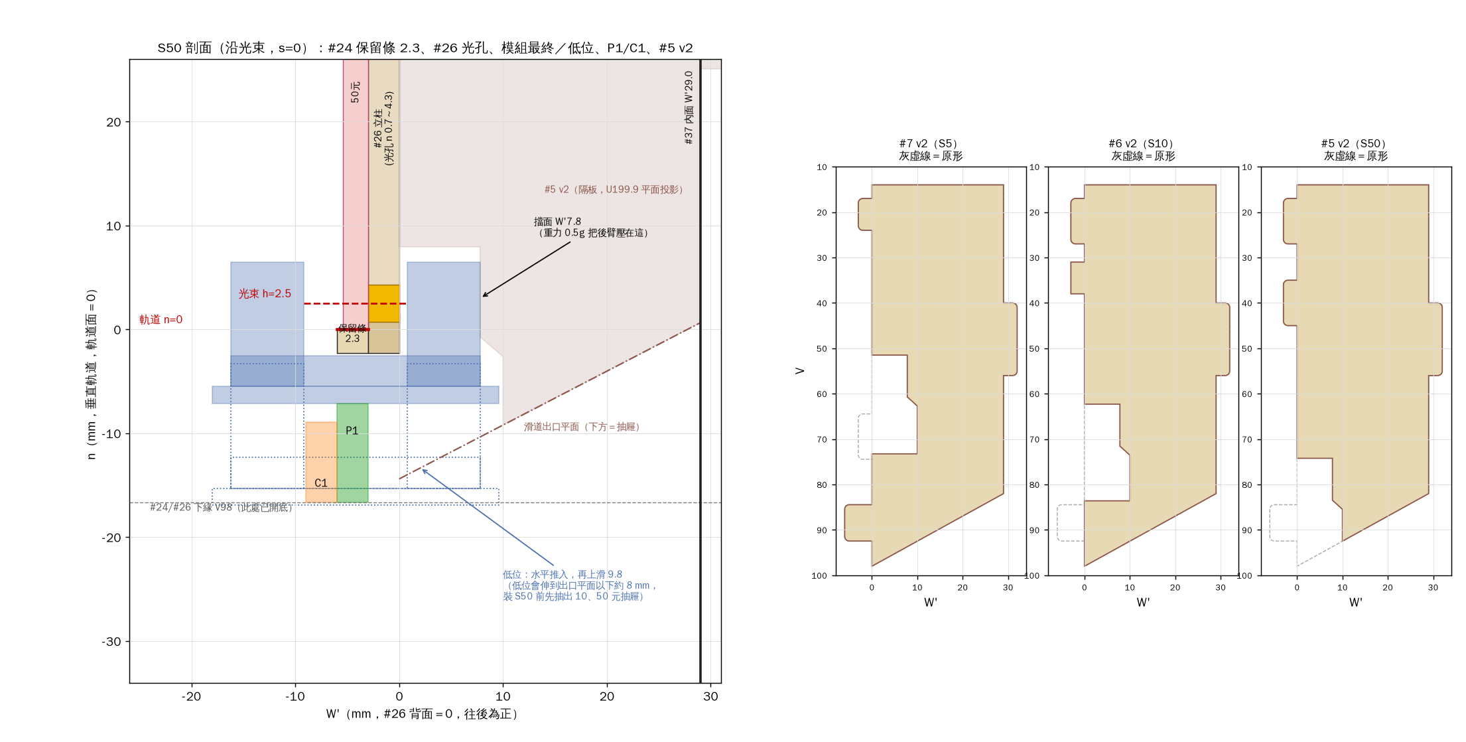
03_v2_光耦版/laser_v2/design/crosstrack_final/fig_section.png
