kingofamani/CoinSorting/03_v2_光耦版/laser_v2/design/ramp_dimensions.png

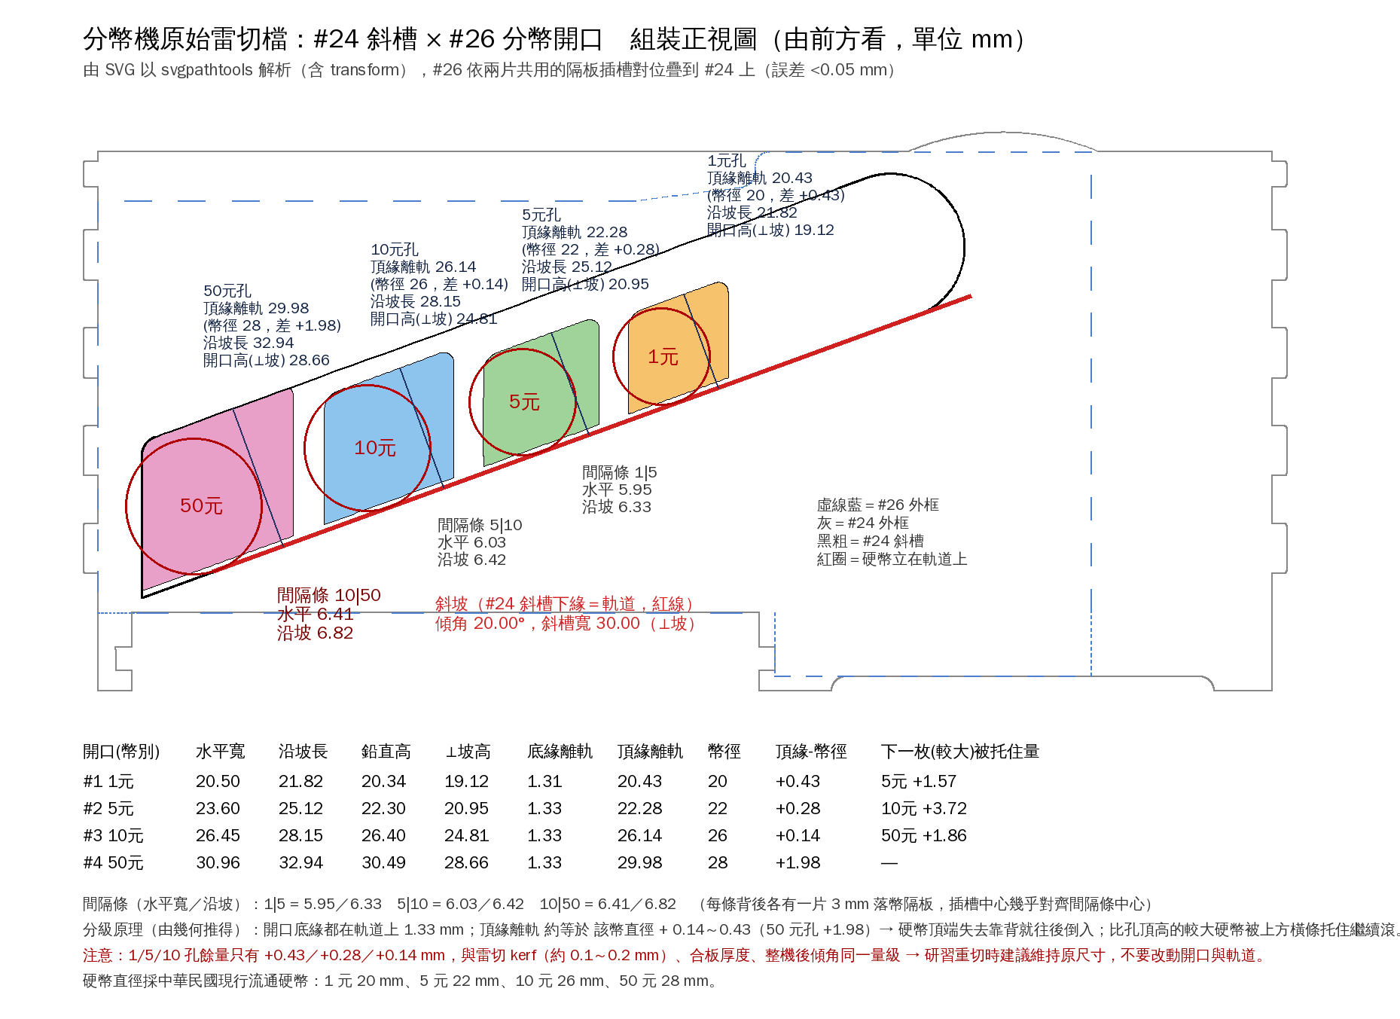
03_v2_光耦版/laser_v2/design/ramp_dimensions.png
