kingofamani/CoinSorting/03_v2_光耦版/laser_v2/out/sheet_合板_2.png

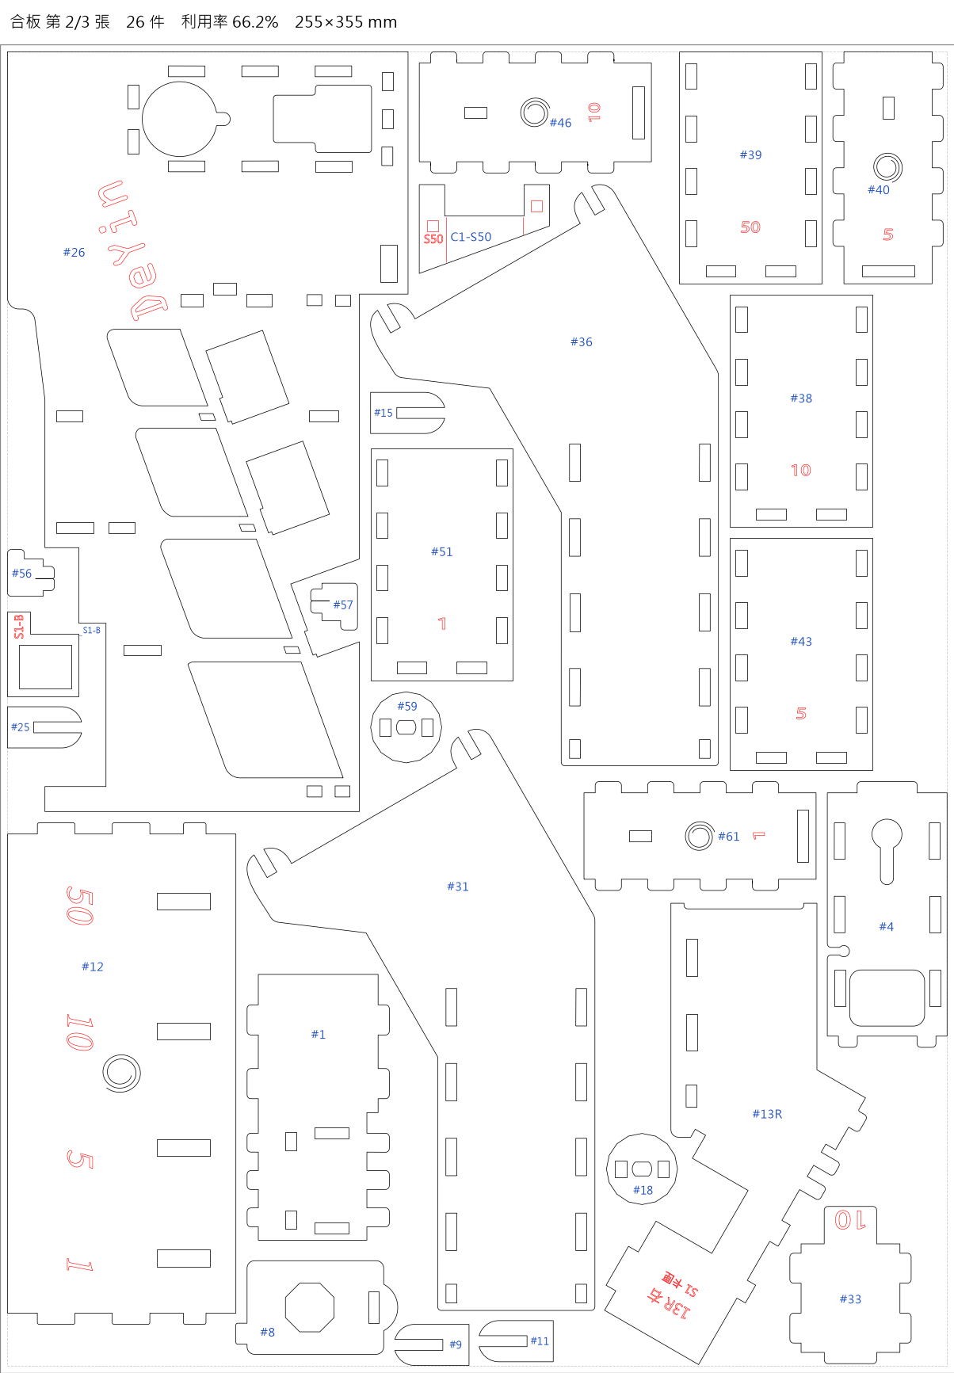
03_v2_光耦版/laser_v2/out/sheet_合板_2.png
