kingofamani/CoinSorting/03_v2_光耦版/接線圖/分幣機_v2光耦版_ESP32_接線圖.png

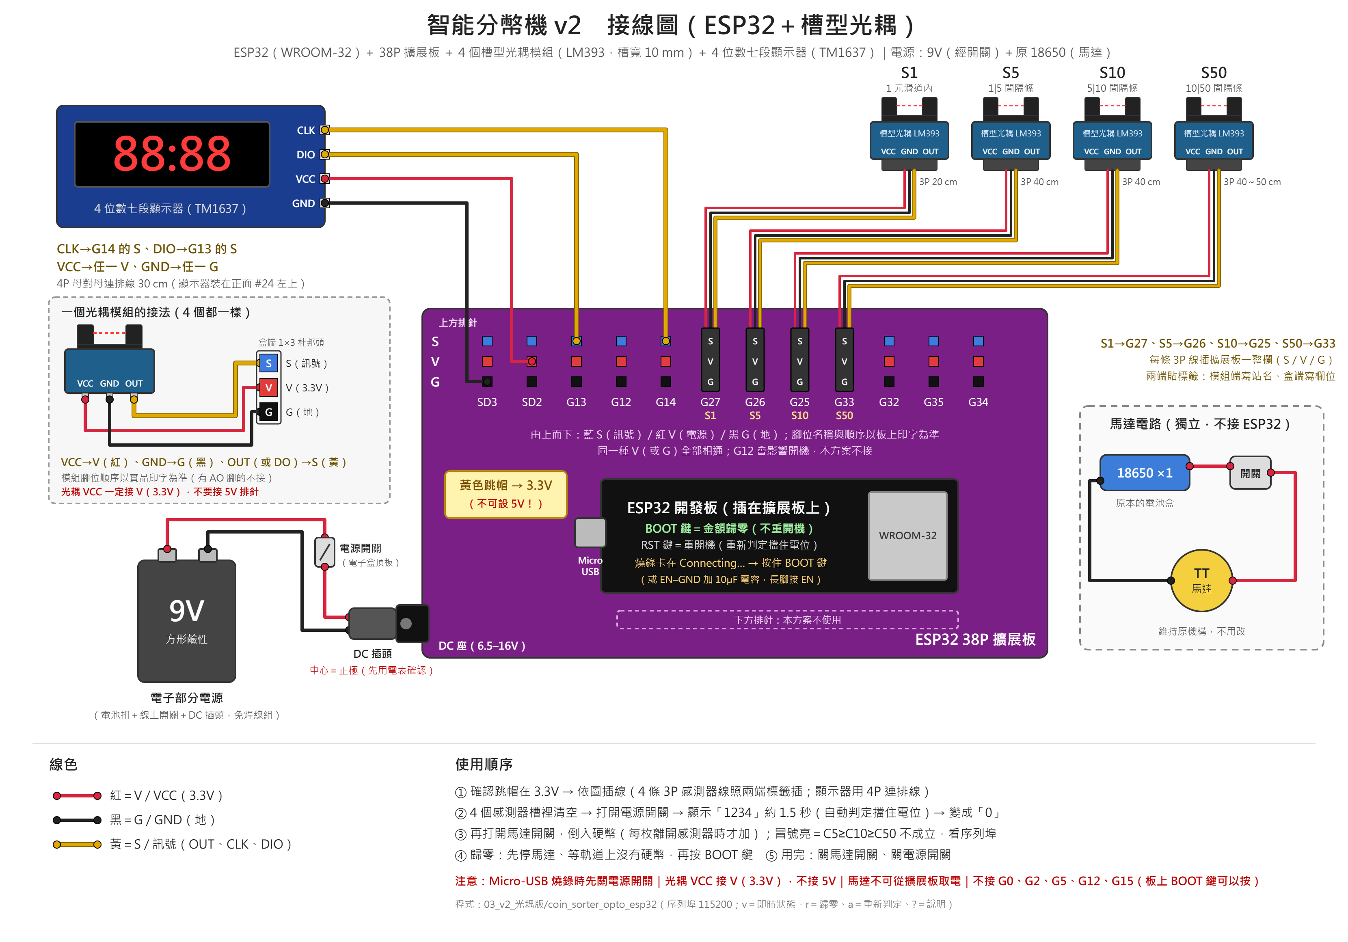
03_v2_光耦版/接線圖/分幣機_v2光耦版_ESP32_接線圖.png
