kingofamani/CoinSorting/03_v2_光耦版/組裝教學/img/b-rotor-flat.png

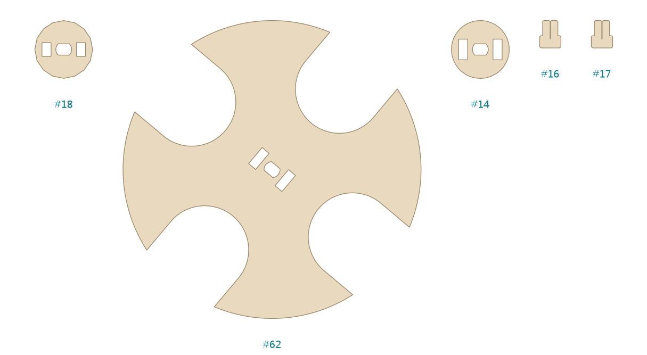
03_v2_光耦版/組裝教學/img/b-rotor-flat.png
