kingofamani/CoinSorting/03_v2_光耦版/組裝教學/img/s-v2-flat.png

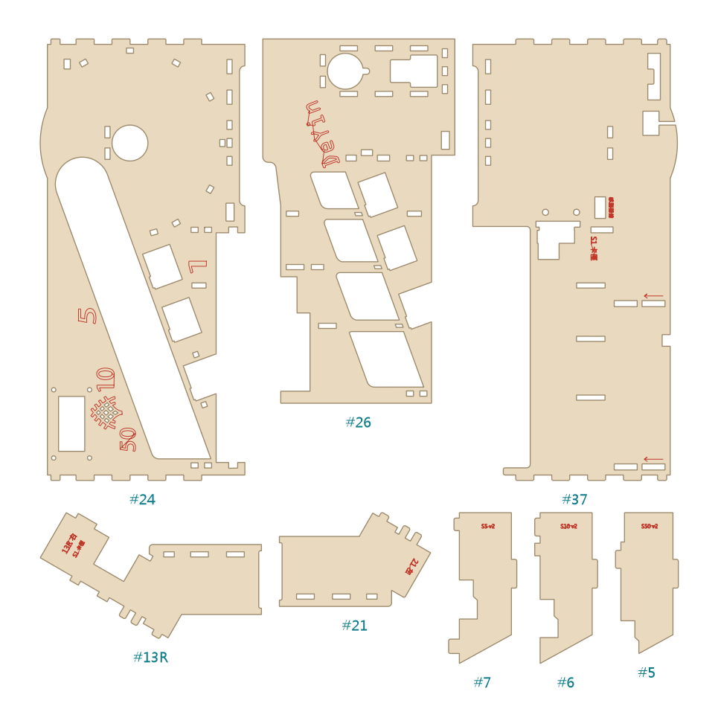
03_v2_光耦版/組裝教學/img/s-v2-flat.png
