kingofamani/CoinSorting/04_光耦測試原型/接線圖/光耦測試原型_ESP32_接線圖.png

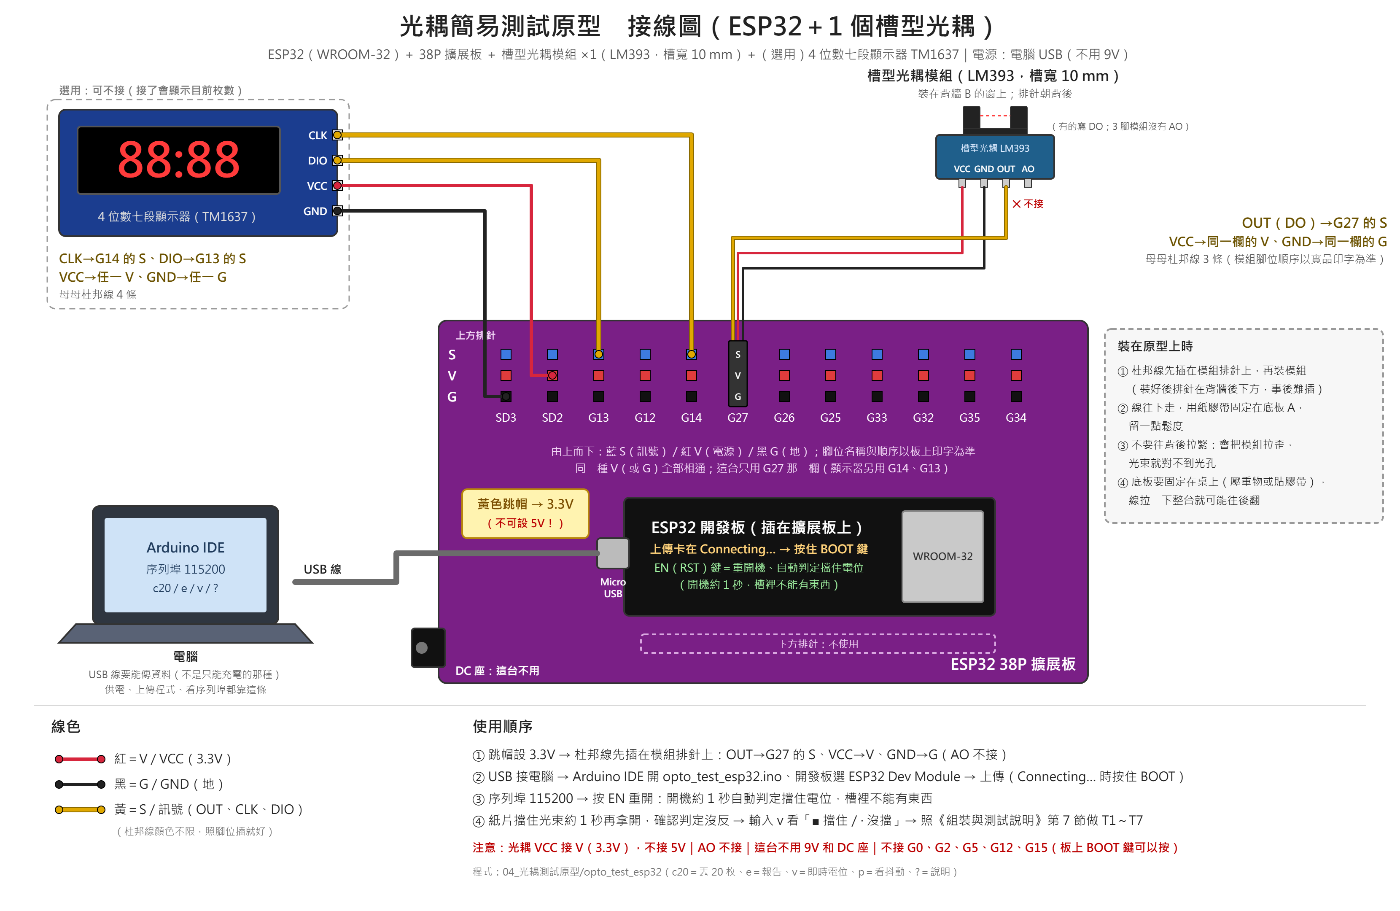
04_光耦測試原型/接線圖/光耦測試原型_ESP32_接線圖.png
