kingofamani/CoinSorting/04_光耦測試原型/示意圖.png

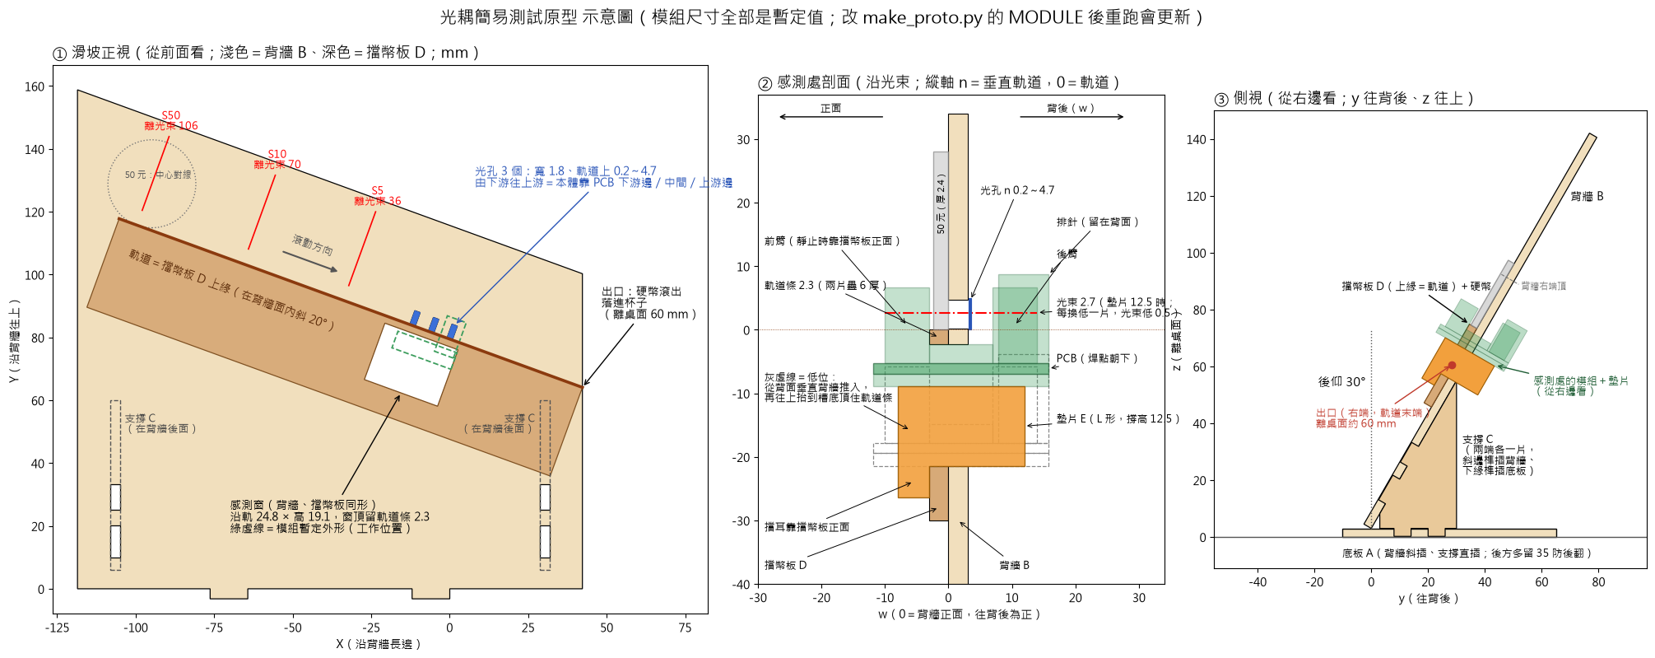
04_光耦測試原型/示意圖.png
