kingofamani/CoinSorting/04_光耦測試原型/組裝教學/img/align.png

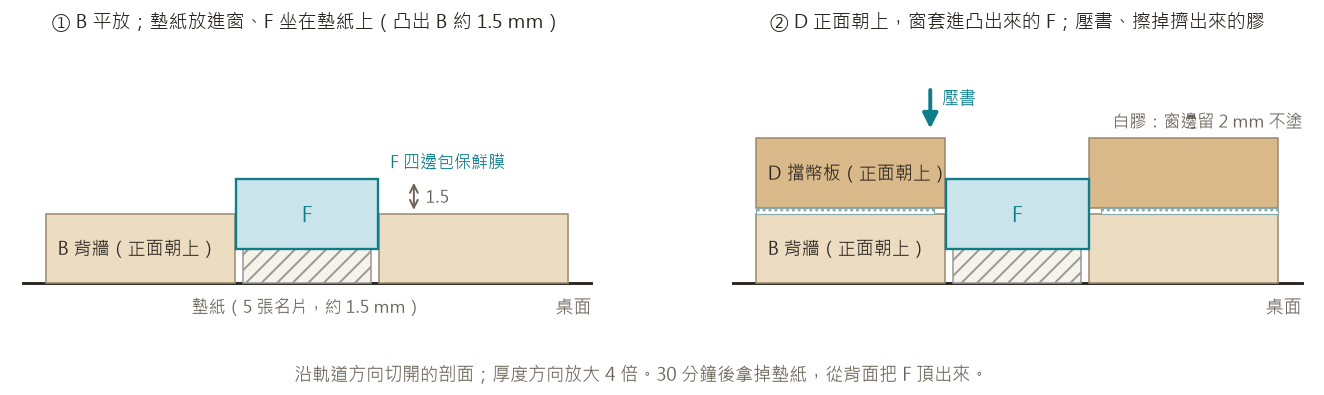
04_光耦測試原型/組裝教學/img/align.png
