kingofamani/CoinSorting/04_光耦測試原型/預覽.png

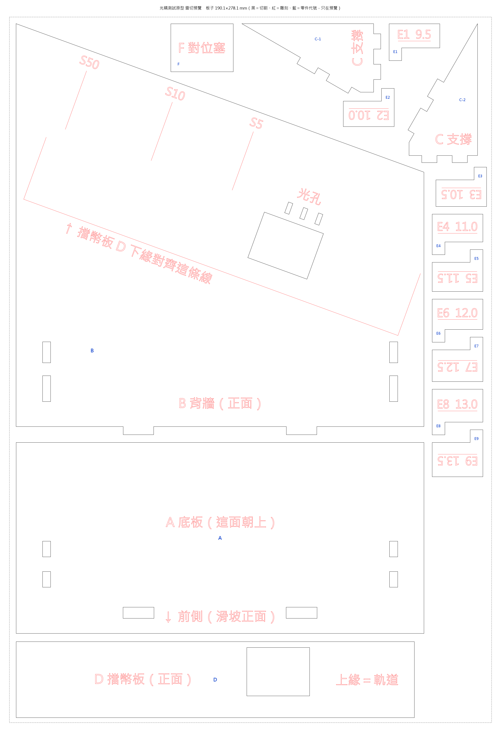
04_光耦測試原型/預覽.png
