kingofamani/CoinSorting/04_光耦測試原型/零件表.csv

代號 | 名稱 | 數量 | 尺寸(mm) | 用途
A | 底板 | 1 | 160.8×75.3（3 合板） | 放桌上；2 個斜插槽（12.2×4.40，背牆 30° 斜插）＋4 個支撐槽
B | 背牆 | 1 | 160.8×162.0（含下緣榫） | 後仰 30°（相當於正式機 #26）；感測窗 24.8×19.1、光孔 3 個 1.8×4.5；正面雕放幣線 S5/S10/S50 與擋幣板下緣對位線
C | 支撐 | 2 | 27.4×54.8（含榫） | 30° 支撐，放兩端；斜邊 2 榫插背牆、下緣 2 榫插底板
D | 擋幣板 | 1 | 157.0×30.0 | 白膠黏在背牆正面框內；上緣＝軌道（斜 20°）；同形感測窗，窗頂留軌道條 2.3
E1 | 墊片 9.5 | 1 | 20.0×14.5（撐高 9.5） | 雕「E1 9.5」；從前方塞到 PCB 下面、擋耳靠擋幣板正面（本體正下方一片，PCB 另一端再撐一片）；暫定尺寸時光束約 -0.3，低於軌道可用高（光窗會被擋幣板上緣擋到；模組比暫定大時用）
E2 | 墊片 10.0 | 1 | 20.0×15.0（撐高 10.0） | 雕「E2 10.0」；從前方塞到 PCB 下面、擋耳靠擋幣板正面（本體正下方一片，PCB 另一端再撐一片）；暫定尺寸時光束約 0.2，低於軌道可用高（光窗會被擋幣板上緣擋到；模組比暫定大時用）
E3 | 墊片 10.5 | 1 | 20.0×15.5（撐高 10.5） | 雕「E3 10.5」；從前方塞到 PCB 下面、擋耳靠擋幣板正面（本體正下方一片，PCB 另一端再撐一片）；暫定尺寸時光束離軌道約 0.7
E4 | 墊片 11.0 | 1 | 20.0×16.0（撐高 11.0） | 雕「E4 11.0」；從前方塞到 PCB 下面、擋耳靠擋幣板正面（本體正下方一片，PCB 另一端再撐一片）；暫定尺寸時光束離軌道約 1.2
E5 | 墊片 11.5 | 1 | 20.0×16.5（撐高 11.5） | 雕「E5 11.5」；從前方塞到 PCB 下面、擋耳靠擋幣板正面（本體正下方一片，PCB 另一端再撐一片）；暫定尺寸時光束離軌道約 1.7
E6 | 墊片 12.0 | 1 | 20.0×17.0（撐高 12.0） | 雕「E6 12.0」；從前方塞到 PCB 下面、擋耳靠擋幣板正面（本體正下方一片，PCB 另一端再撐一片）；暫定尺寸時光束離軌道約 2.2
E7 | 墊片 12.5 | 1 | 20.0×17.5（撐高 12.5） | 雕「E7 12.5」；從前方塞到 PCB 下面、擋耳靠擋幣板正面（本體正下方一片，PCB 另一端再撐一片）；暫定尺寸時光束離軌道約 2.7（暫定尺寸時：模組頂到軌道條）
E8 | 墊片 13.0 | 1 | 20.0×18.0（撐高 13.0） | 雕「E8 13.0」；從前方塞到 PCB 下面、擋耳靠擋幣板正面（本體正下方一片，PCB 另一端再撐一片）；暫定尺寸時塞不進（模組比暫定小時用）
E9 | 墊片 13.5 | 1 | 20.0×18.5（撐高 13.5） | 雕「E9 13.5」；從前方塞到 PCB 下面、擋耳靠擋幣板正面（本體正下方一片，PCB 另一端再撐一片）；暫定尺寸時塞不進（模組比暫定小時用）
F | 對位塞 | 1 | 24.6×18.9 | 黏擋幣板時對齊兩片的窗：背牆正面朝上平放，窗裡的桌面上先墊約 1.5 mm 厚、比窗小的東西（例如 5 張名片剪成約 22×16），F 包一層保鮮膜後放進背牆的窗、坐在上面，凸出約 1.5，擋幣板的窗套上去；不要用硬幣墊（四種硬幣都比窗的短邊大，會把背牆墊高）；窗挖下來的那塊也可以代替 F
— | 槽型 LM393 光耦模組 | 1 | 自備（暫定槽寬 10） | 跨裝在感測窗；收到後實量，改 MODULE 重跑；槽寬小於 6.5 的不能用
— | ESP32 開發板＋擴展板 | 1 | 自備 | 擴展板 G27 那一排要有 S／V／G；黃色跳帽設 3.3V
— | 母母杜邦線 | 3 | 自備 | 光耦 OUT／VCC／GND 接到擴展板 G27 那一排的 S／V／G；先插在模組上再裝模組
— | USB 傳輸線 | 1 | 自備 | 要能傳資料（不是只能充電的線）；上傳程式、看序列埠
— | TM1637 四位數顯示器（可不接） | 1 | 自備 | 再加 4 條母母杜邦線：CLK→G14、DIO→G13、VCC→V、GND→G
— | 白膠 | 適量 | — | 全部用白膠，不用螺絲
— | 杯子或碗 | 1 | 杯口低於約 52 mm | 放在右端外側接滾出的硬幣（不用做）
