kingofamani/CoinSorting/03_v2_光耦版/laser_v2/out/parts.csv

代號 | 名稱 | 材質 | 每套數量 | 備品 | 尺寸(mm) | 所在板 | 備品所在板 | layer | tags
#1 | #1 | 合板 | 1 | 0 | 38.0×71.0 | 合板2 |  | original
#2 | #2 | 合板 | 1 | 0 | 25.0×71.0 | 合板3 |  | original
#3 | #3 | 合板 | 1 | 0 | 25.0×71.0 | 合板3 |  | original
#4 | #4 | 合板 | 1 | 0 | 32.0×71.0 | 合板2 |  | original
#5 | 10|50 間隔條 | 合板 | 1 | 0 | 35.0×78.5 | 合板3 |  | modified | S50 隔板缺口（擋面＋導角＋深段），直通斜底邊；#5 雕刻「S50 v2」；TM1637 背面零件讓位（前上角，連帶刪上小榫）
#6 | 5|10 間隔條 | 合板 | 1 | 0 | 35.0×84.0 | 合板3 |  | modified | S10 隔板缺口（擋面＋導角＋深段）；#6 v2 上方小榫（取代長榫，插 #26 新槽）；#6 雕刻「S10 v2」
#7 | 1|5 間隔條 | 合板 | 1 | 0 | 38.0×84.0 | 合板3 |  | modified | S5 隔板缺口（擋面＋導角＋深段）；#7 雕刻「S5 v2」
#8 | #8 | 合板 | 1 | 0 | 25.0×43.2 | 合板2 |  | original
#9 | #9 | 合板 | 1 | 0 | 11.0×19.8 | 合板2 |  | original
#10 | #10 | 合板 | 1 | 0 | 11.0×19.8 | 合板1 |  | original
#11 | #11 | 合板 | 1 | 0 | 11.0×19.8 | 合板2 |  | original
#12 | 抽屜櫃後板（世界鉛直） | 合板 | 1 | 0 | 134.0×61.0 | 合板2 |  | original
#13R | 抽屜櫃側板（右，1 元滑道右牆位置） | 合板 | 1 | 0 | 123.2×69.9 | 合板2 |  | modified | S1 #13R 加高成 1 元滑道右牆（W'0～29 × V30～76.2）＋前榫 F1（插 #26；W'-2.6～0 × V50.5～56）、前榫 F2（插 #26；W'-2.6～0 × V68～74.5）、後榫 B1（插 #37；W'29～32 × V36～48）；S1 #13R 牆槽（開向 #37，S1-B 由背面插入；W'11.8～30 × V57.5～76.9）；S1 #13R 角落讓位（修 #37 開口 R2 內角干涉；W'29～32.2 × V77～84）；S1 #13R 雕刻「13R 右」（上面，朝空腔）；S1 #13R 雕刻「S1 卡匣」（上面，朝空腔）
#14 | #14 | 合板 | 1 | 0 | 19.0×19.0 | 合板1 |  | original
#15 | #15 | 合板 | 1 | 0 | 11.0×19.8 | 合板2 |  | original
#16 | #16 | 合板 | 1 | 0 | 7.0×9.0 | 合板1 |  | original
#17 | #17 | 合板 | 1 | 0 | 7.0×9.0 | 合板1 |  | original
#18 | #18 | 合板 | 1 | 0 | 19.0×19.0 | 合板2 |  | original
#19 | #19 | 合板 | 1 | 0 | 11.0×19.8 | 合板1 |  | original
#20 | #20 | 合板 | 1 | 0 | 7.0×9.0 | 合板1 |  | original
#21 | 抽屜櫃側板（左） | 合板 | 1 | 0 | 84.3×52.2 | 合板1 |  | modified | S1 #21 雕刻「21 左」（防裝反；上面，朝 50 元滑道）
#22 | #22 | 合板 | 1 | 0 | 19.0×19.5 | 合板1 |  | original
#23 | #23 | 合板 | 1 | 0 | 7.0×9.0 | 合板1 |  | original
#24 | 前面板 | 合板 | 1 | 0 | 114.0×246.0 | 合板1 |  | modified | S5 階梯窗；S10 階梯窗；S50 開底缺口（階梯形）；S50 插銷孔（上游）；S50 插銷孔（下游）；感測器排線孔（右下）；刪孔：#6 長榫已刪；刪孔：#5 長榫已刪（S50 缺口直通下緣）；雕刻「5」搬移 ΔU+0 ΔV-52.5；雕刻「1」搬移 ΔU+0 ΔV+19；TM1637 顯示窗（LED 塊每邊 +0.3）；TM1637 M2 固定孔 1；TM1637 M2 固定孔 2；TM1637 M2 固定孔 3；TM1637 M2 固定孔 4；Logo 移位（L2）：菱形孔；Logo 移位（L2）：雕刻
#25 | #25 | 合板 | 1 | 0 | 11.0×19.8 | 合板2 |  | original
#26 | 內牆（分幣開口） | 合板 | 1 | 0 | 107.0×203.0 | 合板2 |  | modified | 修正 #26 右側第 1 個齒孔（原始檔偏 ΔV+1.000、ΔU+0.134；frames.fix_26_tooth_hole）；S5 階梯窗；S5 光孔（平行四邊形）；S10 階梯窗；S10 光孔（平行四邊形）；S50 開底缺口（階梯形）；S50 光孔（平行四邊形）；#6 新小榫槽；感測器排線孔（右下）；刪孔：#7 中段小榫已刪（落在 S5 窗與隔板缺口內）；刪孔：#6 長榫已刪；刪孔：#5 長榫已刪（S50 缺口直通下緣）；S1 #26 槽 F1（#13R 前榫 F1；U104.725～108.025 × V50.35～56.15）；S1 #26 槽 F2（#13R 前榫 F2；U104.725～108.025 × V67.85～74.65）；S1 #26 槽 C（S1-C 前榫；U101.725～105.025 × V58.85～65.15）；TM1637 頂邊 L 形缺口（PCB、M2 螺帽、彎針、杜邦頭、上升線）
#27 | #27 | 合板 | 1 | 0 | 18.0×186.8 | 合板1 |  | original
#31 | 右端板（腳架） | 合板 | 1 | 0 | 92.9×155.3 | 合板2 |  | original
#32 | #32 | 合板 | 1 | 0 | 36.0×42.0 | 合板1 |  | original
#33 | #33 | 合板 | 1 | 0 | 32.4×42.0 | 合板2 |  | original
#34 | #34 | 合板 | 1 | 0 | 29.1×42.0 | 合板3 |  | original
#35 | #35 | 合板 | 1 | 0 | 29.6×42.0 | 合板3 |  | original
#36 | 左端板（腳架） | 合板 | 1 | 0 | 92.9×155.3 | 合板2 |  | original
#37 | 後面板 | 合板 | 1 | 0 | 114.0×246.0 | 合板1 |  | modified | S1 #37 卡匣窗（U101.575～122.875 × V54.2～78.8，371.5 mm²）；S1 #37 槽 B1（#13R 後榫；U104.725～108.025 × V35.85～48.15）；S1 #37 M3 孔 Ø3.4（中心 U96.575 V56.2；空腔側預黏螺帽）；S1 #37 M3 孔 Ø3.4（中心 U96.575 V73.5；空腔側預黏螺帽）；S1 #37 雕刻「S1 卡匣」（外面，背蓋上緣之上）；電子盒掛勾槽 1（左牆上層）；電子盒掛勾槽 2（左牆下層）；電子盒掛勾槽 3（右牆上層）；電子盒掛勾槽 4（右牆下層）；顯示器線頂邊 U 形缺口；感測器線孔（S5/S10/S50 線由右側空腔穿到背面）；電子盒掛勾槽旁箭頭（左牆；盒子推到底後往下滑，選用雕刻）；電子盒掛勾槽旁箭頭（右牆；盒子推到底後往下滑，選用雕刻）；感測器線孔標示（選用雕刻；從機身背面看是正的）
#38 | #38 | 合板 | 1 | 0 | 38.0×62.0 | 合板2 |  | original
#39 | #39 | 合板 | 1 | 0 | 62.0×38.0 | 合板2 |  | original
#40 | #40 | 合板 | 1 | 0 | 29.4×62.0 | 合板2 |  | original
#41 | #41 | 合板 | 1 | 0 | 62.0×38.0 | 合板3 |  | original
#42 | #42 | 合板 | 1 | 0 | 62.0×38.0 | 合板3 |  | original
#43 | #43 | 合板 | 1 | 0 | 38.0×62.0 | 合板2 |  | original
#44 | #44 | 合板 | 1 | 0 | 29.4×62.0 | 合板3 |  | original
#45 | #45 | 合板 | 1 | 0 | 62.0×36.0 | 合板3 |  | original
#46 | #46 | 合板 | 1 | 0 | 62.0×32.4 | 合板2 |  | original
#47 | #47 | 合板 | 1 | 0 | 38.0×62.0 | 合板3 |  | original
#48 | #48 | 合板 | 1 | 0 | 62.0×32.4 | 合板3 |  | original
#49 | #49 | 合板 | 1 | 0 | 62.0×36.0 | 合板3 |  | original
#50 | #50 | 合板 | 1 | 0 | 62.0×38.0 | 合板3 |  | original
#51 | #51 | 合板 | 1 | 0 | 62.0×38.0 | 合板2 |  | original
#52 | #52 | 合板 | 1 | 0 | 12.5×12.5 | 合板1 |  | original
#53 | #53 | 合板 | 1 | 0 | 12.5×12.5 | 合板1 |  | original
#54 | #54 | 合板 | 1 | 0 | 12.5×12.5 | 合板1 |  | original
#55 | #55 | 合板 | 1 | 0 | 12.5×12.5 | 合板1 |  | original
#56 | #56 | 合板 | 1 | 0 | 12.5×12.5 | 合板2 |  | original
#57 | #57 | 合板 | 1 | 0 | 12.5×12.5 | 合板2 |  | original
#58 | #58 | 合板 | 1 | 0 | 19.0×19.0 | 合板1 |  | original
#59 | #59 | 合板 | 1 | 0 | 19.0×19.0 | 合板2 |  | original
#60 | #60 | 合板 | 1 | 0 | 62.0×29.1 | 合板3 |  | original
#61 | #61 | 合板 | 1 | 0 | 62.0×29.1 | 合板2 |  | original
#62 | #62 | 壓克力 | 1 | 0 | 98.0×98.0 | 壓克力1 |  | original
#63 | #63 | 壓克力 | 1 | 0 | 108.0×68.3 | 壓克力1 |  | original
C1-S5 | S5 蓋板 C1（雕刻面＝貼 #24 的背面） | 合板 | 1 | 0 | 26.8×12.9 | 合板1 |  | new
C1-S10 | S10 蓋板 C1（雕刻面＝貼 #24 的背面） | 合板 | 1 | 0 | 26.8×12.9 | 合板1 |  | new
C1-S50 | S50 蓋板 C1（雕刻面＝貼 #24 的背面） | 合板 | 1 | 0 | 34.8×23.7 | 合板2 |  | new
EB-B | 電子盒主板底板 | 合板 | 1 | 0 | 94.0×55.5 | 合板1 |  | new
EB-E | 電子盒電池端擋 | 合板 | 1 | 0 | 35.8×16.8 | 合板1 |  | new
EB-F | 電子盒電池架 | 合板 | 1 | 0 | 64.2×32.8 | 合板1 |  | new
EB-K | 電子盒防拔鍵（選用） | 合板 | 2 | 2 | 6.5×8.3 | 合板1×2 | 合板1×2 | new
EB-S | 電子盒電池後擋 | 合板 | 1 | 0 | 67.2×13.8 | 合板1 |  | new
EB-T | 電子盒頂板（電源開關） | 合板 | 1 | 0 | 94.0×20.0 | 合板1 |  | new
EB-WL | 電子盒左牆（兩層掛勾、排線口） | 合板 | 1 | 0 | 45.0×72.2 | 合板1 |  | new
EB-WR | 電子盒右牆（兩層掛勾、服務窗、DC 線口） | 合板 | 1 | 0 | 45.0×72.2 | 合板1 |  | new
P1-S5 | S5 鎖塊 P1（黏在 C1 雕刻外框內，頂住凸塊在上緣、對齊 C1 下緣 ▲ 記號那一端） | 合板 | 1 | 0 | 20.6×12.2 | 合板1 |  | new
P1-S10 | S10 鎖塊 P1（黏在 C1 雕刻外框內，頂住凸塊在上緣、對齊 C1 下緣 ▲ 記號那一端） | 合板 | 1 | 0 | 20.6×12.2 | 合板1 |  | new
P1-S50 | S50 鎖塊 P1（黏在 C1 雕刻外框內，頂住凸塊在上緣） | 合板 | 1 | 0 | 20.6×15.0 | 合板1 |  | new
PIN-S50 | S50 插銷（黏在 C1 雕刻方塊上） | 合板 | 2 | 2 | 3.0×3.0 | 合板1×2 | 合板1×2 | new
S1-B | S1 座塊（嵌 #13R 牆槽；雕刻面朝 S1-C，和 #13R 同板） | 合板 | 1 | 0 | 22.7×19.0 | 合板2 |  | new
S1-C | S1 座板（空腔側貼牆；雕刻面朝牆／S1-B，紅框是 S1-B 黏貼位置） | 合板 | 1 | 0 | 37.0×24.0 | 合板1 |  | new
S1-F | S1 背蓋（貼 #37 外面，2 支 M3 尼龍螺絲；雕刻面朝外） | 合板 | 1 | 0 | 35.3×27.3 | 合板3 |  | new
S1-H | S1 導流帽（三角片 ×3，疊黏在前臂頂面；不雕刻） | 合板 | 3 | 3 | 7.0×4.5 | 合板1×3 | 合板1×3 | new
S1-P | S1 帽通道填塊（黏在背蓋前面；雕刻面朝背蓋） | 合板 | 1 | 1 | 9.9×4.4 | 合板1 | 合板1 | new
