kingofamani/CoinSorting/03_v2_光耦版/laser_v2/design/s1wall_final/fig3_parts.png

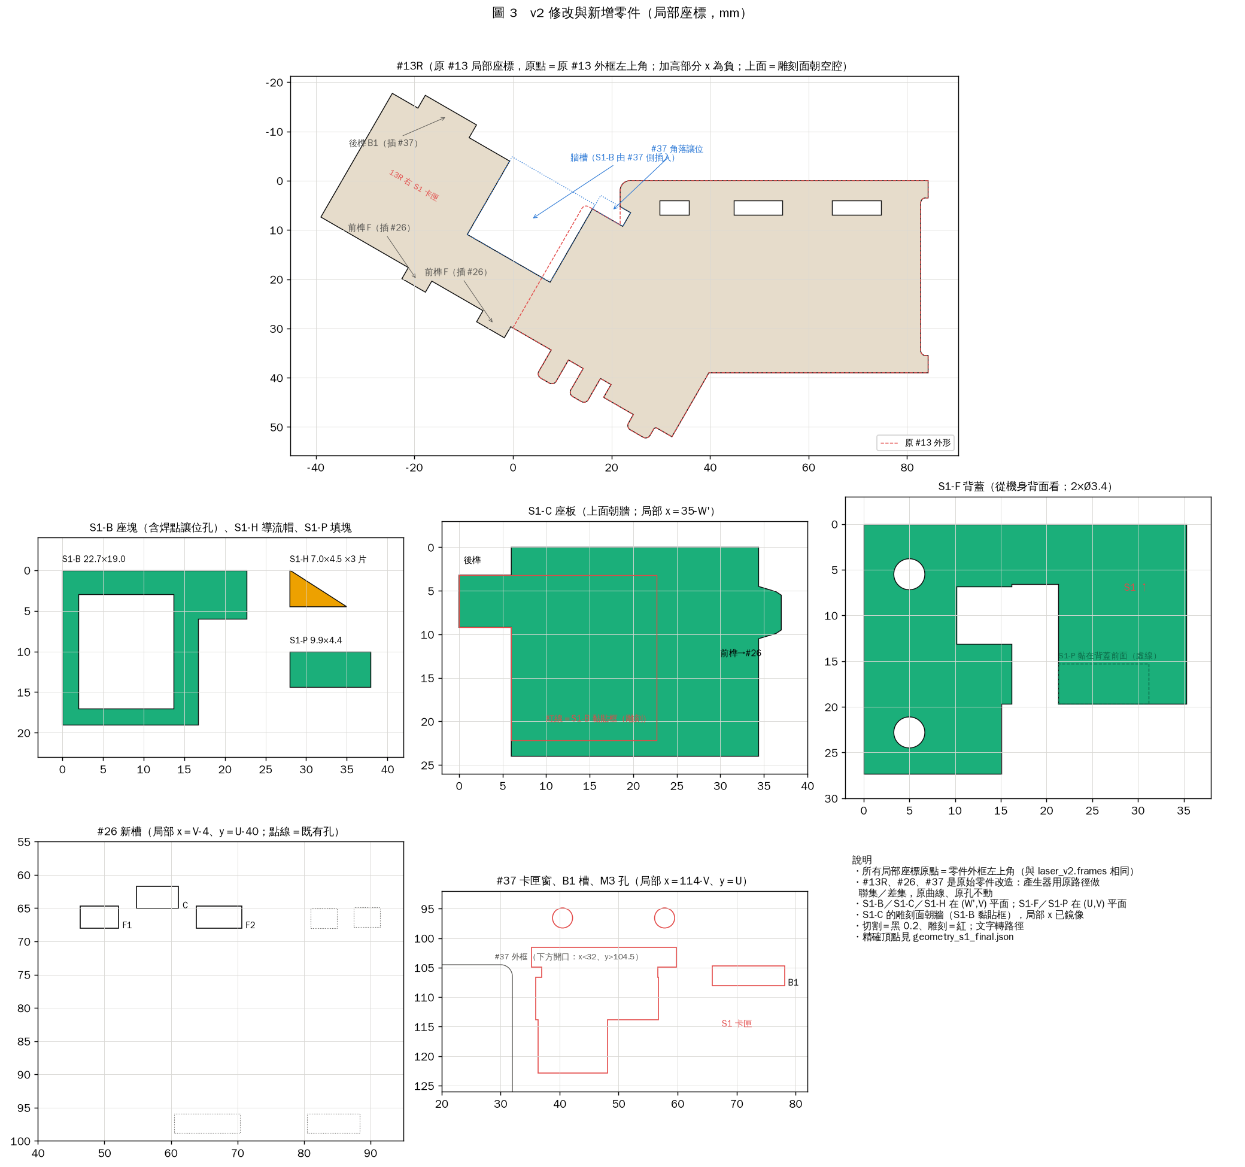
03_v2_光耦版/laser_v2/design/s1wall_final/fig3_parts.png
