kingofamani/CoinSorting/03_v2_光耦版/laser_v2/params.py

"""v2 雷切檔的共用參數。

槽型光耦模組、TM1637、ESP32 擴展板買到實品量完後，只要改這個檔再重跑
（先進到 03_v2_光耦版 資料夾）../.venv/Scripts/python.exe -B -m laser_v2.build_v2，就會重新產生 v2 雷切檔與試切小樣
（約 95 秒）。量什麼、改哪個鍵、重切哪一塊小樣，見 laser_v2/out/report.md「實量後改哪裡」。

build_v2 一開始會檢查這個檔（必要鍵、要填數字、正值、合理範圍，例如 MODULE 的 slot_w 6～15、
wing 只能 'up'／'down'／'center'、LOGO_PLAN 只能 'L1'／'L2'）；填錯會用中文說明哪個鍵、現在的值、
合理範圍，結束碼 3，什麼都不產生（範圍表在 build_v2.py 的 PARAM_RULES／DICT_RULES）。

標「暫定」的數字是網路同類品規格或估計值，還沒有用實品量過。
各子系統（跨軌感測座、S1 卡匣、電子盒）自己的設計參數放在各自的模組裡，
但模組尺寸一律從這裡讀。
"""

# ---------------------------------------------------------------------------
# 板材與雷切機
# ---------------------------------------------------------------------------
T_PLY = 3.0            # 合板厚（使用者量：3 mm）
T_ACRYLIC = 3.0        # 壓克力厚
SHEET = (255.0, 355.0)  # 每張板的可切範圍（使用者：板 300×400，建議不超過 255×355）
SHEET_MARGIN = 2.0     # 零件離頁邊的最小距離
PART_GAP = 2.0         # 零件之間的最小距離
KERF_COMP = 0.0        # 不做切縫補償（原始檔也沒有；分幣開口餘量只有 0.14 mm，不可改）

# 餘隙（單邊）
C_TAB = 0.1            # 一般榫槽
C_SENSOR = 0.4         # 光耦相關開孔
C_HOOK = 0.2           # 電子盒掛勾槽

# ---------------------------------------------------------------------------
# 槽型 LM393 光耦模組（暫定：10 mm 槽寬版，全部待實量）
# 方向約定：「沿光束」＝兩臂之間的方向；「寬」＝垂直光束、平行 PCB。
# ---------------------------------------------------------------------------
MODULE = dict(
    slot_w=10.0,    # 槽寬：兩臂內面距
    slot_d=9.0,     # 槽深：臂頂到槽底
    beam_sb=5.0,    # 光束中心離槽底
    arm_t=7.0,      # 單臂沿光束厚
    arm_w=6.4,      # 臂寬（也當作光耦本體寬）
    arm_top=12.0,   # 臂頂離 PCB 元件面
    pcb_L=27.6,     # PCB 沿光束長
    pcb_W=20.0,     # PCB 寬
    pcb_t=1.6,      # PCB 厚
    body_e=0.5,     # 光耦本體側邊到 PCB 長邊的距離（本體靠 PCB 一條長邊）
    wing='up',      # 跨軌站 PCB 長邊（翼）朝哪邊：'up' 上游（往轉盤）／'down'／'center'
    comp_h=2.0,     # PCB 元件面最高零件
    back_h=2.0,     # PCB 背面焊點凸出（使用者 2026-10-08 決定：實量前用 S1 規格名目 2.0，較保守）
    hdr_up=14.0,    # 直立排針＋杜邦頭高度
    # 2026-10-07 整合時補（原本是各子系統檔裡的預設值，數值不變，實量後改這裡）
    hdr_len=8.0,    # 排針＋杜邦頭沿光束方向佔的長度（mods_crosstrack）
    pcb_ovf=0.0,    # PCB 前端（W' 小）超出前臂外面的量；本體置中時約 (pcb_L−24)/2（mods_s1）
    aperture=1.0,   # 光耦光窗寬（估計；光束餘量扣半寬，mods_s1）
)

# ---------------------------------------------------------------------------
# 其他電子零件（暫定）
# ---------------------------------------------------------------------------
TM1637 = dict(pcb_w=42.0, pcb_h=24.0, pcb_t=1.6, hole_d=2.2,   # 四位數七段顯示器
              # 2026-10-07 補（原本只在 ebox.DISP_DEFAULT，數值不變；ebox spec d-1 標「要量」，實量後改這裡）
              body_w=30.0, body_h=14.0, body_H=7.2,   # LED 塊寬（U）×高（V）×厚（從 PCB 正面往前凸出）
              body_dx=0.0, body_dy=0.0,               # LED 塊中心相對 PCB 中心（+dx 往觀看者右手、+dy 往下）
              back_h=2.6,                             # PCB 背面零件最高
              hole_dx=19.0, hole_dy=10.0,             # 固定孔「半距」：孔中心離 PCB 中心（實量孔距 38×20 → 填 19、10）
              use_screws=True,                        # True＝4 支 M2 螺絲（#24 切 M2 孔）；False＝熱熔膠（不切孔）
              hdr_mode='RA',                          # 'RA' 彎針朝觀看者右手；'STRAIGHT' 直針朝後
              dup_len=14.0, dup_gap=1.0, wire_bend=5.5)   # 杜邦頭長、排針到杜邦頭間隙、線折彎預留
ESP32_BOARD = dict(L=78.0, W=53.5,                             # 使用者量：擴展板 53.5×78
                   # 2026-10-07 補（原本只在 ebox.BOARD_DEFAULT，數值不變；ebox spec d-1 標「要量」）
                   t=1.6, standoff=4.8,                        # 擴展板厚、墊高（M3 尼龍螺帽）
                   hole_inset=3.0, hole_d=3.4,                 # 4 個 M3 孔中心離板邊（四孔相同）、孔徑
                   hdr_h=8.5,                                  # 擴展板母座高（開發板插在上面）
                   dev_len=55.0, dev_w=28.0,                   # ESP32 開發板長（U）×寬（V），置中
                   usb_inset=2.0, usb_V_off=26.75,             # USB 座離板右端、離擴展板上緣（服務窗跟著動）
                   btn_dv=8.5, dc_V_off=6.5)                   # EN/BOOT 鍵離 USB 中心（V）、DC 座離擴展板上緣
BATTERY_9V = dict(L=48.5, W=26.5, T=17.5)

# ---------------------------------------------------------------------------
# 設計選擇（2026-10-02 設計審查的預設值，使用者可改）
# ---------------------------------------------------------------------------
BEAM_H = 2.5           # 跨軌光束離軌道面（使用者原本說約 3 mm；設計審查建議 2.5）
LOGO_PLAN = 'L2'       # Logo 新位置：'L2' 顯示窗正下方／'L1' 「10」右邊
S1_WALL_TOP_V = 30.0   # #13R 右牆加高到 V30（V38 可省約 230 mm² 板材）
FIX_26_TOOTH_HOLE = True   # 修正 #26 右側第 1 個齒孔偏 1.0 mm 的原始檔問題

# ---------------------------------------------------------------------------
# 輸出
# ---------------------------------------------------------------------------
FONT_PATH = r'C:\Windows\Fonts\msjh.ttc'   # 雕刻文字轉路徑與預覽圖用的字型（微軟正黑體，使用者 2026-10-07 指定）
OUT_SVG = '分幣機雷切_光耦版_v2_草稿.svg'
STROKE_CUT = 'fill:none;stroke:#000000;stroke-width:0.2'
STROKE_ENGRAVE_COLOR = '#ff0000'
NOTE_COLOR = '#008000'
