kingofamani/CoinSorting/03_v2_光耦版/laser_v2/layout.py

"""v2 雷切排版：把零件排進 255×355 的板（合板、壓克力分開排）。

用法
----
    from laser_v2.layout import layout
    sheets = layout(parts)              # parts: list[V2Part]（compose.compose() 的結果）
    for s in sheets:
        s.material, s.no, s.w, s.h      # 材質、同材質內第幾張（1 起算）、板寬高 mm
        for pl in s.items:              # Placement
            pl.part, pl.copy, pl.M      # 零件、第幾份（0 起算）、3×3 矩陣（零件座標 → 板座標）
            pl.spare                    # 這一份是不是備品（copy ≥ qty）
            pl.rot                      # 轉了幾度（0/90/180/270）
            pl.geom                     # 排好後的 shapely 外形（板座標）
        s.util                          # 利用率＝零件淨面積（外框減孔）／板面積
        s.unplaced                      # 這個材質放不進現有板的備品（只記在該材質最後一張）
    unplaced_spares(sheets)             # 全部放不下的備品說明（空＝備品全部排進去了）

規則（params）
--------------
* 每張板 params.SHEET（255×355），零件離板邊 ≥ SHEET_MARGIN、零件之間 ≥ PART_GAP。
  間距是「真實外形」距離（shapely 外形，含曲線取樣），不是外接框。
* 合板、壓克力分開排（壓克力也用 255×355）；同一個 group 的零件排在同一張板；
  qty>1 的零件每一份各一個 Placement；零件只轉 0／90／180／270 度，不鏡像（雕刻面不能翻）。
* 備品（V2Part.spare，每套多切幾份；使用者 2026-10-08：極小零件每套多一整份）：正式的 qty 份
  照下面的演算法排完、張數定了以後，備品（copy＝qty … qty+spare−1）才逐件塞進「已經開的板」，
  先試同零件正式份所在的板，再依板序；不會為備品開新板（不增加張數）。放不下的不排，
  記在該材質最後一張的 Sheet.unplaced，用 unplaced_spares(sheets) 取出回報。
  備品不受 group 限制（只是替換用）。
* 彎曲條（#27 這種有很多開放鋸縫的零件）只轉 0／180 度，保持和原始檔相同的方向：
  原檔的彎曲條在直式 300×400 板上直放，鋸縫橫向；合板表層木紋通常沿板的長邊，
  這樣鋸縫和木紋垂直，轉 90 度會變成順紋，鋸縫之間的橋容易裂（假設板材木紋沿長邊）。

演算法
------
點陣＋FFT 相關運算的「上左靠齊」排法（bottom-left fill 的變形，SVG 座標 y 向下所以是往上靠）：
1. 每個零件（每種轉角）做一張「佔用點陣」：格寬 RES mm，格子中心落在
   外形.buffer(PART_GAP/2 + RES·√2/2 + 0.02) 裡就算佔用。
   兩個零件的點陣沒有共同格子 ⇒ 兩者外形距離 ≥ PART_GAP（保守，證明見 _footprint）。
   代價是實際間距多 0～0.7 mm（原始 60 件排出來最近 2.48 mm）。
2. 板子的佔用點陣和零件點陣做 FFT 相關運算（float32），一次得到所有平移位置的重疊格數；
   重疊 0、又在板邊界內（≥ SHEET_MARGIN，用真實外形的外接框算）的位置就是可放的位置。
   選中的位置再用逐格相乘核對一次，確定真的不重疊（不靠 FFT 的浮點誤差）。
3. 大件先排（first-fit decreasing）：每個零件依序試已開的板，找到可放的板就放在
   「最靠上、再靠左」（或「最靠左、再靠上」）的位置；四種轉角都試，取分數最好的。
   group 當成一個整體，一起放進同一張板，放不下就整組換下一張。
   某形狀在某張板放不下就記起來（板只會越排越滿），同形零件不再重試。
4. 三種排序（面積／最長邊／外接框面積）× 兩種靠齊方向各排一次，取張數最少、
   最後一張用得最少（排到的寬×高最小）的結果。整個流程沒有亂數，同輸入同輸出。
5. 「零件放在別的零件的孔裡」預設不用（NEST_IN_HOLES='auto'）：張數比面積下限多時，
   用最好的排序／靠齊再排一次「可放進孔裡」，能少張數才採用，並在 Sheet.notes 註明
   （雷切軟體要開「先切內部」）。
6. 排完用 shapely 逐對核對真實距離與板邊，不合就直接報錯（不會靜默輸出）。
"""
from __future__ import annotations

import hashlib
import math
import re
from dataclasses import dataclass, field
from typing import Any

import numpy as np
import shapely
from scipy.signal import fftconvolve
from shapely import affinity
from shapely.geometry import MultiPolygon, Polygon
from shapely.ops import unary_union

from . import params

RES = 0.5                 # mm：佔用點陣格寬
GROW_EPS = 0.02           # mm：buffer 多邊形近似圓弧（弦在圓內）的補償
KERF_LINES_LOCK = 20      # 開放切割線 ≥ 這麼多條 → 視為彎曲條，只轉 0／180
ROT_LOCK: dict[str, tuple[int, ...]] = {}   # 指定零件可用的轉角，例如 {'#27': (0, 180)}；空＝自動判斷
NEST_IN_HOLES = 'auto'    # False：不放進別的零件的孔；True：可以；'auto'：能少張數才用
ORDERS = ('area', 'maxside', 'bbox')
GRAVITIES = ('top', 'left')
ROTS = (0, 90, 180, 270)


# ---------------------------------------------------------------------------
# 資料結構
# ---------------------------------------------------------------------------
def _affine_params(M: np.ndarray) -> list[float]:
    return [M[0, 0], M[0, 1], M[1, 0], M[1, 1], M[0, 2], M[1, 2]]
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
