kingofamani/CoinSorting/(commit log)

2026-10-02 初始提交：分幣機專案現有檔案
    - 原始雷切檔、零件編號圖、組裝完成照片
    - 專案紀錄（v1、v2）、講師前置測試步驟
    - Nano 版與 ESP32 版程式、接線圖
2026-10-02 修正 ESP32 正式程式編譯錯誤；更新專案紀錄 2026-10-02 決議
    - coin_sorter_esp32.ino 第 133 行多餘的 m 造成無法編譯
    - 紀錄：S1 改放 1 元滑道（方案 A）、公式 N1=C1、電子盒掛 #37 背面、
    光耦接 3.3V、雷切頁面 ≤255×355、SVG 實測幾何與清理清單
    Claude-Session: https://claude.ai/code/session_019BHRDYyAKgv7UCfhBVgWFo
    [coin_sorter_esp32.ino]
2026-10-02 新增 v2 雷切產生器基礎：零件拆分、組裝座標、共用參數與介面說明
    - laser_v2/catalog.py：原始 SVG 拆成 60 個編號零件（保留原始曲線），
    清理雜線、註記與 #24 斜槽內那條退化切線（實際 163.5 mm、118 mm 穿過板子）
    - laser_v2/frames.py：組裝座標 (U,V,W') 與零件頁座標互換，82 項對位驗證
    - laser_v2/params.py：模組尺寸（暫定，實量後改）、頁面 255×355、設計選擇
    - laser_v2/INTERFACE.md：子系統修改介面
    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
2026-10-02 交接：保存三份 v2 設計規格與交接說明
    - laser_v2/design/：跨軌感測座、S1 卡匣、電子盒的最終規格、模型程式與示意圖
    - 分幣機_交接_2026-10-02.md：進度、下一步、待決與待實量項目
    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
2026-10-02 交接與紀錄：記下顯示器位置、光束高 2.5 mm、修正 #26 齒孔等決定
    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
2026-10-02 還原交接檔到 c485fd2 的版本
    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
2026-10-02 交接檔改回含四項定案的版本
    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
2026-10-08 v2 雷切產生器：三個子系統、合成、排版、輸出與試切小樣
    - 新增 mods_crosstrack、mods_s1、ebox（照三份審定規格移植）
    - 新增 compose、textpath、layout、export、qa、integrate、trial、build_v2
    - 輸出 v2 草稿 SVG（合板 3 張＋壓克力 1 張）與試切小樣 SVG、laser_v2/out/ 報告
    - 依 8 個角度的驗證修正 EB-K 形狀、鎖塊塞法說明、C1 方向記號、試切穩健性等
    - 字型改用微軟正黑體（params.FONT_PATH）；.venv 與 laser_v2/_work 不進版控
    [parts.csv]
2026-10-08 v2：依 10-08 決定修改雕刻、備品、標籤與輸出，並更新文件
    - back_h 改 2.0（S1 幾何與規格名目一致）
    - 新增雕刻全部改成紅色 0.2 mm 線，和原始檔一致；代號字離切割 ≥1 mm
    - 極小零件（PIN-S50、S1-H、EB-K、S1-P）每套多排一份備品，張數不變（合板 3＋壓克力 1）
    - #24 正面不刻站名，改用排線兩端標籤；報告補認站說明
    - 分頁 SVG 不含註記層；零件內先切孔再切外框；刪長度 0 的線段
    - build_v2 先檢查 params（填錯結束碼 3）；清舊輸出只刪產生器命名的檔
    - 專案紀錄 v2 第五節、新交接檔 2026-10-08、三份規格開頭加勘誤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
    [parts.csv]
2026-10-08 新增光耦簡易測試原型（獨立資料夾，不動 v2）
    - 光耦測試原型/make_proto.py：自給自足的產生器（不 import laser_v2），輸出雷切 SVG、預覽、2D 示意圖、零件表
    - 一段滑坡（後仰 30°、軌道斜 20°）＋感測窗（留 2.3 mm 軌道條）＋9 片墊片調光束高度，3 mm 合板 190×278 mm、只用白膠
    - opto_test_esp32/：單路光耦測試程式（自動判定擋住電位、逐枚遮光時間、DEBOUNCE 建議），尚未實際編譯
    - 組裝與測試說明.md：收到模組先實量的門檻、組裝、接線、測試步驟與紀錄表
    - 模組尺寸是暫定值；交接檔更新原型狀態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
    [零件表.csv]
2026-10-12 整理資料夾：依版本分成原始機構、v1 紅外線版、v2 光耦版、光耦測試原型
    - 01_原始機構/：原始雷切檔、零件編號圖、組裝完成照片
    - 02_v1_紅外線版/：Nano 版與 ESP32 版程式、接線圖、講師前置測試步驟、v1 紀錄（已停用）
    - 03_v2_光耦版/：laser_v2 產生器、v2 草稿與試切小樣、舊交接檔
    - 04_光耦測試原型/：原本的 光耦測試原型/ 改名
    - 根目錄新增 README.md 總覽；交接檔與紀錄 v2 改成新路徑
    - catalog.SRC_SVG 改指向 01_原始機構；v2 改在 03_v2_光耦版 執行
    - 搬移後重跑：v2 所有雷切 SVG、parts.csv、PNG 與搬移前逐位元相同
    - 刪除 _work 暫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
    [parts.csv, 零件表.csv]
2026-10-12 新增 v2 光耦版 ESP32 正式程式
    - 03_v2_光耦版/coin_sorter_opto_esp32/：4 路槽型光耦（S1→G27、S5→G26、S10→G25、S50→G33）＋TM1637
    - 公式 N1=C1、N5=C5−C10、N10=C10−C50、N50=C50；C5≥C10≥C50 不成立時顯示器冒號亮
    - 中斷計數，「亮區重新上膛」REARM_US（預設 3000）防重複；單段擋住不到 0.3 ms 當雜訊
    - 每 5 ms 核對腳位，連續兩次不一致且中間沒有中斷才校正（補中斷漏掉的邊緣）
    - 開機 1.5 秒自動判定擋住電位；BOOT 鍵歸零；序列埠 v／r／a／? 指令
    - README：接線、燒錄、研習前檢查、常見狀況
    - 經 3 輪靜態審查與 Python 模擬；尚未在實機編譯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
2026-10-12 新增 v2 光耦版 ESP32 接線圖
    - 03_v2_光耦版/接線圖/：make_wiring.py 產生 SVG，版面沿用 v1 ESP32 接線圖
    - 4 個槽型光耦（S1→G27、S5→G26、S10→G25、S50→G33）各用一條 3P 線插擴展板一整欄，盒端 1×3 杜邦頭
    - 左側說明框：一個模組的接法（VCC→V、GND→G、OUT→S，腳位以實品印字為準，VCC 接 3.3V）
    - TM1637 用 4P 連排線（CLK→G14、DIO→G13）；9V 電源加線上開關；馬達電路獨立
    - PNG 3320×2320 用瀏覽器畫布渲染（轉PNG/serve.py＋render.html）
    - 程式 README 與根目錄 README 加上接線圖連結
2026-10-12 新增 v2 光耦版組裝教學網頁
    - 03_v2_光耦版/組裝教學/index.html：開始前、講師預組 A1～A11、老師組裝 B1～B23、
    通電測試、拆換、零件總表與 27 項待確認清單；步驟可勾選（記在瀏覽器）
    - make_figures.py＋steps.py：由 v2 產生器的零件幾何與 frames 座標自動畫
    零件位置圖、組裝示意圖（正視＋側視）、零件攤平圖，並複製照片、規格附圖、接線圖
    - 原機組裝順序由設計檔推得（#24 正面朝下平放疊裝），不確定處標 ★
    - README 加上組裝教學的位置
2026-10-12 更正紀錄與研習草稿：抽屜底板編號、組裝順序
    - 紀錄 v2 第二節：#32～#35 是抽屜底板不是面板；#34＝1 元（29.1）、#35＝5 元（29.6），原本寫反
    - analysis_round1.md：同上；研習草稿把 #24 放在組裝 4，原機做不到（#26、#27、軸套都靠 #24、
    端板裝上後 #24 塞不進去），補上正確的平放疊裝順序並指向組裝教學網頁
2026-10-12 研習草稿：照平放疊裝順序重排 8 小時研習時間表
    舊時間表保留；新版對應組裝教學網頁的 B／C 步驟編號，時間為估計，待試做實測。
2026-10-12 光耦測試原型：新增 ESP32 接線圖與講師組裝教學網頁
    - 接線圖/：make_wiring.py 產生 SVG（光耦 OUT→G27 的 S、VCC→V、GND→G；TM1637 選用；
    電腦 USB 供電），轉PNG/ 用瀏覽器畫成 3320×2160 PNG
    - 組裝教學/index.html：開始前（驗證什麼、先量模組、雷切、準備）、A 組滑坡、B 接線與程式、
    C 裝模組選墊片、D 測試 T1～T7 與可列印紀錄表、E 回報；步驟可勾選
    - 組裝教學/make_figures.py：讀 make_proto.py 幾何畫對位剖面、模組推入→抬起→塞墊片三格剖面，
    並切出示意圖正視／側視、複製預覽與接線圖（不改 make_proto.py 與切割檔）
    - 組裝與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
